andrewrichardr/WFR2020/ESF/Figs/lvconductor.jpg

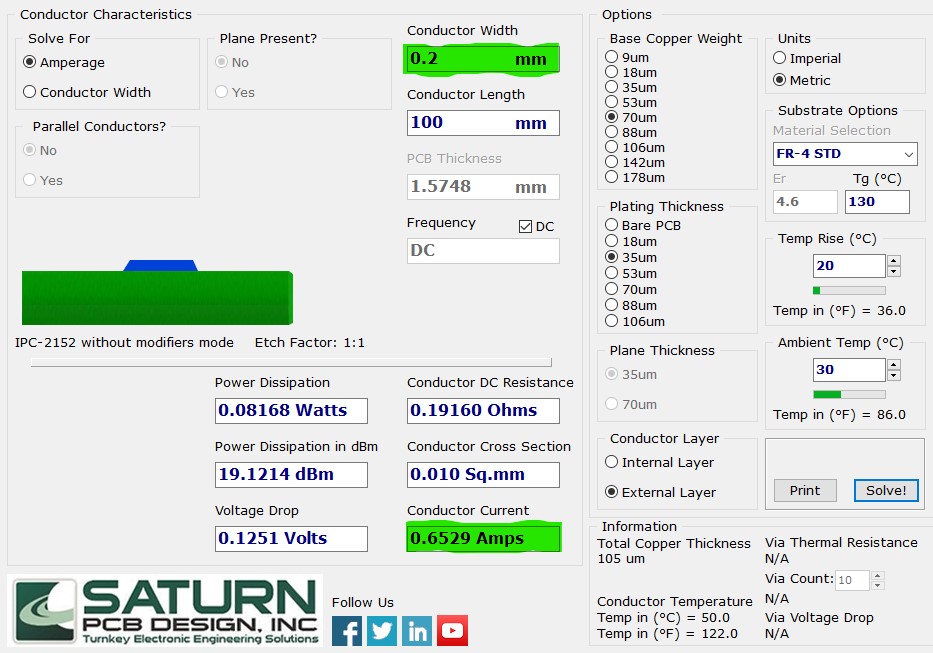
ESF/Figs/lvconductor.jpg
