andrewrichardr/WFR2020/ESF/Figs/spacingreqs.jpg

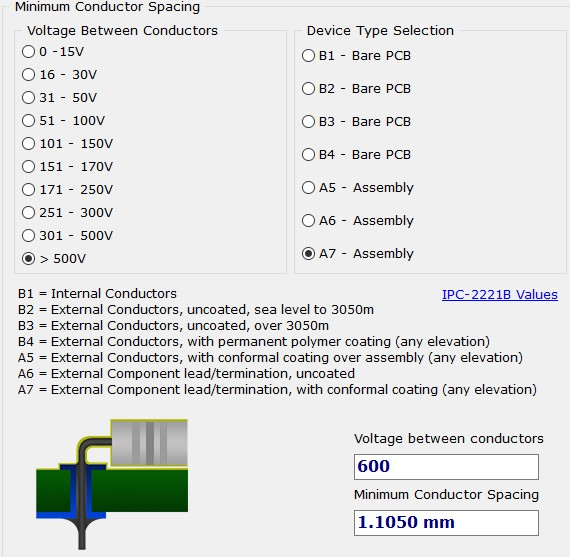
ESF/Figs/spacingreqs.jpg
