andrewrichardr/WFR2020/2019/ESF_Comments.docx

ESF Comments

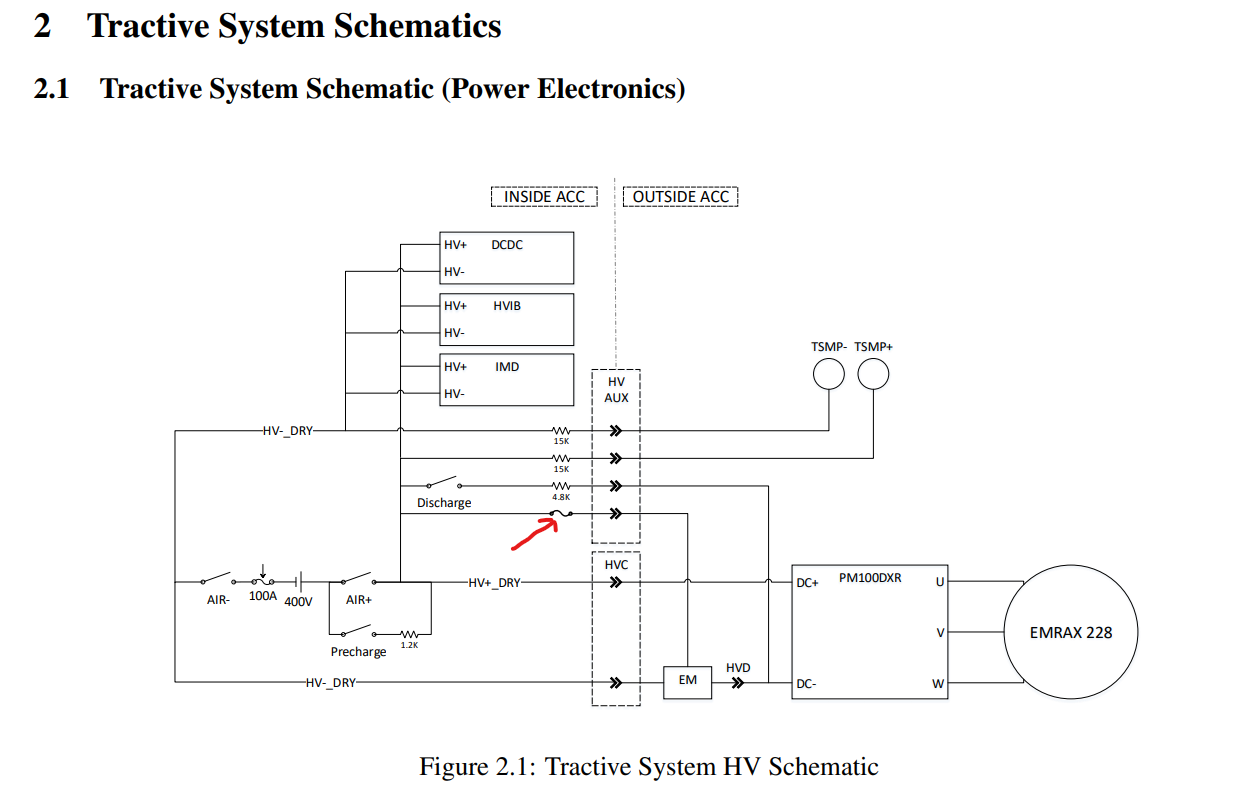
[picture p3: figure]

No rating on this fuse

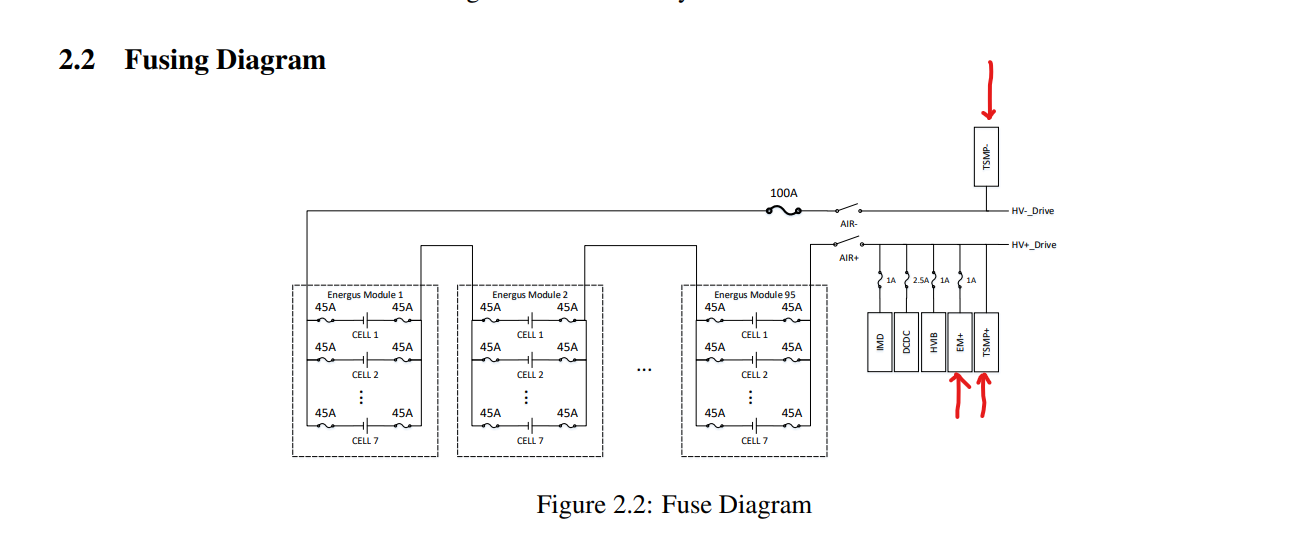
[picture p4: figure]

These are outside of the accumulator, not inside. Would be good to distinguish.

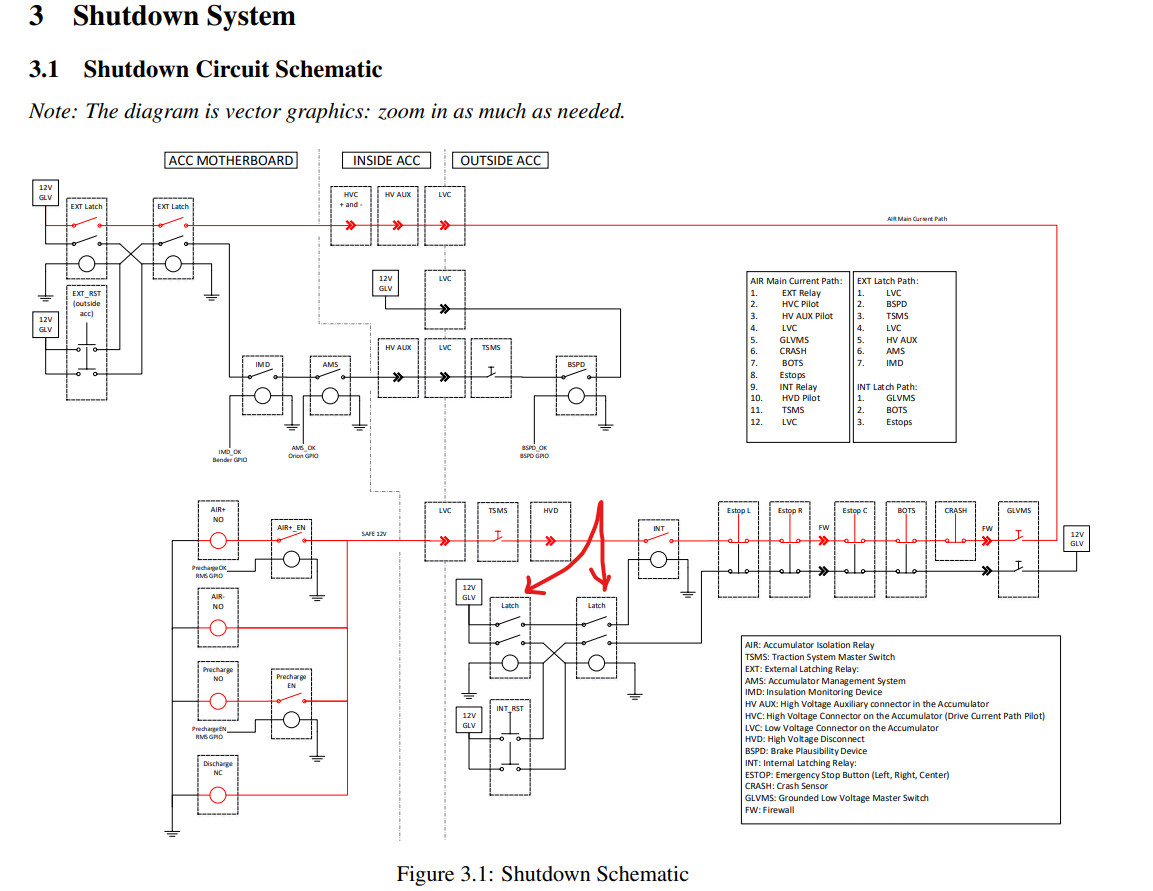
[picture p5: figure]

Maybe call this INT latch instead of just latch

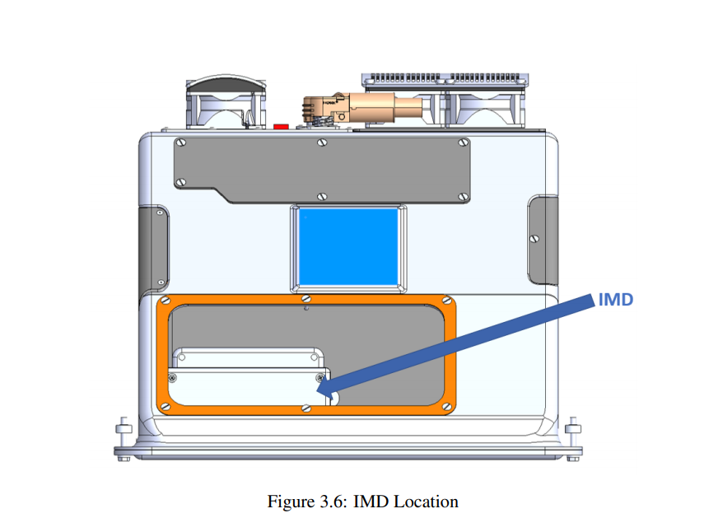
[picture p6: figure]

I thought the IMD was on the motherboard now?
