andrewrichardr/WFR2020/ACC-MB/APPS.pdf

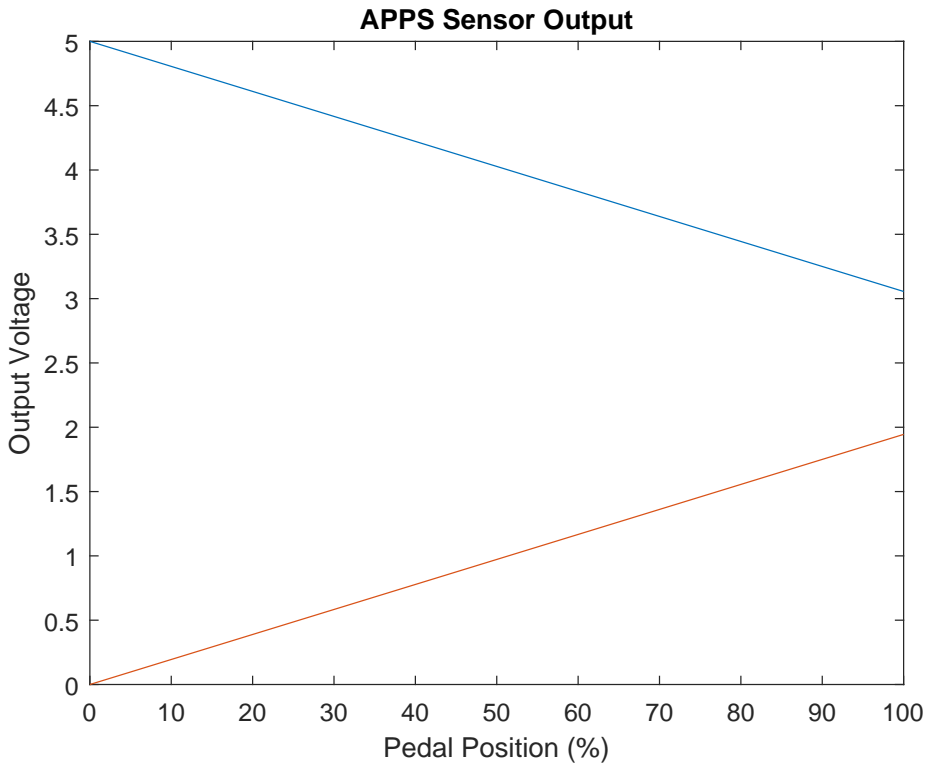
[picture p7: figure]
Pedal Position (%); Output Voltage; APPS Sensor Output
