andrewrichardr/WFR2020/ACC-MB/SystemBlockDiagram.pdf

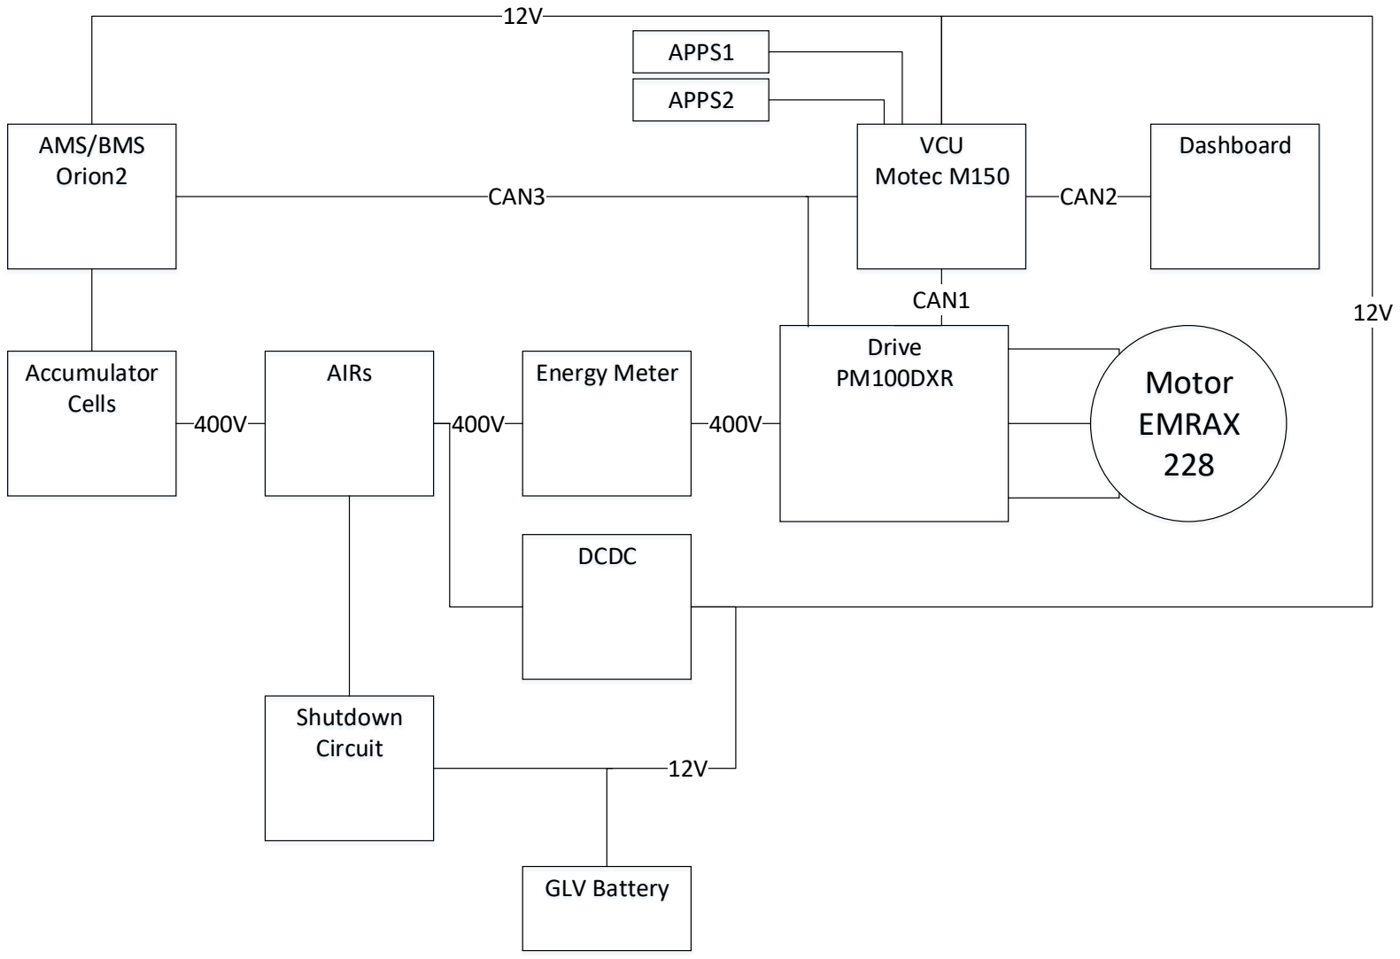
[picture p8: page 1]

Drive
PM100DXR | Motor

## EMRAX

228

Energy Meter

400V

AIRs

400V

Accumulator
Cells
400V

DCDC

Shutdown
Circuit

GLV Battery

12V

AMS/BMS
Orion2

VCU
Motec M150

CAN1

CAN3

12V

12V

Dashboard

CAN2

APPS1

APPS2
