andrewrichardr/WFR2020/ACC-MB/TorqueSecurity.pdf

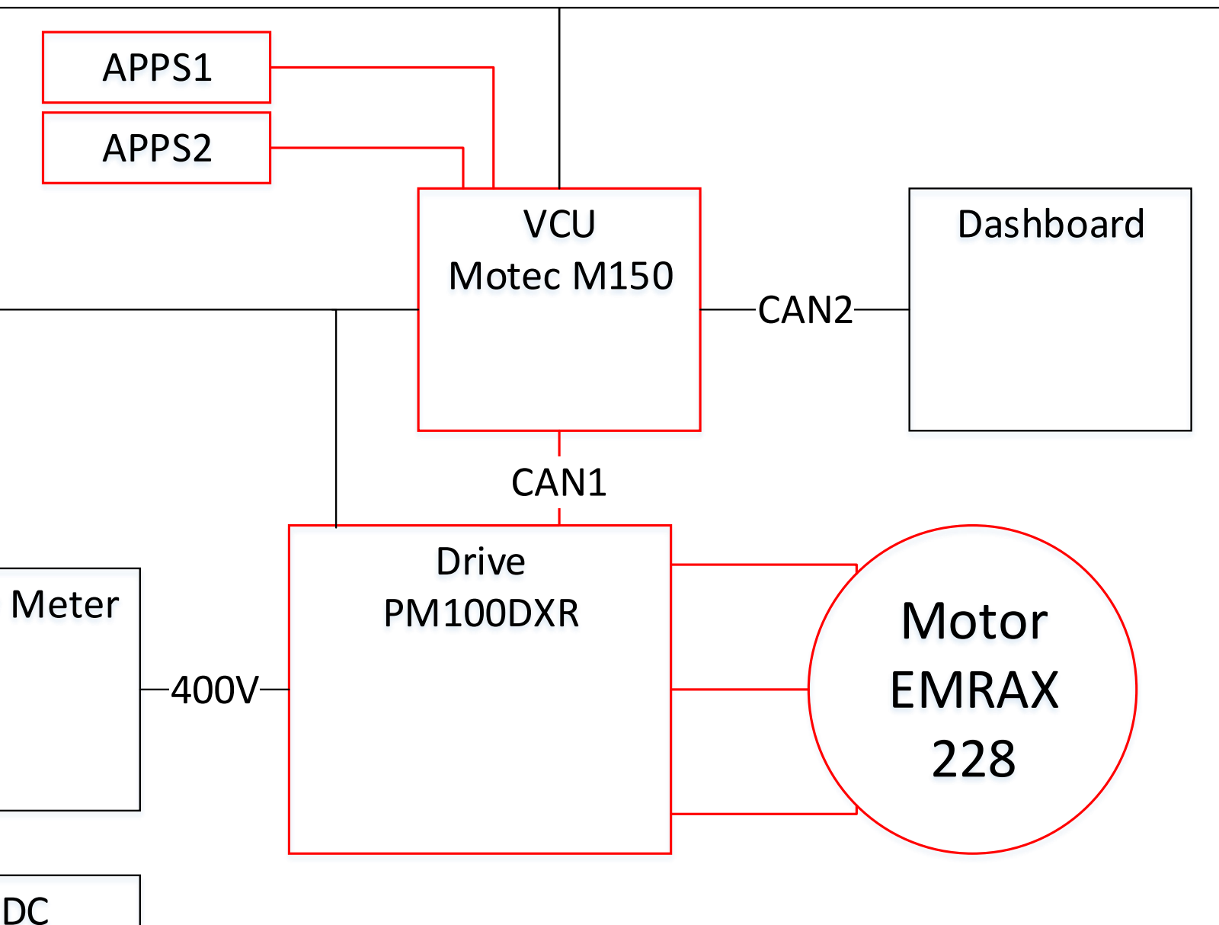
[picture p9: page 1]

Drive
PM100DXR | Motor

## EMRAX

228

Energy Meter

400V

DCDC

VCU
Motec M150

CAN1

Dashboard

CAN2

APPS1

APPS2
