andrewrichardr/WFR2020/ACC-MB/hvconductor.pdf

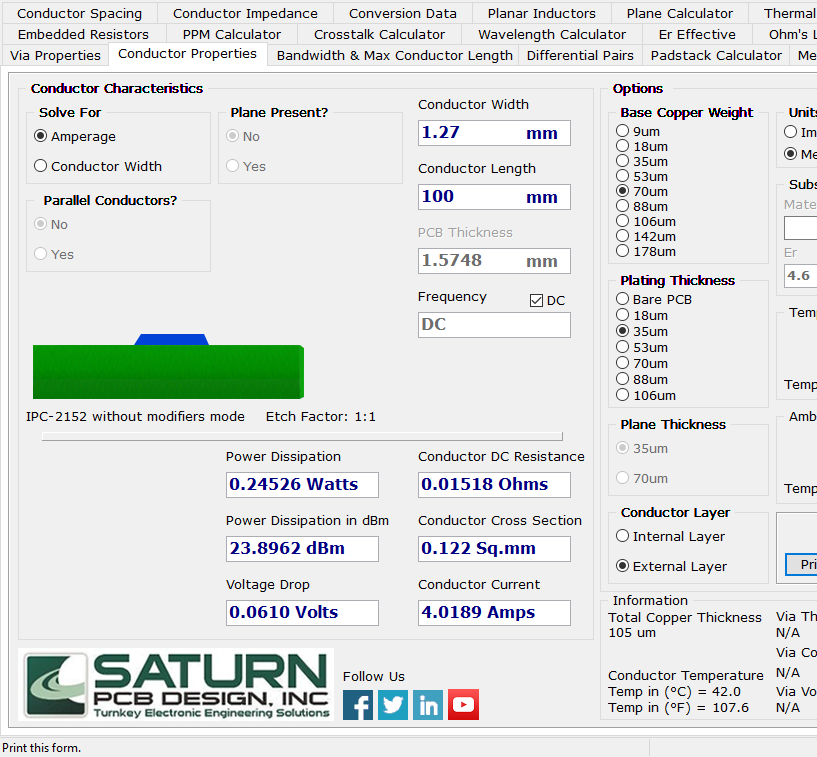
[picture p10: page 1]
