andrewrichardr/WFR2020/ACC-MB/APPS.png

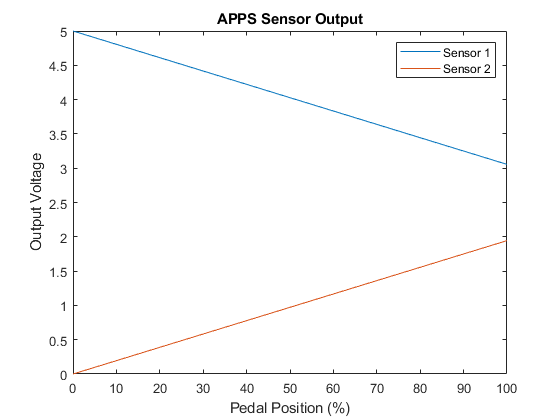
ACC-MB/APPS.png
