andrewrichardr/WFR2020/ACC-MB/Rev4/MainBoard/Main_2019-12-13_Combined_Bottom.png

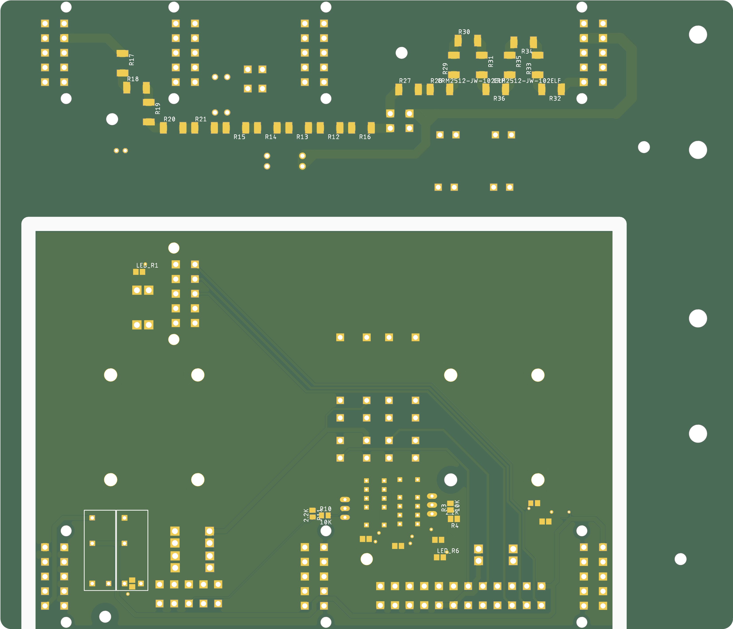
ACC-MB/Rev4/MainBoard/Main_2019-12-13_Combined_Bottom.png
