andrewrichardr/WFR2020/allPCBsettings.jpg

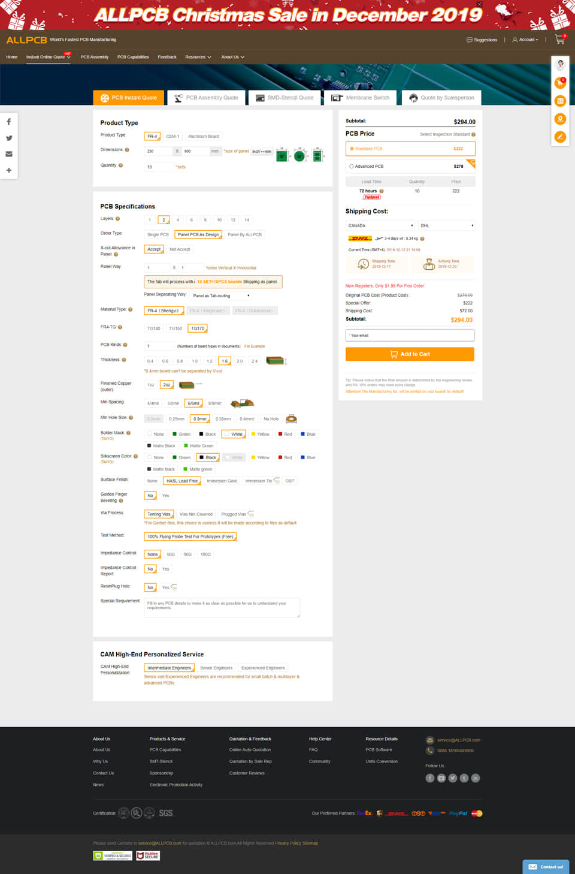
allPCBsettings.jpg
