andrewrichardr/WFR2020/ESF/Figs/accumcad.jpg

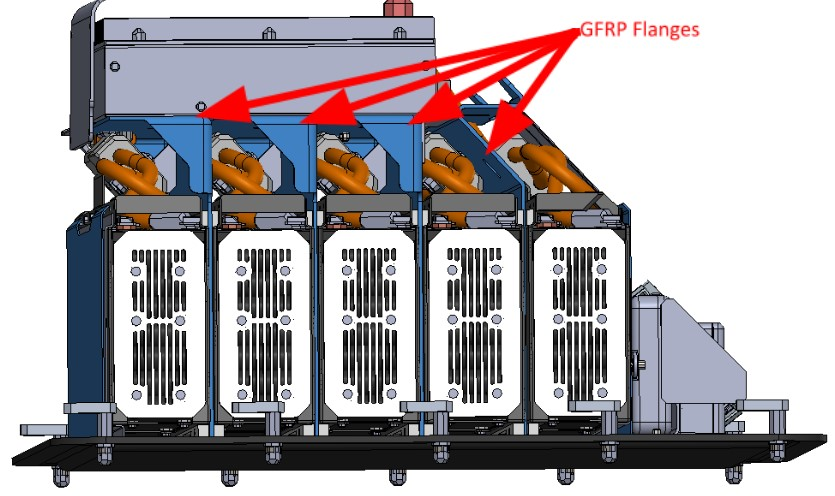
ESF/Figs/accumcad.jpg
