andrewrichardr/WFR2020/ESF/Figs/Annotation 2019-12-02 203314.jpg

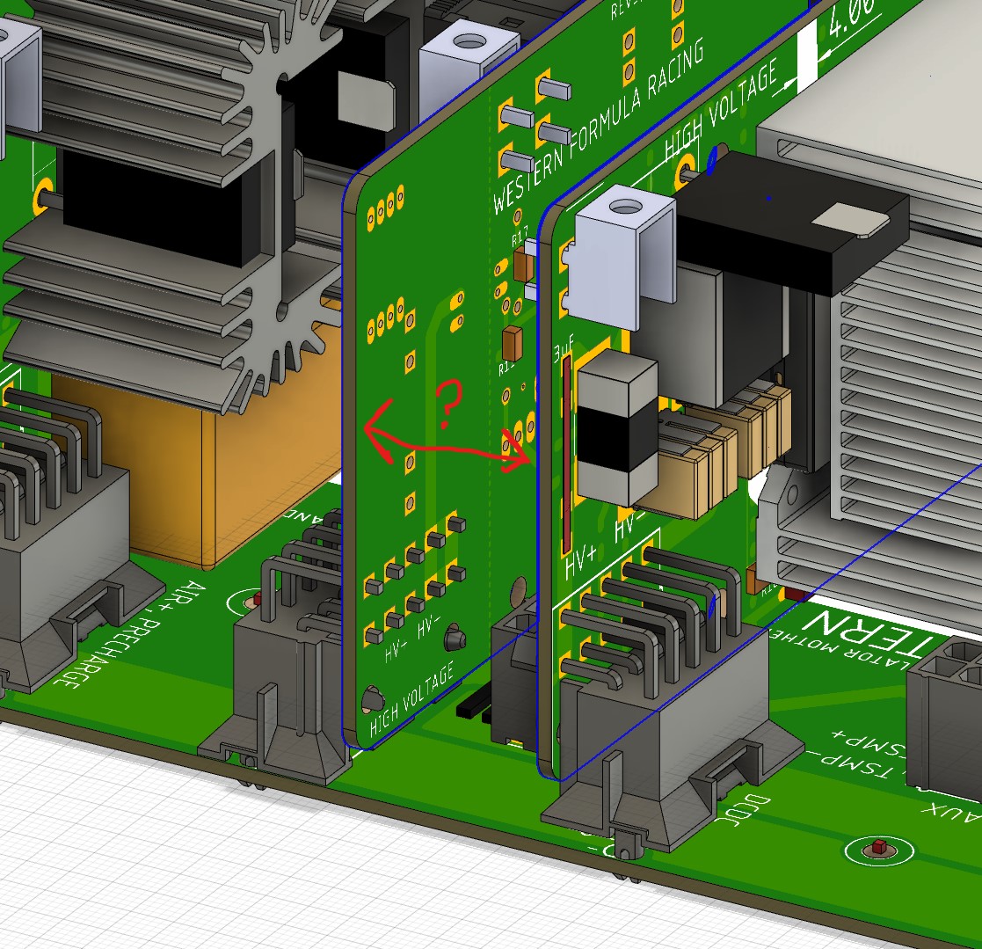
ESF/Figs/Annotation 2019-12-02 203314.jpg
