andrewrichardr/WFR2020/ESF/Figs/appsoutput.jpg

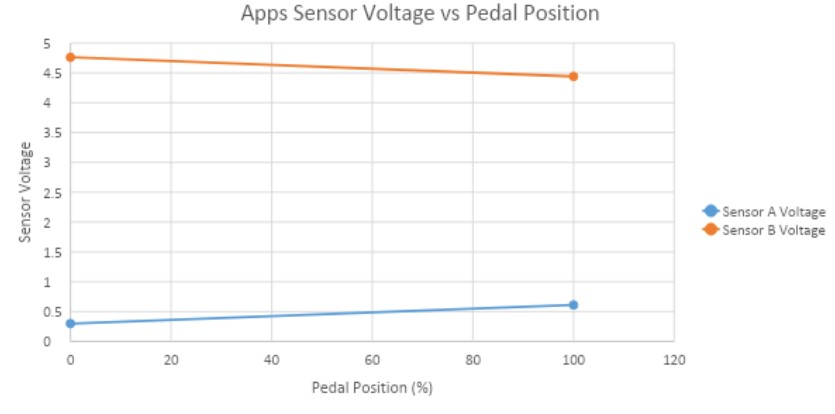
ESF/Figs/appsoutput.jpg
