andrewrichardr/WFR2020/ESF/Figs/blowtimevscurrent.jpg

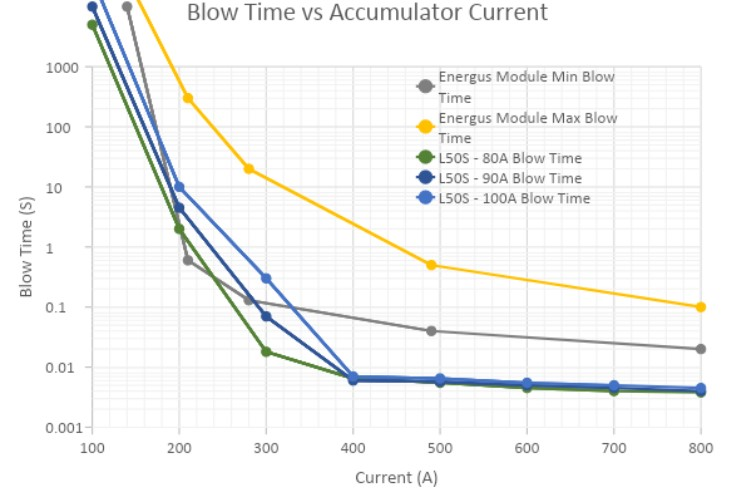
ESF/Figs/blowtimevscurrent.jpg
