andrewrichardr/WFR2020/ESF/Figs/cellconnections.jpg

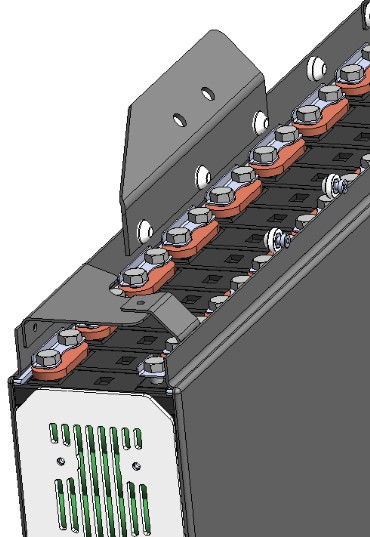
ESF/Figs/cellconnections.jpg
