andrewrichardr/WFR2020/ESF/Figs/cellmounting.jpg

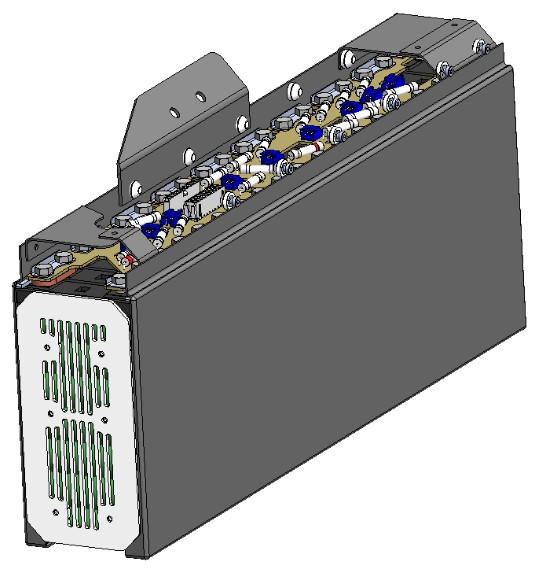
ESF/Figs/cellmounting.jpg
