andrewrichardr/WFR2020/ESF/Figs/dischargecap.jpg

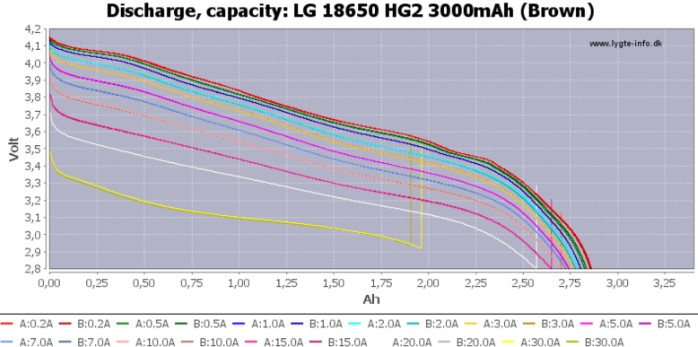
ESF/Figs/dischargecap.jpg
