andrewrichardr/WFR2020/ESF/Figs/DischargeI.jpg

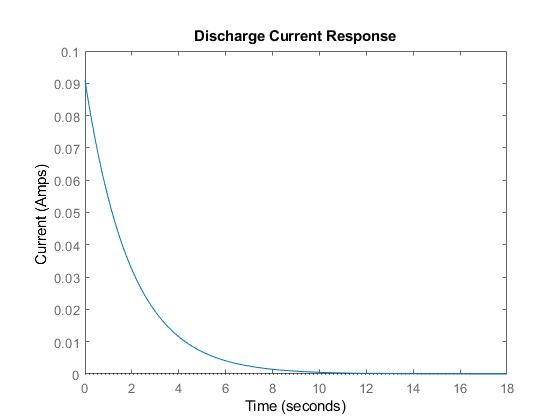
ESF/Figs/DischargeI.jpg
