andrewrichardr/WFR2020/ESF/Figs/EnergusFuse.jpg

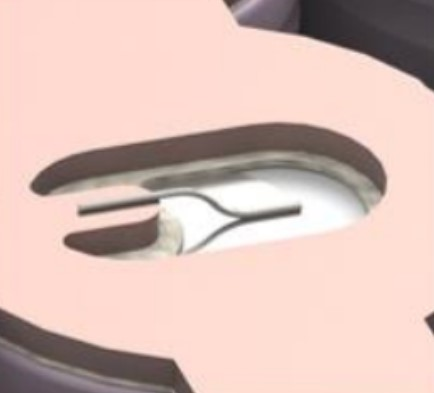
ESF/Figs/EnergusFuse.jpg
