andrewrichardr/WFR2020/ESF/Figs/firewall.jpg

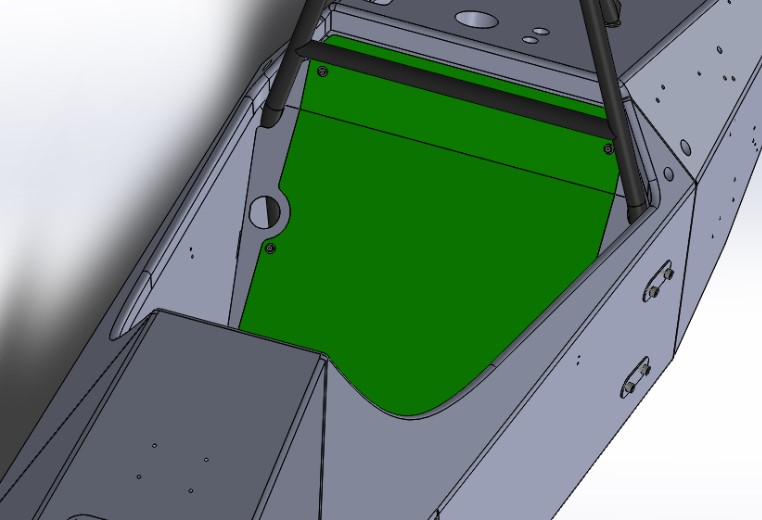
ESF/Figs/firewall.jpg
