andrewrichardr/WFR2020/ESF/Figs/fuseblowtime.jpg

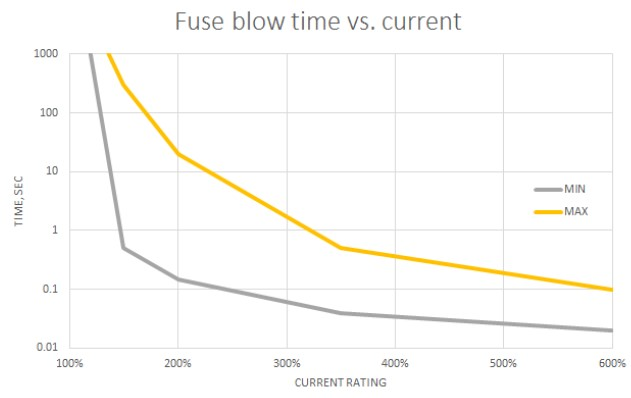
ESF/Figs/fuseblowtime.jpg
