andrewrichardr/WFR2020/ESF/Figs/FuseTreeDaigram.png

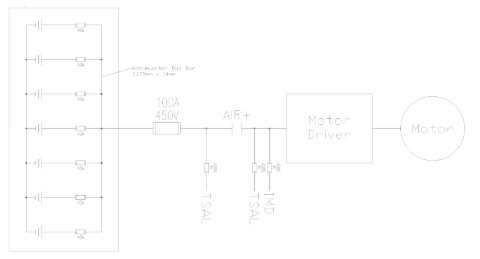
ESF/Figs/FuseTreeDaigram.png
