andrewrichardr/WFR2020/ESF/Figs/HVSystemSchematic.png

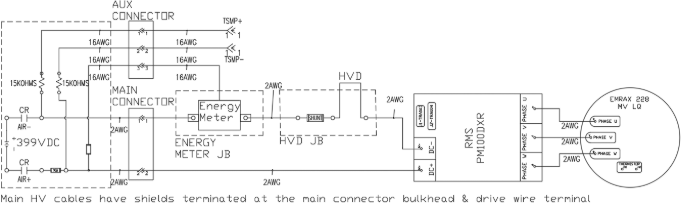
ESF/Figs/HVSystemSchematic.png
