andrewrichardr/WFR2020/ESF/Figs/imdlocation.jpg

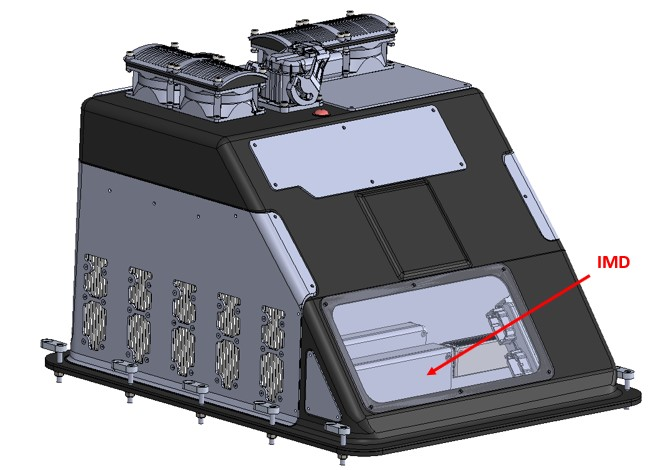
ESF/Figs/imdlocation.jpg
