andrewrichardr/WFR2020/ESF/Figs/LatchSchematic.png

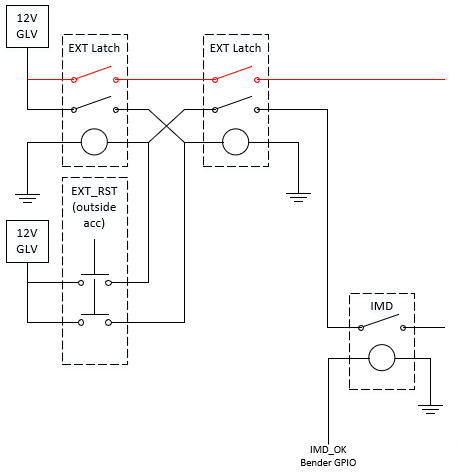
ESF/Figs/LatchSchematic.png
