andrewrichardr/WFR2020/ESF/Figs/mobo.PNG

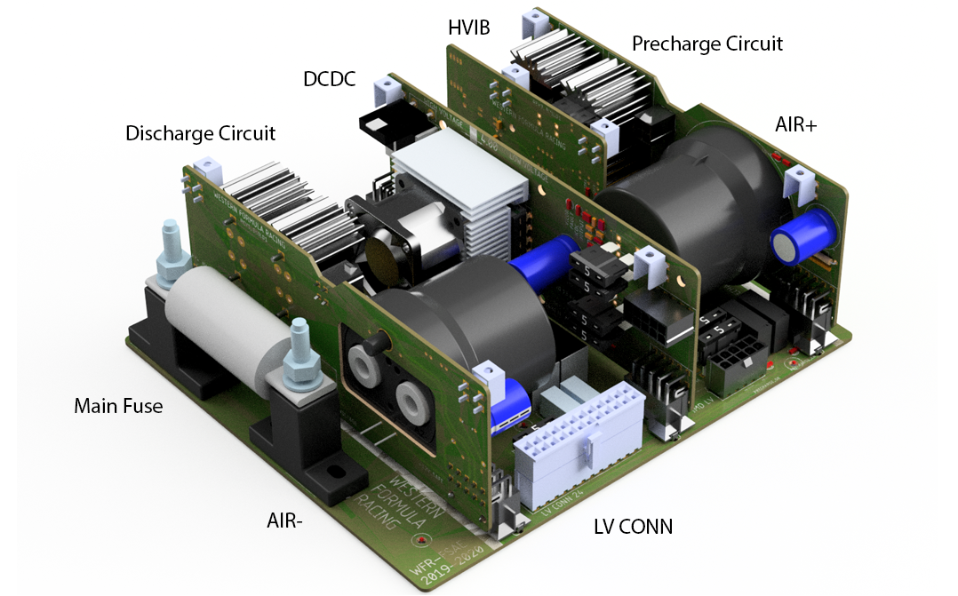
ESF/Figs/mobo.PNG
