andrewrichardr/WFR2020/ESF/Figs/mp.jpg

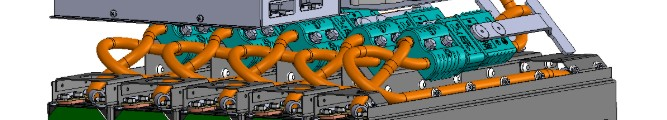
ESF/Figs/mp.jpg
