andrewrichardr/WFR2020/ESF/Figs/mpcad.jpg

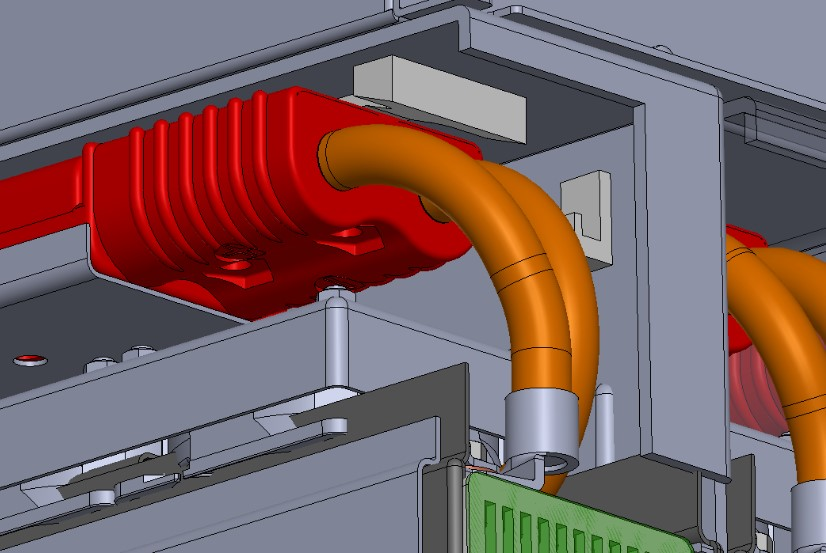
ESF/Figs/mpcad.jpg
