andrewrichardr/WFR2020/ESF/Figs/PrechargeV.jpg

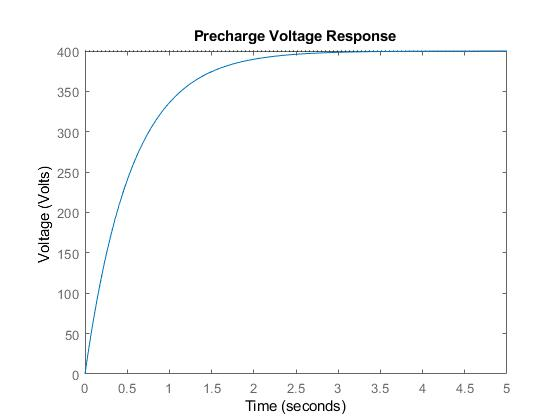
ESF/Figs/PrechargeV.jpg
