andrewrichardr/WFR2020/ESF/Figs/SAE.jpg

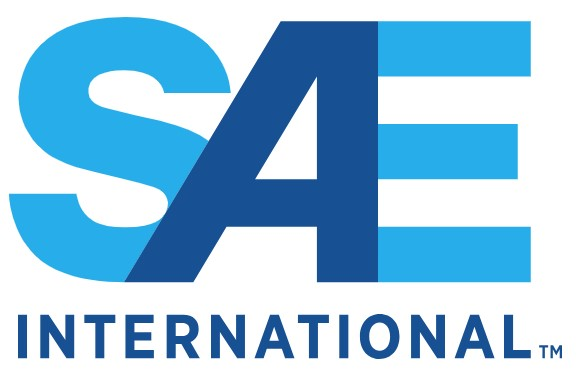
ESF/Figs/SAE.jpg
