andrewrichardr/WFR2020/ESF/Figs/senseleads.jpg

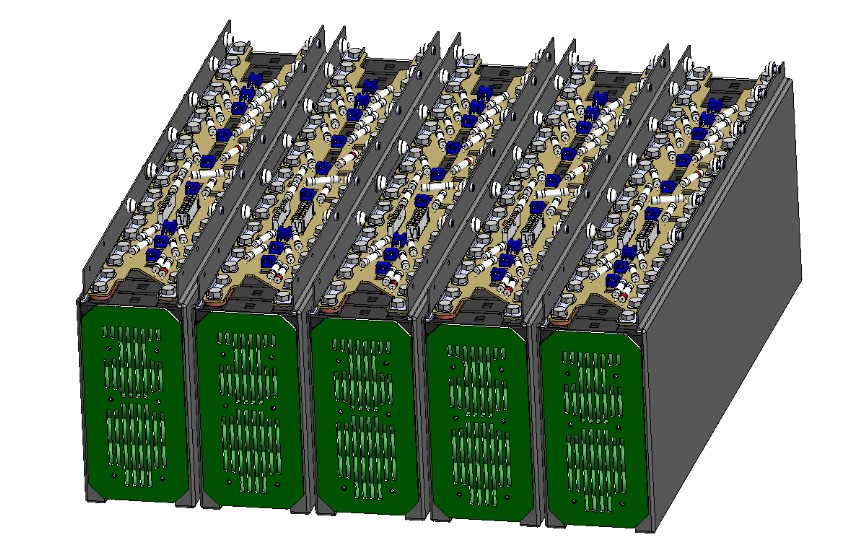
ESF/Figs/senseleads.jpg
