andrewrichardr/WFR2020/ESF/Figs/SwitchLocations.png

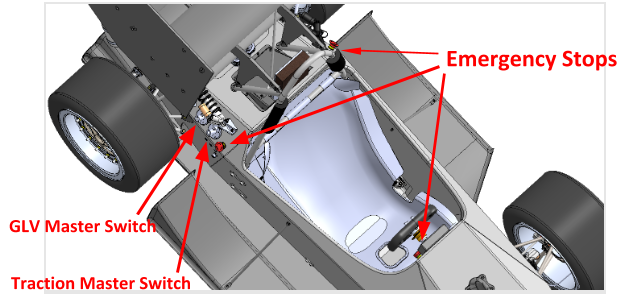
ESF/Figs/SwitchLocations.png
