andrewrichardr/WFR2020/ESF/Figs/SystemBlockDiagram.png

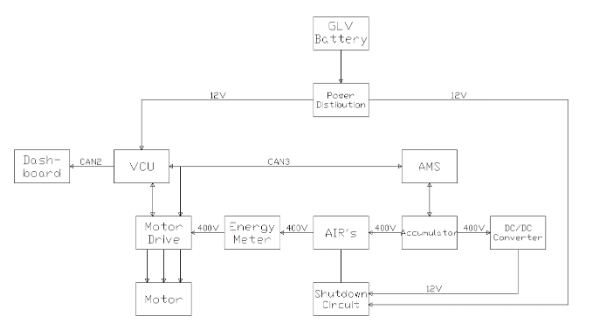
ESF/Figs/SystemBlockDiagram.png
