andrewrichardr/WFR2020/ESF/Figs/tempsensoroutput.jpg

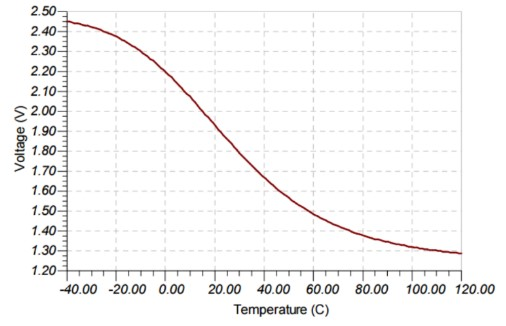
ESF/Figs/tempsensoroutput.jpg
