andrewrichardr/WFR2020/ESF/Figs/tempsensors.jpg

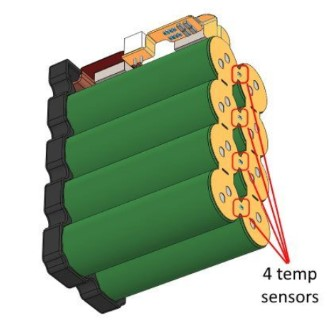
ESF/Figs/tempsensors.jpg
