andrewrichardr/WFR2020/ESF/Figs/tempsensorsch.jpg

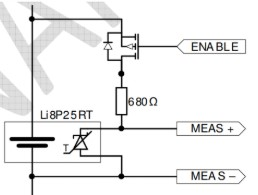
ESF/Figs/tempsensorsch.jpg
