andrewrichardr/WFR2020/ESF/Figs/TSMP.jpg

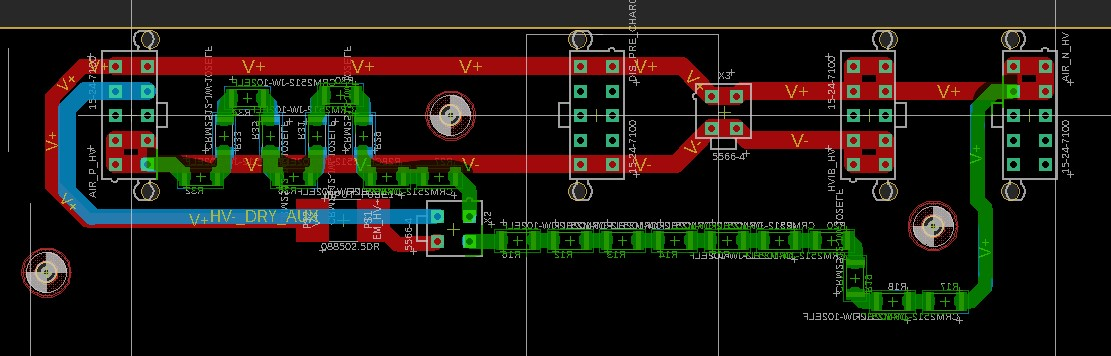
ESF/Figs/TSMP.jpg
