andrewrichardr/WFR2020/ESF/Figs/tsmploc.jpg

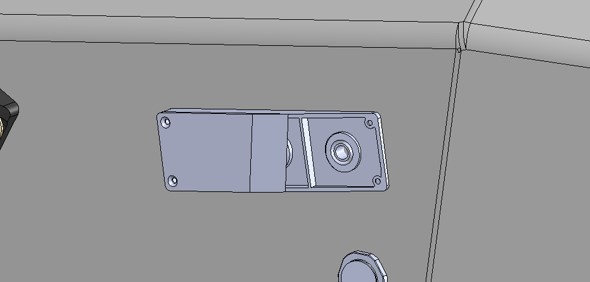
ESF/Figs/tsmploc.jpg
