andrewrichardr/WFR2020/ESF/Figs/untitled.147.png

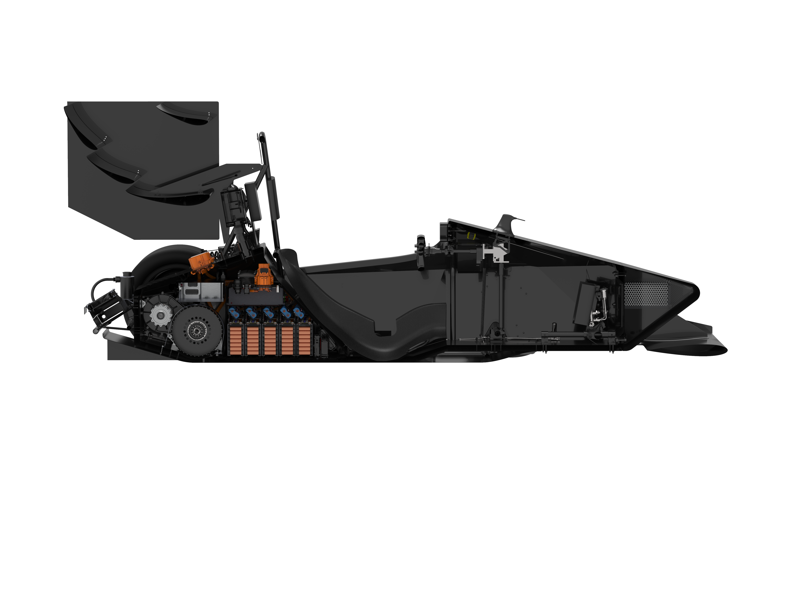
ESF/Figs/untitled.147.png
