andrewrichardr/WFR2020/ESF/Figs/voltagetaps.jpg

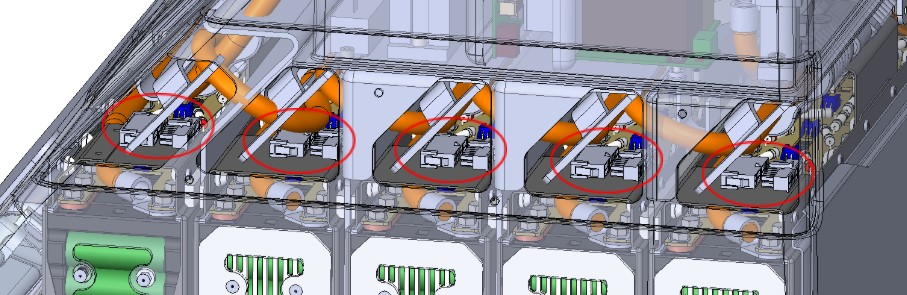
ESF/Figs/voltagetaps.jpg
