andrewrichardr/WFR2020/ESF/Figs/wideFOVfront2.jpg

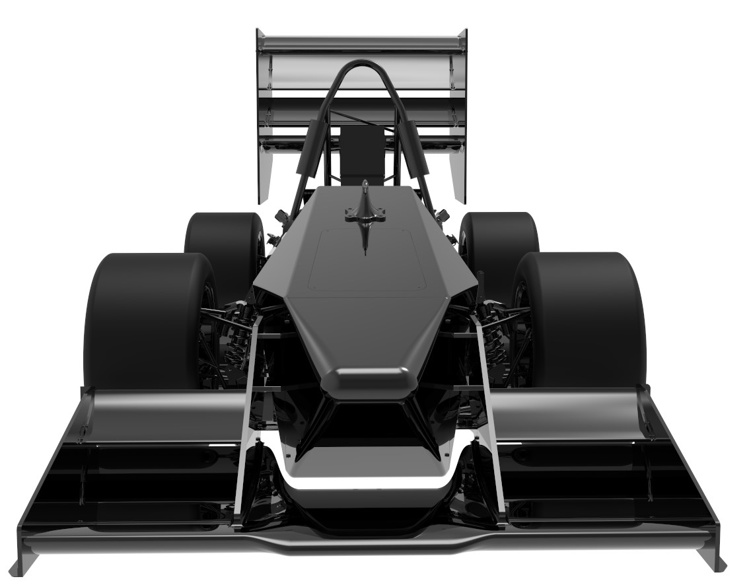
ESF/Figs/wideFOVfront2.jpg
