andrewrichardr/WFR2020/GerberTools_2019_9_20/QuickRender/00 Outlines before carve.png

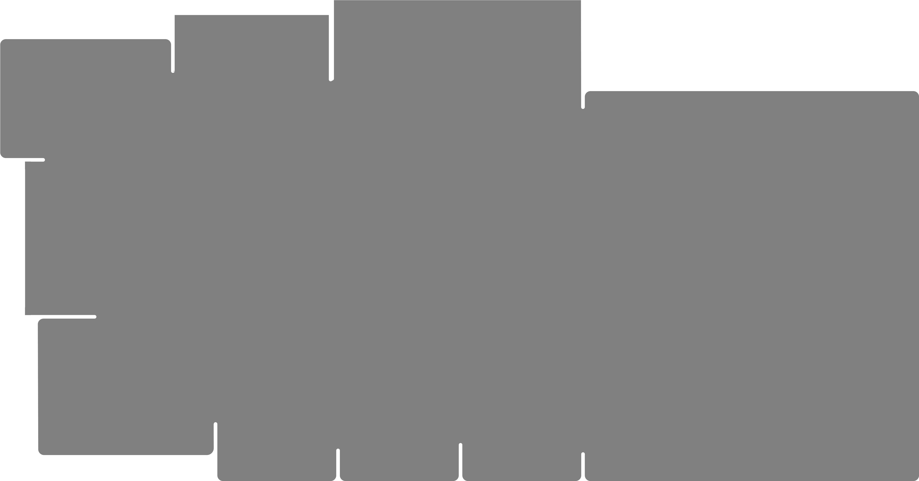
GerberTools_2019_9_20/QuickRender/00 Outlines before carve.png
