andrewrichardr/WFR2020/GerberTools_2019_9_20/QuickRender/11 outlines_redimages.png

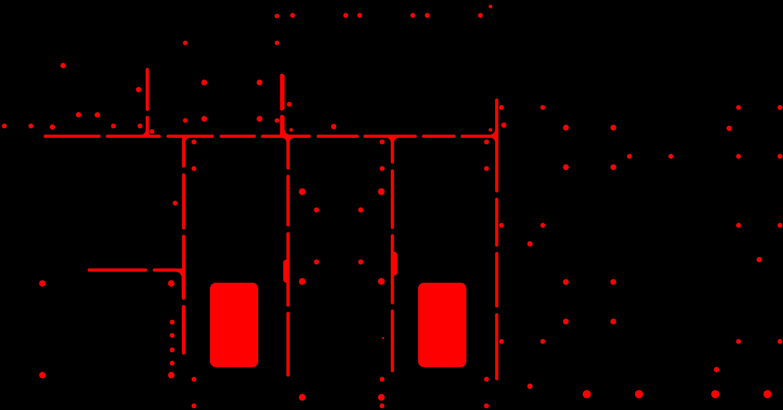
GerberTools_2019_9_20/QuickRender/11 outlines_redimages.png
