andrewrichardr/WFR2020/GerberTools_2019_9_20/QuickRender/22 outlines_carved.png

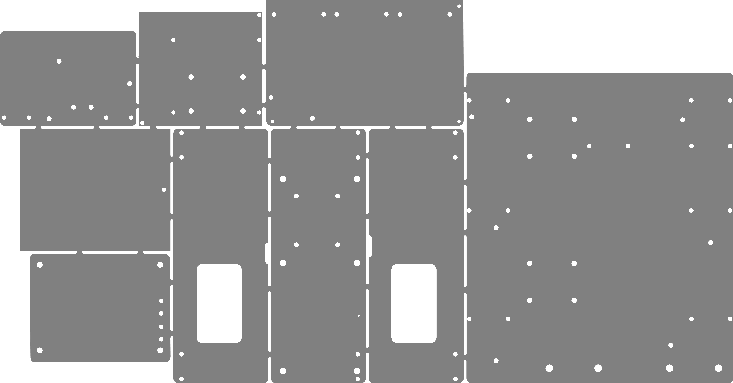
GerberTools_2019_9_20/QuickRender/22 outlines_carved.png
