andrewrichardr/WFR2020/GerberTools_2019_9_20/QuickRender/44 outlines_4afterinside.png

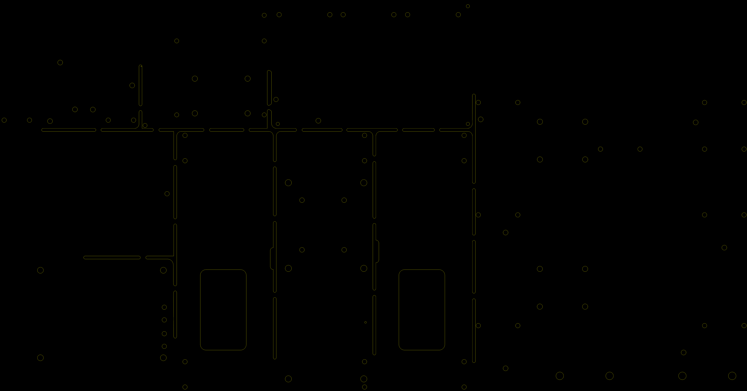
GerberTools_2019_9_20/QuickRender/44 outlines_4afterinside.png
