andrewrichardr/WFR2020/GerberTools_2019_9_20/QuickRender/Bottom_drill.png

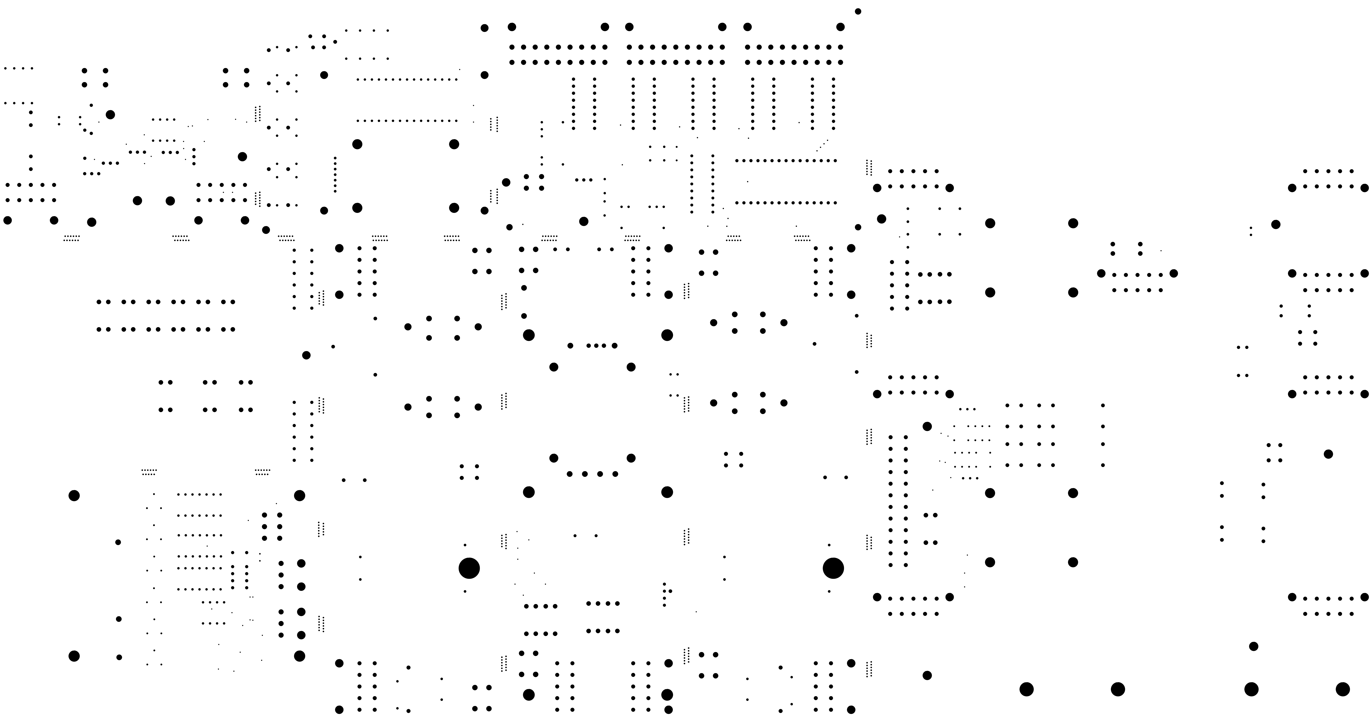
GerberTools_2019_9_20/QuickRender/Bottom_drill.png
