andrewrichardr/WFR2020/GerberTools_2019_9_20/QuickRender/FinalAfterCopper.png

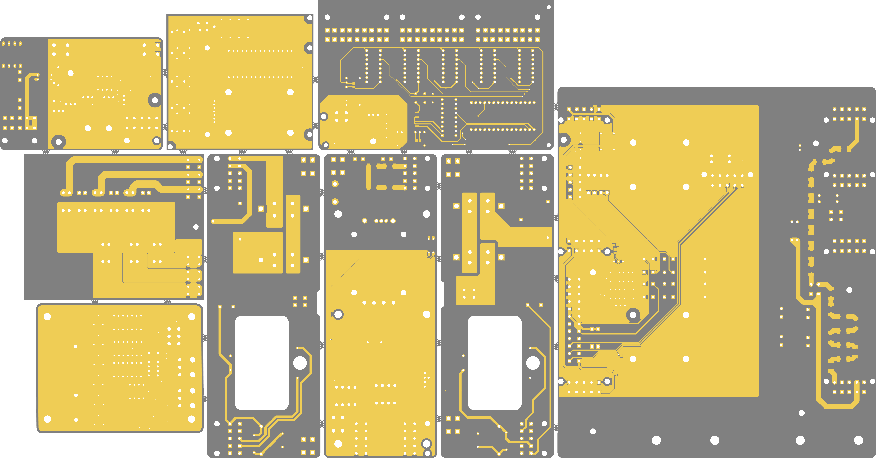
GerberTools_2019_9_20/QuickRender/FinalAfterCopper.png
