andrewrichardr/WFR2020/GerberTools_2019_9_20/QuickRender/Top_base.png

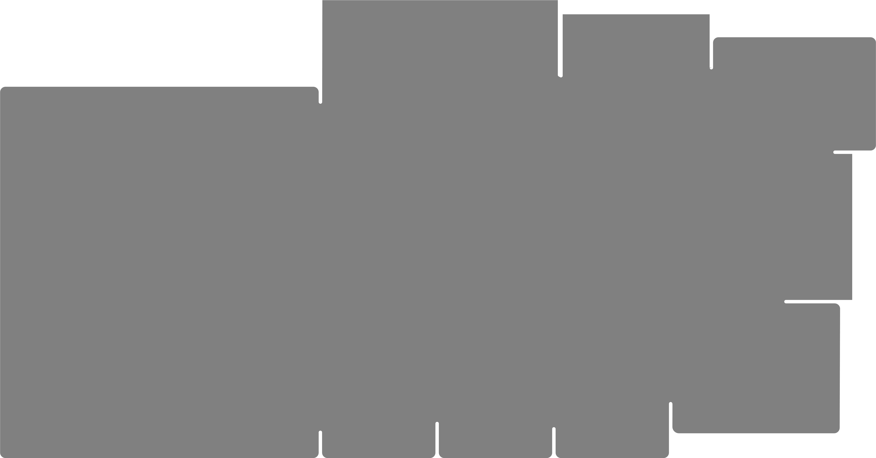
GerberTools_2019_9_20/QuickRender/Top_base.png
