andrewrichardr/WFR2020/PanelA/Panel1_Combined_Bottom.png

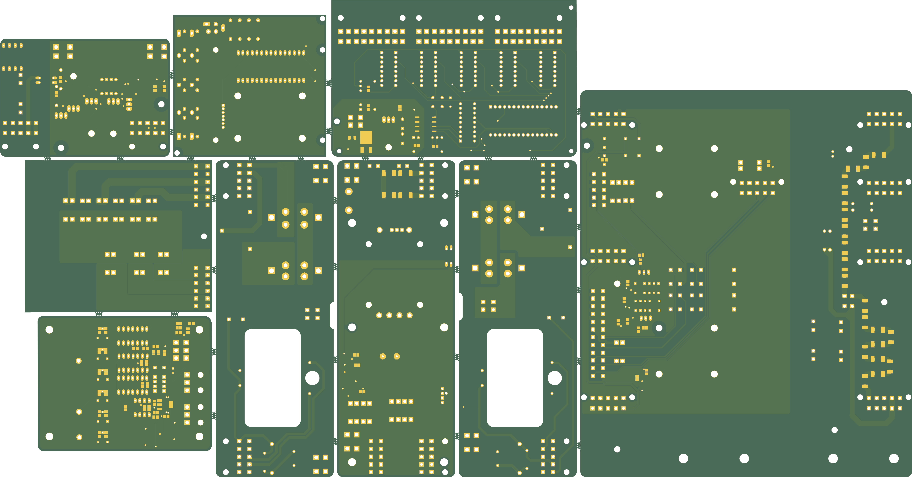
PanelA/Panel1_Combined_Bottom.png
