andrewrichardr/WFR2020/PanelA/Panel1_Combined_Top.png

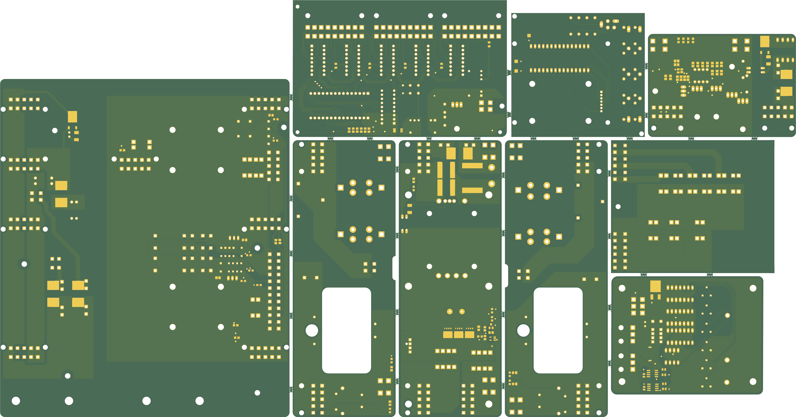
PanelA/Panel1_Combined_Top.png
