andrewrichardr/WFR2020/PanelB/Untitled_Combined_Bottom.png

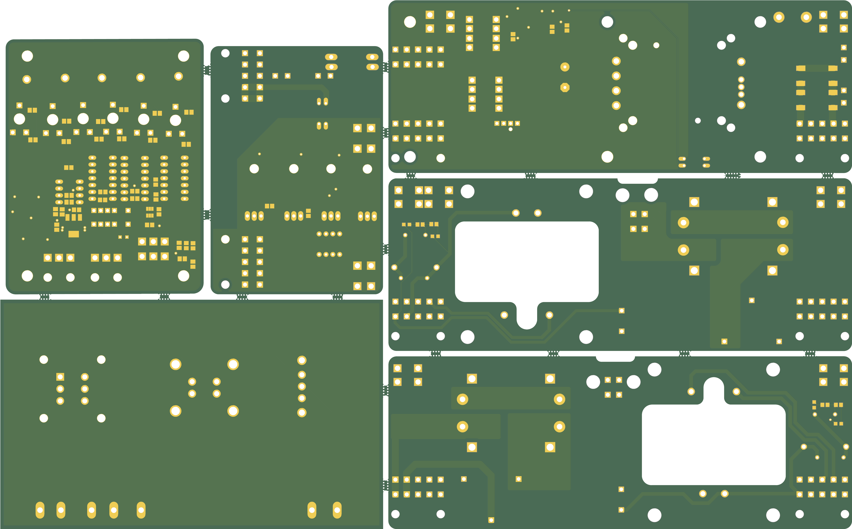
PanelB/Untitled_Combined_Bottom.png
