andrewrichardr/WFR2020/PanelB/Untitled_Combined_Top.png

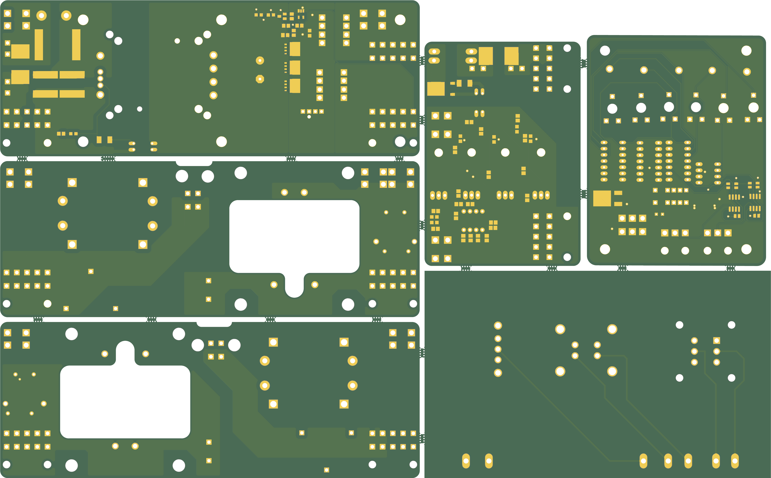
PanelB/Untitled_Combined_Top.png
