andrewrichardr/WFR2020/WFR2020-Panel1/PanelA.png_Combined_Top.png

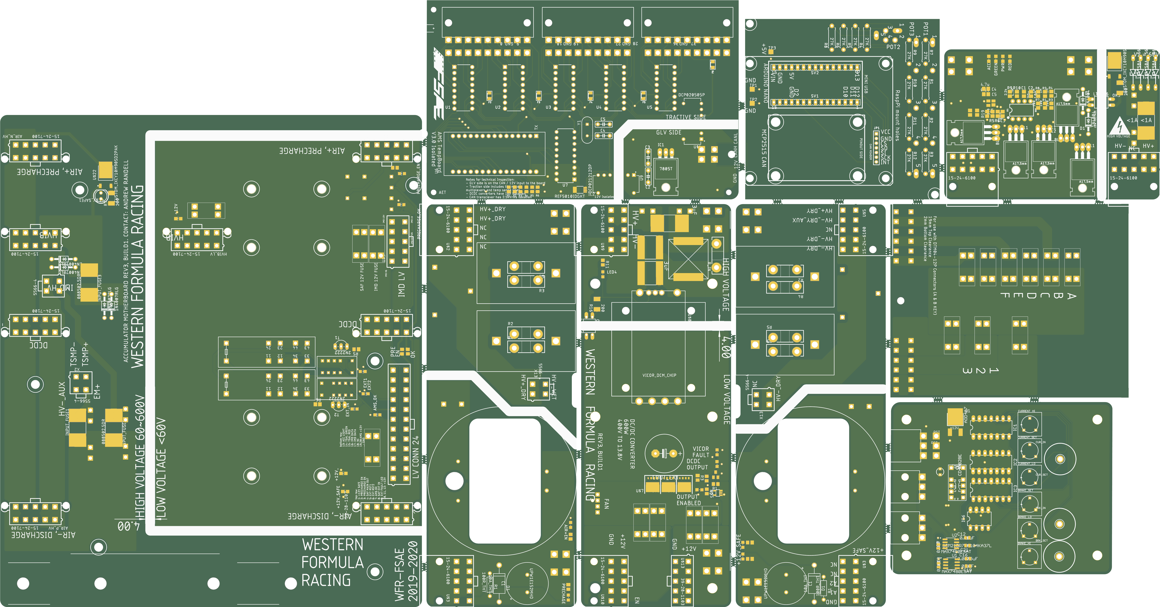
WFR2020-Panel1/PanelA.png_Combined_Top.png
