andrewrichardr/WFR2020/ACC-MB/Rev4/BOM.xlsx

DCDCDC
 | MPN | Manufacturer | Part | Value | Device | Package | Description | MF | MPN | OC_FARNELL | OC_NEWARK | POPULARITY | SPICEPREFIX
 | B58035U5305M062 | EPCOS | CFILTER_1 | 3uF | B58035U5305M062 | CERALINK_FA3
 | B58035U5305M062 | EPCOS | CFILTER_2 | 3uF | B58035U5305M062 | CERALINK_FA3
 | EGPD250ELL472ML25H | United Chemi-con | COUT_EXT | EGPD250ELL472ML25H | CPOL-USE7.5-16 | E7,5-16 | POLARIZED CAPACITOR, American symbol
 | 088502.5DR | Littlefuse | INPUT_FUSE | 2.5A | _CUSTOM_PARTS_LF_885 | _CUSTOM_PARTS_LF_885
 | 088502.5DR | Littlefuse | INPUT_FUSE1 | 2.5A | _CUSTOM_PARTS_LF_885 | _CUSTOM_PARTS_LF_885
 |  |  | LED1 |  | LED3MM | LED3MM | LED
 |  |  | LED2 |  | LED3MM | LED3MM | LED
 |  |  | LED3 |  | LED3MM | LED3MM | LED
 | LTV816 | Lite-On Inc. | OK3 | LTV816 | LTV816 | DIL04 | OPTO COUPLER |  |  | unknown | unknown | 3
 | SRP1770TA-390M | Bourns | P1330-102H | 39uH | SRP1770TA-390M | L_1510_NONSTANDARD
 |  |  | R1 |  | R-EU_R0805 | R0805 | RESISTOR, European symbol |  |  |  |  |  | R
 |  |  | R2 |  | R-US_R0805 | R0805 | RESISTOR, American symbol |  |  |  |  |  | R
 |  |  | R3 |  | R-US_R0805 | R0805 | RESISTOR, American symbol |  |  |  |  |  | R
 |  |  | R4 |  | R-US_R0805 | R0805 | RESISTOR, American symbol |  |  |  |  |  | R
 |  |  | R5 |  | R-US_R0805 | R0805 | RESISTOR, American symbol |  |  |  |  |  | R
 |  |  | R6 |  | R-US_R0805 | R0805 | RESISTOR, American symbol |  |  |  |  |  | R
 |  |  | R8 |  | R-US_R0805 | R0805 | RESISTOR, American symbol |  |  |  |  |  | R
 |  |  | R16 | 200 | R-US_R2010 | R2010 | RESISTOR, American symbol |  |  |  |  |  | R
 | PF2472-1RF1 | Riedon | R_IN | PF2472-1RF1 | RMG100-V | TO-247-2V | TO-247 Power Resistor - RMG 100 Series |  |  | unknown | unknown
 | 3568 | Keystone Electronics | U$1 | 3568FUSEHOLDER | 3568FUSEHOLDER | 3568 | 3568 20AMP 500VAC
 | 3568 | Keystone Electronics | U$2 | 3568FUSEHOLDER | 3568FUSEHOLDER | 3568 | 3568 20AMP 500VAC
 | SQJ407EP-T1_GE3 | Vishay | U$3 | _CUSTOM_111_CUSTOM_SQJ407EP-T1_GE3 | _CUSTOM_111_CUSTOM_SQJ407EP-T1_GE3 | _CUSTOM_111_CUSTOM_TRANS_SIRA90DP-T1-GE3
 | RK7002BMT116 | RHOM | U$4 | RK7002BMT116 | RK7002BMT116 | SOT23
 | UCC27511AQDBVRQ1 | Texas Instruments | U$5 | UCC27511AQDBVRQ1 | UCC27511AQDBVRQ1 | SOT23-5L
 | SQJ407EP-T1_GE3 | Vishay | U$6 | _CUSTOM_111_CUSTOM_SQJ407EP-T1_GE3 | _CUSTOM_111_CUSTOM_SQJ407EP-T1_GE3 | _CUSTOM_111_CUSTOM_TRANS_SIRA90DP-T1-GE3
 | SQJ407EP-T1_GE3 | Vishay | U$7 | _CUSTOM_111_CUSTOM_SQJ407EP-T1_GE3 | _CUSTOM_111_CUSTOM_SQJ407EP-T1_GE3 | _CUSTOM_111_CUSTOM_TRANS_SIRA90DP-T1-GE3
 | DCM290P138T600A40 | Vicor | U$8 | VICOR_DCM_CHIP | VICOR_DCM_CHIP | VICOR_CHIP_HEATSINK
 | 15-24-6100 | Molex | U$9 | 15-24-6100 | 15-24-6100 | 15-24-6100
 | 15-24-6100 | Molex | U$10 | 15-24-6100 | 15-24-6100 | 15-24-6100
 | BENDER_IRR155 | Bender | U$11 | BENDER_IRR155 | BENDER_IRR155 | BENDER_IRR155
 | FVTS10R1E15K00JE | Vishay Huntington | U$12 | FVTS10 | FVTS10 | FVTS10
 | 39-28-1103 | Molex | U$13 | 39-28-1103 | 39-28-1103 | 39-28-1103
 | FVTS10R1E15K00JE | Vishay Huntington | U$14 | FVTS10 | FVTS10 | FVTS10
 | 3568 | Keystone Electronics | U$15 | 3568FUSEHOLDER | 3568FUSEHOLDER | 3568 | 3568 20AMP 500VAC
 | 3568 | Keystone Electronics | U$16 | 3568FUSEHOLDER | 3568FUSEHOLDER | 3568 | 3568 20AMP 500VAC
 | 40531 | Vicor | U$17 | VICOR_HEATSINK_19MM_TRANSVERSE | VICOR_HEATSINK_19MM_TRANSVERSE | VICOR_HEATSINK_19MM_TRANSVERSE
Accumulator Connectors
HV- Plug | SLPPB50BSO1 | 90 deg
HV+ Plug | SLPPB50BSO0 | 180 deg
HV- receptical | SLPIRBBPSO0 | 90 deg
HV+ receptial | SLPIRBBPSO1 | 180 deg
