andrewrichardr/WFR2020/ACC-MB/Tables.xlsx

 |  |  |  |  |  |  |  | Conductor | Size | Voltage | Ampacity | Fuse | Temperature | Datasheet | Connector | Ampacity | V Rating | HVIL | Wire Gauge | Datasheet
Maximum Tractive System Voltage: | 399VDC |  |  |  |  |  |  | Location |  | Rating |  | Rating | Rating |  | Accumulator Main Receptacle | 250A | 1000V | Yes | 2 AWG | Link | Total Number of AIR’s: | 2 | Make / Model | Bender IR155-3203 | Make / Model: | LEM / DHAB S/124 | Trip Current | 12.5A | Make/Model: | Adafruit / 3860 | Make / Model: | Bourns / CRM2512-JW-152ELF |  |  | Make / Model: | TE AMP+ Manual Service Disconnect | Make / Model: | Mallory Sonalert Products / ZA016LDFP1 | Make / Model: | Rideon / PF2473 | Make / Model: | Gigavac PNC113BDA
Nominal Tractive System Voltage: | 342VDC |  | Fuse Location | Current Rating | Voltage Rating | Interrupt Rating | Datasheet | Cell Busbars | 44.45mm2 | NA | 205A | 20A | NA | Team | Accumulator Main Plug | 150A | 1000V | Yes | 35mm^2 | Link | Current per AIR: | 0.23A (holding), 3.9A (inrush) | Supply voltage | 12VDC | Current input range: | +/- 75A Ch1, +/- 500A Ch2 | Current sensor output @Trip Current | 2.83V | Color: | Red | Resistance | 1.5K |  |  | Ampacity: | 630A | Control Voltage: | 12V | Resistance: | 2.2 kOhm | Contact Current Rating: | 30A
Grounded Low Voltage System Voltage: | 5VDC, 12VDC |  | Main Path Fuse inside AIR + Container L50S100 | 100A | 450 V | 20KA | Link |  |  |  |  |  |  | Manufactured | High Voltage Disconnect | 200A | 1500V | Yes | 35mm^2 | Link | Additional parts consumption within the shutdown circuit: | 0.17A (Discharge relay holding current) | Environmental temperature range: | -40..+105°C | Output range: | 0.25-4.75V | Delay time | 4.05ms | Flash Rate: | 4Hz | Quantity | 10 |  |  | Voltage rating: | 450V | SPL at 2m: | 85 dBA | Voltage: | 700V | Contact Voltage Rating: | 1500V
Number of Accumulator Containers: | 1 |  | Charger output | 30A | 500V | 30kA@500VAC, 20kA@500VDC | Link | Tractive System | 35mm2 | 1000V | 158A | 100A | -45°C to 150°C | Datasheet | Accumulator Aux Receptacle | 13A | 600V | Yes | 18 AWG | Link | Total current: | 0.63A | Self-test interval: | Every 5 minutes | Datasheet: | Datasheet |  |  | Powered By: | GLV | Power Dissipation / Power Rating | 1.067W / 2W |  |  | Datasheet: | Datasheet | Datasheet: | Datasheet | Power: | 140W | Datasheet: | Datasheet
Total Accumulator Capacity: | 7.182kWhr |  | Cell Fuses – Within Energus Modules | 45A | N/A | N/A | See Figure 6-3 | DC and Phase Wire |  |  |  |  |  |  | Accumulator Aux Plug | 13A | 600V | Yes | 18 AWG | Link |  |  | High voltage range: | DC 0..1000V |  |  |  |  | Controlled By: | TS | Configuration / Total Resistance | Series / 15K |  |  |  |  |  |  | Power @15sec: | 0W
Motor Type: | Synchronous Permanent Magnet, Axial Flux |  | TSAL Sense Line HVIB | 1A | 500 V | 100A | Link | Accumulator Wire | 35mm2 | 600V | 158A | 100A | -70C to 150C | Datasheet |  |  |  |  |  |  |  |  | Set response value: | 200kΩ (500Ω/Volt) |  |  |  |  | TS Turn On Voltage: | 10V | Maximum Overload Voltage | 600V |  |  |  |  |  |  | Datasheet | Datasheet
Number of Motors: | 1 |  | TSAL Sense Line HVIB | 1A | 500 V | 100A | Link | TSMP / HV Sense Wire | 16AWG | 600V | 13A | No fuse on TSMP | -68C to 150C | Datasheet |  |  |  |  |  |  |  |  | Max. operation current: | 150mA |  |  |  |  | TS Turn Off Voltage: | 10V | Datasheet | Datasheet | Make / Model: | Tenma 76-1658
Maximum Combined Motor Power: | 100kW |  | IMD Sense Line HVIB | 1A | 500 V | 100A | Link |  |  |  |  |  |  |  |  |  |  |  |  |  |  |  | Approximate time to shut down at 50% of the response value: | 40s |  |  |  |  |  |  |  |  | Voltage Rating: | 600V |  |  |  |  | Make / Model: | Ohmite / RA-T2X-25E
 |  |  |  |  |  |  |  |  |  |  |  |  |  |  |  |  |  |  |  |  |  |  | Datasheet | Datasheet |  |  |  |  |  |  |  |  | Datasheet: | Datasheet |  |  |  |  | Thermal Resistance Free Air | 4.8 degC/W
 |  |  |  |  |  |  |  |  |  |  |  |  |  |  |  |  |  |  |  |  |  |  |  |  |  |  |  |  |  |  |  |  |  |  |  |  |  |  | Thermal Resistance @ 200 LFM | 1.5 degC/W
 |  |  |  |  |  |  |  |  |  |  |  |  |  |  |  |  |  |  |  |  |  |  |  |  |  |  |  |  |  |  |  |  |  |  |  |  |  |  | Datasheet | Datasheet
PCB Material | FR4
PCB Coating | MG Chemical 4223-312G
Copper Weight | 2 oz
HV Trace Spacing | 1.5mm minimum
HV Trace Width | 1.27mm minimum
HV Trace Ampacity | 4.02A minimum
DMZ Spacing | 4mm minimum
LV Trace Spacing | 0.2mm minimum
LV Trace Width | 0.2mm minimum
LV Trace Ampacity | 0.65A minimum
Main board - Daughter board connector | Molex 15-24-7100 (Main board side)
 | Molex 15-24-6100 (Daughter board side)
Main board - Cable connector | Molex 5566-4 (HV)
 | Molex 5566-10, 5566-24 (LV)
Term | Expanded Term | Explanation
AIR | Accumulator Isolation Relay
AMS | Accumulator Monitoring System
BMS | Battery Monitoring System
BOTS | Brake Over Travel Switch
BSPD | Brake System Plausability Device
DMZ | Demilitarized Zone | Spacing between HV and LV on Printed Circuit Boards
GLV, LV | Grounded Low Voltage
GLVMP | Grounded Low Voltage Measurement Point
HV | High Voltage
IMD | Insulation Monitoring Device
TS | Tractive System
TSAL | Tractive System Active Light
TSMP | Tractive System Measurement Point
HVIB | High Voltage Interlock Board
MP | Maintenance Plug
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
