andrewrichardr/WFR2020/ACC-MB/BOM_WFR.xlsx

Part # | Manufacturer | Quantity
GV245BPB | Gigavac | 2
G81C235 | Gigavac | 2
V23079B1203B301 | TE | 2
SR4M4012 | TE | 2
G5NB-1A-E | Omron | 2
39281243 | Molex | 1
39012240 | Molex | 1
39000038 | Molex | 100
15247100 | Molex | 10
15246100 | Molex | 10
3568 | Keystone Electronics | 10
39288040 | Molex | 4
39012040 | Molex | 4
KIT-RMCF0805JT-12 | Stackpole | 1
KIT-RMCF0805JT-13 | Stackpole | 1
40408 | Vicor | 2
9GAX0412P3S0031 | Sanyo Denki | 2
DCM290P138T600A40 | Vicor | 2
B58035U5305M062 | EPCOS | 4
EGPD250ELL472ML25H | United Chemi-con | 2
088502.5DR | Littlefuse | 20
LTV816 | Lite-On Inc. | 4
SRP1770TA-390M | Bourns | 2
3568 | Keystone Electronics | 15
SQJ407EP-T1_GE3 | Vishay | 6
RK7002BMT116 | RHOM | 2
UCC27511AQDBVRQ1 | Texas Instruments
IR155 | Bender | 1
CRM2512-JW-102ELF | Bourns | 30
LSCR001 | Littlefuse | 2
39281103 | Molex | 2
2N2222A PBFREE | Central Semiconductor Corp | 1
RC0805FR-0710KL | Yageo | 10
RC0805FR-072K2L | Yageo | 2
RC0805FR-0710KL | Yageo | 25
RMCF2010JT200R | Stackpole | 6
PF2472-1RF1 | Rideon | 2
7792 | Keystone Electronics | 10
C0805C393K5RACTU | Kemet | 4
C0805C103K1RAC7210 | Kemet | 4
C0805C104Z5VACTU | Kemet | 4
CC0805ZRY5V6BB475 | Yageo | 4
C0805C104Z5VACTU | Kemet | 4
1N4004 | Onsemi | 8
1N5371BRLG | Onsemi | 4
NE555P | TI | 4
RC0805FR-07100RL | Yageo | 16
RC0805FR-071ML | Yageo | 20
RC0805FR-072K2L | Yageo | 16
RC0805JR-074M7L | Yageo | 4
BUZ11-NR4941 | Onsemi | 20
MIC4417YM4-TR | Microchip | 4
IXCY10M90S | IXYS | 4
UPW1E152MHD | Nichicon | 2
UVR1V222MHD | Nichicon | 2
UPW1J391MHD6 | Nichicon | 2
SBR1045SD1-T | Diodes Inc | 2
FMP100JR-52-100R | Yageo | 2
AP1012K2J | Ohmite | 2
AP101 620R J | Ohmite | 2
SLPPB35BSO0EH | Amphenol | 1
SLPPB35BSO1EH | Amphenol | 1
SLPIRBBPSB0EH | Amphenol | 1
SLPIRBBPSB1EH | Amphenol | 1
