andrewrichardr/WFR2020/ACC-MB/Rev4/MainBoard/Main.dxf

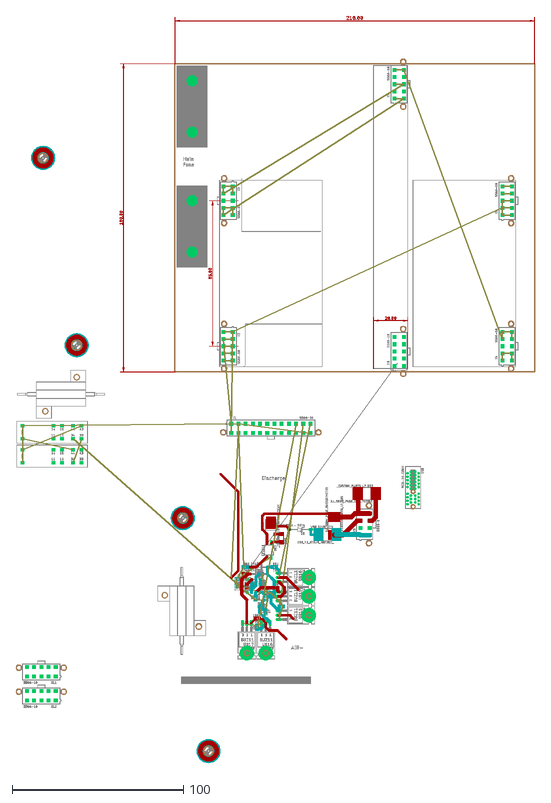
[picture p64: CAD file, 2019-10-11]
ACC-MB/Rev4/MainBoard/Main.dxf
302.7 x 436.2
