andrewrichardr/WFR2020/mainfuseassy.STEP

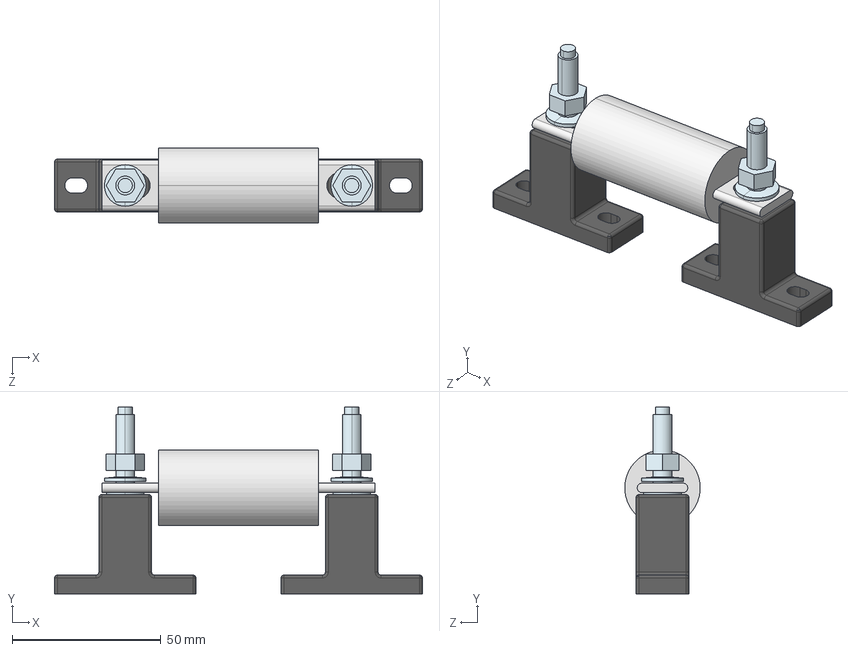
[picture p65: CAD file, 2019-10-13]
mainfuseassy.STEP
123.9 x 62.9 x 25.4 mm
mainfuseholder x 2
100Afuse
