andrewrichardr/WFR2020/ACC-MB/mainfuseholder.SLDPRT

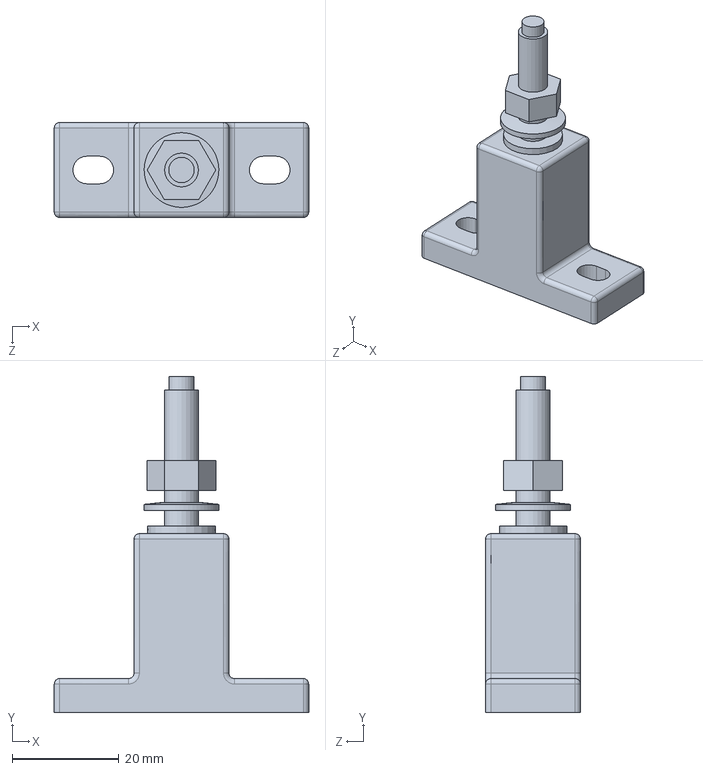
[picture p66: CAD file, 2019-10-13]
ACC-MB/mainfuseholder.SLDPRT
47.6 x 62.9 x 17.8 mm
