andrewrichardr/WFR2020/ACC-MB/5566-24mated.STEP

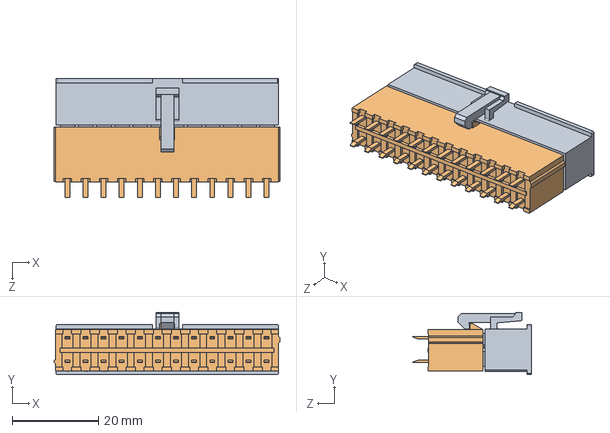
[picture p67: CAD file, 2019-11-23]
ACC-MB/5566-24mated.STEP
52.4 x 14.4 x 27.5 mm
5566socket
5566pcb
