andrewrichardr/WFR2020/ACC-MB/Rev4/ATS-CPX-114-CX-R0_FUSED.STEP

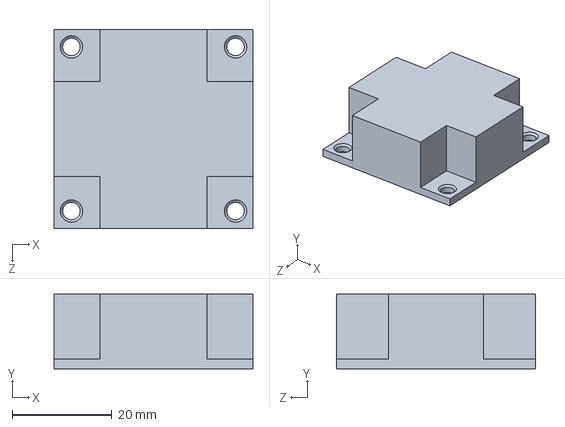
[picture p68: CAD file, 2019-10-13]
ACC-MB/Rev4/ATS-CPX-114-CX-R0_FUSED.STEP
40.0 x 15.0 x 40.0 mm
