andrewrichardr/WFR2020/ACC-MB/Rev4/CRDC/CRDC.dxf

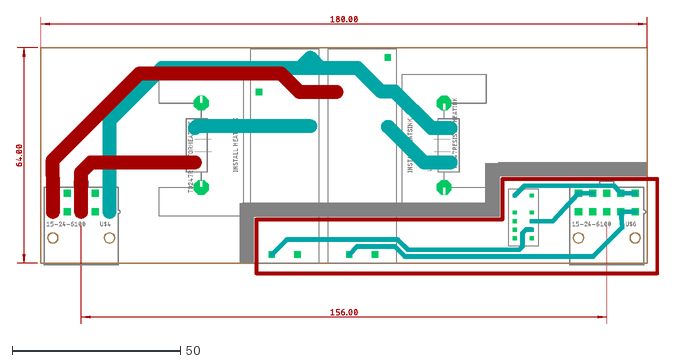
[picture p69: CAD file, 2019-10-11]
ACC-MB/Rev4/CRDC/CRDC.dxf
190.9 x 91.4
