andrewrichardr/WFR2020/VicorDCM.STEP

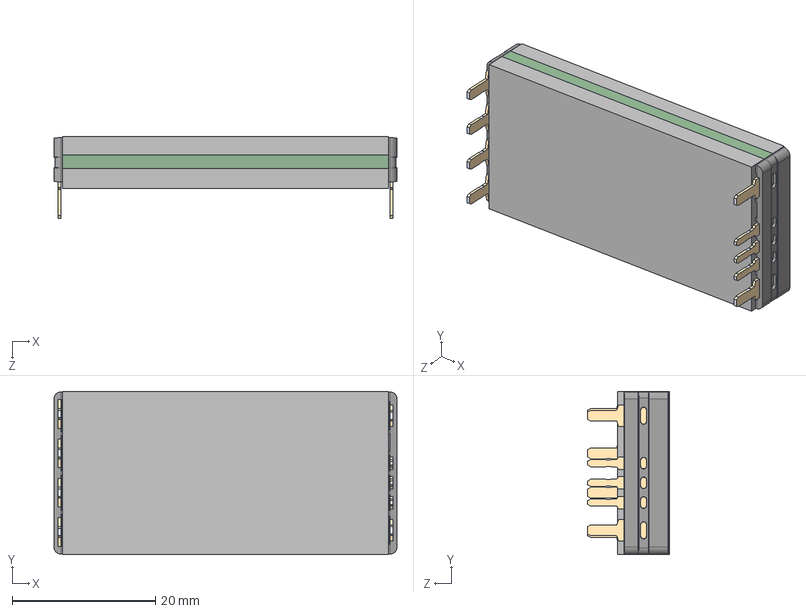
[picture p70: CAD file, 2019-11-23]
VicorDCM.STEP
47.9 x 22.8 x 11.4 mm
Copy of MOLDBODY2_VENTED_TERMINAL_BLOCK_OUTPUT_23FAMILY_SMD.1^40324
Copy of MOLDBODY2_VENTED_TERMINAL_BLOCK_INPUT_23FAMILY_SMD.1^40324-1
Copy of MOLDBODY_UPPER^4623 MOLD BODY
Copy of MOLDBODY_LOWER^4623 MOLD BODY
Copy of Copy of LAMINATE_CAVITY^Copy of legacy stackup_4623 MOLD BODY
Copy of Copy of LAYER_04^Copy of legacy stackup_4623 MOLD BODY
Copy of Copy of LAYER_05^Copy of legacy stackup_4623 MOLD BODY
Copy of Copy of LAYER_06^Copy of legacy stackup_4623 MOLD BODY
Copy of Copy of LAYER_07^Copy of legacy stackup_4623 MOLD BODY
Copy of Copy of LAYER_08^Copy of legacy stackup_4623 MOLD BODY
Copy of Copy of LAYER_09^Copy of legacy stackup_4623 MOLD BODY
Copy of Copy of LAYER_10^Copy of legacy stackup_4623 MOLD BODY
Copy of Copy of LAYER_11^Copy of legacy stackup_4623 MOLD BODY
Copy of Copy of LAYER_02^Copy of legacy stackup_4623 MOLD BODY
Copy of Copy of LAYER_01^Copy of legacy stackup_4623 MOLD BODY
Copy of Copy of LAYER_12^Copy of legacy stackup_4623 MOLD BODY
Copy of Copy of LAYER_13^Copy of legacy stackup_4623 MOLD BODY
Copy of Copy of LAYER_03^Copy of legacy stackup_4623 MOLD BODY
Copy of Copy of LAYER_14^Copy of legacy stackup_4623 MOLD BODY
