andrewrichardr/WFR2020/ACC-MB/5566pcb.SLDPRT

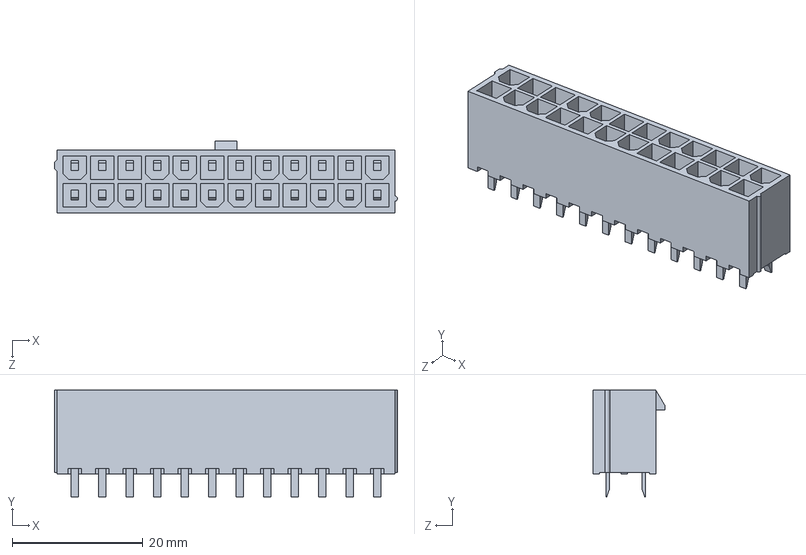
[picture p71: CAD file, 2019-11-23]
ACC-MB/5566pcb.SLDPRT
52.4 x 16.3 x 11.0 mm
