andrewrichardr/WFR2020/ACC-MB/5566socket.SLDPRT

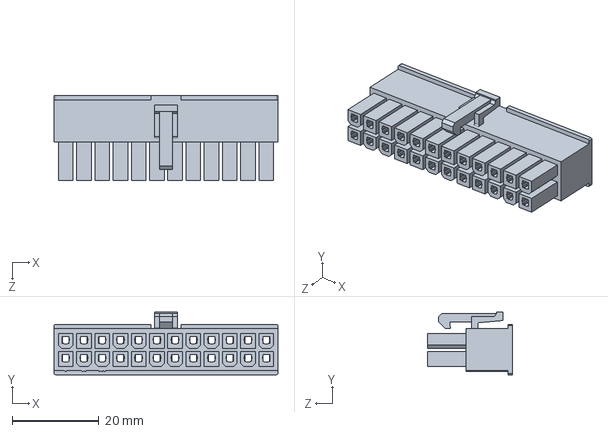
[picture p72: CAD file, 2019-11-23]
ACC-MB/5566socket.SLDPRT
51.6 x 14.4 x 19.6 mm
