andrewrichardr/WFR2020/ACC-MB/100Afuse.SLDPRT

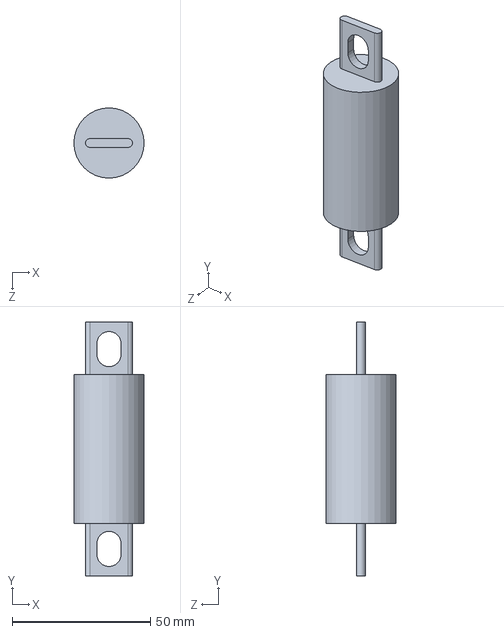
[picture p73: CAD file, 2019-10-13]
ACC-MB/100Afuse.SLDPRT
25.4 x 91.8 x 25.4 mm
