andrewrichardr/WFR2020/ACC-MB/IR155.STEP

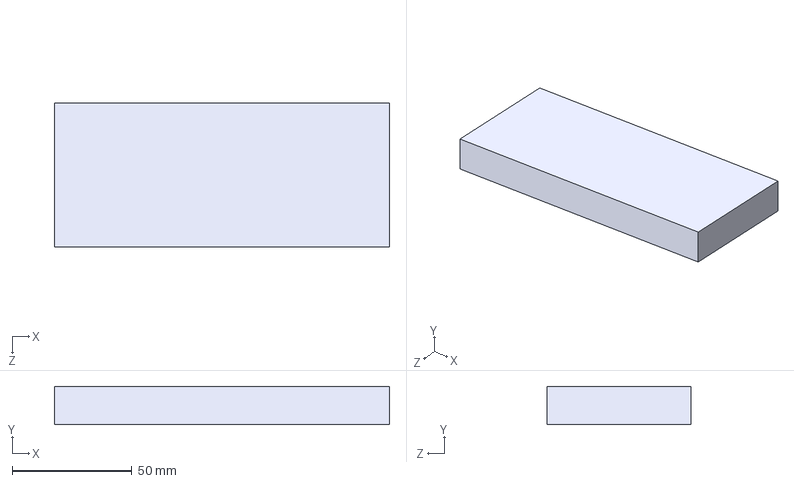
[picture p74: CAD file, 2019-10-13]
ACC-MB/IR155.STEP
140.0 x 16.0 x 60.0 mm
