andrewrichardr/WFR2020/ACC-MB/Rev0/AIR.SLDPRT

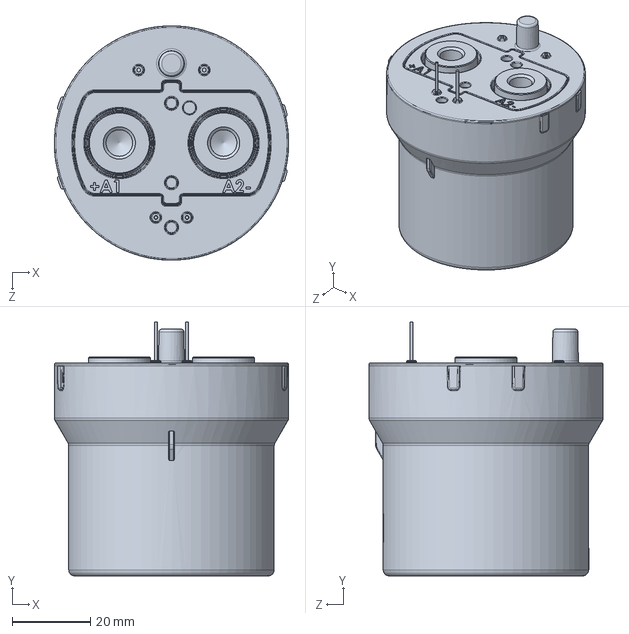
[picture p75: CAD file, 2019-09-20, an earlier design]
ACC-MB/Rev0/AIR.SLDPRT
59.9 x 65.0 x 59.9 mm
