andrewrichardr/WFR2020/ACC-MB/Rev0/MECH/CRDC.SLDPRT

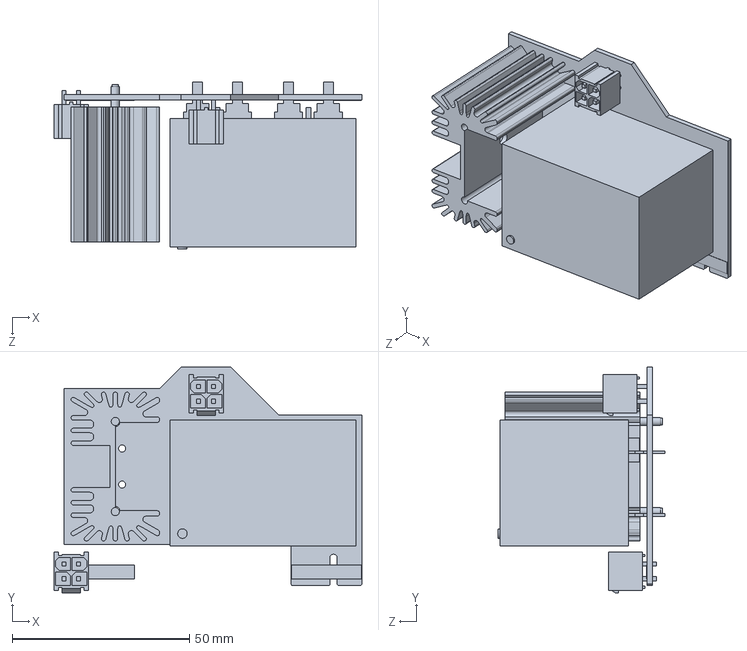
[picture p76: CAD file, 2019-10-01, an earlier design]
ACC-MB/Rev0/MECH/CRDC.SLDPRT
86.8 x 63.6 x 47.0 mm
