andrewrichardr/WFR2020/ACC-MB/Rev1/AIRDCL/AIRDC.dxf

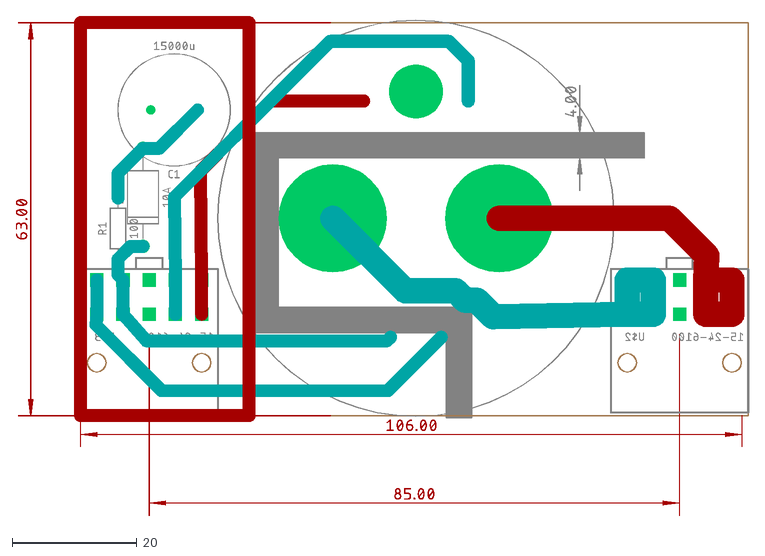
[picture p77: CAD file, 2019-10-11, an earlier design]
ACC-MB/Rev1/AIRDCL/AIRDC.dxf
117.5 x 80.0
