andrewrichardr/WFR2020/ACC-MB/Rev0/RA-T2X-38E.SLDPRT

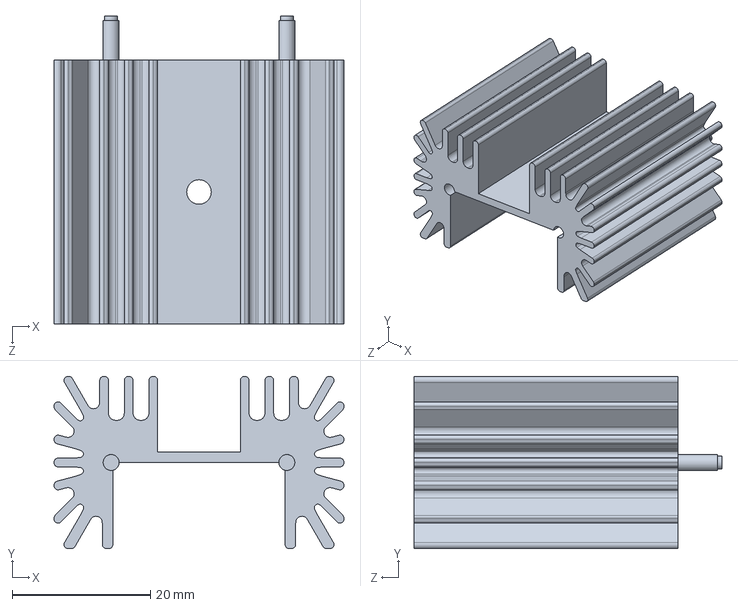
[picture p78: CAD file, 2019-09-20, an earlier design]
ACC-MB/Rev0/RA-T2X-38E.SLDPRT
41.9 x 24.9 x 44.5 mm
