andrewrichardr/WFR2020/(list of files, cad)

Other CAD files:
ACC-MB/mainfuseassy.STEP
ACC-MB/Rev0/LSCR001.SLDASM
ACC-MB/Rev0/Littelfuse_lscr001_3D_Model igs2.sldprt
ACC-MB/Rev0/AIRPCB.SLDPRT
ACC-MB/Rev0/G7L_2A_X.SLDPRT
ACC-MB/Rev0/L50S 70-100A.SLDPRT
ACC-MB/Rev0/Littelfuse_lscr001_3D_Model igs1.sldprt
ACC-MB/Rev0/PCB.SLDPRT
ACC-MB/mainfuseassy.SLDPRT
