andrewrichardr/WFR2020/GerberTools_2019_9_20/QuickRender/FinalAfterSoldermask.png

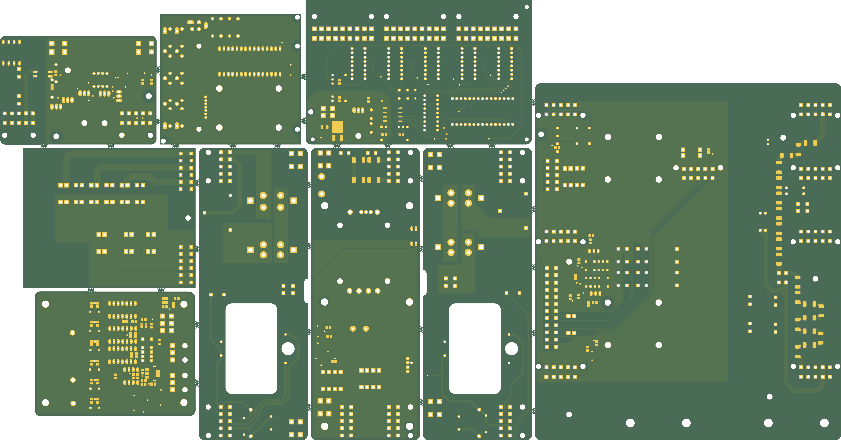
GerberTools_2019_9_20/QuickRender/FinalAfterSoldermask.png
