andrewrichardr/WFR2020/GerberTools_2019_9_20/QuickRender/Top_soldermaskholes.png

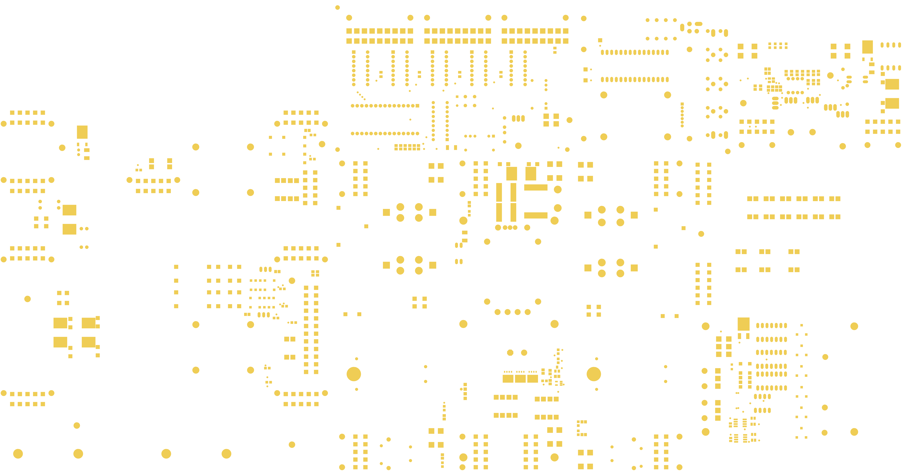
GerberTools_2019_9_20/QuickRender/Top_soldermaskholes.png
