andrewrichardr/WFR2020/ACC-MB/dashboard-schematic.pdf

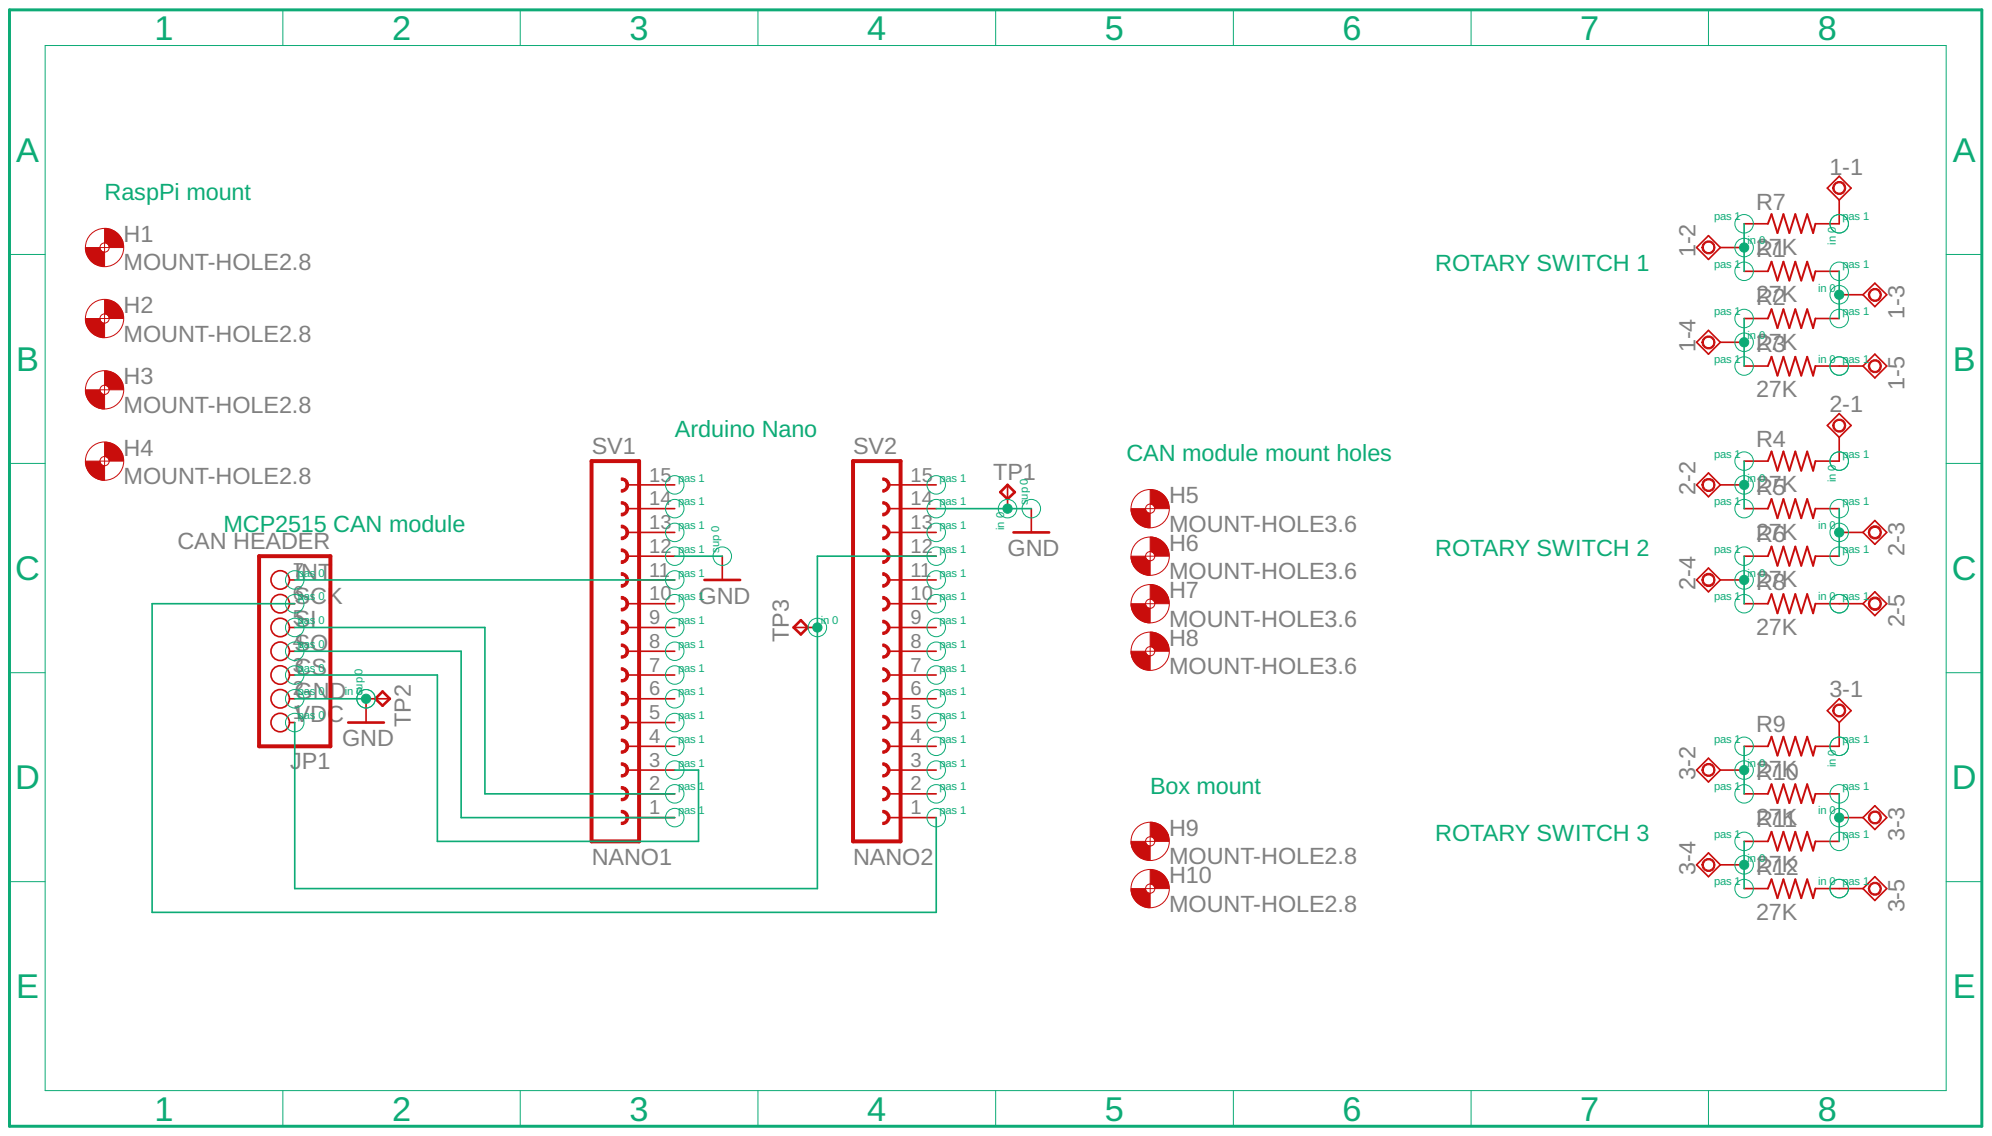
[picture p82: page 1]

in 0 CAN module mount holes
