andrewrichardr/WFR2020/ACC-MB/Rev4/ShutdownArchitecture.pdf

## INSIDE ACC OUTSIDE ACC

## ACC MOTHERBOARD

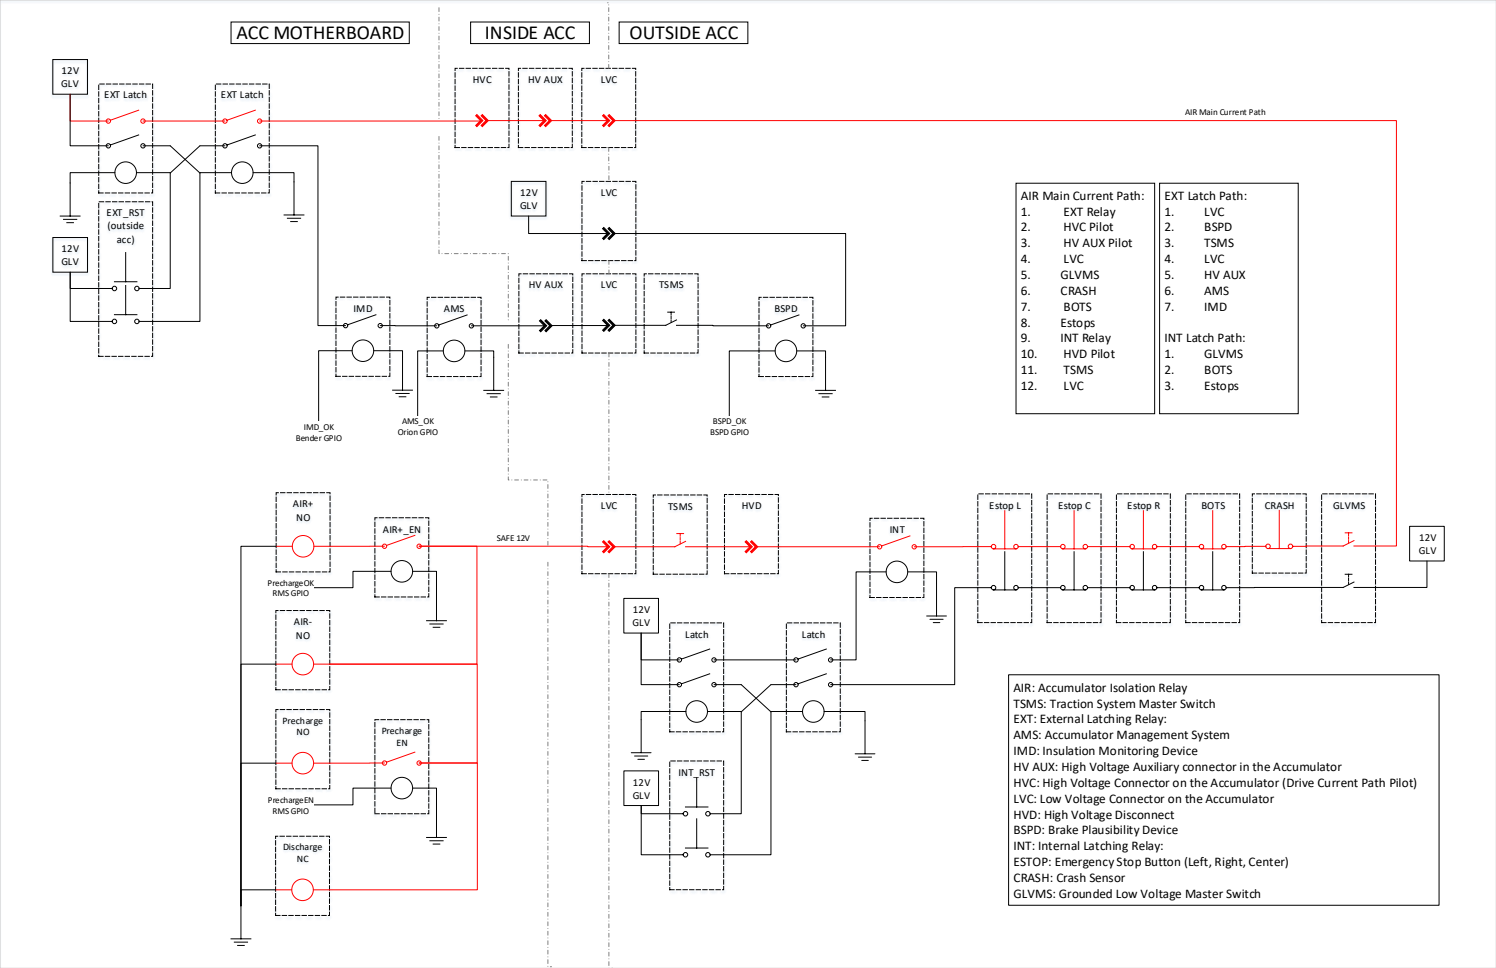
[picture p83: page 1]
HV AUX; LVC; 12V GLV; PrechargeOK RMS GPIO; Estop L; Estop C; Estop R; BOTS; CRASH; GLVMS; AIR+_EN; INT; AIR+ NO; AIR- NO; HVD; HVC; TSMS; Latch; INT_RST; EXT Latch; EXT_RST (outside acc); IMD; AMS; BSPD; IMD_OK Bender GPIO; AMS_OK Orion GPIO; BSPD_OK BSPD GPIO; Precharge EN; PrechargeEN RMS GPIO; Precharge NO; SAFE 12V; EXT Latch Path: 1. LVC 2. BSPD 3. TSMS 4. LVC 5. HV AUX 6. AMS 7. IMD; Discharge NC

AIR Main Current Path

AIR Main Current Path:
1. EXT Relay
2. HVC Pilot
3. HV AUX Pilot
4. LVC
5. GLVMS
6. CRASH
7. BOTS
8. Estops
9. INT Relay
10. HVD Pilot
11. TSMS
12. LVC

INT Latch Path:
1. GLVMS
2. BOTS
3. Estops

AIR: Accumulator Isolation Relay
TSMS: Traction System Master Switch
EXT: External Latching Relay:
AMS: Accumulator Management System
IMD: Insulation Monitoring Device
HV AUX: High Voltage Auxiliary connector in the Accumulator
HVC: High Voltage Connector on the Accumulator (Drive Current Path Pilot)
LVC: Low Voltage Connector on the Accumulator
HVD: High Voltage Disconnect
BSPD: Brake Plausibility Device
INT: Internal Latching Relay:
ESTOP: Emergency Stop Button (Left, Right, Center)
CRASH: Crash Sensor
GLVMS: Grounded Low Voltage Master Switch
