andrewrichardr/WFR2020/ACC-MB/BSPDhl.pdf

## Current Sensor

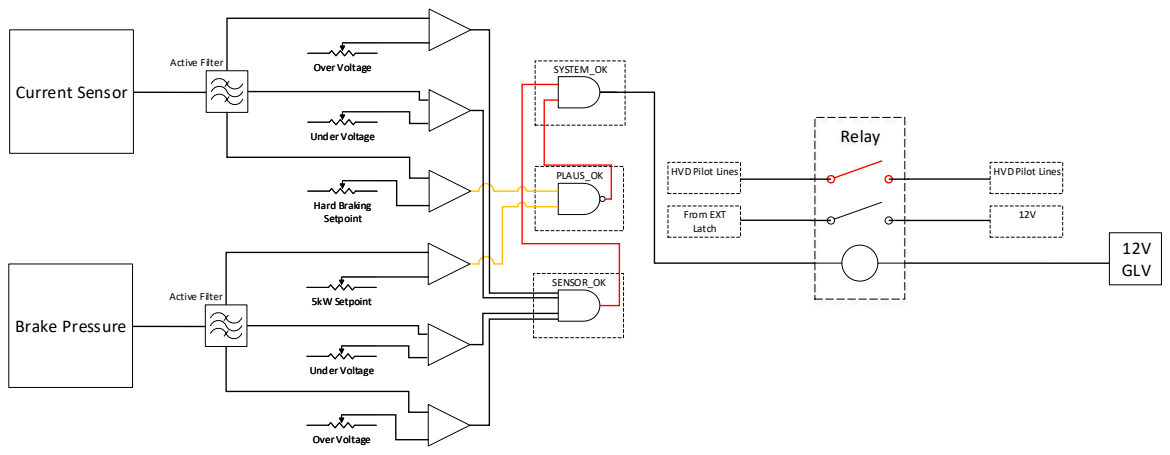
[picture p84: page 1]
PLAUS_OK; From EXT Latch; SENSOR_OK; SYSTEM_OK; Active Filter; Over Voltage; Under Voltage; Hard Braking Setpoint; Brake Pressure; 5kW Setpoint; Relay; HVD Pilot Lines; 12V GLV
