andrewrichardr/WFR2020/ACC-MB/ChargeCart.pdf

## AIR

## 240 VAC

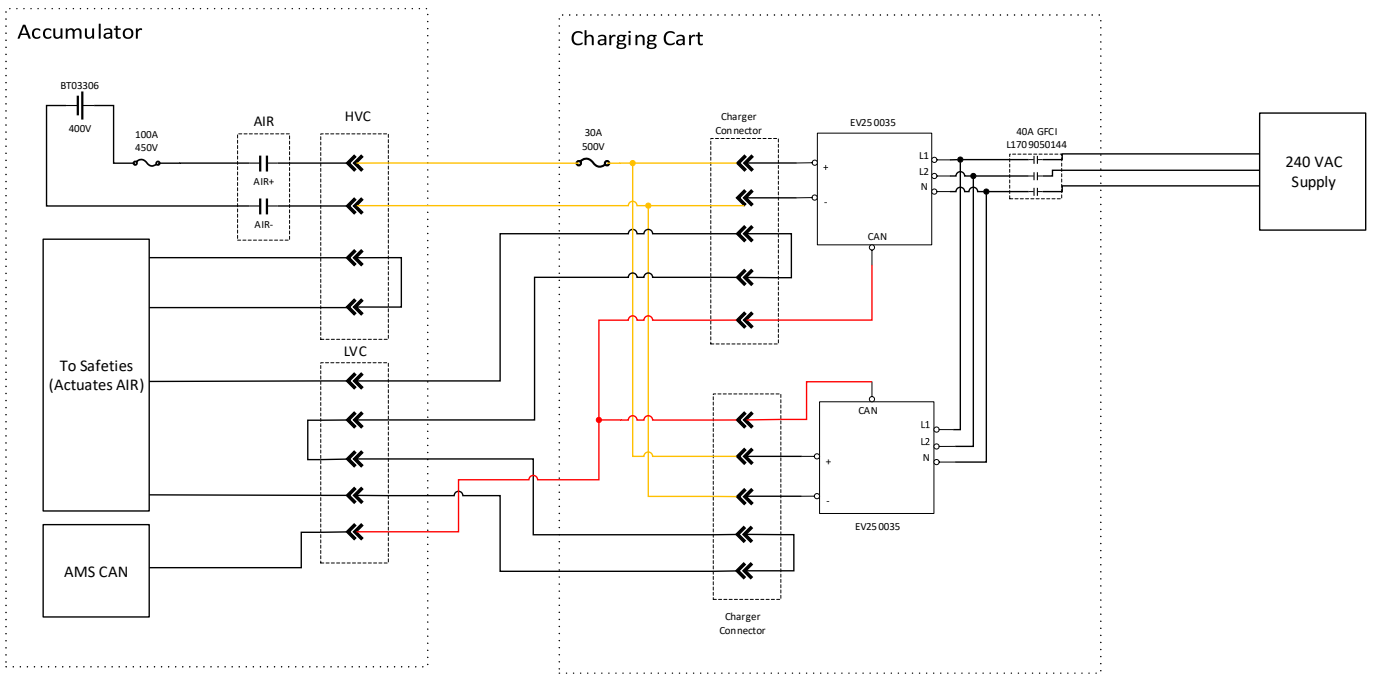
[picture p85: page 1]
AIR+; AIR; HVC; Charger; Connector; To Safeties (Actuates AIR); AMS CAN; Supply; CAN; Charger Connector; 40A GFCI L170 9050144; LVC
