andrewrichardr/WFR2020/ACC-MB/ACCDiagramGLV.pdf

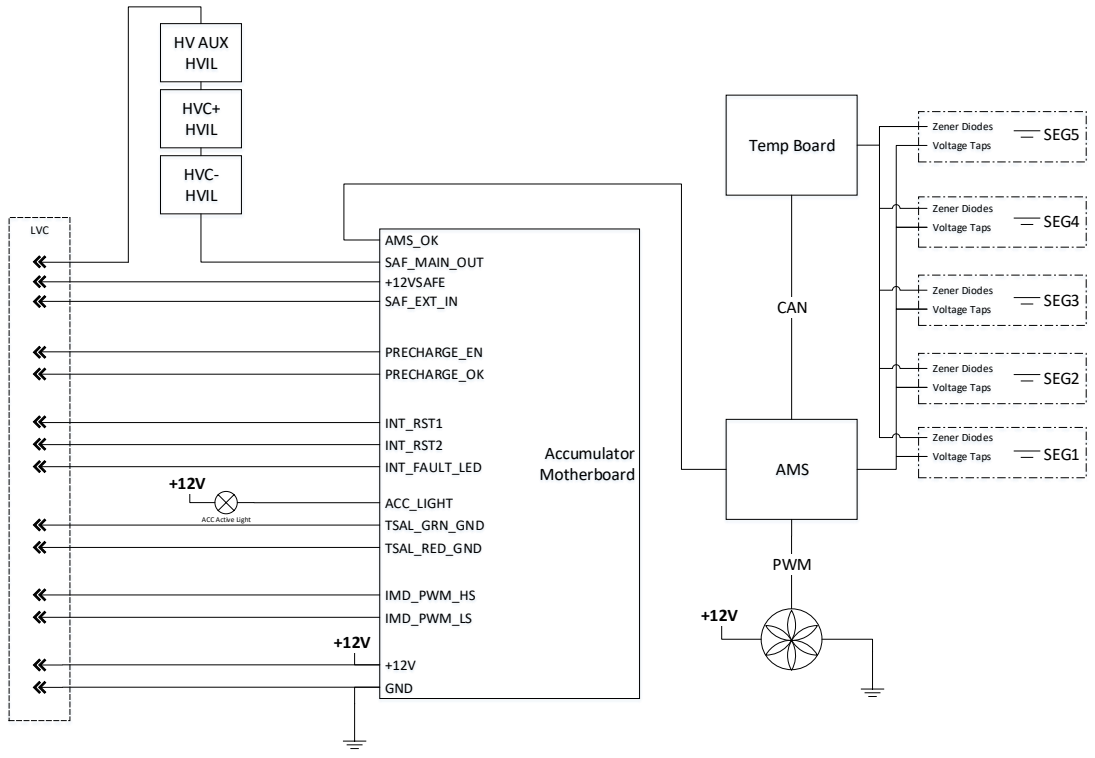
[picture p86: page 1]
SEG1; SEG2; SEG3; SEG4; SEG5; AMS; Temp Board; CAN; Voltage Taps; Zener Diodes; Accumulator Motherboard; +12VSAFE; PRECHARGE_EN; PRECHARGE_OK; SAF_MAIN_OUT; INT_RST1 INT_RST2; AMS_OK; SAF_EXT_IN; INT_FAULT_LED; ACC_LIGHT; TSAL_GRN_GND TSAL_RED_GND; IMD_PWM_HS IMD_PWM_LS; GND; HVC- HVIL; HVC+ HVIL; HV AUX HVIL; LVC; PWM

ACC Active Light
