andrewrichardr/WFR2020/ACC-MB/ChargeCartShutdown.pdf

INSIDE ACC | CHARGE CART

## ACC MOTHERBOARD

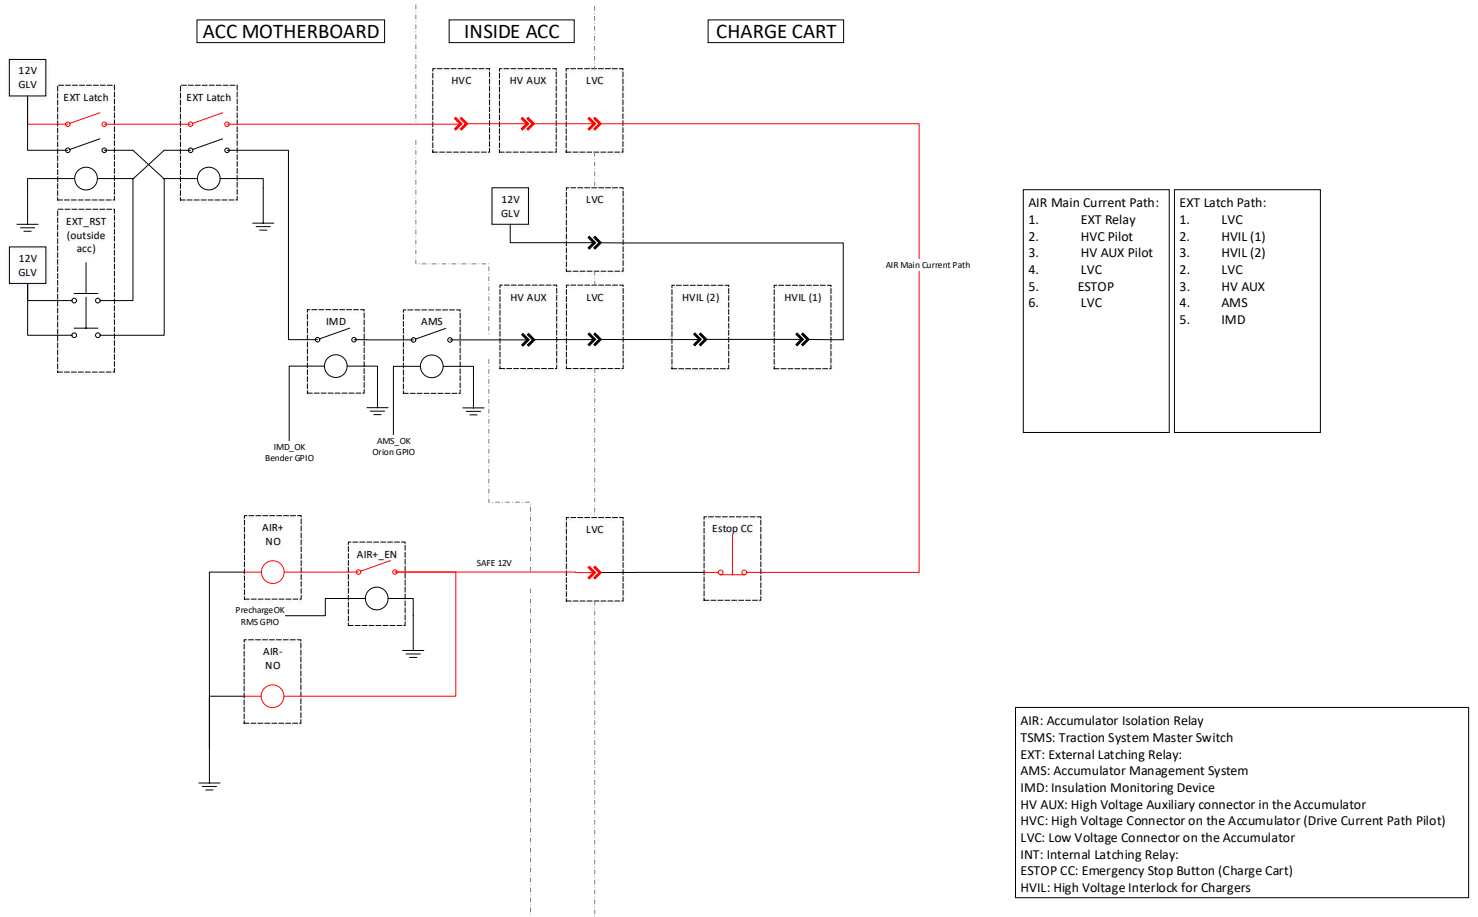
[picture p87: page 1]
HV AUX; LVC; PrechargeOK RMS GPIO; AIR+_EN; AIR+ NO; AIR- NO; HVC; 12V GLV; EXT Latch; EXT_RST (outside acc); IMD; AMS; IMD_OK Bender GPIO; AMS_OK Orion GPIO; SAFE 12V; EXT Latch Path: 1. LVC 2. HVIL (1) 3. HVIL (2) 2. LVC 3. HV AUX 4. AMS 5. IMD; Estop CC; HVIL (2); HVIL (1)

AIR Main Current Path:
1. EXT Relay
2. HVC Pilot
3. HV AUX Pilot
4. LVC
5. ESTOP
6. LVC

AIR Main Current Path

AIR: Accumulator Isolation Relay
TSMS: Traction System Master Switch
EXT: External Latching Relay:
AMS: Accumulator Management System
IMD: Insulation Monitoring Device
HV AUX: High Voltage Auxiliary connector in the Accumulator
HVC: High Voltage Connector on the Accumulator (Drive Current Path Pilot)
LVC: Low Voltage Connector on the Accumulator
INT: Internal Latching Relay:
ESTOP CC: Emergency Stop Button (Charge Cart)
HVIL: High Voltage Interlock for Chargers
