andrewrichardr/WFR2020/ACC-MB/MotherboardDiagramRev2.pdf

AIR- / Discharge Card | AIR+ / Precharge Card

# WFR2020 Accumulator HV Motherboard, Connectivity Diagram, 11/23/2019, Andrew Randell

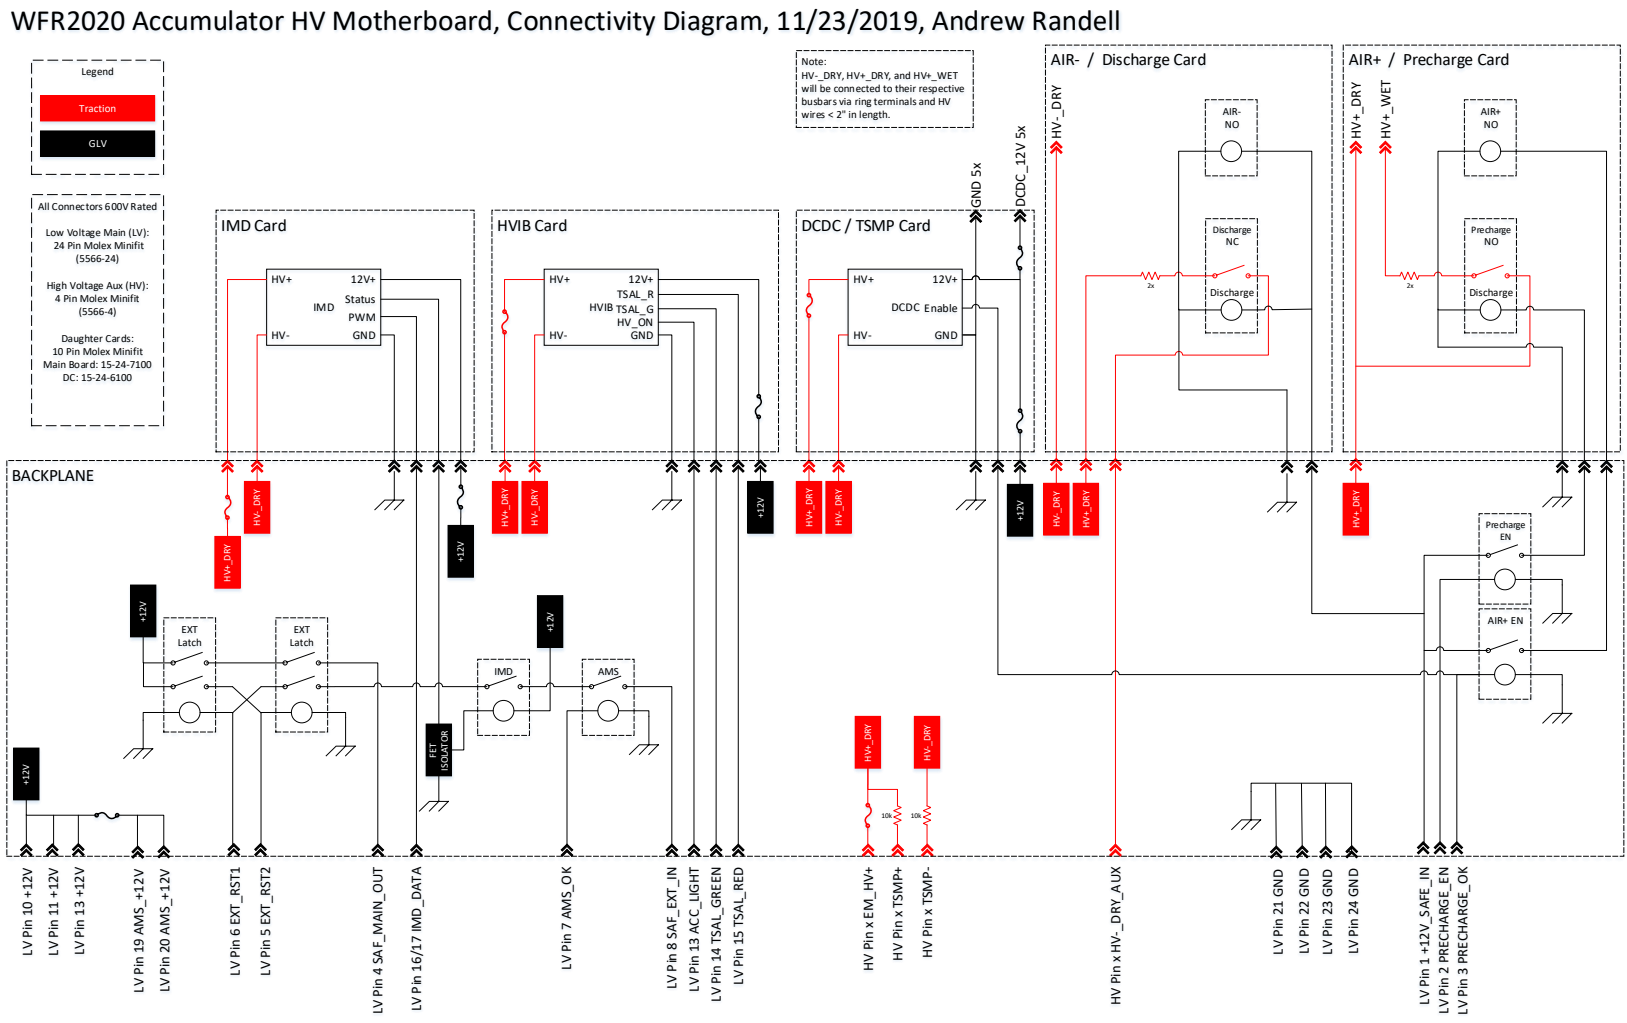
[picture p88: page 1]
AIR- NO; Discharge NC; Discharge; HV-_DRY; AIR+ NO; Precharge NO; HV+_DRY; HV+_WET; DCDC; GND; Enable; IMD; Status PWM; HVIB; TSAL_R; TSAL_G; AIR+ EN; Precharge EN; EXT Latch; AMS; FET; ISOLATOR; BACKPLANE; IMD Card; HVIB Card; DCDC / TSMP Card LV Pin 6 EXT_RST1; LV Pin 5 EXT_RST2; LV Pin 4 SAF_MAIN_OUT; LV Pin 16/17 IMD_DATA; LV Pin 7 AMS_OK; LV Pin 8 SAF_EXT_IN LV Pin 13 ACC_LIGHT LV Pin 14 TSAL_GREEN LV Pin 15 TSAL_RED; HV Pin x EM_HV⁺; HV Pin x TSMP+; HV Pin x TSMP⁻; HV Pin x HV⁻_DRY_AUX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

Note:
HV-_DRY, HV+_DRY, and HV+_WET
will be connected to their respective
busbars via ring terminals and HV
wires < 2" in length.

All Connectors 600V Rated

Low Voltage Main (LV):
24 Pin Molex Minifit

High Voltage Aux (HV):
4 Pin Molex Minifit

Daughter Cards:
10 Pin Molex Minifit
Main Board: 15-24-7100

LV Pin 21 GND

LV Pin 22 GND

LV Pin 23 GND

LV Pin 24 GND
