andrewrichardr/WFR2020/ACC-MB/ACCDiagram.pdf

MP

## SEG5

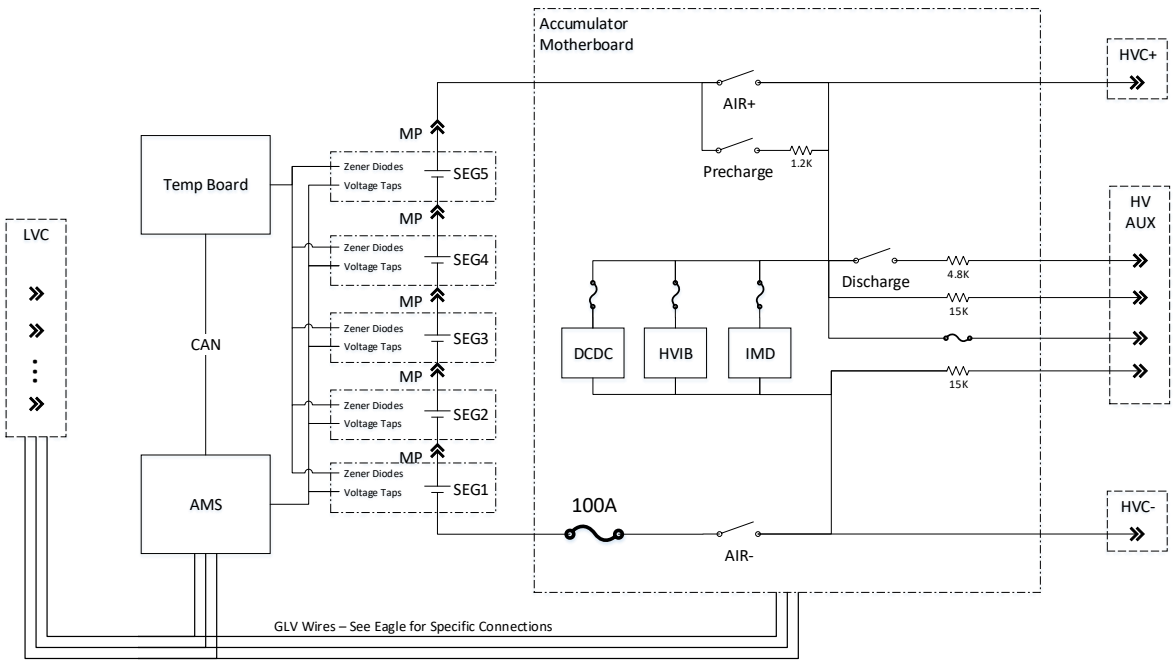
[picture p89: page 1]
SEG1; SEG2; SEG3; SEG4; HVC+; HV AUX; AIR+; AIR-; HVC-; Precharge 1.2K; Discharge; DCDC; HVIB; IMD; Accumulator Motherboard; AMS; Temp Board; CAN; Voltage Taps; Zener Diodes; LVC...

GLV Wires – See Eagle for Specific Connections
