andrewrichardr/WFR2020/2019/SAF016.pdf

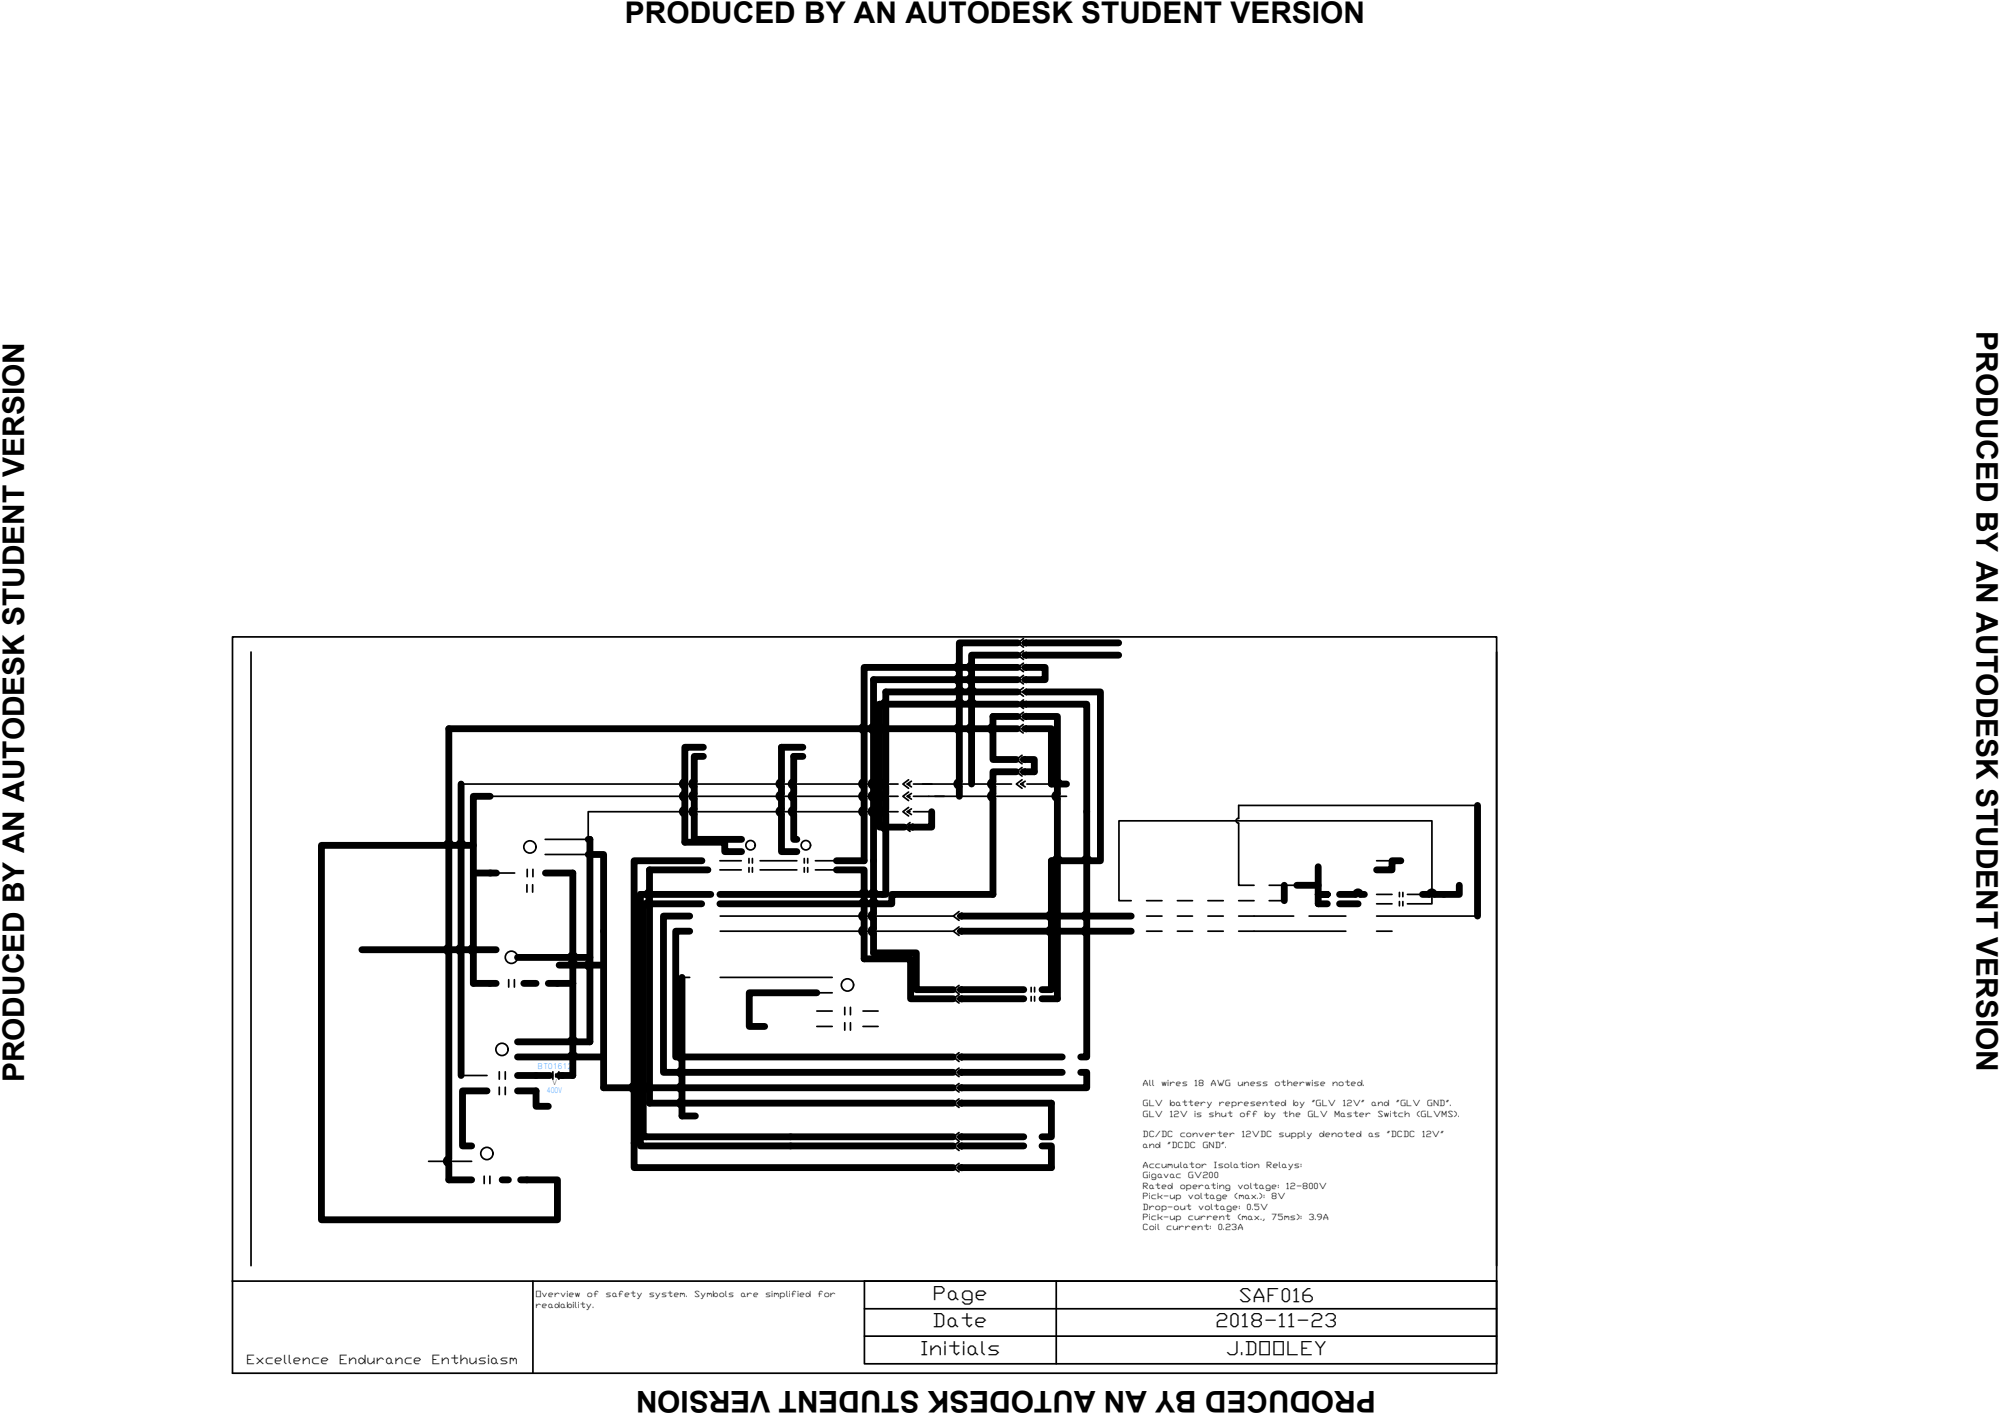
[picture p90: page 1]
readability. Excellence Endurance Enthusiasm; Page; SAF016 Date; 2018-11-23 Initials; J.DOOLEY All wires 18 AWG uness otherwise noted. GLV battery represented by "GLV 12V" and "GLV GND". GLV 12V is shut off by the GLV Master Switch (GLVMS). DC/DC converter 12VDC supply denoted as "DCDC 12V" and "DCDC GND". Accumulator Isolation Relays: Gigavac GV200 Rated operating voltage: 12-800V Pick-up voltage (max.): 8V Drop-out voltage: 0.5V Pick-up current (max., 75ms): 3.9A Coil current: 0.23A 400V

PRODUCED BY AN AUTODESK STUDENT VERSION

Overview of safety system. Symbols are simplified for
