andrewrichardr/WFR2020/2019/Shutdown2019.pdf

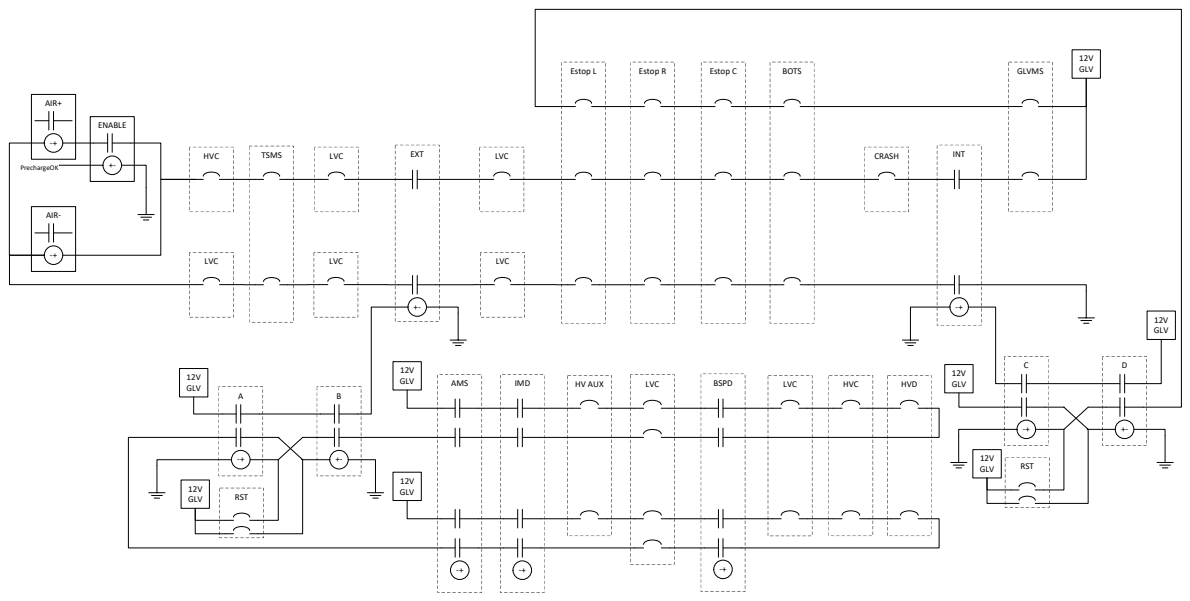
[picture p91: page 1]
HV AUX; LVC; EXT; INT; Estop L; Estop R; Estop C; BOTS; TSMS; AIR+; -+ AIR-; HVC; CRASH; GLVMS; 12V GLV; -+ AMS; IMD; +- 12V GLV; RST; BSPD; HVD; ENABLE; PrechargeOK; +- RST
