andrewrichardr/WFR2020/2019/Shutdown2020.pdf

## -+ AIR-

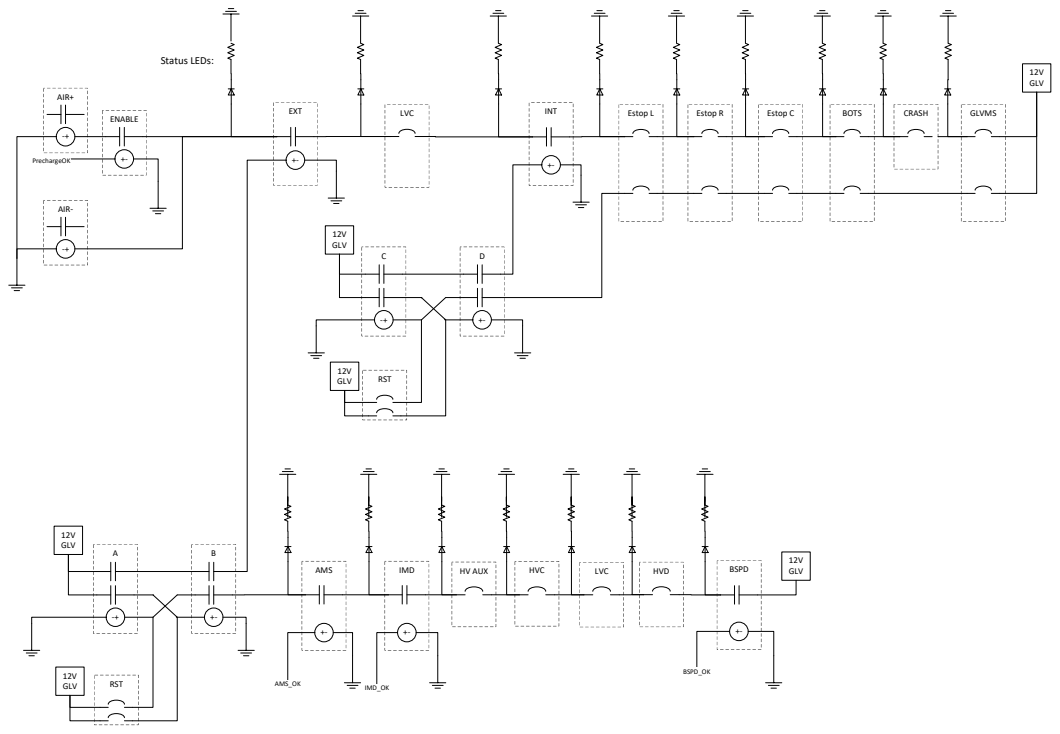
[picture p92: page 1]
HV AUX; EXT; INT; Estop L; Estop R; Estop C; BOTS; AIR+; CRASH; GLVMS; 12V GLV; AMS; IMD; LVC; +- 12V GLV; RST; HVC; BSPD; ENABLE; PrechargeOK; +- RST; HVD; +- BSPD_OK; IMD_OK AMS_OK; Status LEDs:
