andrewrichardr/WFR2020/2019/Shutdown2020A.pdf

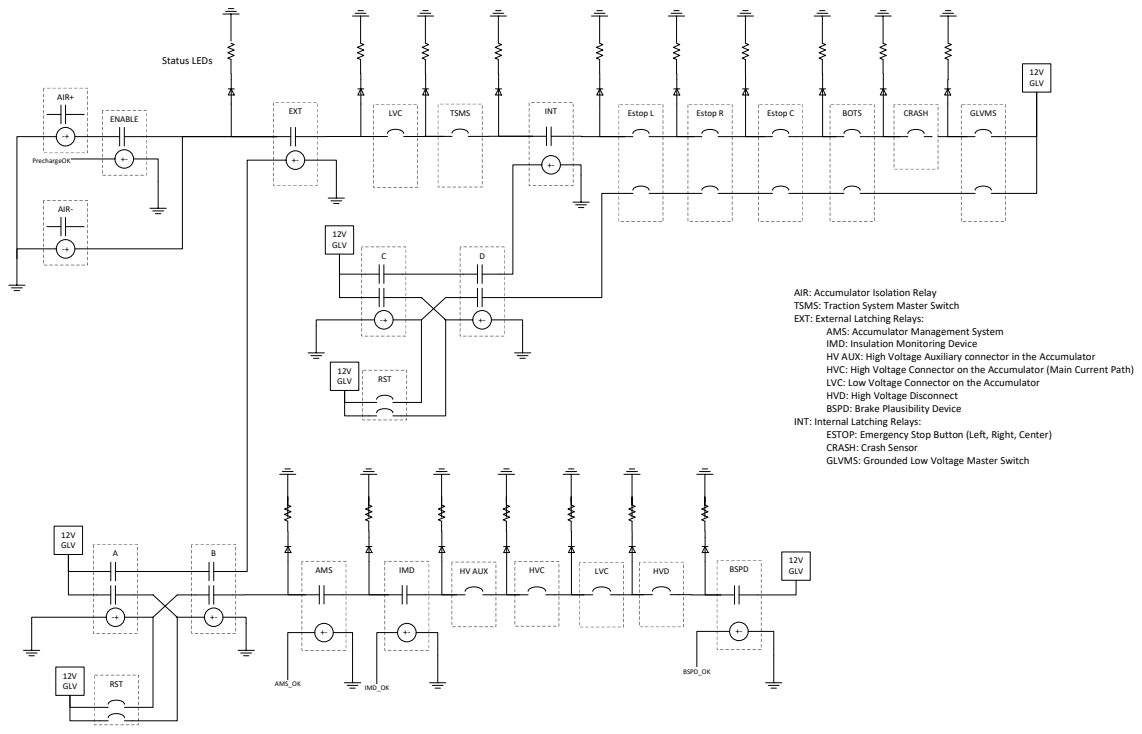
[picture p93: page 1]
HV AUX; EXT; INT; Estop L; Estop R; Estop C; BOTS; AIR+; -+ AIR-; CRASH; GLVMS; 12V GLV; AMS; IMD; LVC; +- 12V GLV; RST; HVC; BSPD; ENABLE; PrechargeOK; +- RST; HVD; +- BSPD_OK; IMD_OK AMS_OK; Status LEDs; TSMS

AIR: Accumulator Isolation Relay
TSMS: Traction System Master Switch
EXT: External Latching Relays:
AMS: Accumulator Management System
IMD: Insulation Monitoring Device
HV AUX: High Voltage Auxiliary connector in the Accumulator
HVC: High Voltage Connector on the Accumulator (Main Current Path)
LVC: Low Voltage Connector on the Accumulator
HVD: High Voltage Disconnect
BSPD: Brake Plausibility Device
INT: Internal Latching Relays:
ESTOP: Emergency Stop Button (Left, Right, Center)
CRASH: Crash Sensor
GLVMS: Grounded Low Voltage Master Switch
