andrewrichardr/WFR2020/2019/ACC 2019 05 15.pdf

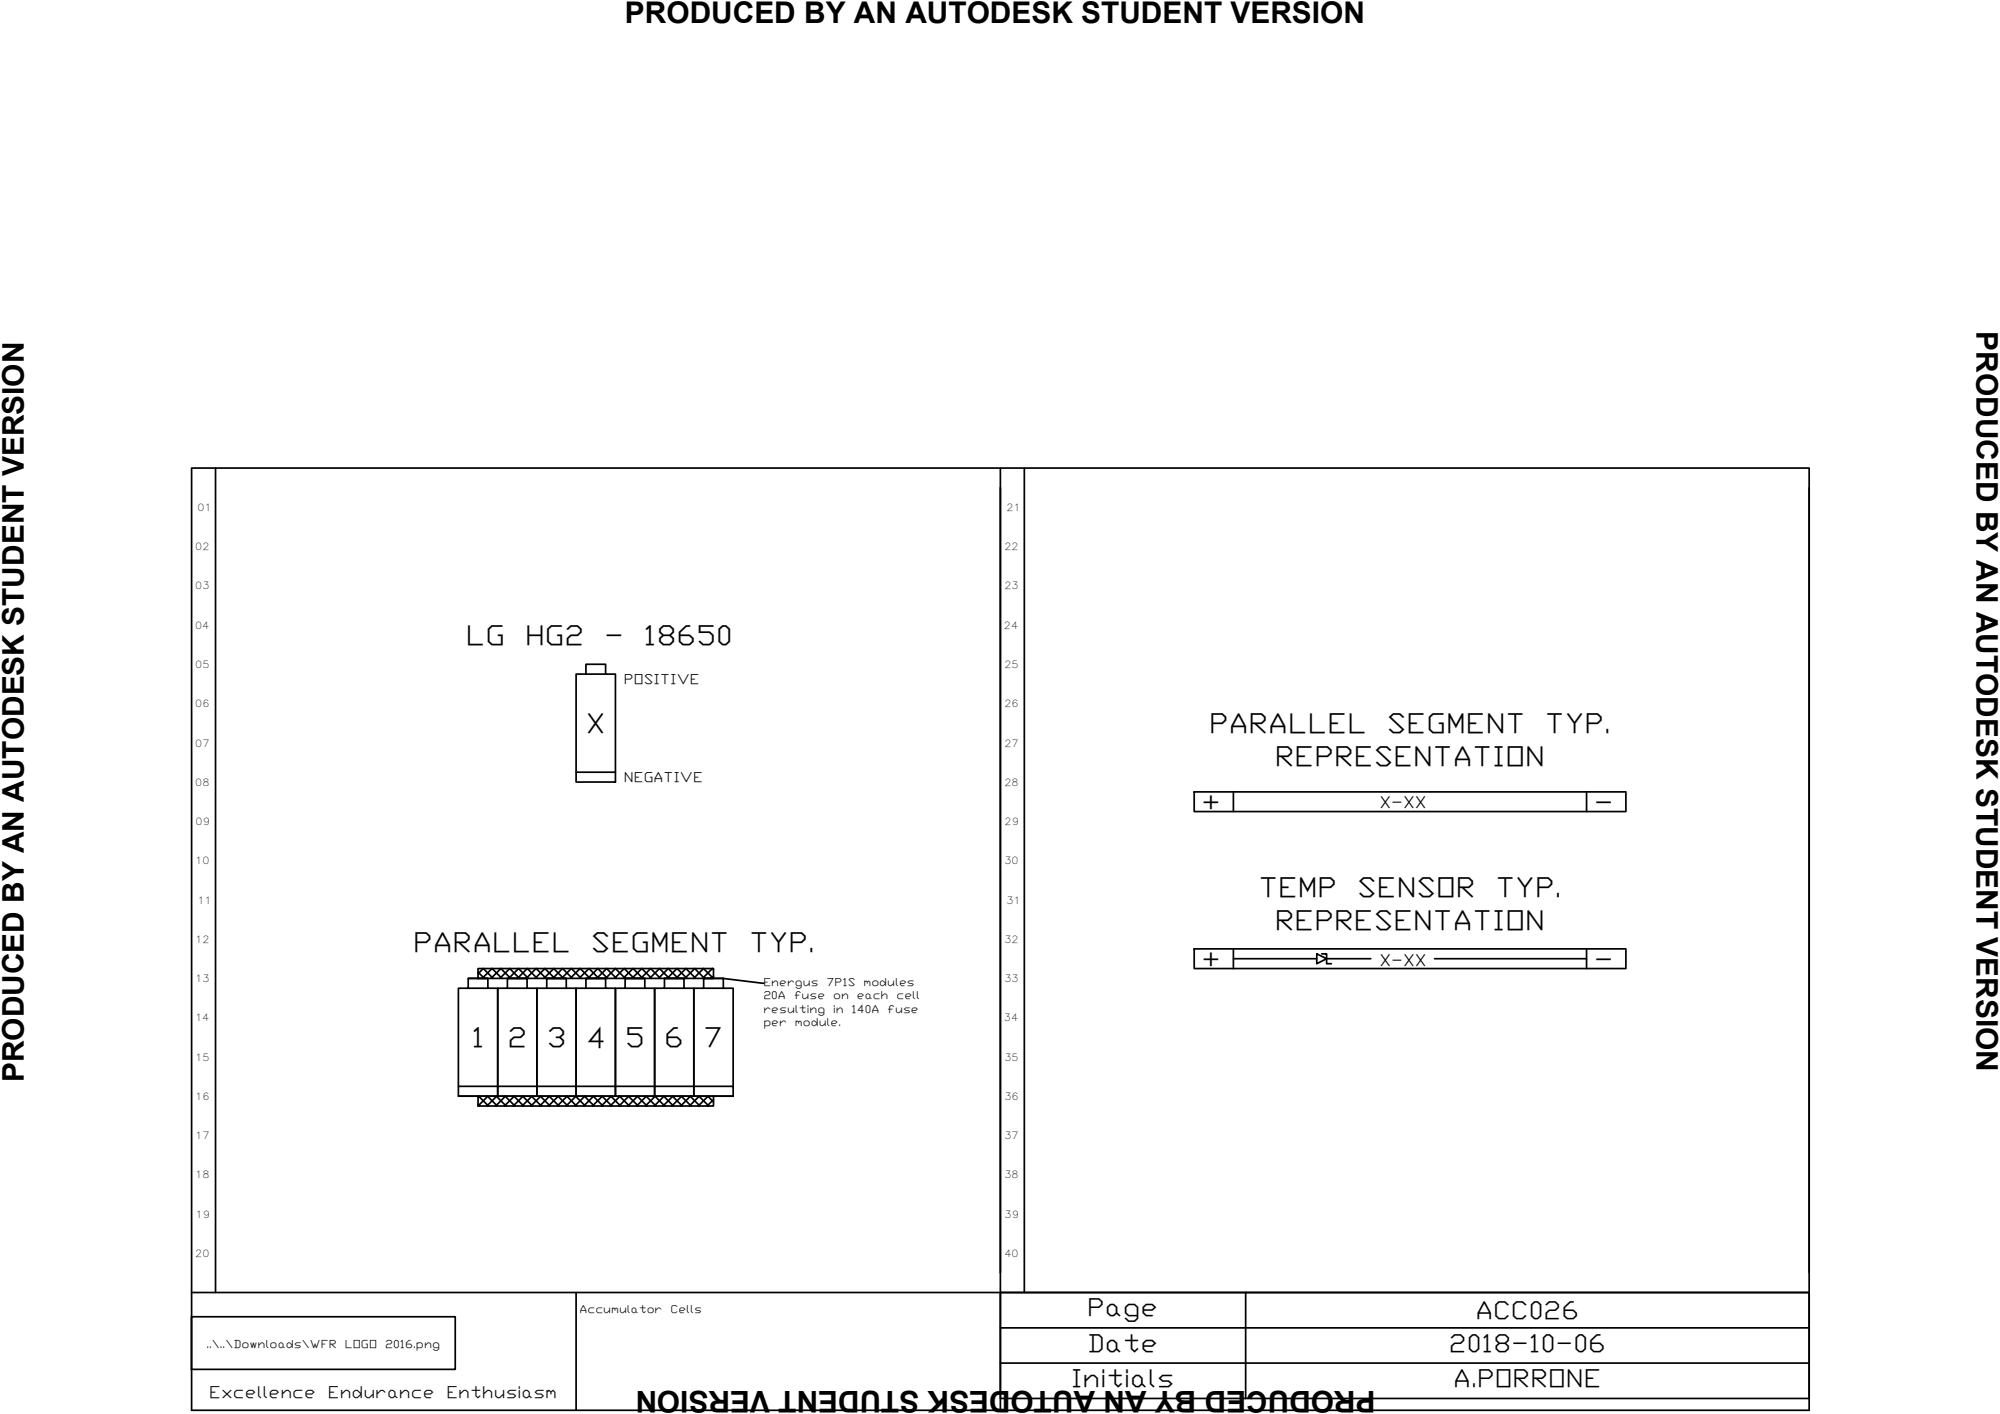
[picture p94: page 1]
Accumulator Cells Excellence Endurance Enthusiasm ..\..\Downloads\WFR LOGO 2016.png; Page; ACC026 Date; 2018-10-06 Initials; A.PORRONE 01 02030405060708091011 121314151617181920; 21 22232425262728293031 323334353637383940 POSITIVE NEGATIVE LG HG2 - 18650 PARALLEL SEGMENT TYP.; PARALLEL SEGMENT TYP. REPRESENTATION +; - TEMP SENSOR TYP. REPRESENTATION X 1; Energus 7P1S modules 20A fuse on each cell resulting in 140A fuse per module.

PRODUCED BY AN AUTODESK STUDENT VERSION

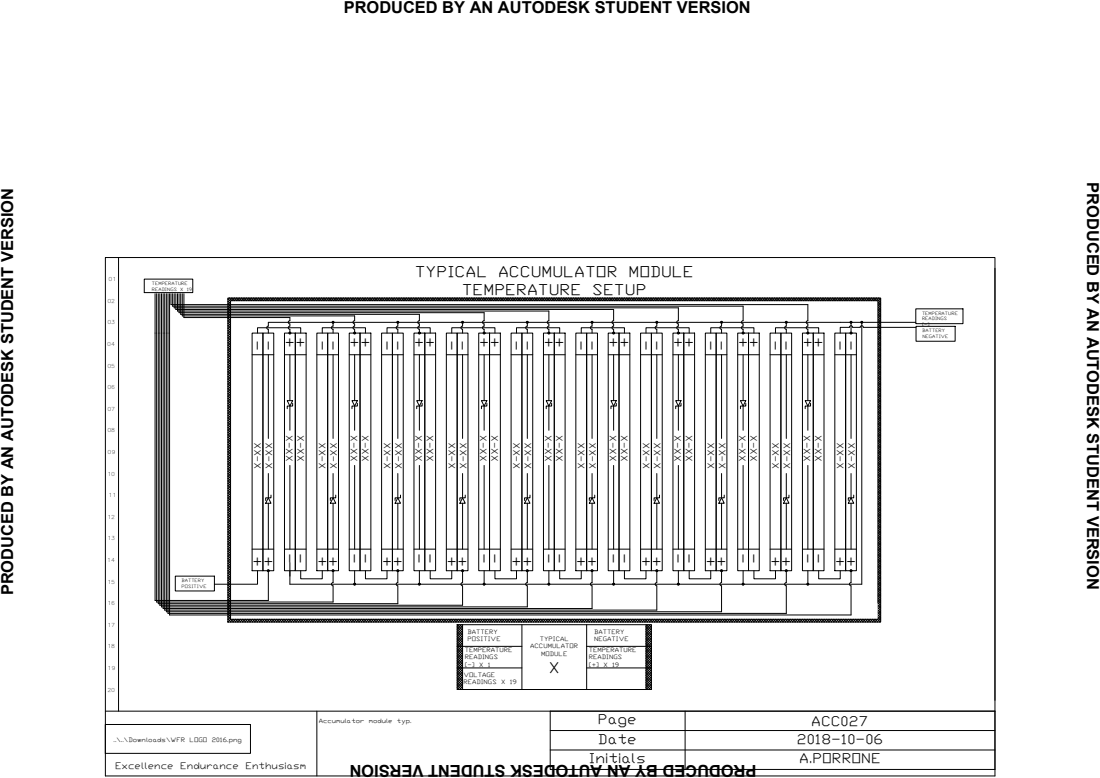
[picture p95: page 2]
Accumulator module typ. Excellence Endurance Enthusiasm ..\..\Downloads\WFR LOGO 2016.png; Page; ACC027 Date; 2018-10-06 Initials; A.PORRONE 01 02030405060708091011 121314151617181920; TYPICAL ACCUMULATOR MODULE TEMPERATURE SETUP TYPICAL ACCUMULATOR MODULE X BATTERY POSITIVE; BATTERY NEGATIVE

PRODUCED BY AN AUTODESK STUDENT VERSION

X-XX + - + - X-XX TEMPERATURE READINGS X 19 TEMPERATURE READINGS [+] X 19 BATTERY POSITIVE TEMPERATURE READINGS [-] X 1 BATTERY NEGATIVE TEMPERATURE READINGS [-] VOLTAGE READINGS X 19

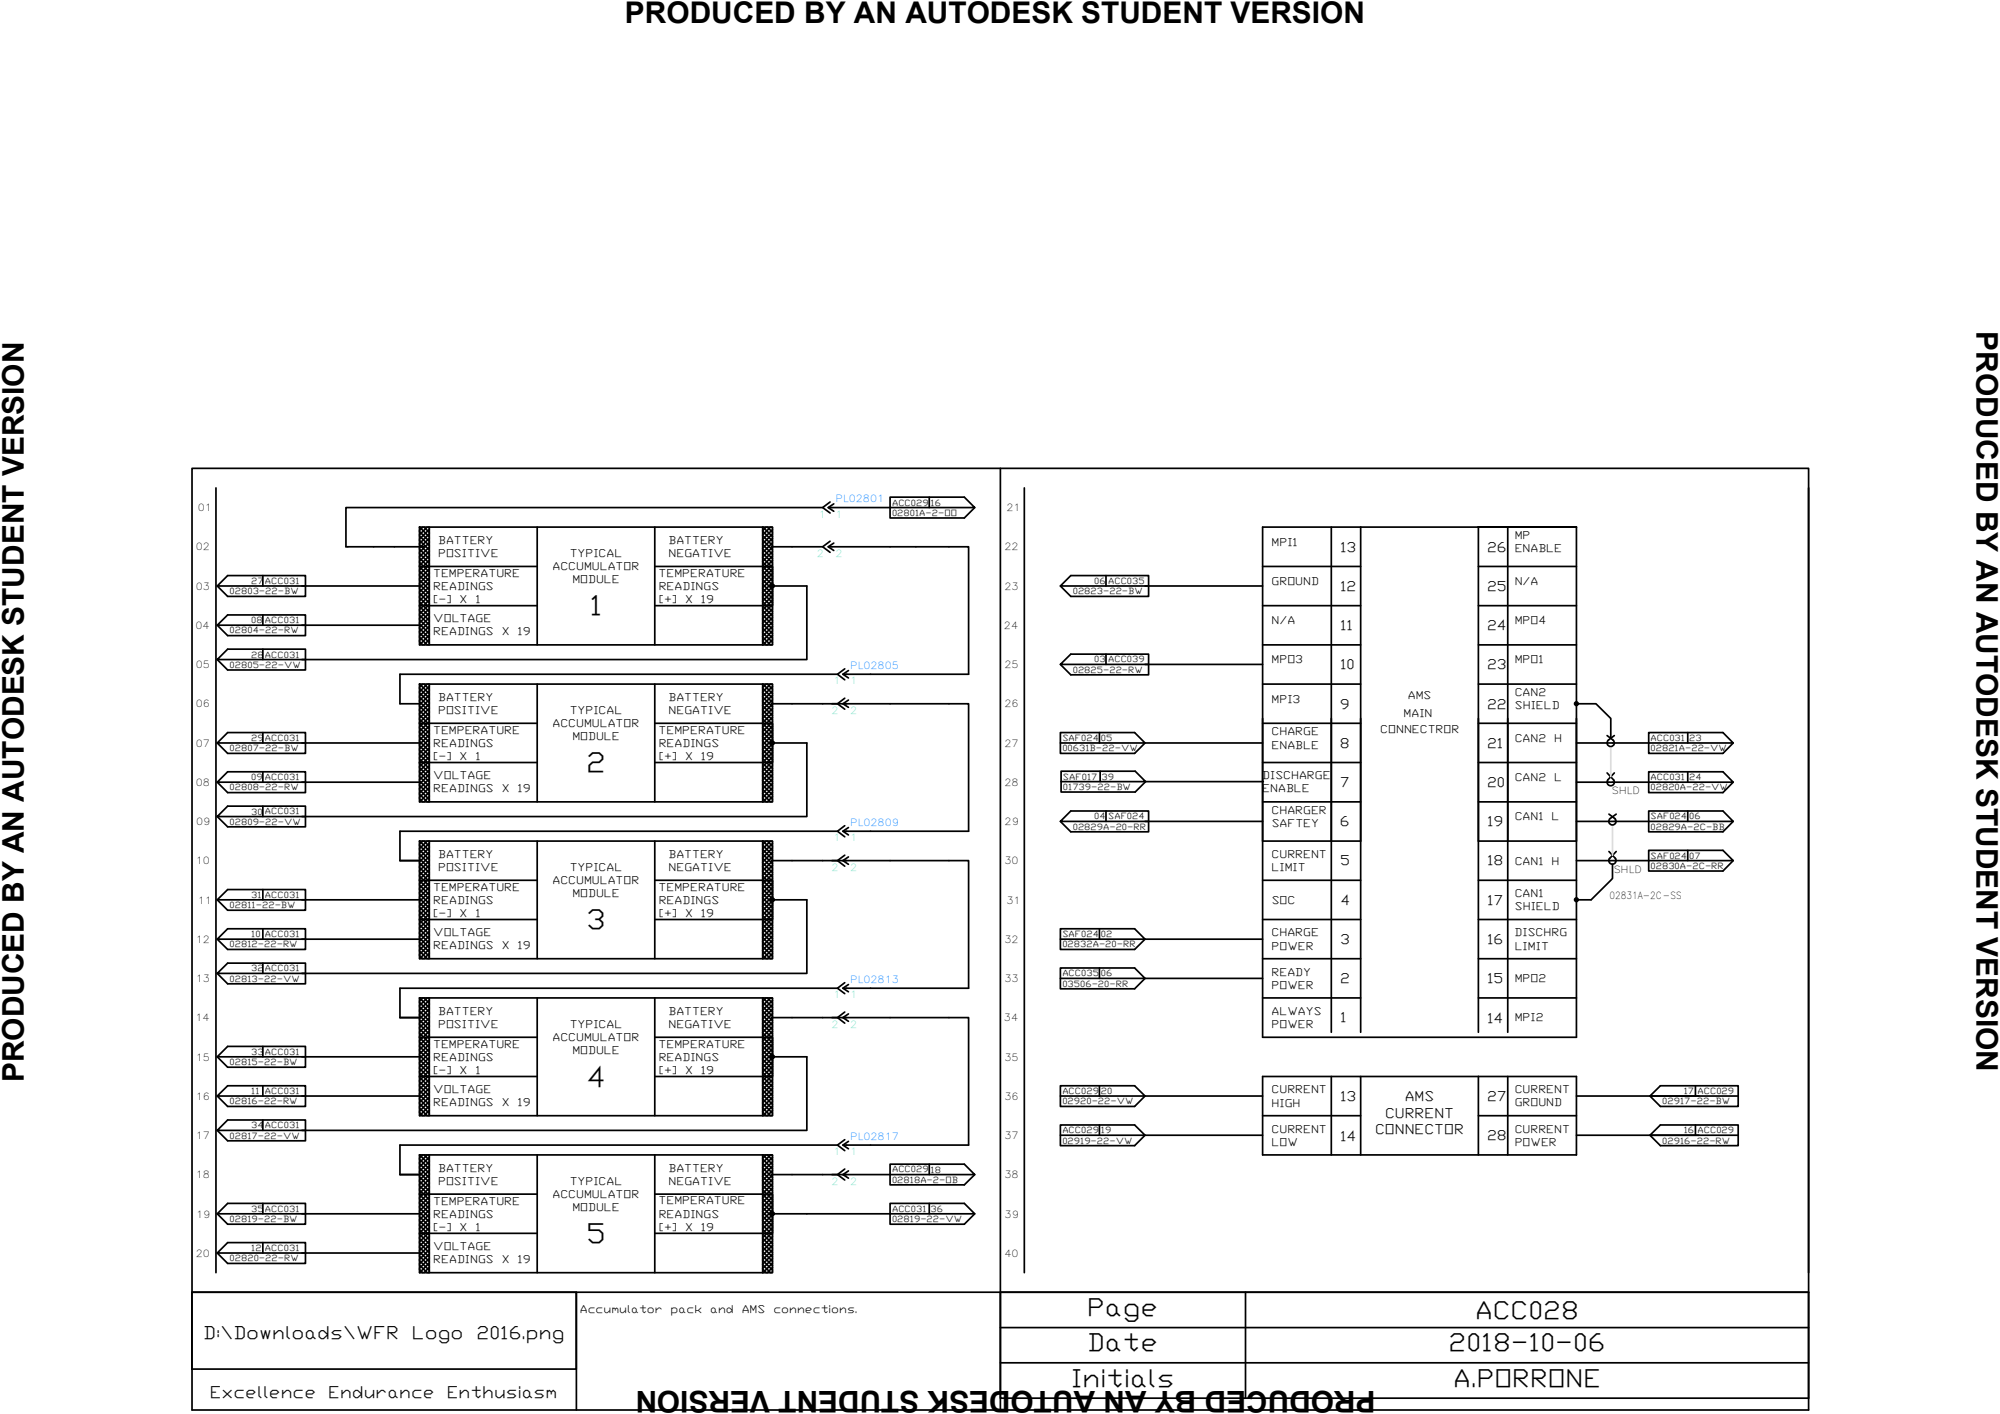
[picture p96: page 3]
Accumulator pack and AMS connections. Excellence Endurance Enthusiasm D:\Downloads\WFR Logo 2016.png; Page; ACC028 Date; 2018-10-06 Initials; A.PORRONE 01 02030405060708091011 121314151617181920; 19 27 ACC031 02803-22-BW; ACC029 02801A-2-OO 16 PL02805 1 1 PL02801 1 1 TYPICAL; 2 2 ACCUMULATOR MODULE 1 BATTERY POSITIVE; BATTERY NEGATIVE TEMPERATURE READINGS [+] X 19 TEMPERATURE READINGS [-] X 1 VOLTAGE READINGS X 19 08 ACC031 02804-22-RW 28 ACC031 02805-22-VW 29 ACC031 02807-22-BW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

PRODUCED BY AN AUTODESK STUDENT VERSION

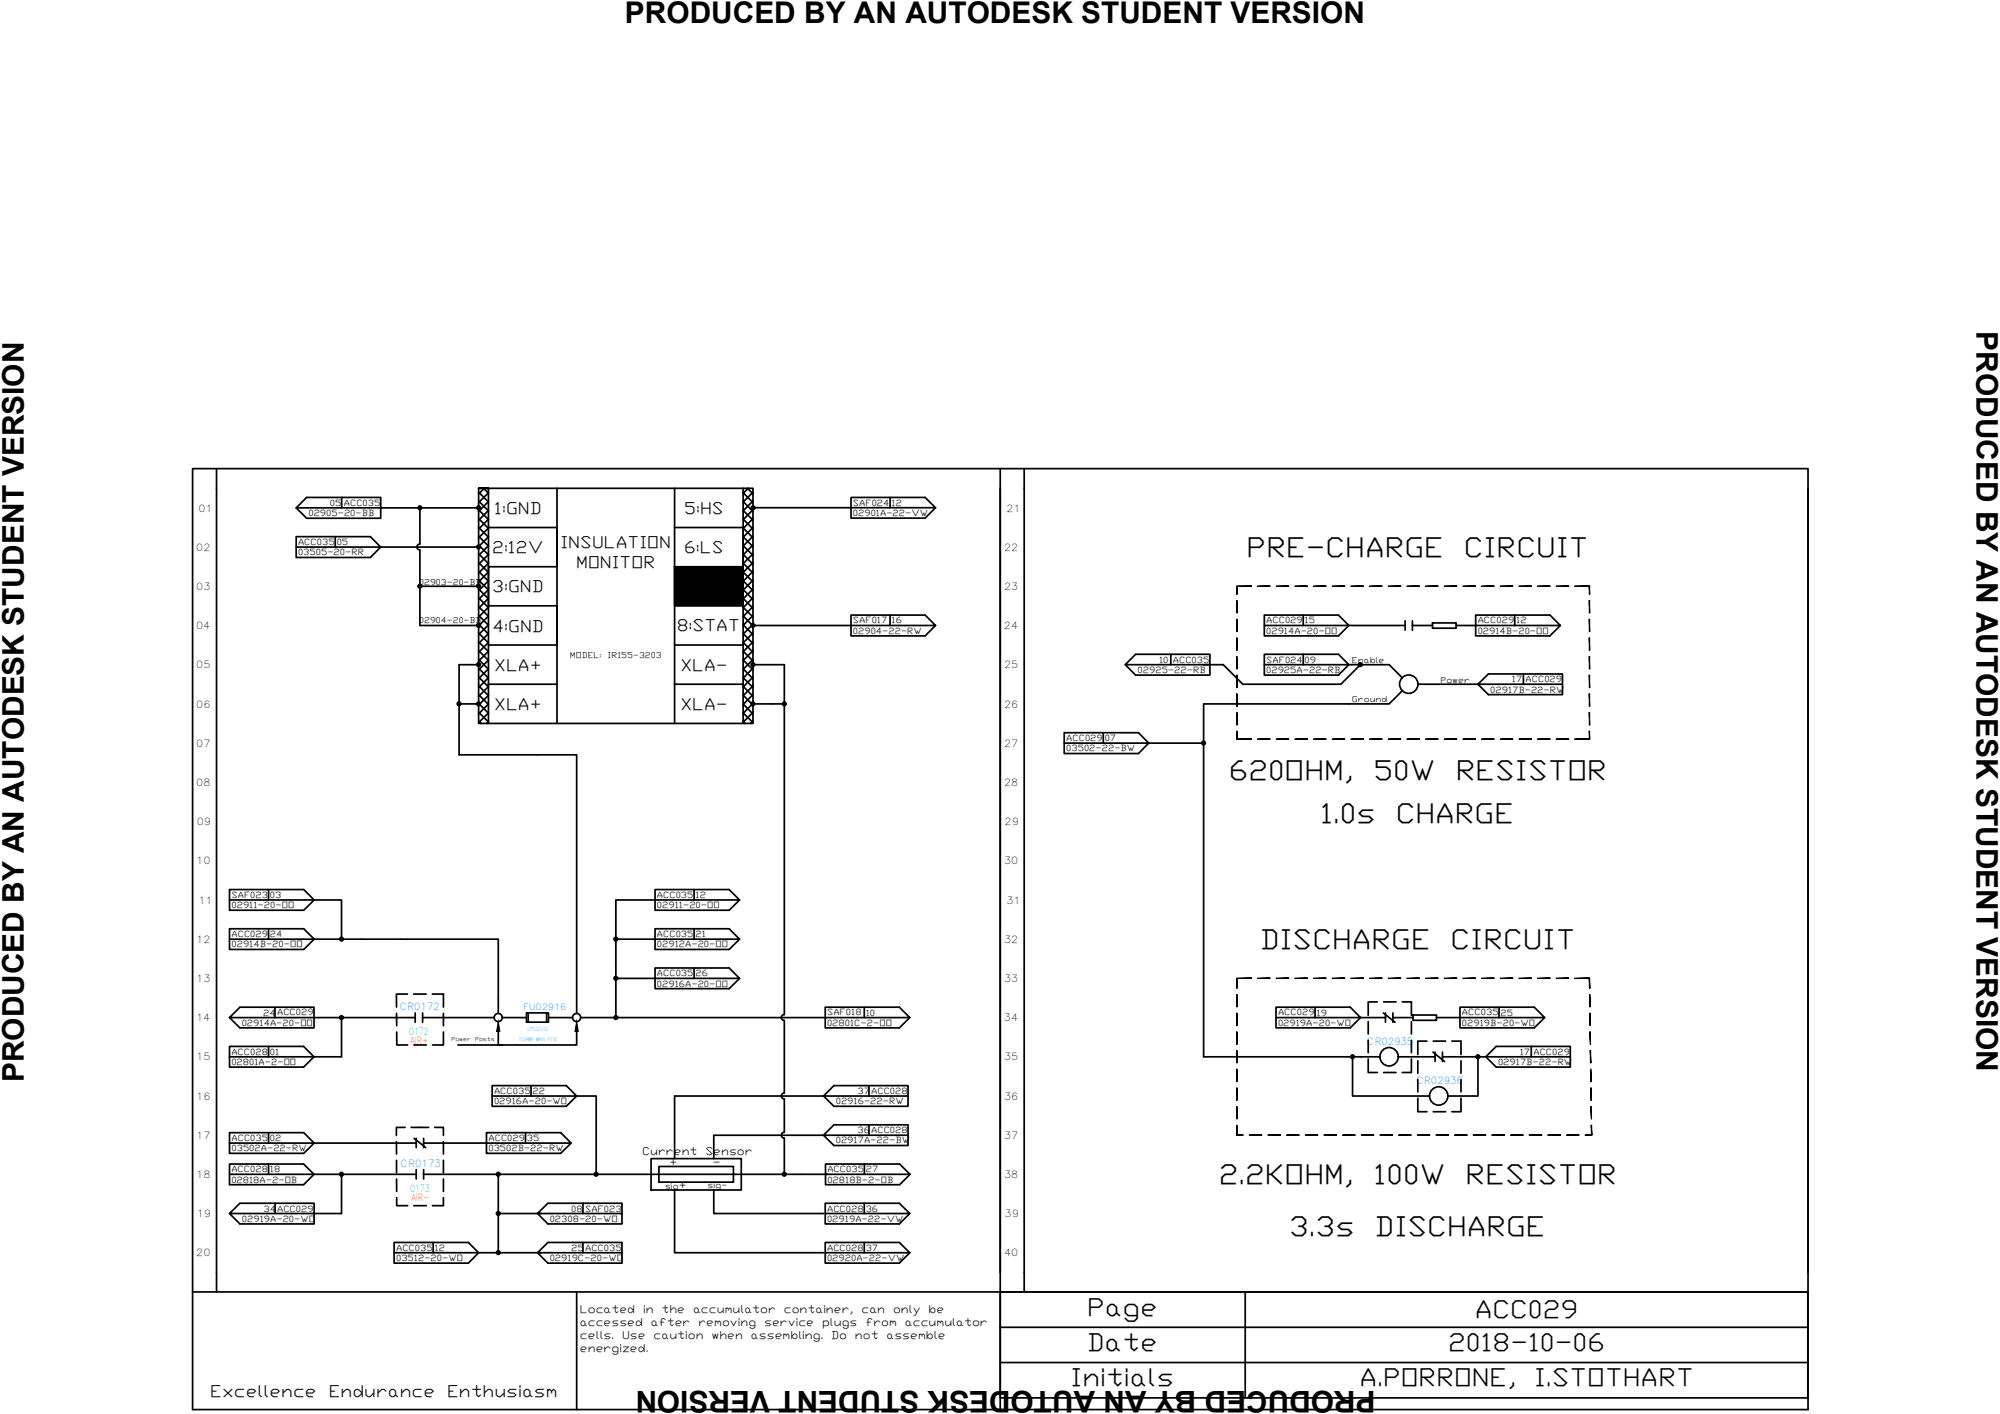
[picture p97: page 4]
Located in the accumulator container, can only be accessed after removing service plugs from accumulator cells. Use caution when assembling. Do not assemble energized. Excellence Endurance Enthusiasm; Page; ACC029 Date; 2018-10-06 Initials; A.PORRONE, I.STOTHART 01 02030405060708091011 121314151617181920; 21 22232425262728293031 323334353637383940 MODEL: IR155-3203 1:GND; 6:LS 3:GND 4:GND; 8:STAT XLA+; INSULATION MONITOR XLA+; XLA- XLA-; SAF017 02904-22-RW 16 SAF024 02901A-22-VW 12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

PRODUCED BY AN AUTODESK STUDENT VERSION

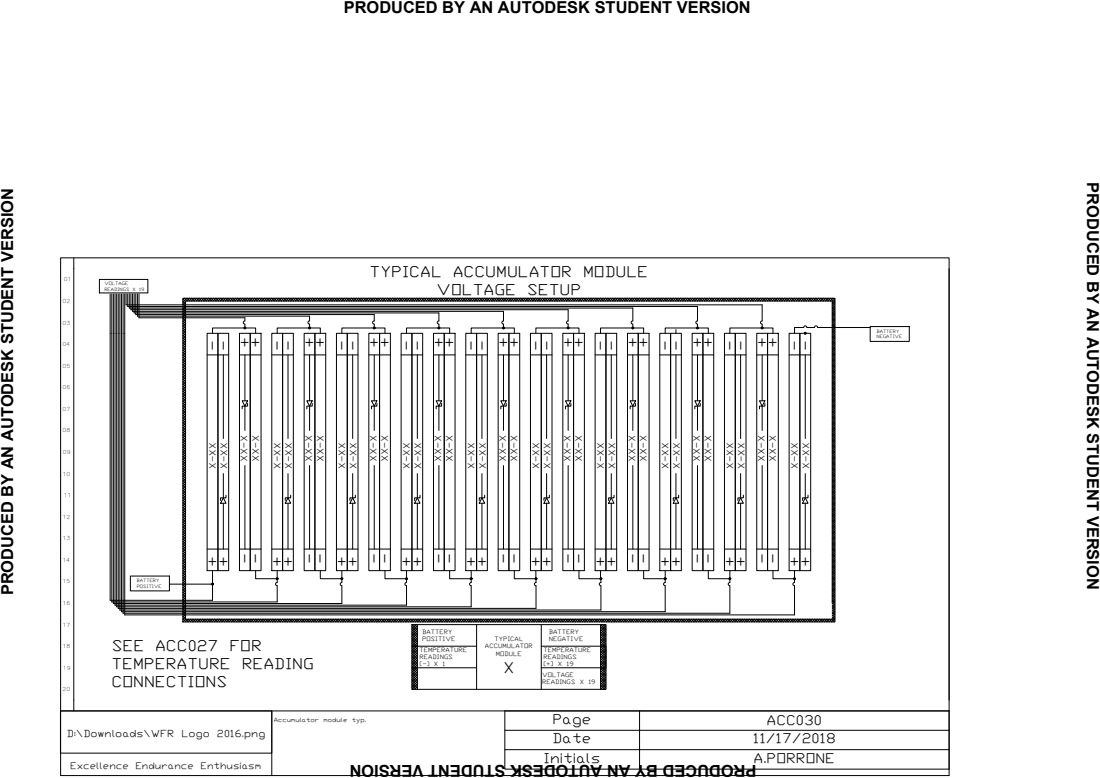
[picture p98: page 5]
Accumulator module typ. Excellence Endurance Enthusiasm D:\Downloads\WFR Logo 2016.png; Page; ACC030 Date; 11/17/2018 Initials; A.PORRONE 01 02030405060708091011 121314151617181920; TYPICAL ACCUMULATOR MODULE VOLTAGE SETUP TYPICAL ACCUMULATOR MODULE X BATTERY POSITIVE; BATTERY NEGATIVE

PRODUCED BY AN AUTODESK STUDENT VERSION

X-XX + - + - X-XX VOLTAGE READINGS X 19 TEMPERATURE READINGS [+] X 19 BATTERY POSITIVE TEMPERATURE READINGS [-] X 1 VOLTAGE READINGS X 19 BATTERY NEGATIVE SEE ACC027 FOR TEMPERATURE READING CONNECTIONS

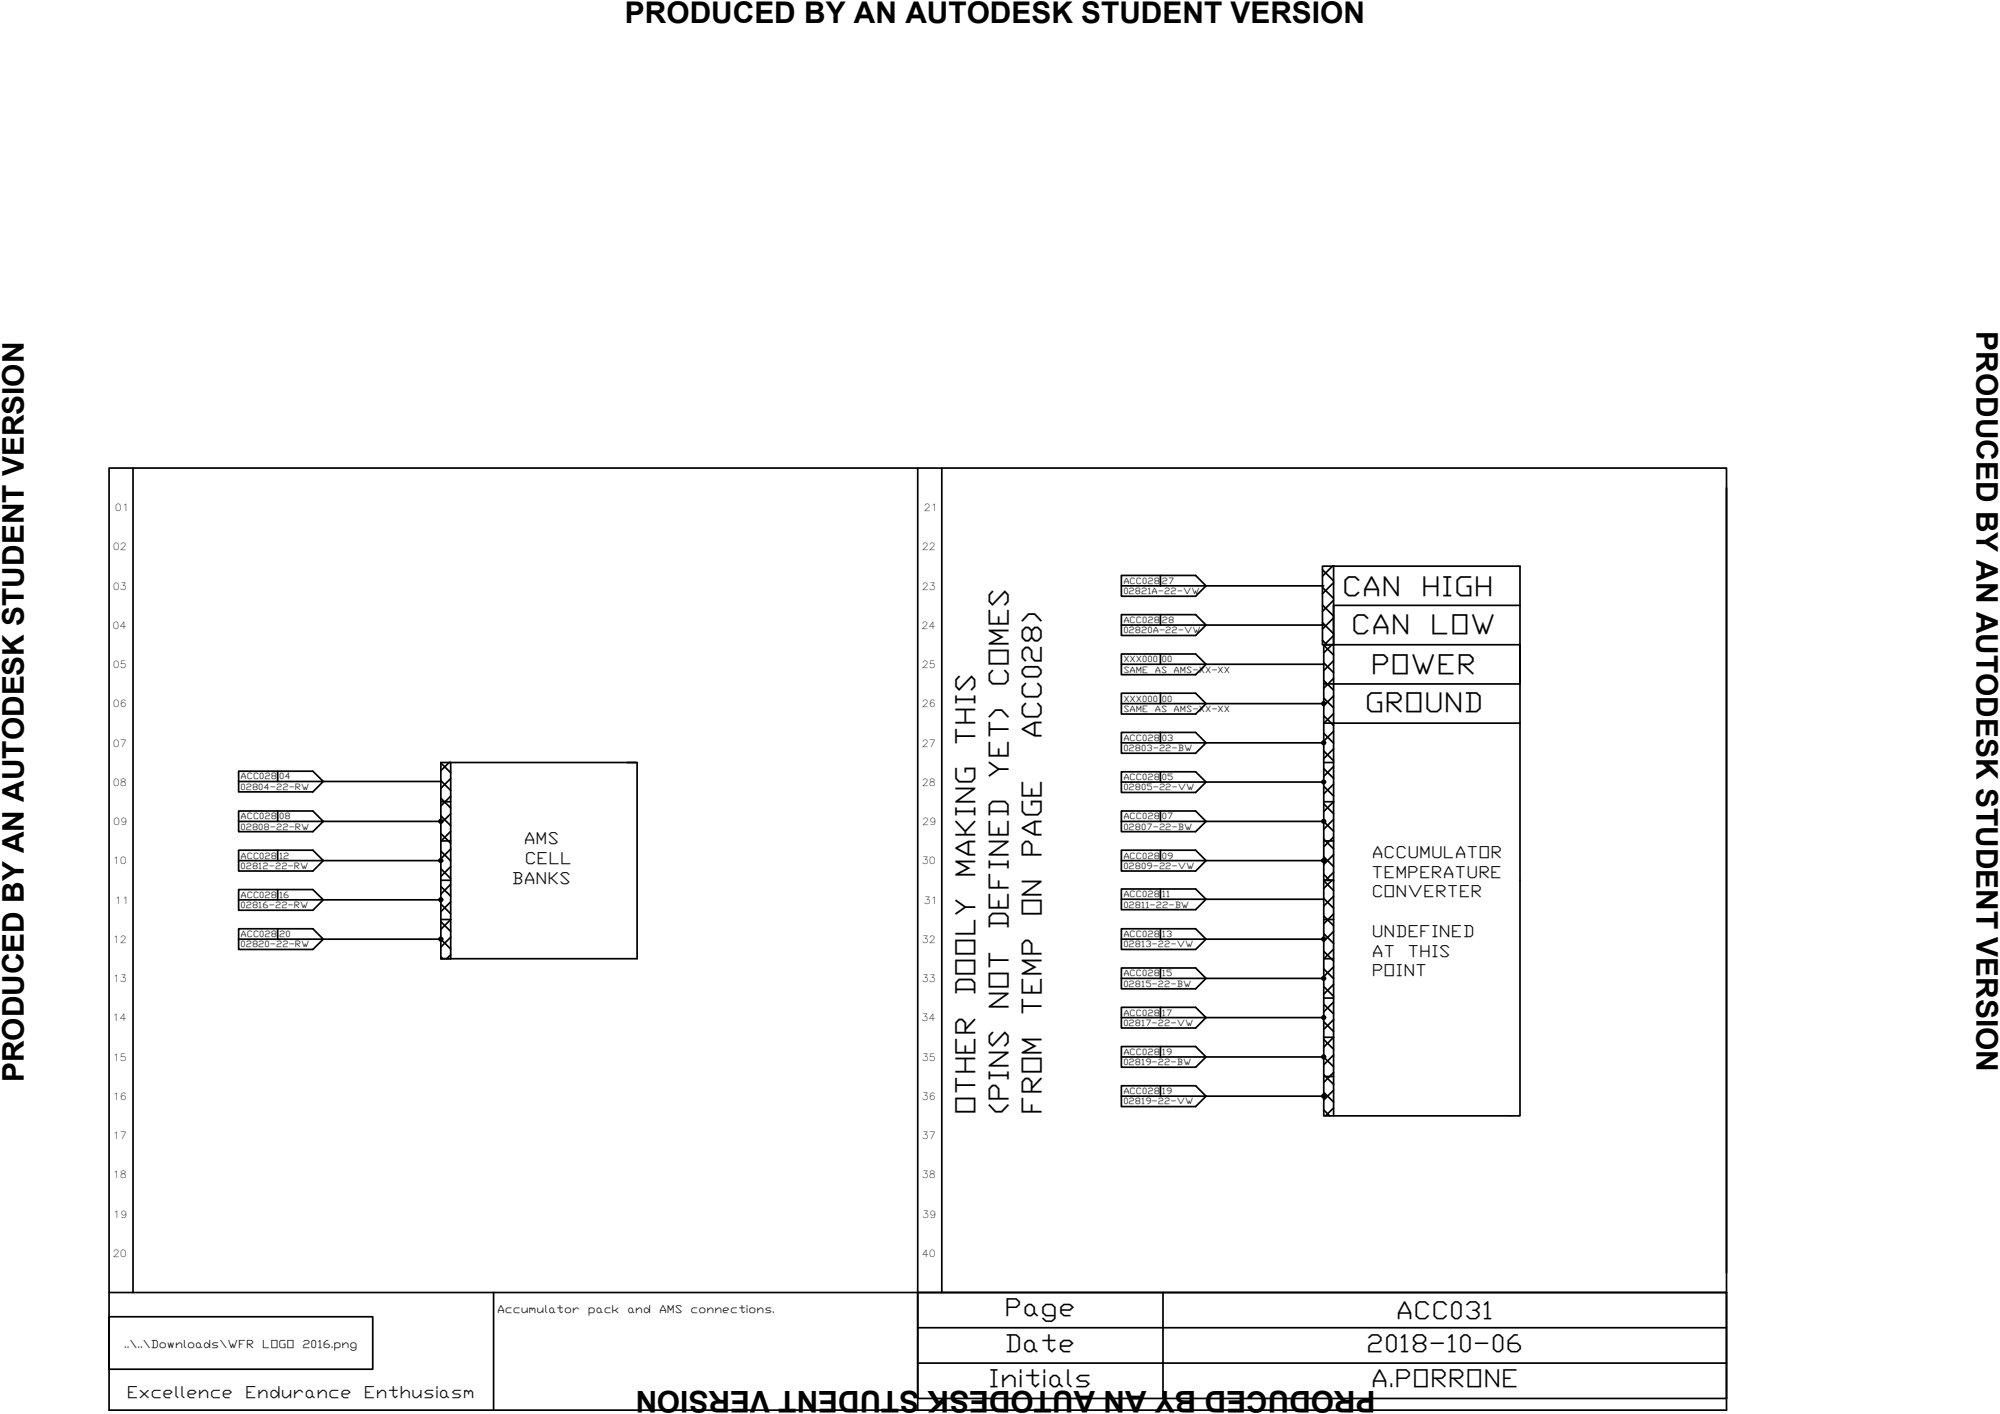
[picture p99: page 6]
Accumulator pack and AMS connections. Excellence Endurance Enthusiasm ..\..\Downloads\WFR LOGO 2016.png; Page; ACC031 Date; 2018-10-06 Initials; A.PORRONE 01 02030405060708091011 121314151617181920; 21 22232425262728293031 323334353637383940 ACC028 02804-22-RW 04; AMS CELL BANKS ACC028 02808-22-RW 08; XXX000 SAME AS AMS-XX-XX 00 ACC028 02803-22-BW 03 ACC028 02805-22-VW 05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

PRODUCED BY AN AUTODESK STUDENT VERSION

FROM TEMP ON PAGE ACC028) ACC028 02807-22-BW 07 ACC028 02809-22-VW 09 ACC028 02811-22-BW 11 ACC028 02813-22-VW 13 ACC028 02815-22-BW 15 ACC028 02817-22-VW 17 ACC028 02819-22-BW 19 ACC028 02819-22-VW 19 PRODUCED BY AN AUTODESK STUDENT VERSION PRODUCED BY AN AUTODESK STUDENT VERSION

(PINS NOT DEFINED YET) COMES

OTHER DOOLY MAKING THIS

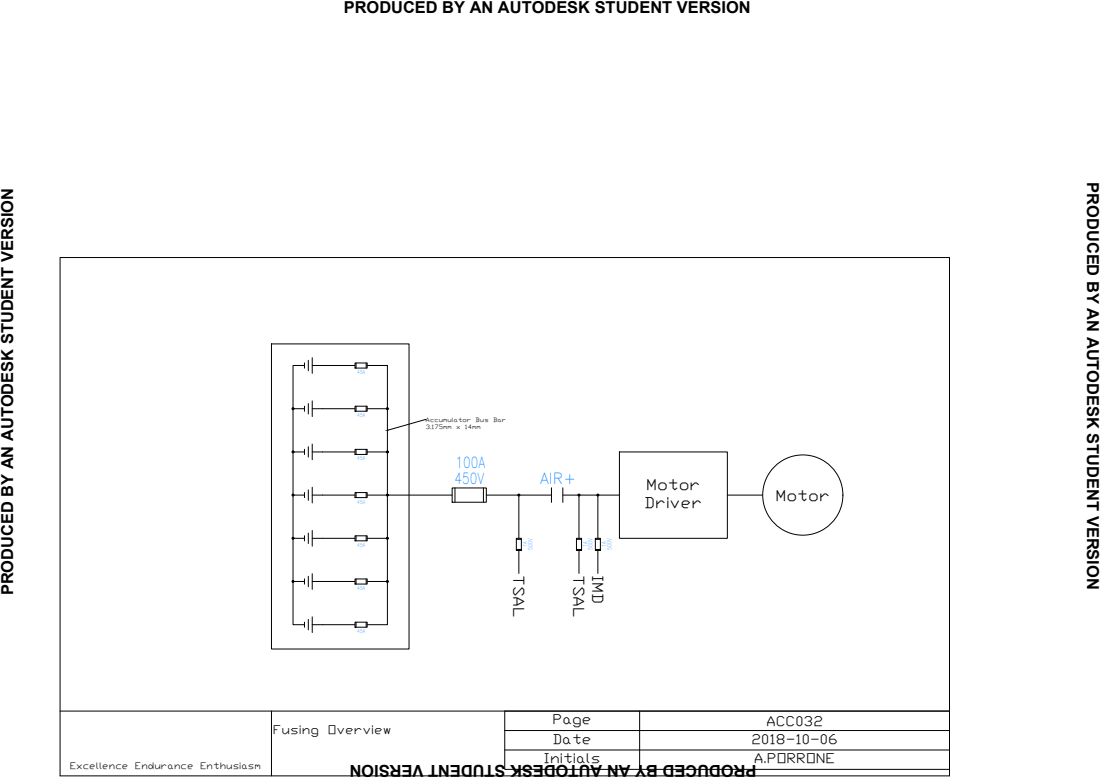
[picture p100: page 7]
Fusing Overview Excellence Endurance Enthusiasm; Page; ACC032 Date; 2018-10-06 Initials; A.PORRONE 45A 45A 45A 45A 45A 45A 45A; AIR+; Motor Driver; Motor Accumulator Bus Bar 3.175mm x 14mm; 1A 500V TSAL; IMD 1A 500V TSAL

PRODUCED BY AN AUTODESK STUDENT VERSION

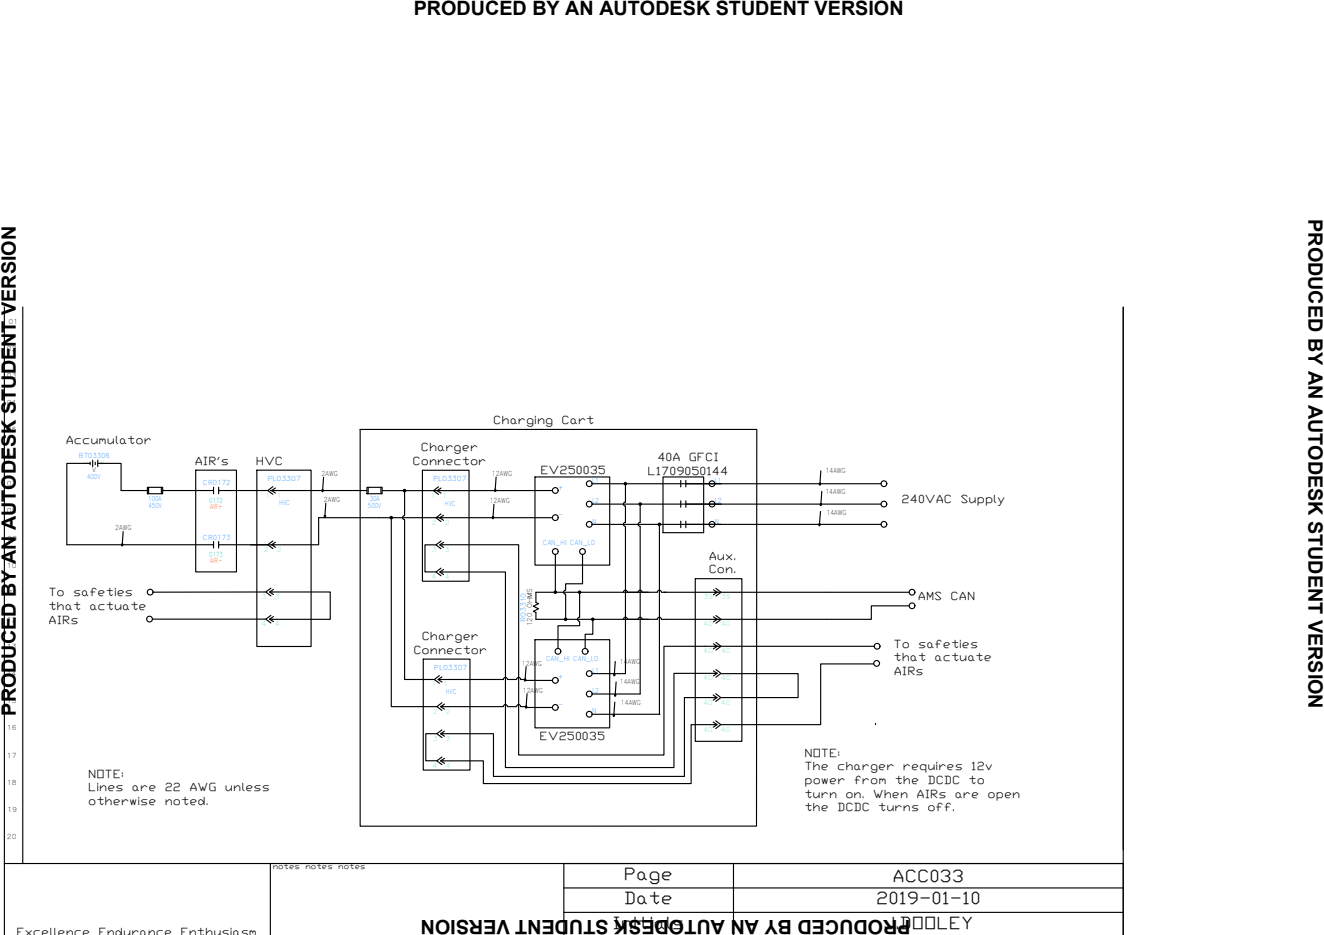
[picture p101: page 8]
notes notes notes Excellence Endurance Enthusiasm; Page; ACC033 Date; 2019-01-10 Initials; J.DOOLEY 01 02030405060708091011 121314151617181920; 0172 AIR+ CR0172 0173 AIR- CR0173; HVC PL03307 1 1 2 2; L1L2N Charging Cart; L1L2N AIR's; HVC Accumulator; CAN_HI CAN_LO; AMS CAN 100A 450V; 2AWG 2AWG; 240VAC Supply EV250035 +-; L1L2N CAN_HI CAN_LO

PRODUCED BY AN AUTODESK STUDENT VERSION

120 OHMS R03310 EV250035 40A GFCI L1709050144 4 4 To safeties 3 3 that actuate AIRs 30A 500V HVC PL03307 1 1 2 2 Charger Connector 4 4 3 3 40 40 40 40 Aux. Con. To safeties that actuate AIRs NOTE: The charger requires 12v power from the DCDC to turn on. When AIRs are open the DCDC turns off. 14AWG 14AWG 14AWG HVC PL03307 1 1 2 2 Charger Connector 4 4 3 3 40 40 40 40 12AWG 12AWG 12AWG 12AWG 2AWG 14AWG 14AWG 14AWG NOTE: Lines are 22 AWG unless otherwise noted.

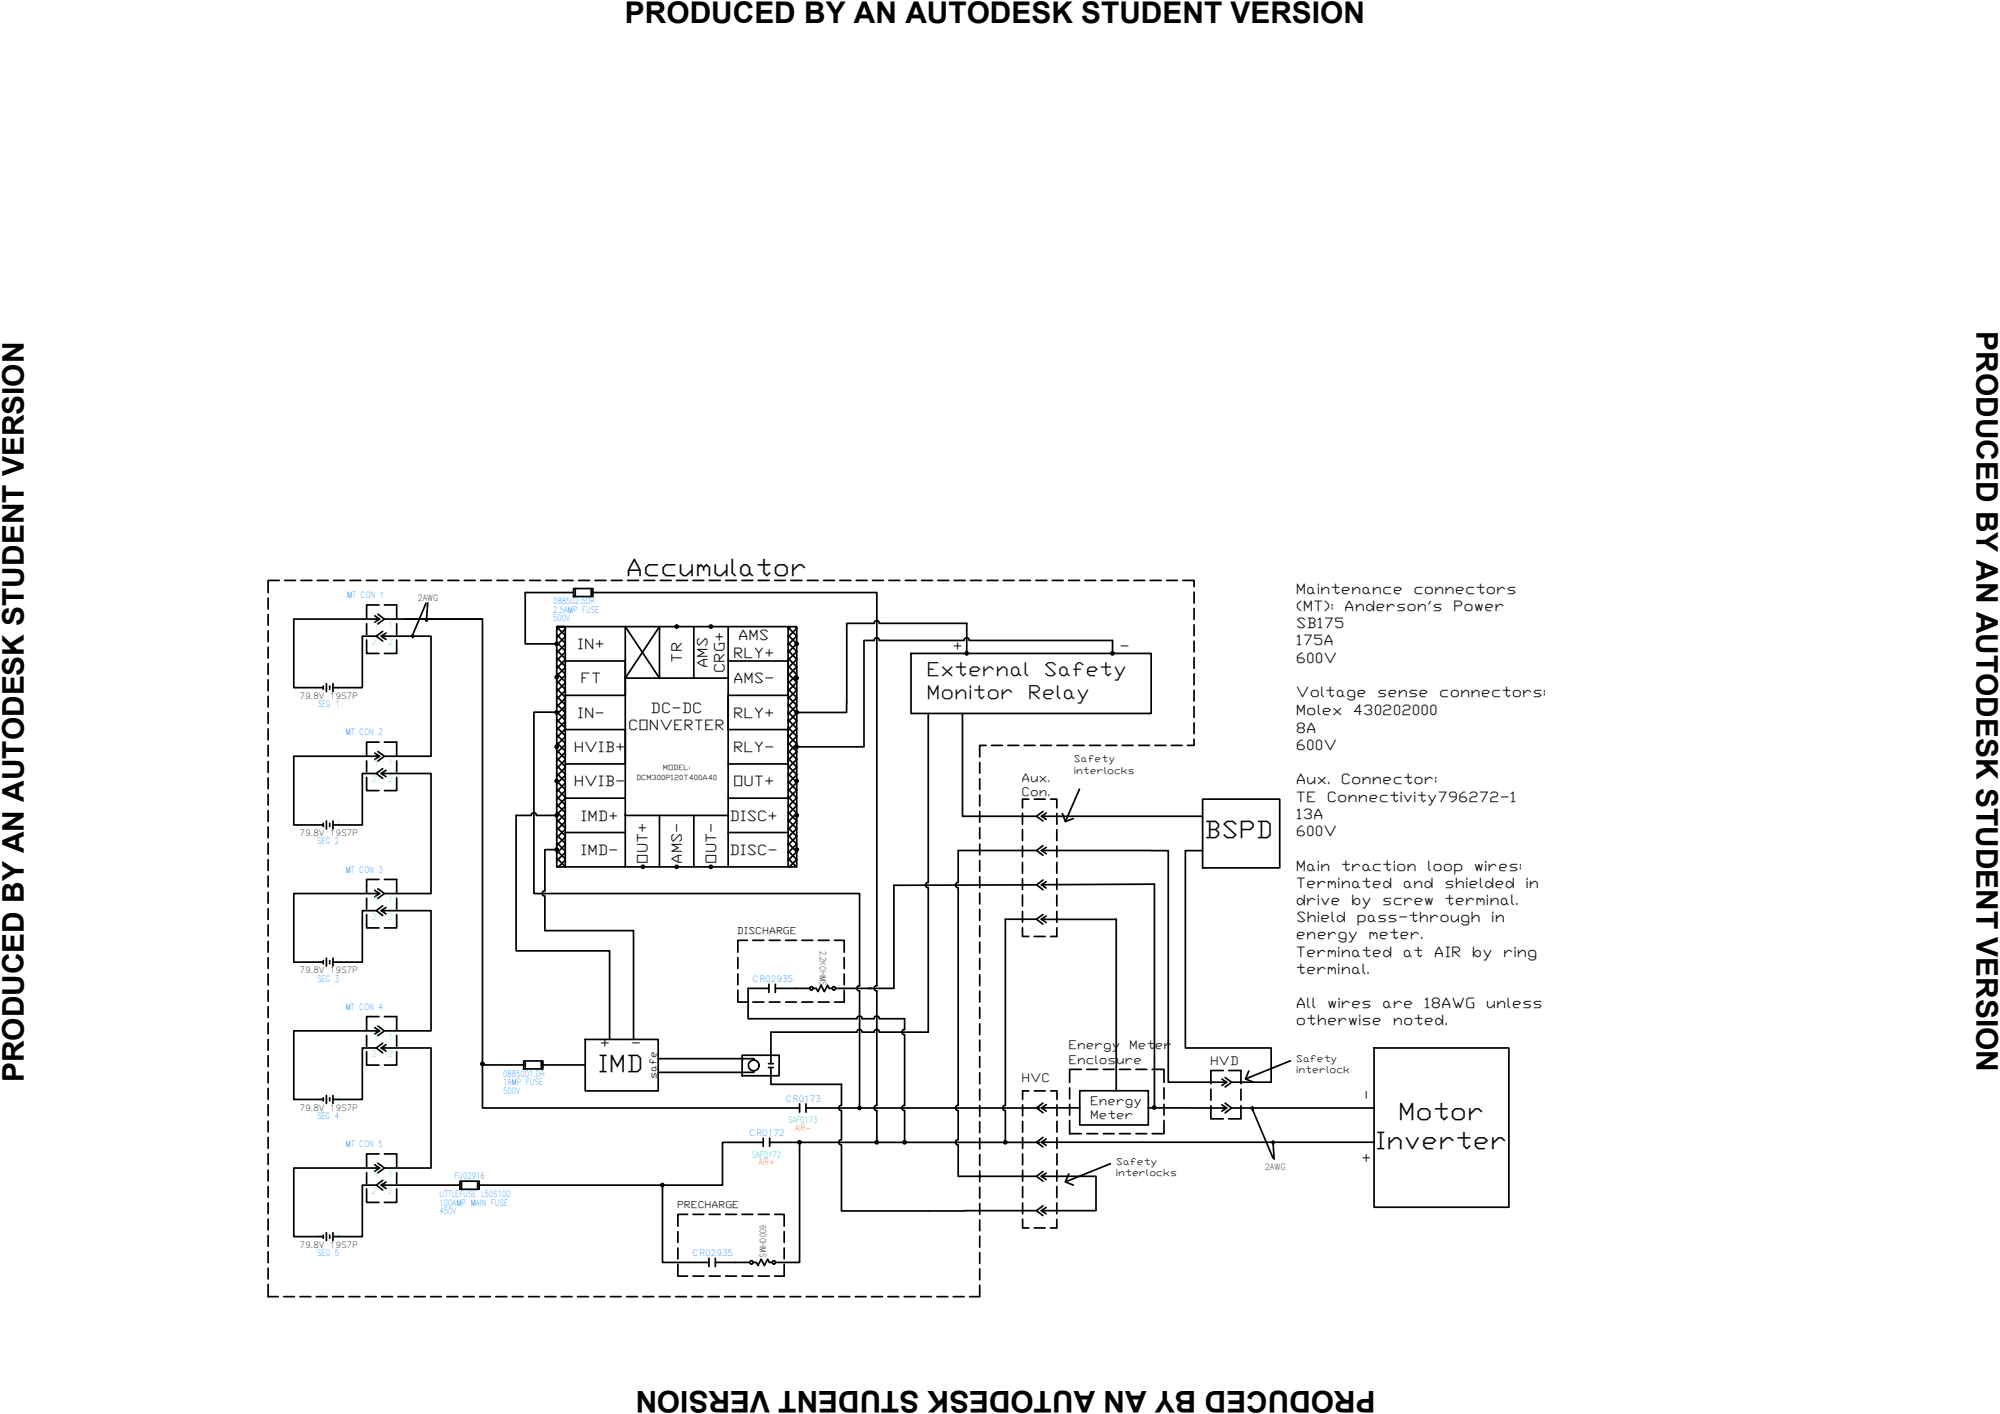
[picture p102: page 9]
SEG 1 79.8V 19S7P -; + SEG 2 79.8V 19S7P -; + SEG 3 79.8V 19S7P -; + SEG 4 79.8V 19S7P -; + SEG 5 79.8V 19S7P -; + MT CON 1 1; 2 MT CON 2 1; 2 MT CON 3 1; 2 MT CON 4 1; 2 MT CON 5 1 1 2; LITTLEFUSE L50S100 100AMP MAIN FUSE 450VFU02916; SAF0173 AIR- CR0173 SAF0172 AIR+ CR0172; Energy Meter HVC Aux. Con. IMD

PRODUCED BY AN AUTODESK STUDENT VERSION

safe Accumulator + - 0885001.DR 1AMP FUSE 500V 088502.5DR 2.5AMP FUSE 500V Energy Meter Enclosure + -

600OHMS PRECHARGE Maintenance connectors (MT): Anderson's Power SB175 175A 600V Voltage sense connectors: Molex 430202000 8A600V Aux. Connector: TE Connectivity796272-1 13A 600V Main traction loop wires: Terminated and shielded in drive by screw terminal. Shield pass-through in energy meter. Terminated at AIR by ring terminal. All wires are 18AWG unless otherwise noted. 2AWG 2AWG Motor Inverter BSPD External Safety Monitor Relay MODEL: DCM300P120T400A40 IN+ AMS RLY+ AMS- IMD+ FT

OUT- DISC- HVIB+ HVIB- OUT+ DISC+ IMD- RLY+ RLY- + -

OUT+ IN- DC-DC CONVERTER

2.2KOHMS DISCHARGE Safety interlocks Safety interlocks Safety interlock HVD CR02935

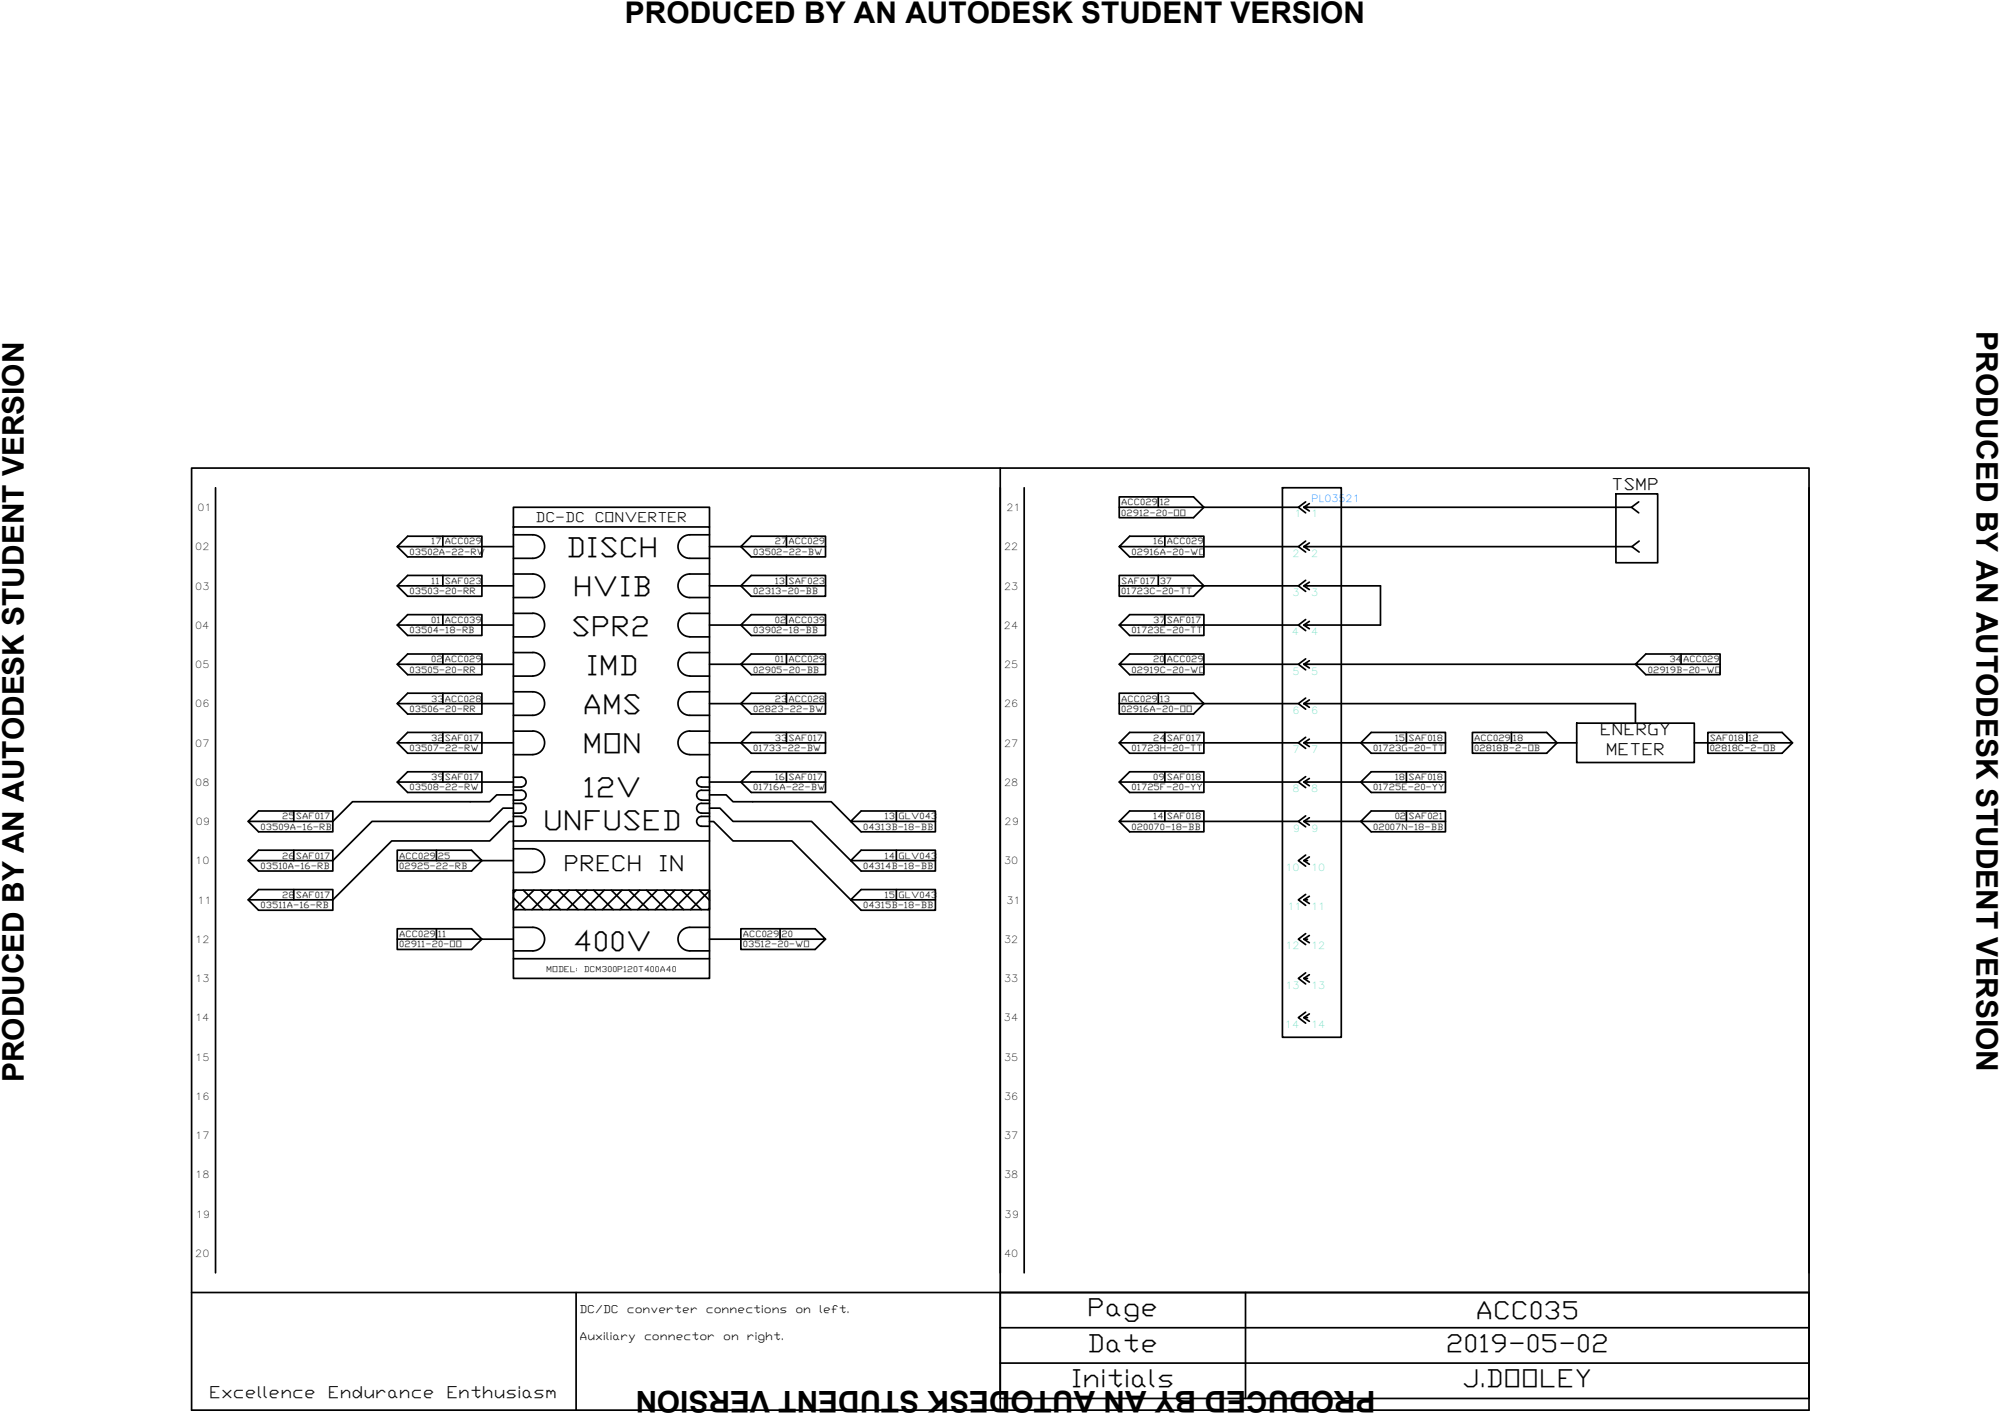
[picture p103: page 10]
Excellence Endurance Enthusiasm; Page; ACC035 Date; 2019-05-02 Initials; J.DOOLEY 01; MODEL: DCM300P120T400A40 DC-DC CONVERTER DISCH HVIB SPR2 IMD AMS MON 400V 12V UNFUSED PRECH IN; 23ACC028 02823-22-BW 16; SAF017 01716A-22-BW 11; SAF023 03503-20-RR 02 ACC029 03505-20-RR 33ACC028 03506-20-RR; ACC029 02905-20-BB ACC029 02925-22-RB 25 ACC029 02911-20-OO 11; ACC029 03512-20-WO 20; 14 DC/DC converter connections on left. Auxiliary connector on right.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

PRODUCED BY AN AUTODESK STUDENT VERSION

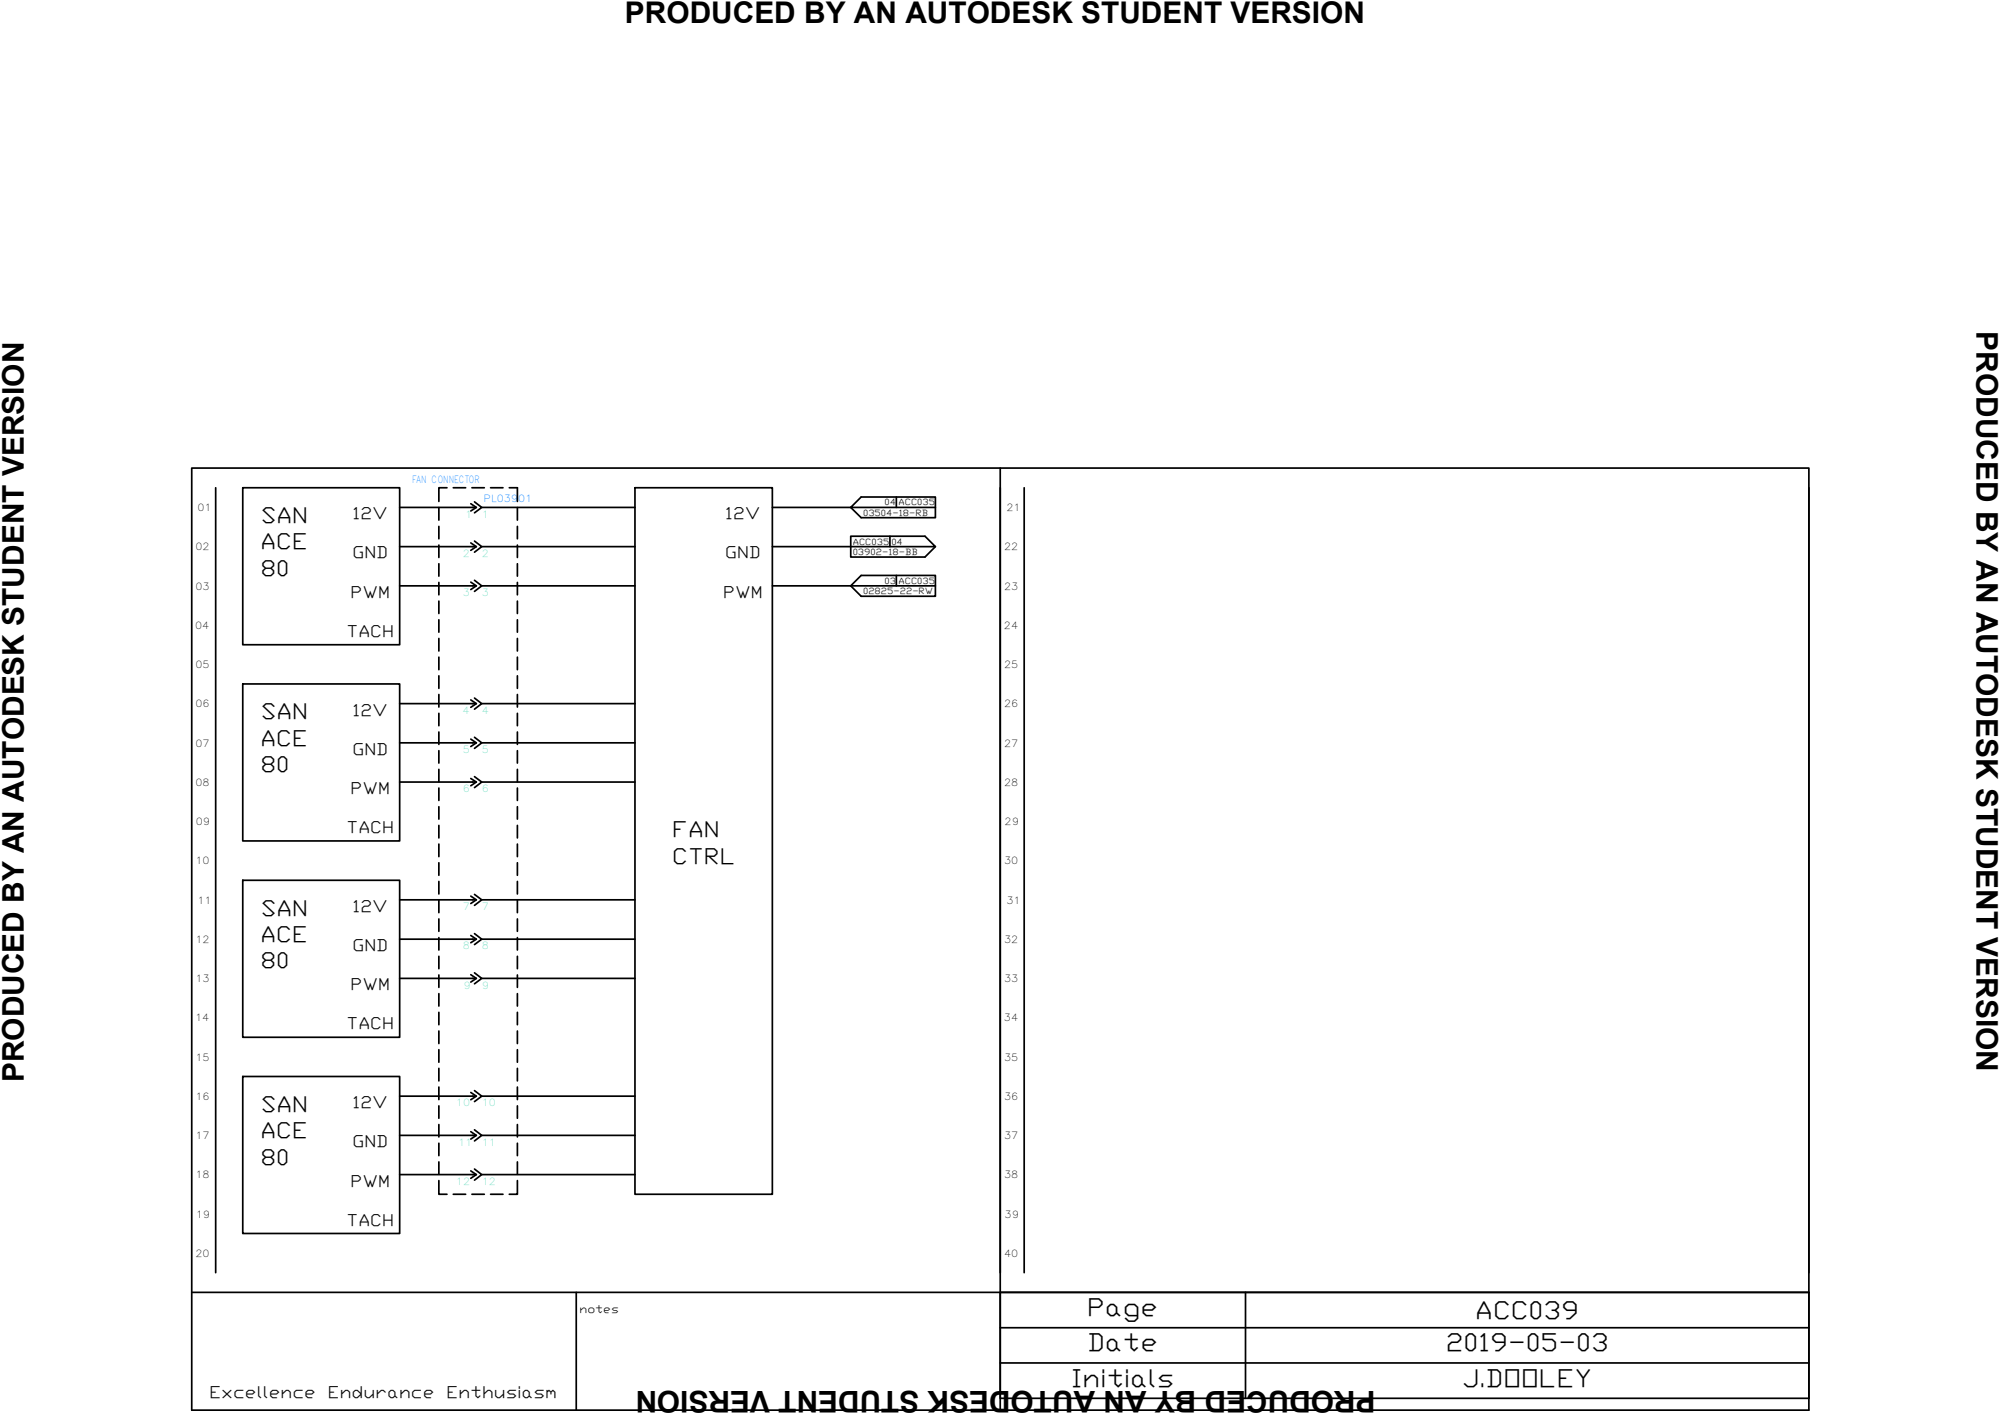
[picture p104: page 11]
notes Excellence Endurance Enthusiasm; Page; ACC039 Date; 2019-05-03 Initials; J.DOOLEY 01; 12V GND PWM TACH SAN ACE 80; FAN CTRL12V GND PWM FAN CONNECTOR PL03901 1 1 2 2 3 3 4; 03 ACC035 02825-22-RW 04 ACC035 03504-18-RB ACC035 03902-18-BB 04

PRODUCED BY AN AUTODESK STUDENT VERSION
