andrewrichardr/WFR2020/2019/HV 2019.pdf

Accumulator Cells Excellence Endurance Enthusiasm ..\..\Downloads\WFR LOGO 2016.png; Page; ACC026 Date; 2018-10-06 Initials; A.PORRONE 01 02030405060708091011 121314151617181920; 21 22232425262728293031 323334353637383940 POSITIVE NEGATIVE LG HG2 - 18650 PARALLEL SEGMENT TYP.; PARALLEL SEGMENT TYP. REPRESENTATION +; - TEMP SENSOR TYP. REPRESENTATION X 1; Energus 7P1S modules 20A fuse on each cell resulting in 140A fuse per module.

PRODUCED BY AN AUTODESK STUDENT VERSION

Accumulator module typ. Excellence Endurance Enthusiasm ..\..\Downloads\WFR LOGO 2016.png; Page; ACC027 Date; 2018-10-06 Initials; A.PORRONE 01 02030405060708091011 121314151617181920; TYPICAL ACCUMULATOR MODULE TEMPERATURE SETUP TYPICAL ACCUMULATOR MODULE X BATTERY POSITIVE; BATTERY NEGATIVE

PRODUCED BY AN AUTODESK STUDENT VERSION

X-XX + - + - X-XX TEMPERATURE READINGS X 19 TEMPERATURE READINGS [+] X 19 BATTERY POSITIVE TEMPERATURE READINGS [-] X 1 BATTERY NEGATIVE TEMPERATURE READINGS [-] VOLTAGE READINGS X 19

Accumulator pack and AMS connections. Excellence Endurance Enthusiasm D:\Downloads\WFR Logo 2016.png; Page; ACC028 Date; 2018-10-06 Initials; A.PORRONE 01 02030405060708091011 121314151617181920; 19 27 ACC031 02803-22-BW; ACC029 02801A-2-OO 16 PL02805 1 1 PL02801 1 1 TYPICAL; 2 2 ACCUMULATOR MODULE 1 BATTERY POSITIVE; BATTERY NEGATIVE TEMPERATURE READINGS [+] X 19 TEMPERATURE READINGS [-] X 1 VOLTAGE READINGS X 19 08 ACC031 02804-22-RW 28 ACC031 02805-22-VW 29 ACC031 02807-22-BW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

PRODUCED BY AN AUTODESK STUDENT VERSION

Located in the accumulator container, can only be accessed after removing service plugs from accumulator cells. Use caution when assembling. Do not assemble energized. Excellence Endurance Enthusiasm; Page; ACC029 Date; 2018-10-06 Initials; A.PORRONE, I.STOTHART 01 02030405060708091011 121314151617181920; 21 22232425262728293031 323334353637383940 MODEL: IR155-3203 1:GND; 6:LS 3:GND 4:GND; 8:STAT XLA+; INSULATION MONITOR XLA+; XLA- XLA-; SAF017 02904-22-RW 16 SAF024 02901A-22-VW 12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

PRODUCED BY AN AUTODESK STUDENT VERSION

Accumulator module typ. Excellence Endurance Enthusiasm D:\Downloads\WFR Logo 2016.png; Page; ACC030 Date; 11/17/2018 Initials; A.PORRONE 01 02030405060708091011 121314151617181920; TYPICAL ACCUMULATOR MODULE VOLTAGE SETUP TYPICAL ACCUMULATOR MODULE X BATTERY POSITIVE; BATTERY NEGATIVE

PRODUCED BY AN AUTODESK STUDENT VERSION

X-XX + - + - X-XX VOLTAGE READINGS X 19 TEMPERATURE READINGS [+] X 19 BATTERY POSITIVE TEMPERATURE READINGS [-] X 1 VOLTAGE READINGS X 19 BATTERY NEGATIVE SEE ACC027 FOR TEMPERATURE READING CONNECTIONS

Accumulator pack and AMS connections. Excellence Endurance Enthusiasm ..\..\Downloads\WFR LOGO 2016.png; Page; ACC031 Date; 2018-10-06 Initials; A.PORRONE 01 02030405060708091011 121314151617181920; 21 22232425262728293031 323334353637383940 ACC028 02804-22-RW 04; AMS CELL BANKS ACC028 02808-22-RW 08; XXX000 SAME AS AMS-XX-XX 00 ACC028 02803-22-BW 03 ACC028 02805-22-VW 05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

PRODUCED BY AN AUTODESK STUDENT VERSION

FROM TEMP ON PAGE ACC028) ACC028 02807-22-BW 07 ACC028 02809-22-VW 09 ACC028 02811-22-BW 11 ACC028 02813-22-VW 13 ACC028 02815-22-BW 15 ACC028 02817-22-VW 17 ACC028 02819-22-BW 19 ACC028 02819-22-VW 19 PRODUCED BY AN AUTODESK STUDENT VERSION PRODUCED BY AN AUTODESK STUDENT VERSION

(PINS NOT DEFINED YET) COMES

OTHER DOOLY MAKING THIS

Fusing Overview Excellence Endurance Enthusiasm; Page; ACC032 Date; 2018-10-06 Initials; A.PORRONE 45A 45A 45A 45A 45A 45A 45A; AIR+; Motor Driver; Motor Accumulator Bus Bar 3.175mm x 14mm; 1A 500V TSAL; IMD 1A 500V TSAL

PRODUCED BY AN AUTODESK STUDENT VERSION

notes notes notes Excellence Endurance Enthusiasm; Page; ACC033 Date; 2019-01-10 Initials; J.DOOLEY 01 02030405060708091011 121314151617181920; 0172 AIR+ CR0172 0173 AIR- CR0173; HVC PL03307 1 1 2 2; L1L2N Charging Cart; L1L2N AIR's; HVC Accumulator; CAN_HI CAN_LO; AMS CAN 100A 450V; 2AWG 2AWG; 240VAC Supply EV250035 +-; L1L2N CAN_HI CAN_LO

PRODUCED BY AN AUTODESK STUDENT VERSION

120 OHMS R03310 EV250035 40A GFCI L1709050144 4 4 To safeties 3 3 that actuate AIRs 30A 500V HVC PL03307 1 1 2 2 Charger Connector 4 4 3 3 40 40 40 40 Aux. Con. To safeties that actuate AIRs NOTE: The charger requires 12v power from the DCDC to turn on. When AIRs are open the DCDC turns off. 14AWG 14AWG 14AWG HVC PL03307 1 1 2 2 Charger Connector 4 4 3 3 40 40 40 40 12AWG 12AWG 12AWG 12AWG 2AWG 14AWG 14AWG 14AWG NOTE: Lines are 22 AWG unless otherwise noted.

SEG 1 79.8V 19S7P -; + SEG 2 79.8V 19S7P -; + SEG 3 79.8V 19S7P -; + SEG 4 79.8V 19S7P -; + SEG 5 79.8V 19S7P -; + MT CON 1 1; 2 MT CON 2 1; 2 MT CON 3 1; 2 MT CON 4 1; 2 MT CON 5 1 1 2; LITTLEFUSE L50S100 100AMP MAIN FUSE 450VFU02916; SAF0173 AIR- CR0173 SAF0172 AIR+ CR0172; Energy Meter HVC Aux. Con. IMD

PRODUCED BY AN AUTODESK STUDENT VERSION

safe Accumulator + - 0885001.DR 1AMP FUSE 500V 088502.5DR 2.5AMP FUSE 500V Energy Meter Enclosure + -

600OHMS PRECHARGE Maintenance connectors (MT): Anderson's Power SB175 175A 600V Voltage sense connectors: Molex 430202000 8A600V Aux. Connector: TE Connectivity796272-1 13A 600V Main traction loop wires: Terminated and shielded in drive by screw terminal. Shield pass-through in energy meter. Terminated at AIR by ring terminal. All wires are 18AWG unless otherwise noted. 2AWG 2AWG Motor Inverter BSPD External Safety Monitor Relay MODEL: DCM300P120T400A40 IN+ AMS RLY+ AMS- IMD+ FT

OUT- DISC- HVIB+ HVIB- OUT+ DISC+ IMD- RLY+ RLY- + -

OUT+ IN- DC-DC CONVERTER

2.2KOHMS DISCHARGE Safety interlocks Safety interlocks Safety interlock HVD CR02935

Excellence Endurance Enthusiasm; Page; ACC035 Date; 2019-05-02 Initials; J.DOOLEY 01; MODEL: DCM300P120T400A40 DC-DC CONVERTER DISCH HVIB SPR2 IMD AMS MON 400V 12V UNFUSED PRECH IN; 23ACC028 02823-22-BW 16; SAF017 01716A-22-BW 11; SAF023 03503-20-RR 02 ACC029 03505-20-RR 33ACC028 03506-20-RR; ACC029 02905-20-BB ACC029 02925-22-RB 25 ACC029 02911-20-OO 11; ACC029 03512-20-WO 20; 14 DC/DC converter connections on left. Auxiliary connector on right.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

PRODUCED BY AN AUTODESK STUDENT VERSION

notes Excellence Endurance Enthusiasm; Page; ACC039 Date; 2019-05-03 Initials; J.DOOLEY 01; 12V GND PWM TACH SAN ACE 80; FAN CTRL12V GND PWM FAN CONNECTOR PL03901 1 1 2 2 3 3 4; 03 ACC035 02825-22-RW 04 ACC035 03504-18-RB ACC035 03902-18-BB 04

PRODUCED BY AN AUTODESK STUDENT VERSION

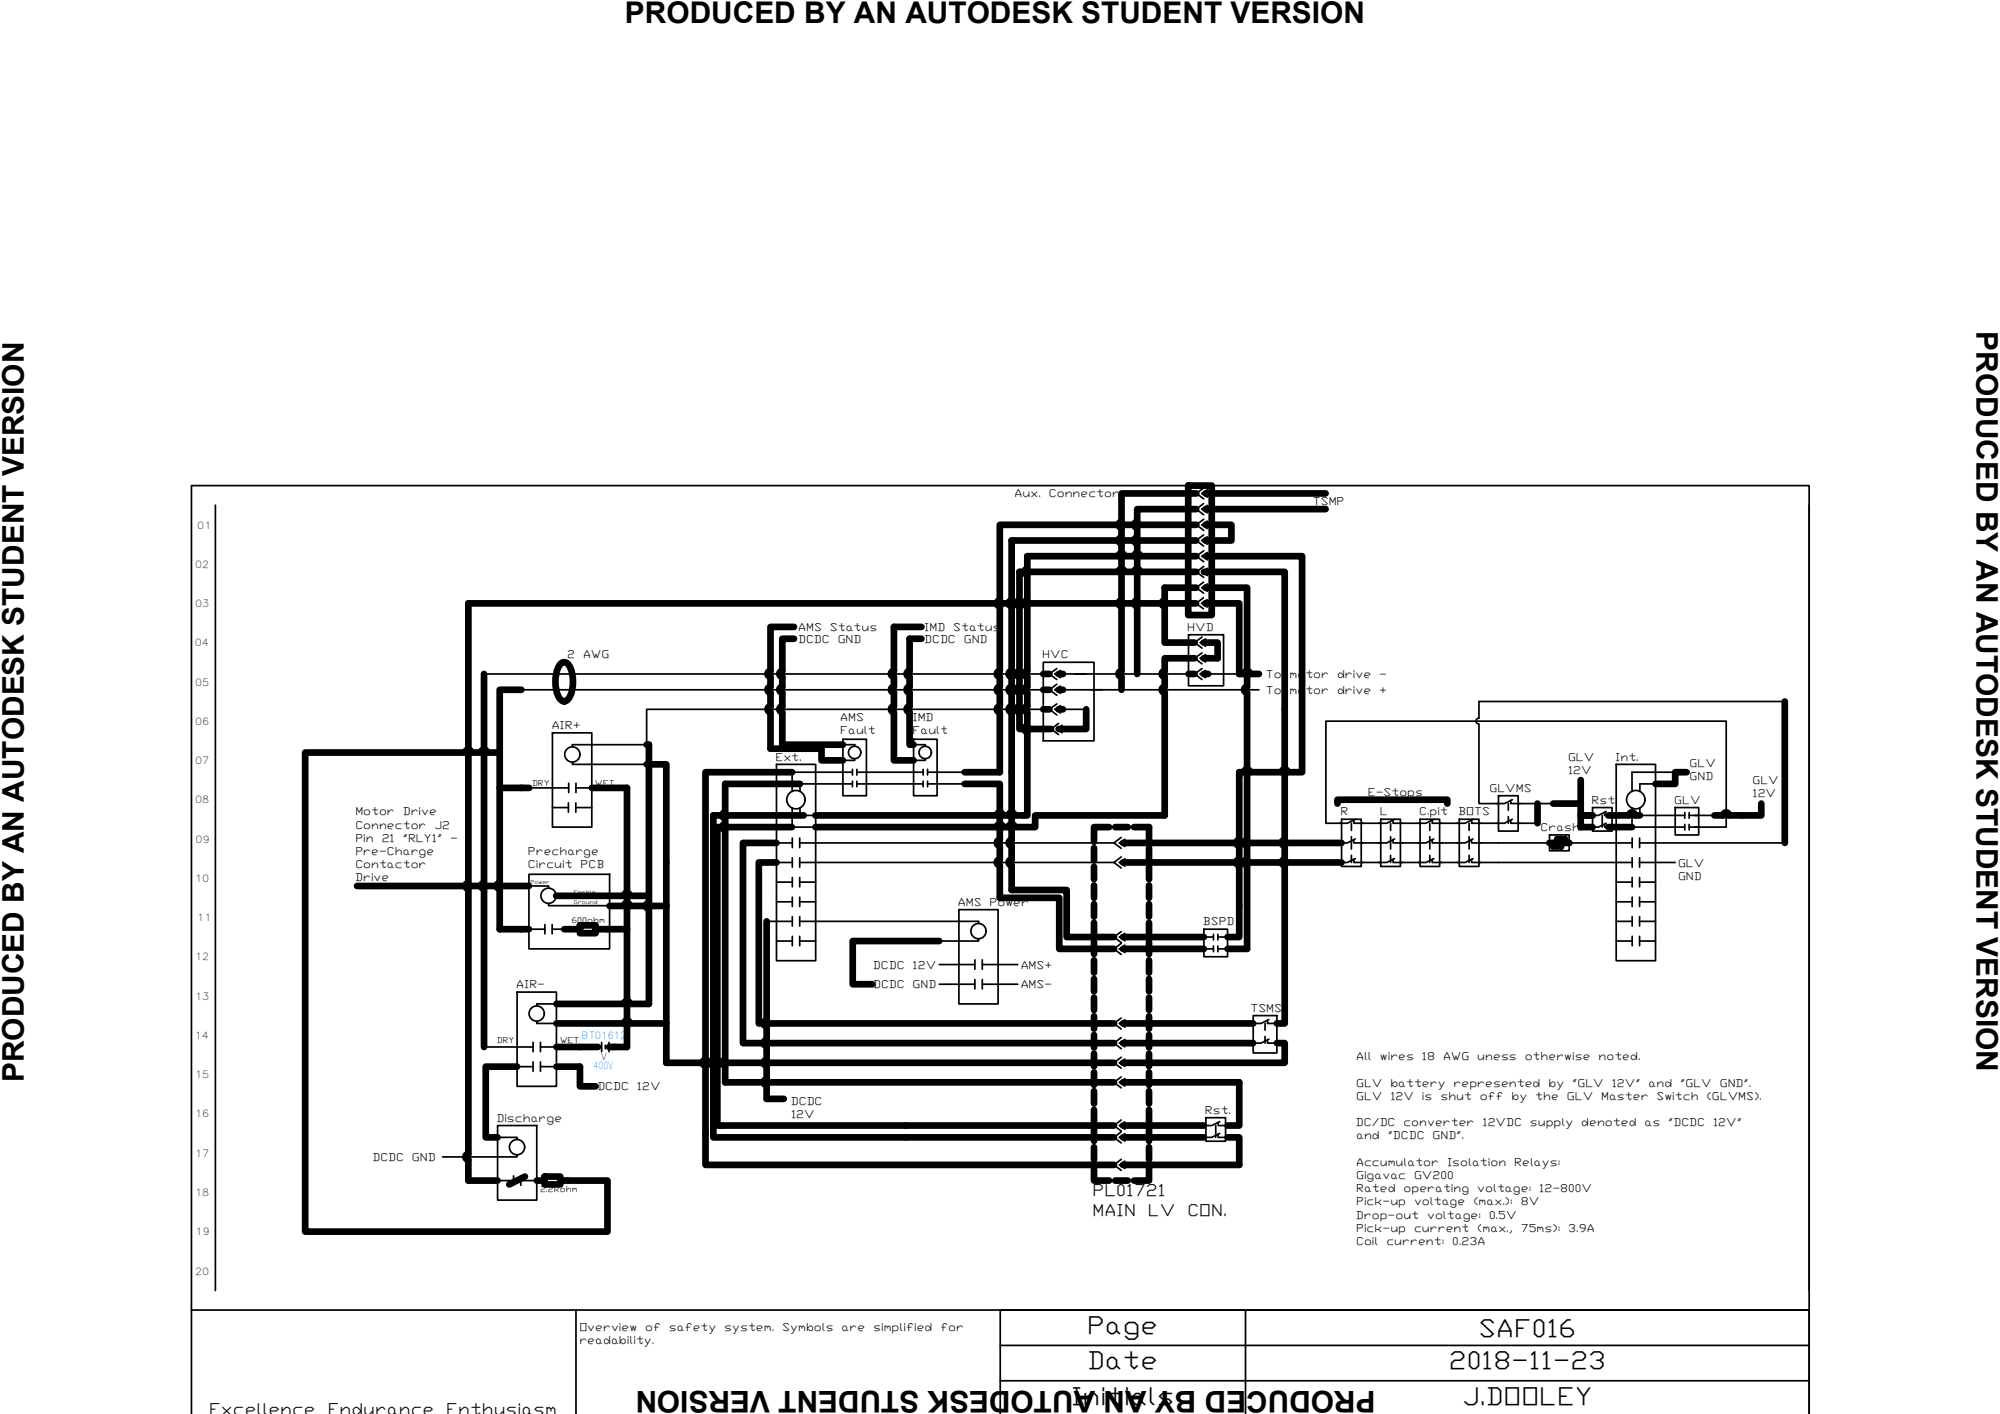
[picture p105: page 12]
Overview of safety system. Symbols are simplified for readability. Excellence Endurance Enthusiasm; Page; SAF016 Date; 2018-11-23 Initials; J.DOOLEY 01 02030405060708091011 121314151617181920; motor drive - AMS+ AMS- DCDC 12V DCDC GND; GLV 12V AIR+; Ext.; HVC; Int. AMS Power; C.pit BOTSGLVMS Crash; GLV HVD AIR-; AMS Fault; IMD Fault IMD Status DCDC GND; GLV GND E-Stops To; motor drive + 2 AWG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

PRODUCED BY AN AUTODESK STUDENT VERSION

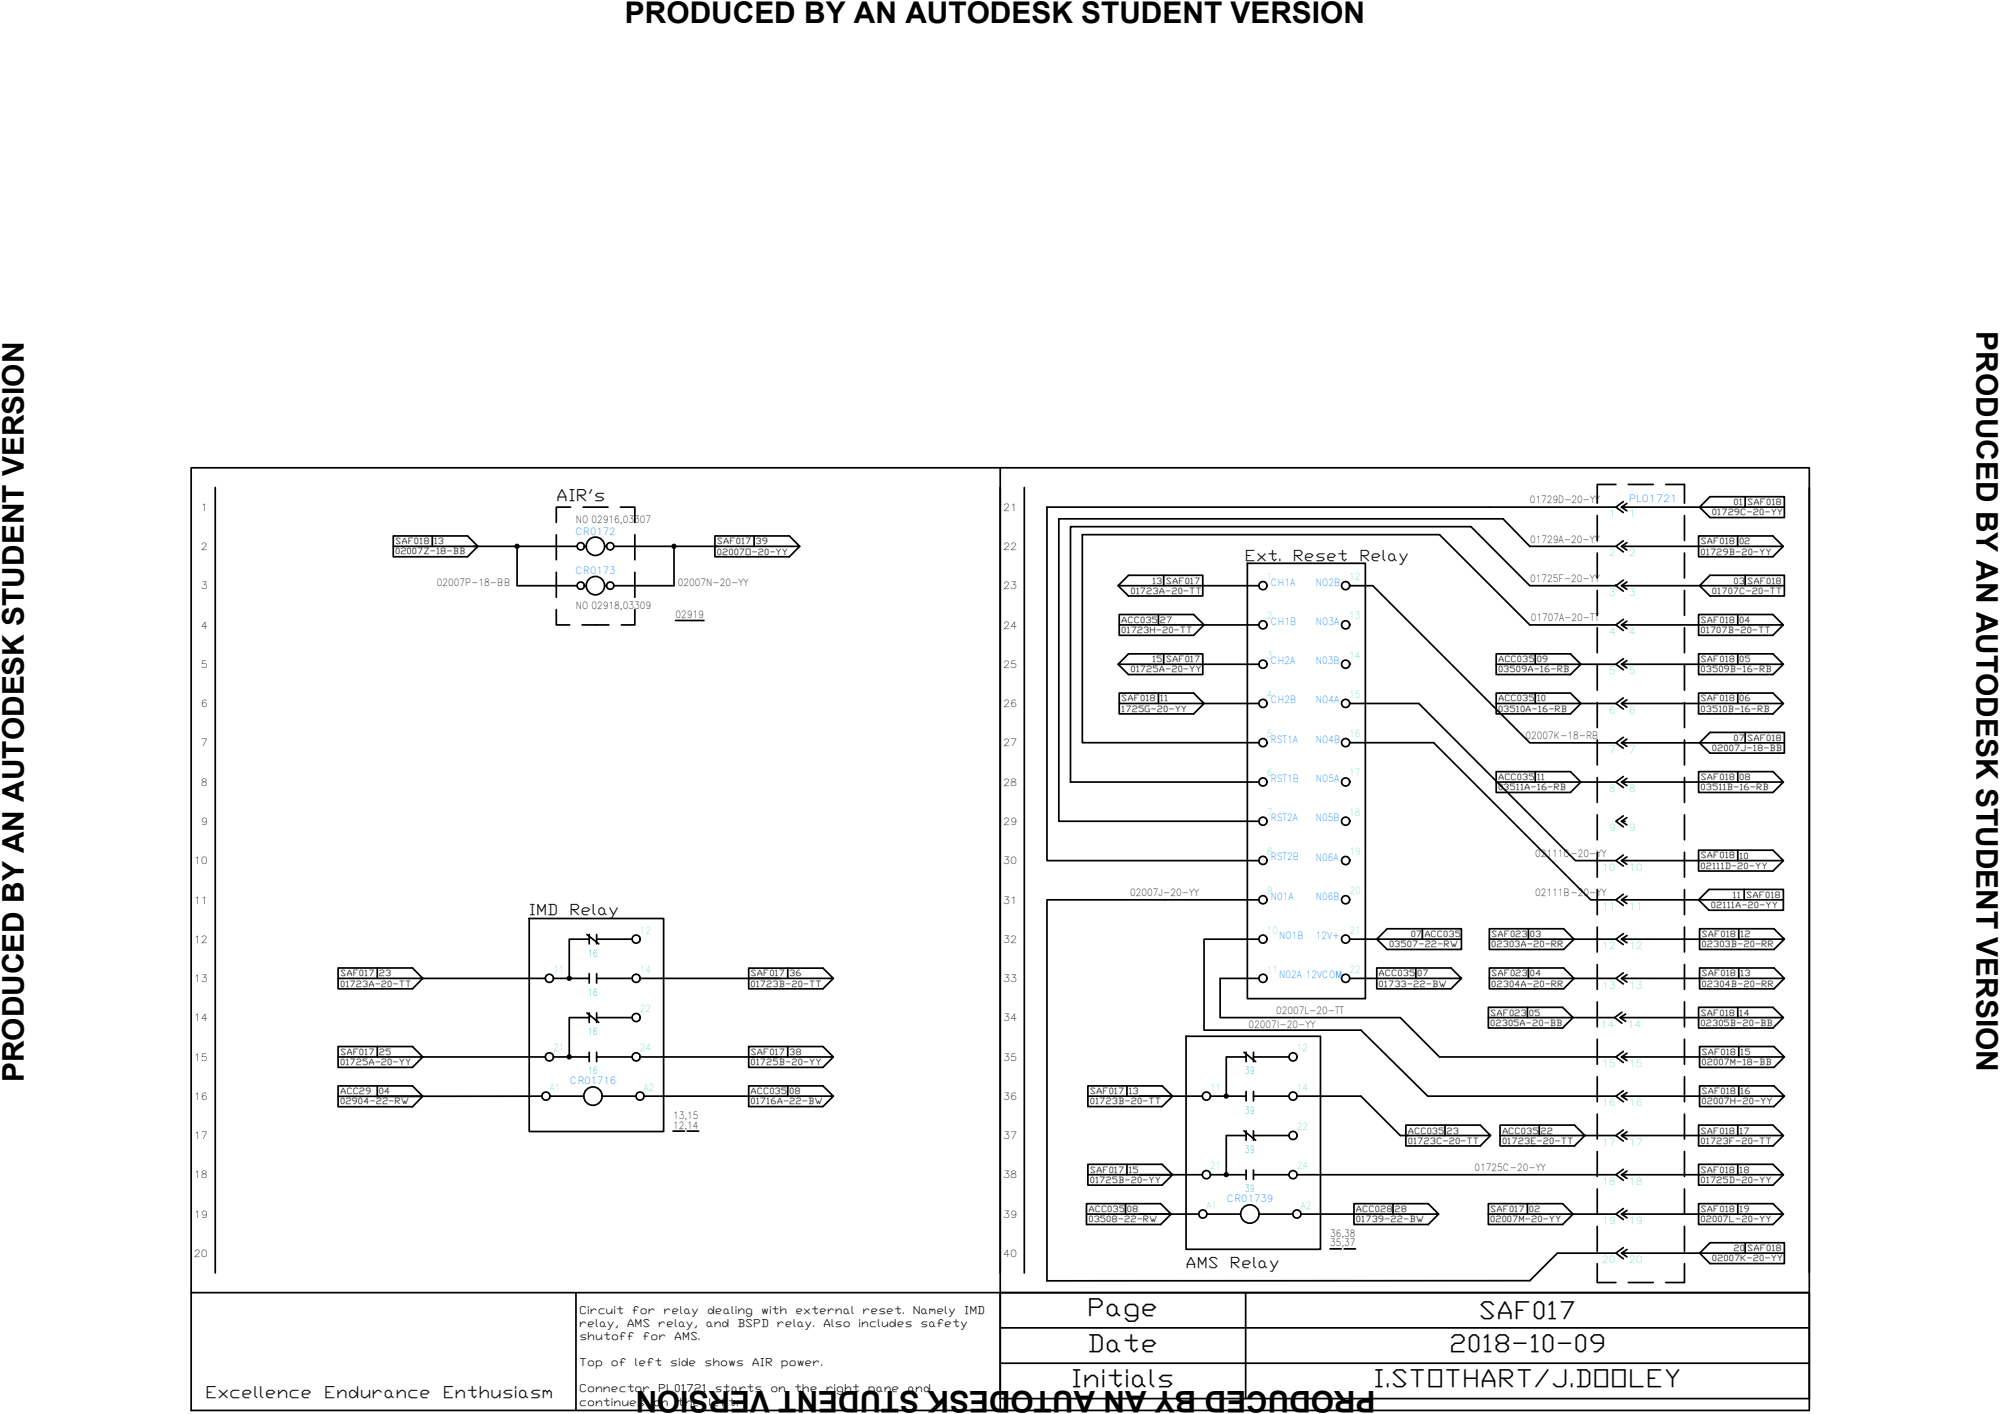
[picture p106: page 13]
Circuit for relay dealing with external reset. Namely IMD relay, AMS relay, and BSPD relay. Also includes safety shutoff for AMS. Top of left side shows AIR power. Connector PL01721 starts on the right pane and continues on the left. Excellence Endurance Enthusiasm; Page; SAF017 Date; 2018-10-09 Initials; I.STOTHART/J.DOOLEY 1; 1424 SAF017 01723A-20-TT 23 SAF017 01725A-20-YY 25; NO2B 12 CH1B 2CH2A 3CH2B 4RST1A 5RST1B 6RST2B 8N01A 9 NO1B 10RST2A 7 N02A 11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

PRODUCED BY AN AUTODESK STUDENT VERSION

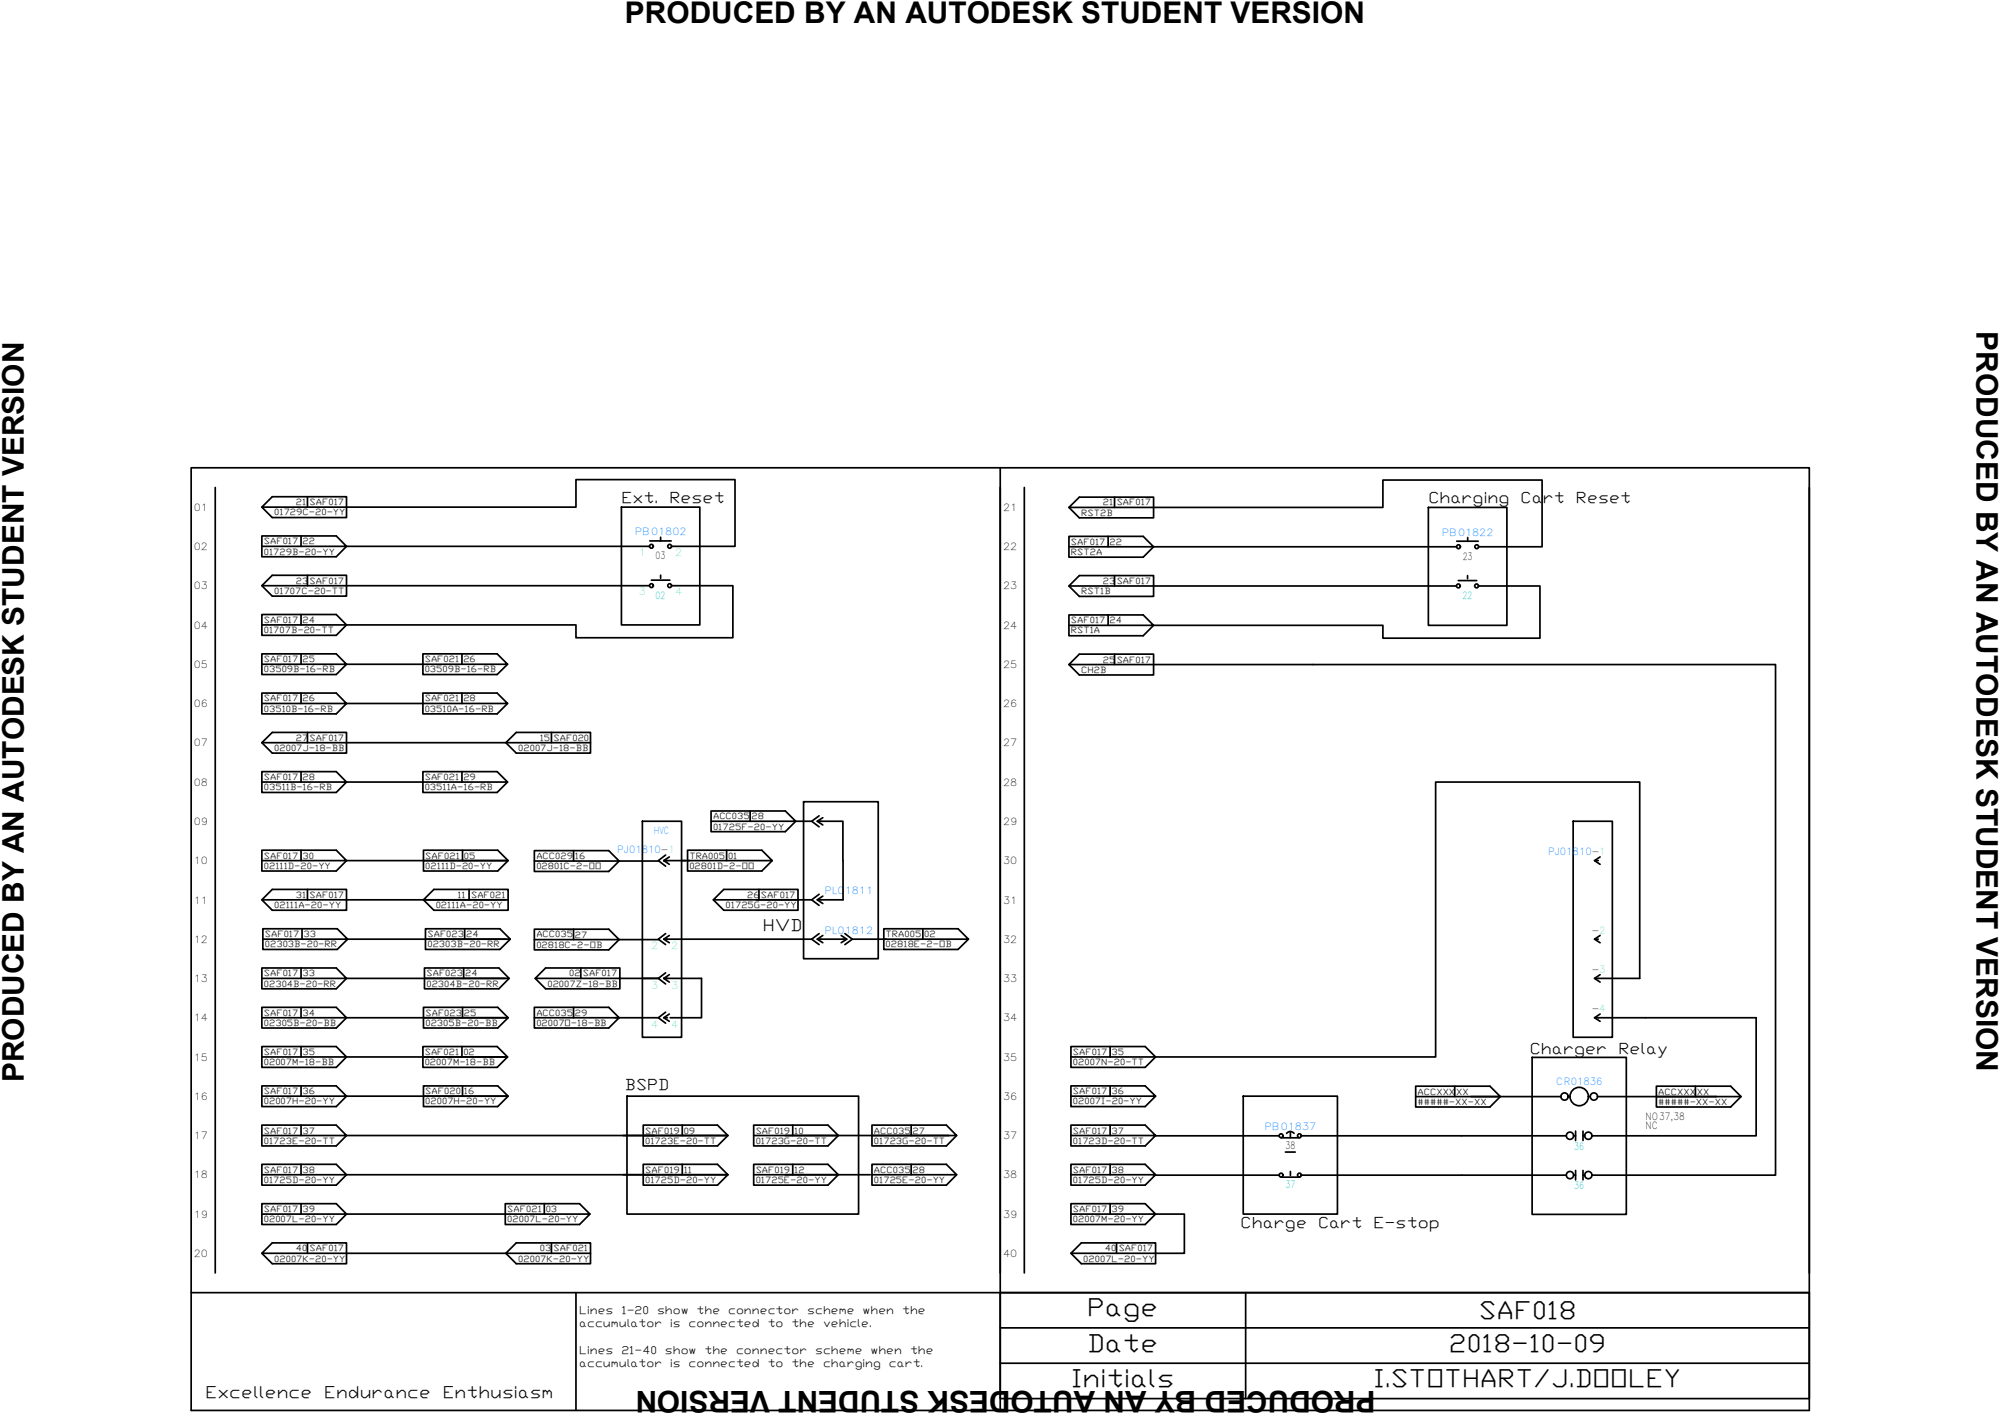
[picture p107: page 14]
Lines 1-20 show the connector scheme when the accumulator is connected to the vehicle. Lines 21-40 show the connector scheme when the accumulator is connected to the charging cart. Excellence Endurance Enthusiasm; Page; SAF018 Date; 2018-10-09 Initials; I.STOTHART/J.DOOLEY 01; SAF021 02111D-20-YY 05 21; SAF017 01729C-20-YY 23SAF017 01707C-20-TT 27SAF017 02007J-18-BB; 4 02 Ext. Reset BSPD; Charging Cart Reset 23 PB01822 22; Charger Relay ACCXXX #####-XX-XX XX; ACCXXX #####-XX-XX XX 3636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

PRODUCED BY AN AUTODESK STUDENT VERSION

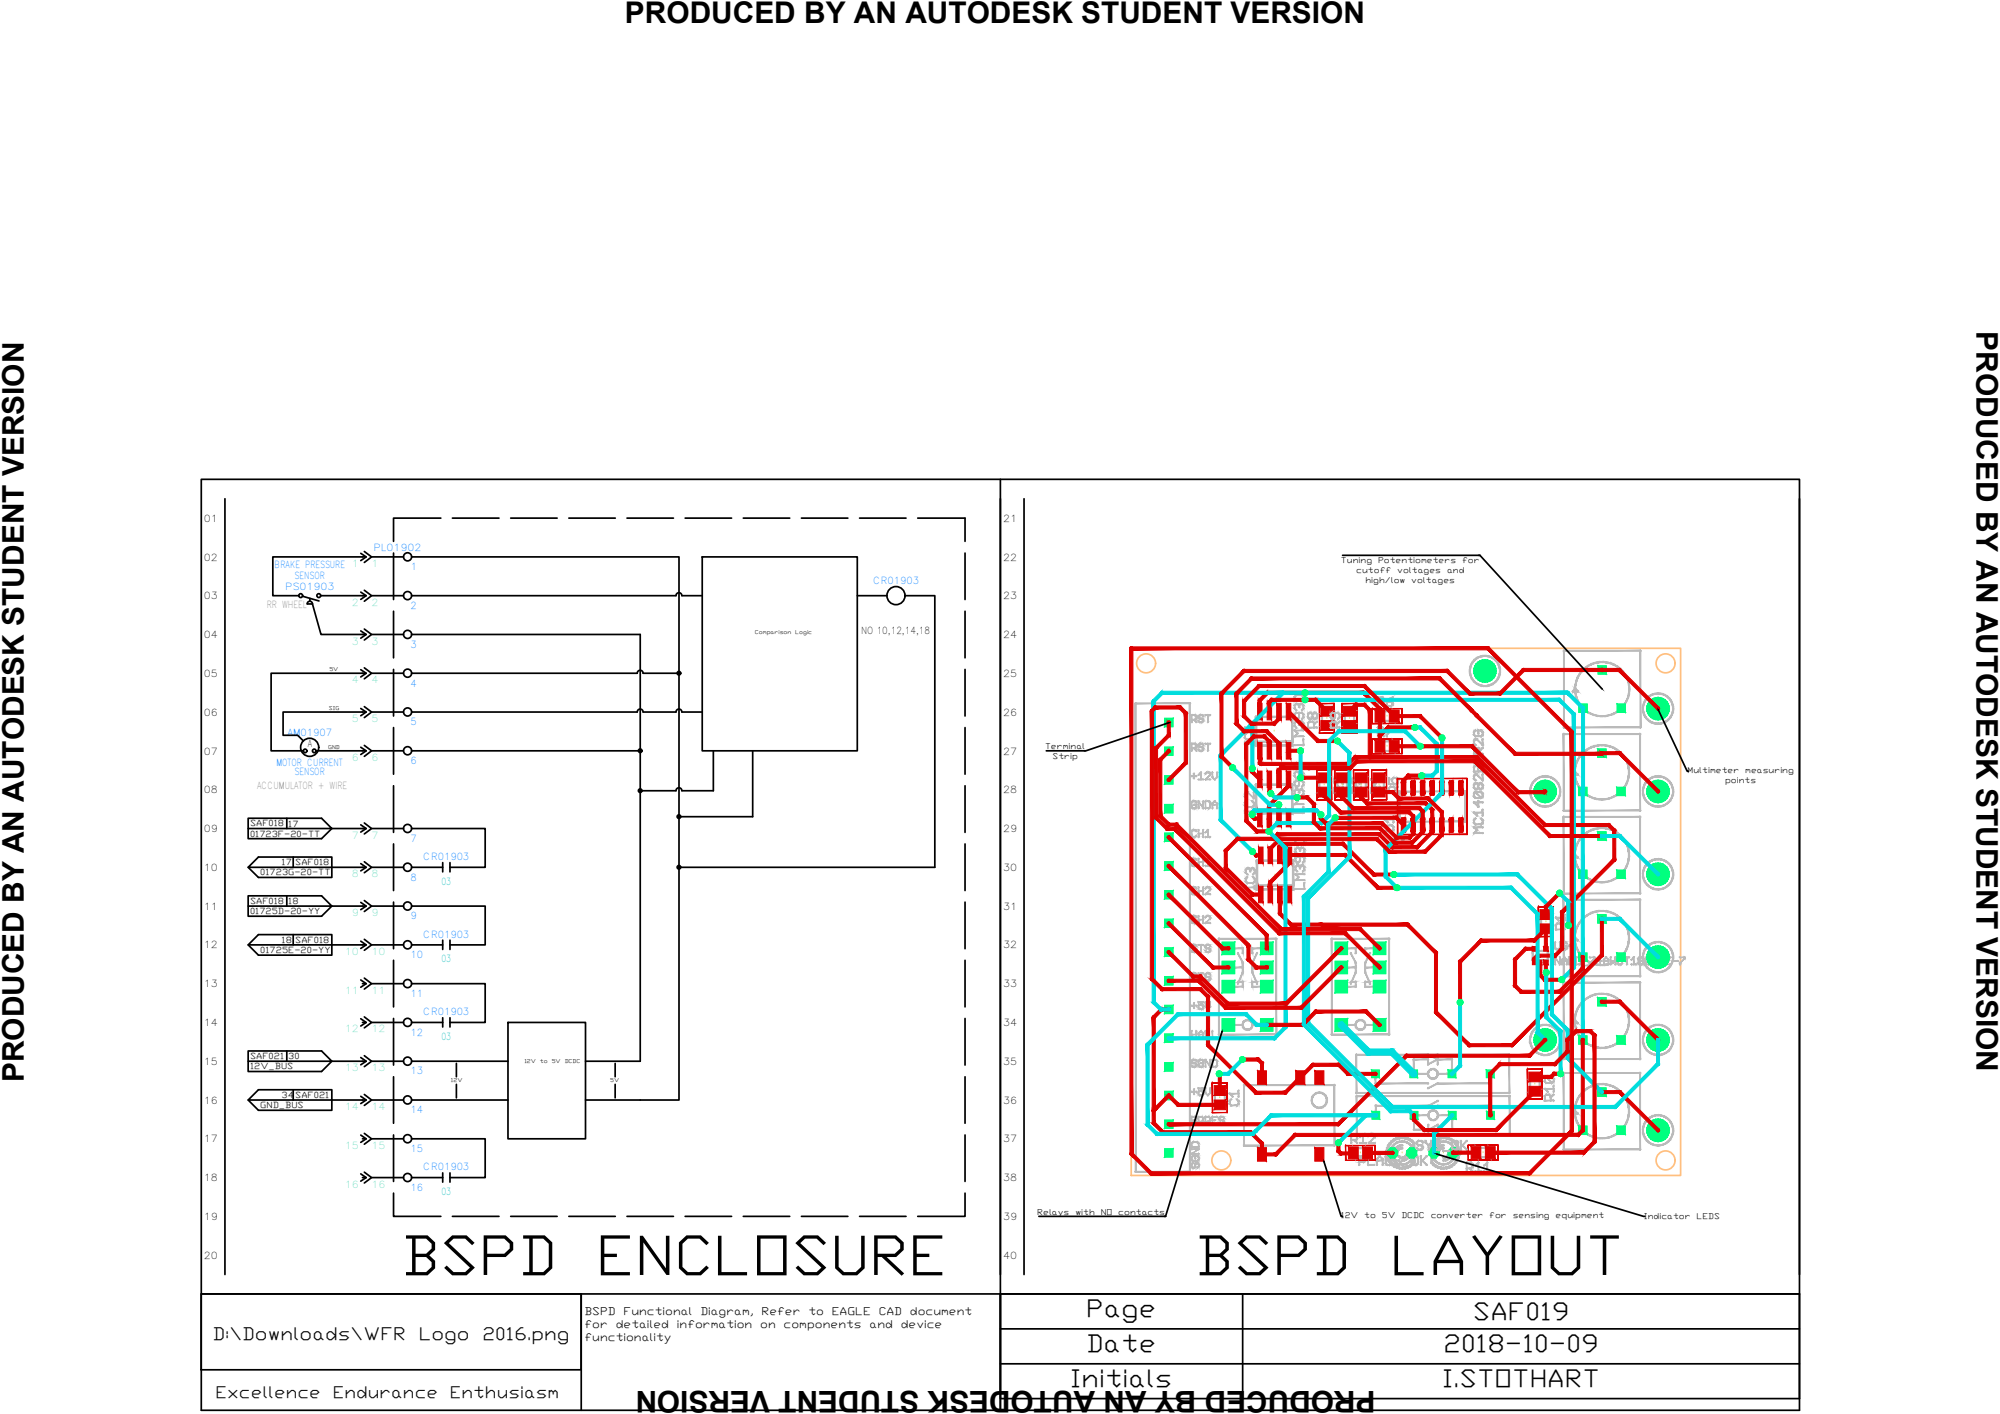
[picture p108: page 15]
BSPD Functional Diagram, Refer to EAGLE CAD document for detailed information on components and device functionality Excellence Endurance Enthusiasm D:\Downloads\WFR Logo 2016.png; Page; SAF019 Date; 2018-10-09 Initials; I.STOTHART 0102030405060708091011121314151617181920; 12V to 5V DCDC 12V; Comparison Logic; 21222324252627282930313233343536373839 BSPD ENCLOSURE; 40 SAF021 12V_BUS30SENSOR MOTOR CURRENT A ACCUMULATOR + WIRE AM019075VSIG GND RR WHEEL SENSOR BRAKE PRESSURE PS01903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

PRODUCED BY AN AUTODESK STUDENT VERSION

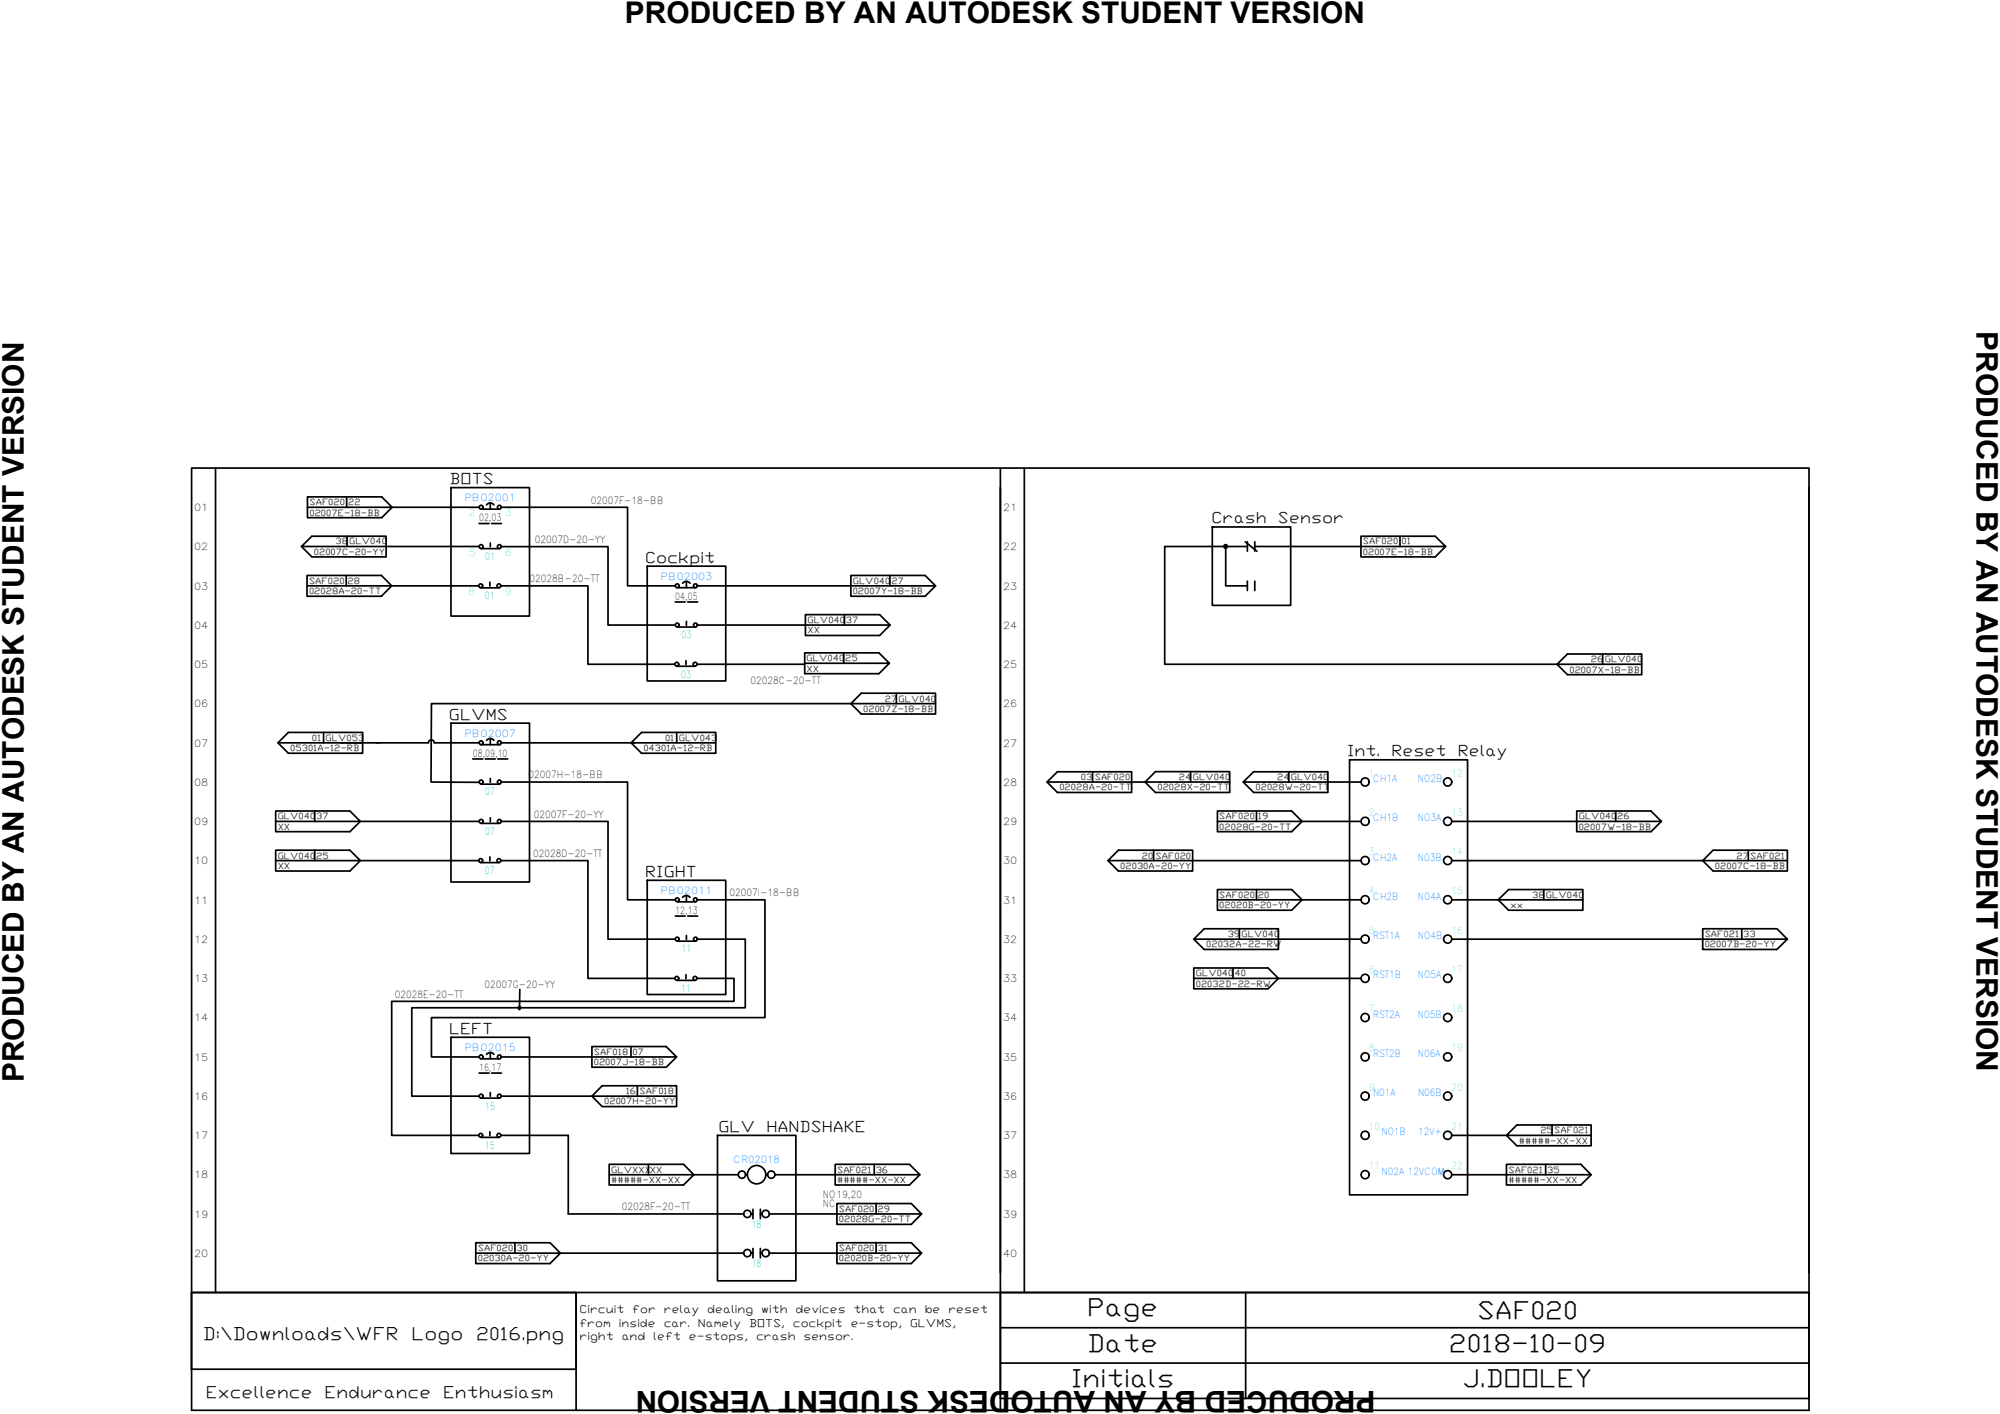
[picture p109: page 16]
Circuit for relay dealing with devices that can be reset from inside car. Namely BOTS, cockpit e-stop, GLVMS, right and left e-stops, crash sensor. Excellence Endurance Enthusiasm D:\Downloads\WFR Logo 2016.png; Page; SAF020 Date; 2018-10-09 Initials; J.DOOLEY 01; 6 01 BOTS; 04,05 PB02003 03 Cockpit 08,09,10 PB02007 07 GLVMS; 12,13 PB02011 11 RIGHT 07 LEFT16,17 PB02015 15; NO2B 12 CH1B 2CH2A 3CH2B 4RST1A 5RST1B 6RST2B 8N01A 9 NO1B 10RST2A 7 N02A 11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

PRODUCED BY AN AUTODESK STUDENT VERSION

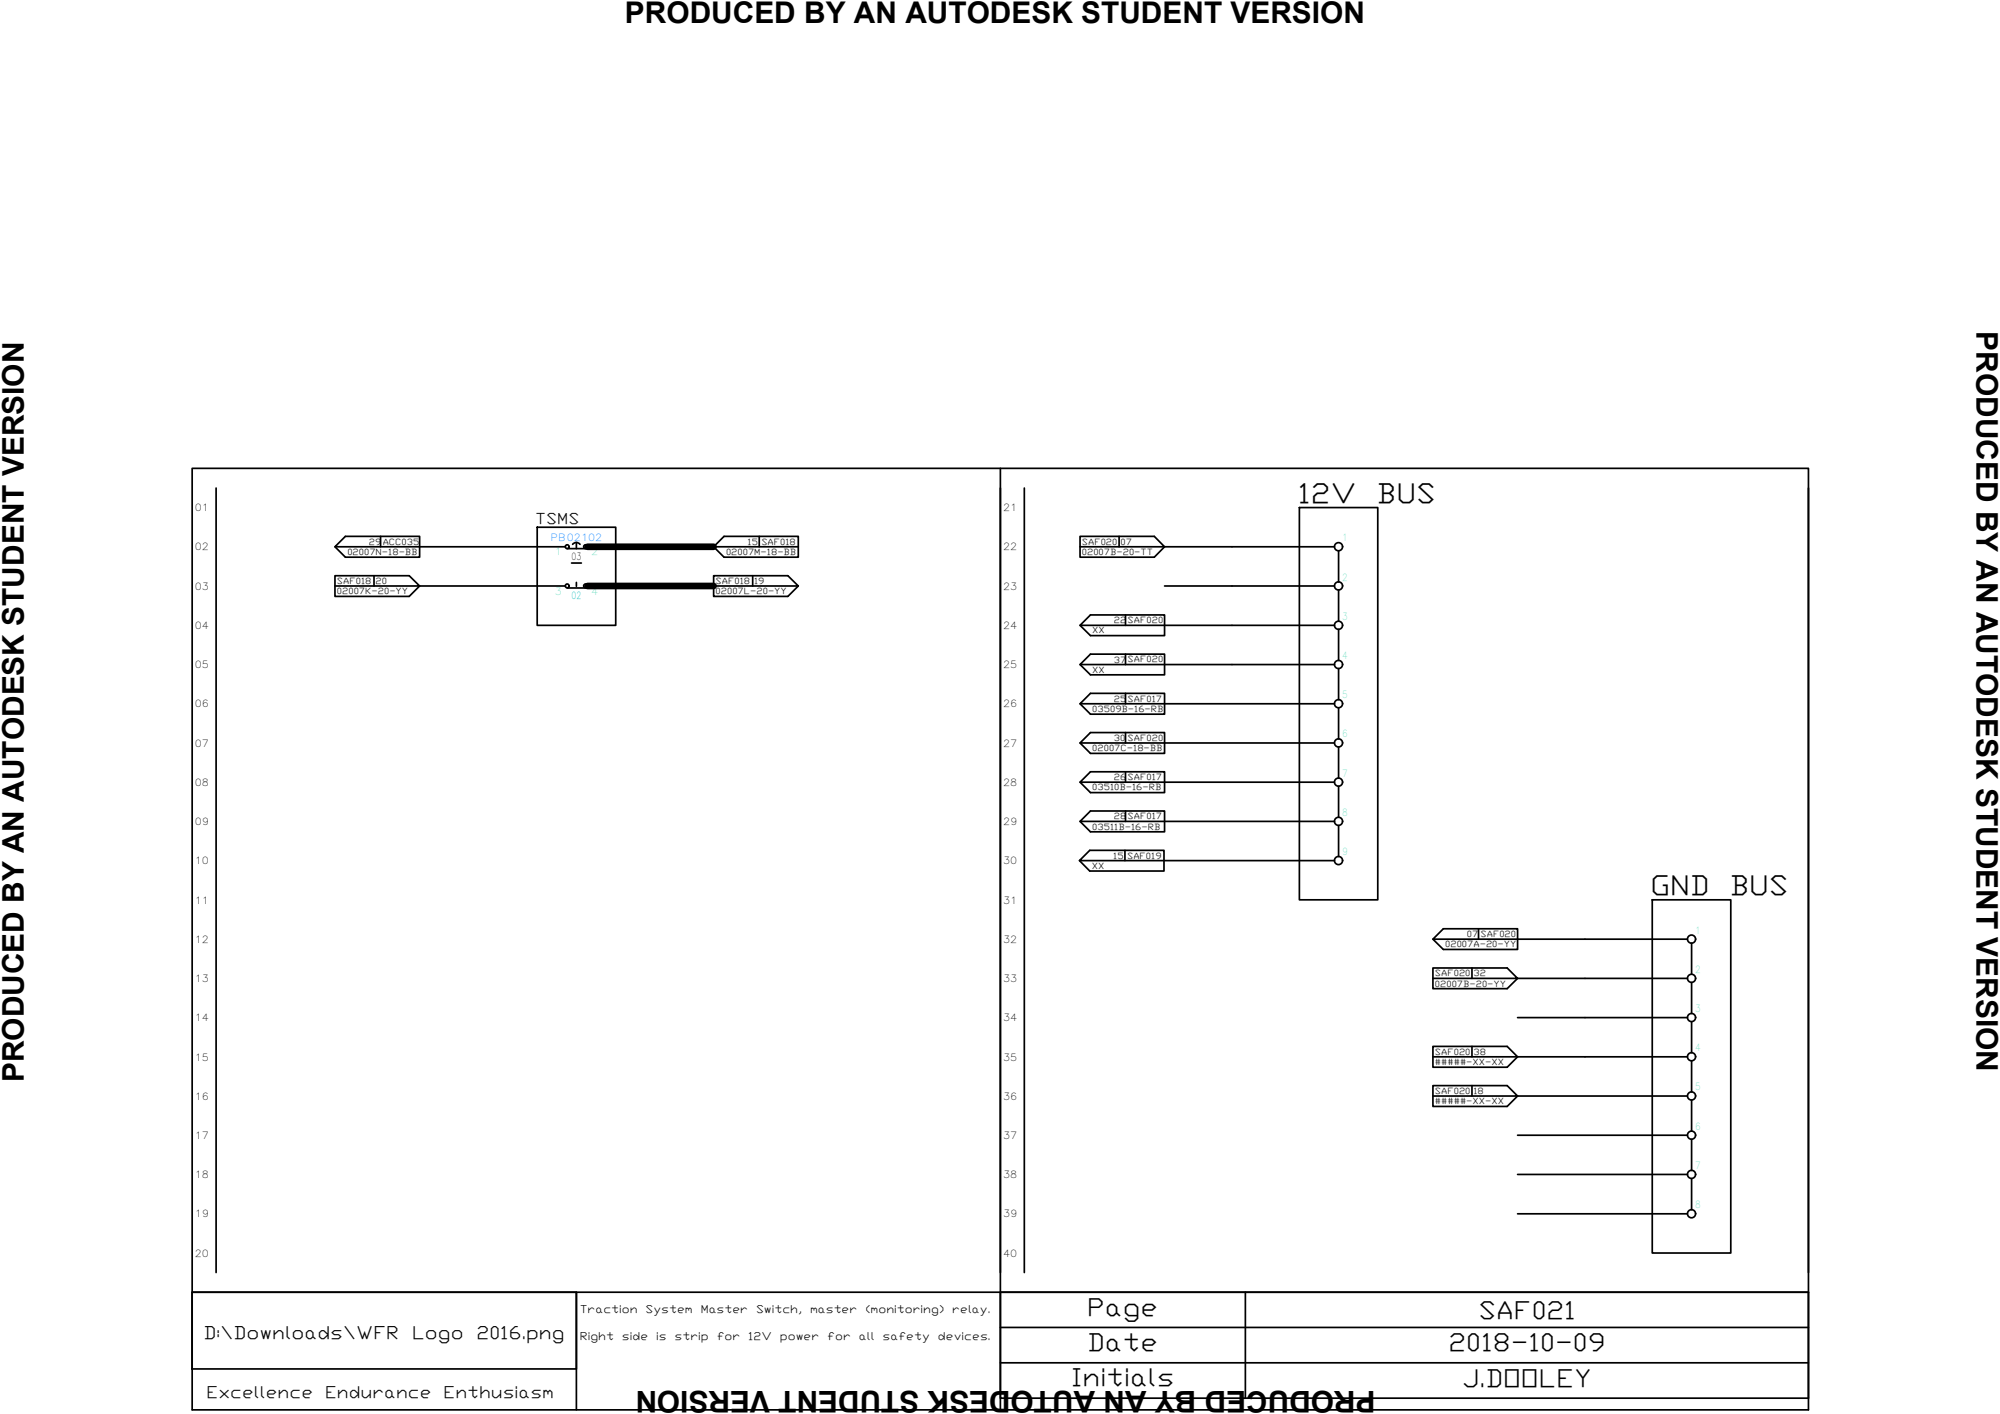
[picture p110: page 17]
Traction System Master Switch, master (monitoring) relay. Right side is strip for 12V power for all safety devices. Excellence Endurance Enthusiasm D:\Downloads\WFR Logo 2016.png; Page; SAF021 Date; 2018-10-09 Initials; J.DOOLEY 01; 4 02 TSMS 29 ACC035 02007N-18-BB; SAF018 02007M-18-BB; SAF020 02007B-20-TT 07; 123456 SAF018 02007L-20-YY SAF018; 22SAF020 XX 37SAF020 XX; 7 12V BUS 8; 123456 07 SAF020 02007A-20-YY; 7 GND BUS 8 15; SAF019 XX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

PRODUCED BY AN AUTODESK STUDENT VERSION

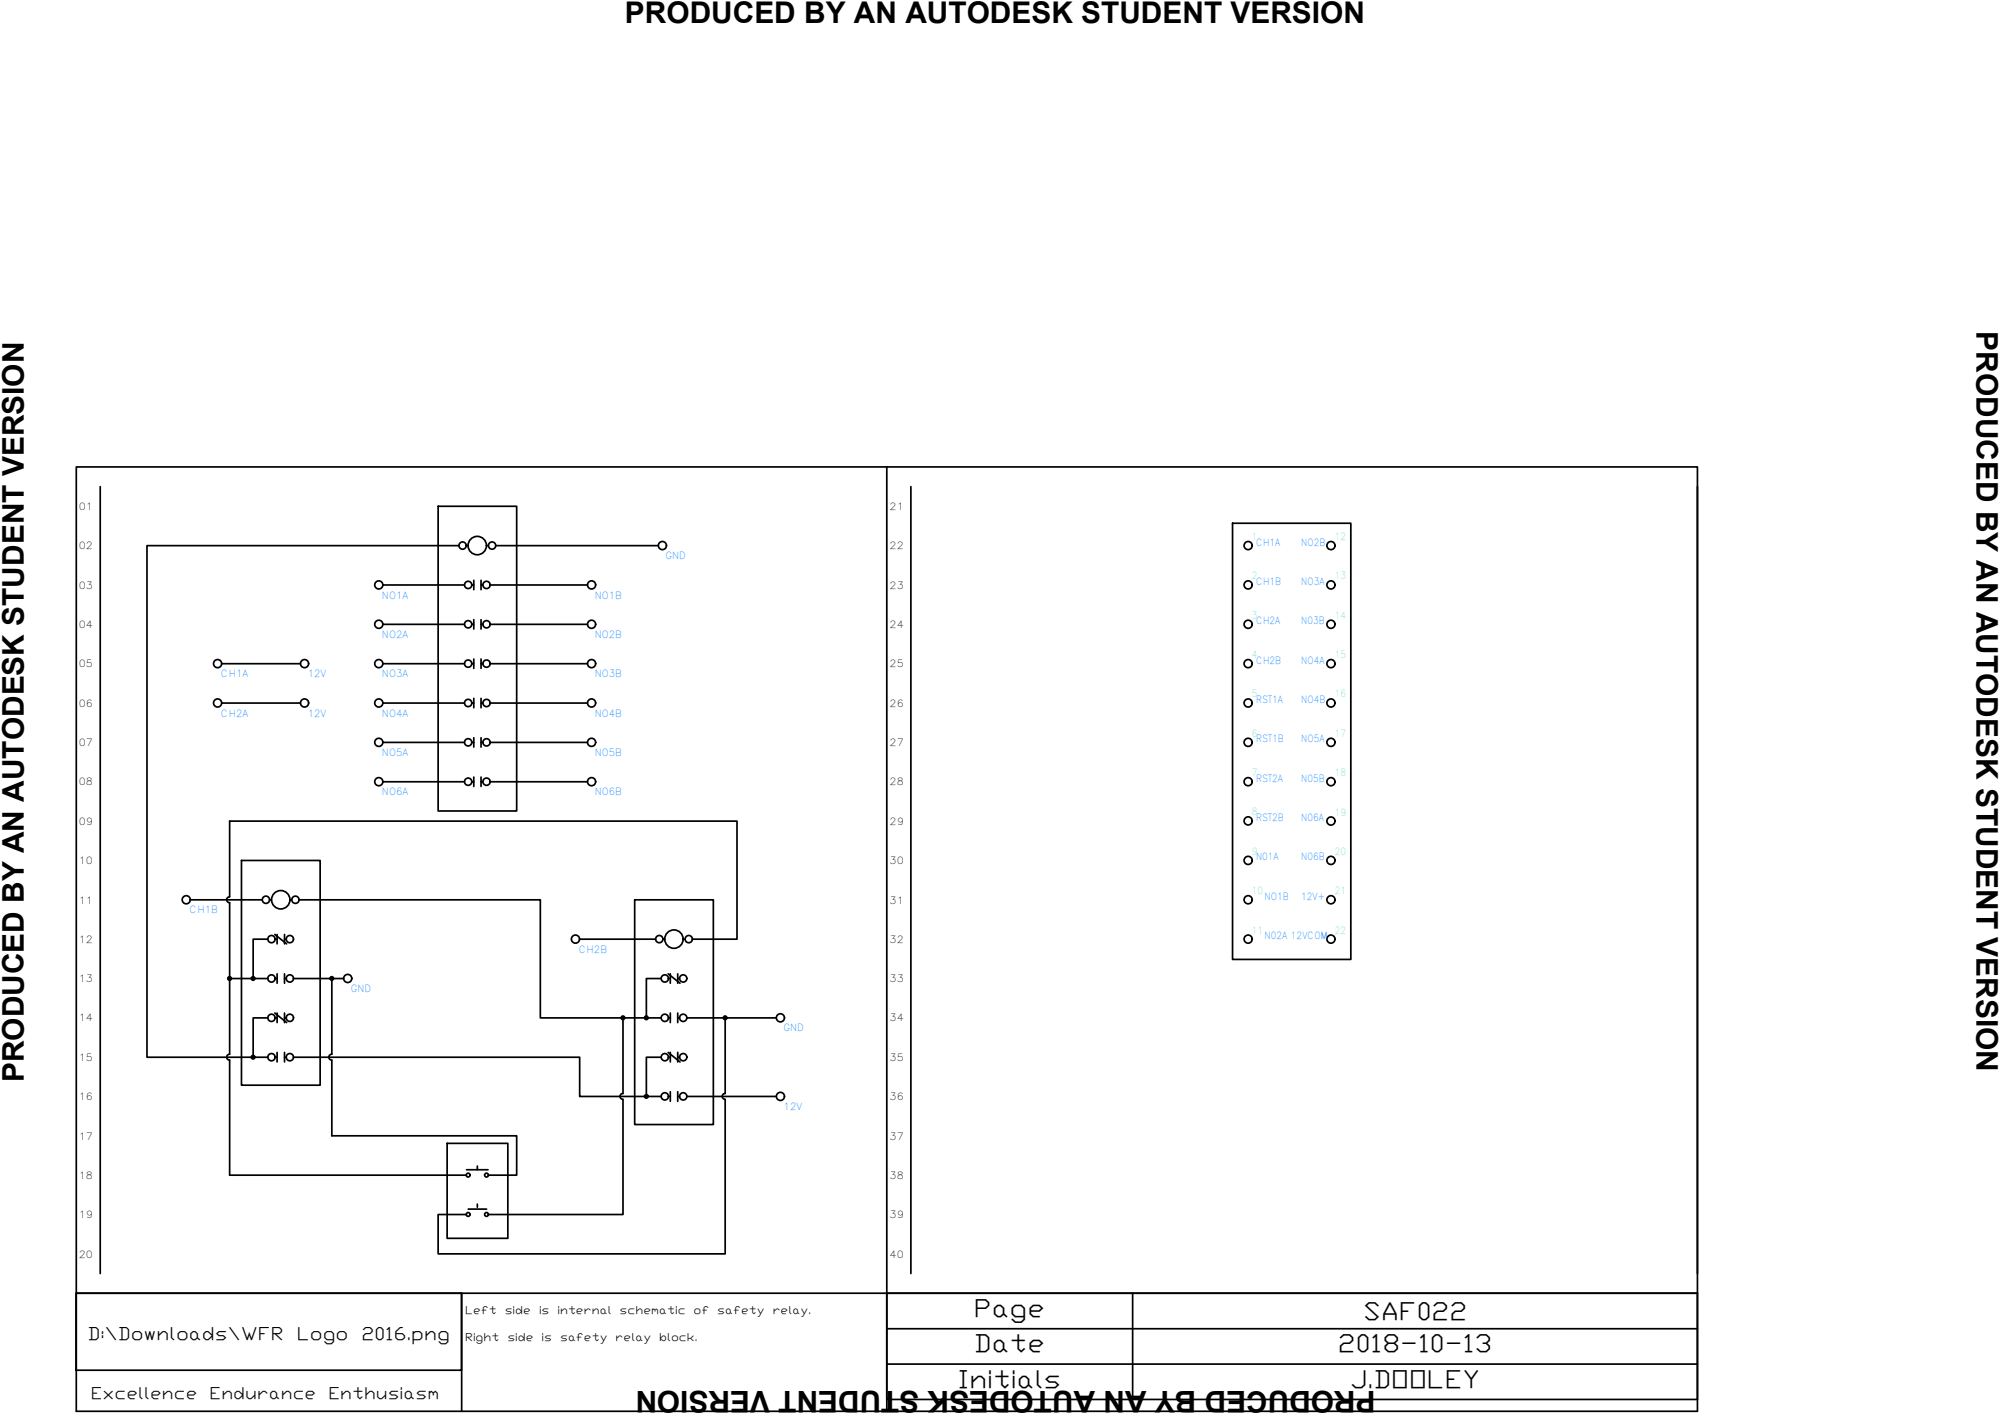
[picture p111: page 18]
Left side is internal schematic of safety relay. Right side is safety relay block. Excellence Endurance Enthusiasm D:\Downloads\WFR Logo 2016.png; Page; SAF022 Date; 2018-10-13 Initials; J.DOOLEY 0102030405060708091011121314151617181920; CH2B GND; GND 12V GND 12V 12V CH1A CH2A; NO2B 12 CH1B 2CH2A 3CH2B 4RST1A 5RST1B 6RST2B 8N01A 9 NO1B 10RST2A 7 N02A 11; NO3A 13 N03B 14 NO4A 15 NO4B 16 NO5A 17 N05B 18 N06A 19 N06B 20 12V+ 21 12VCOM 22 PRODUCED BY AN AUTODESK STUDENT VERSION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

PRODUCED BY AN AUTODESK STUDENT VERSION

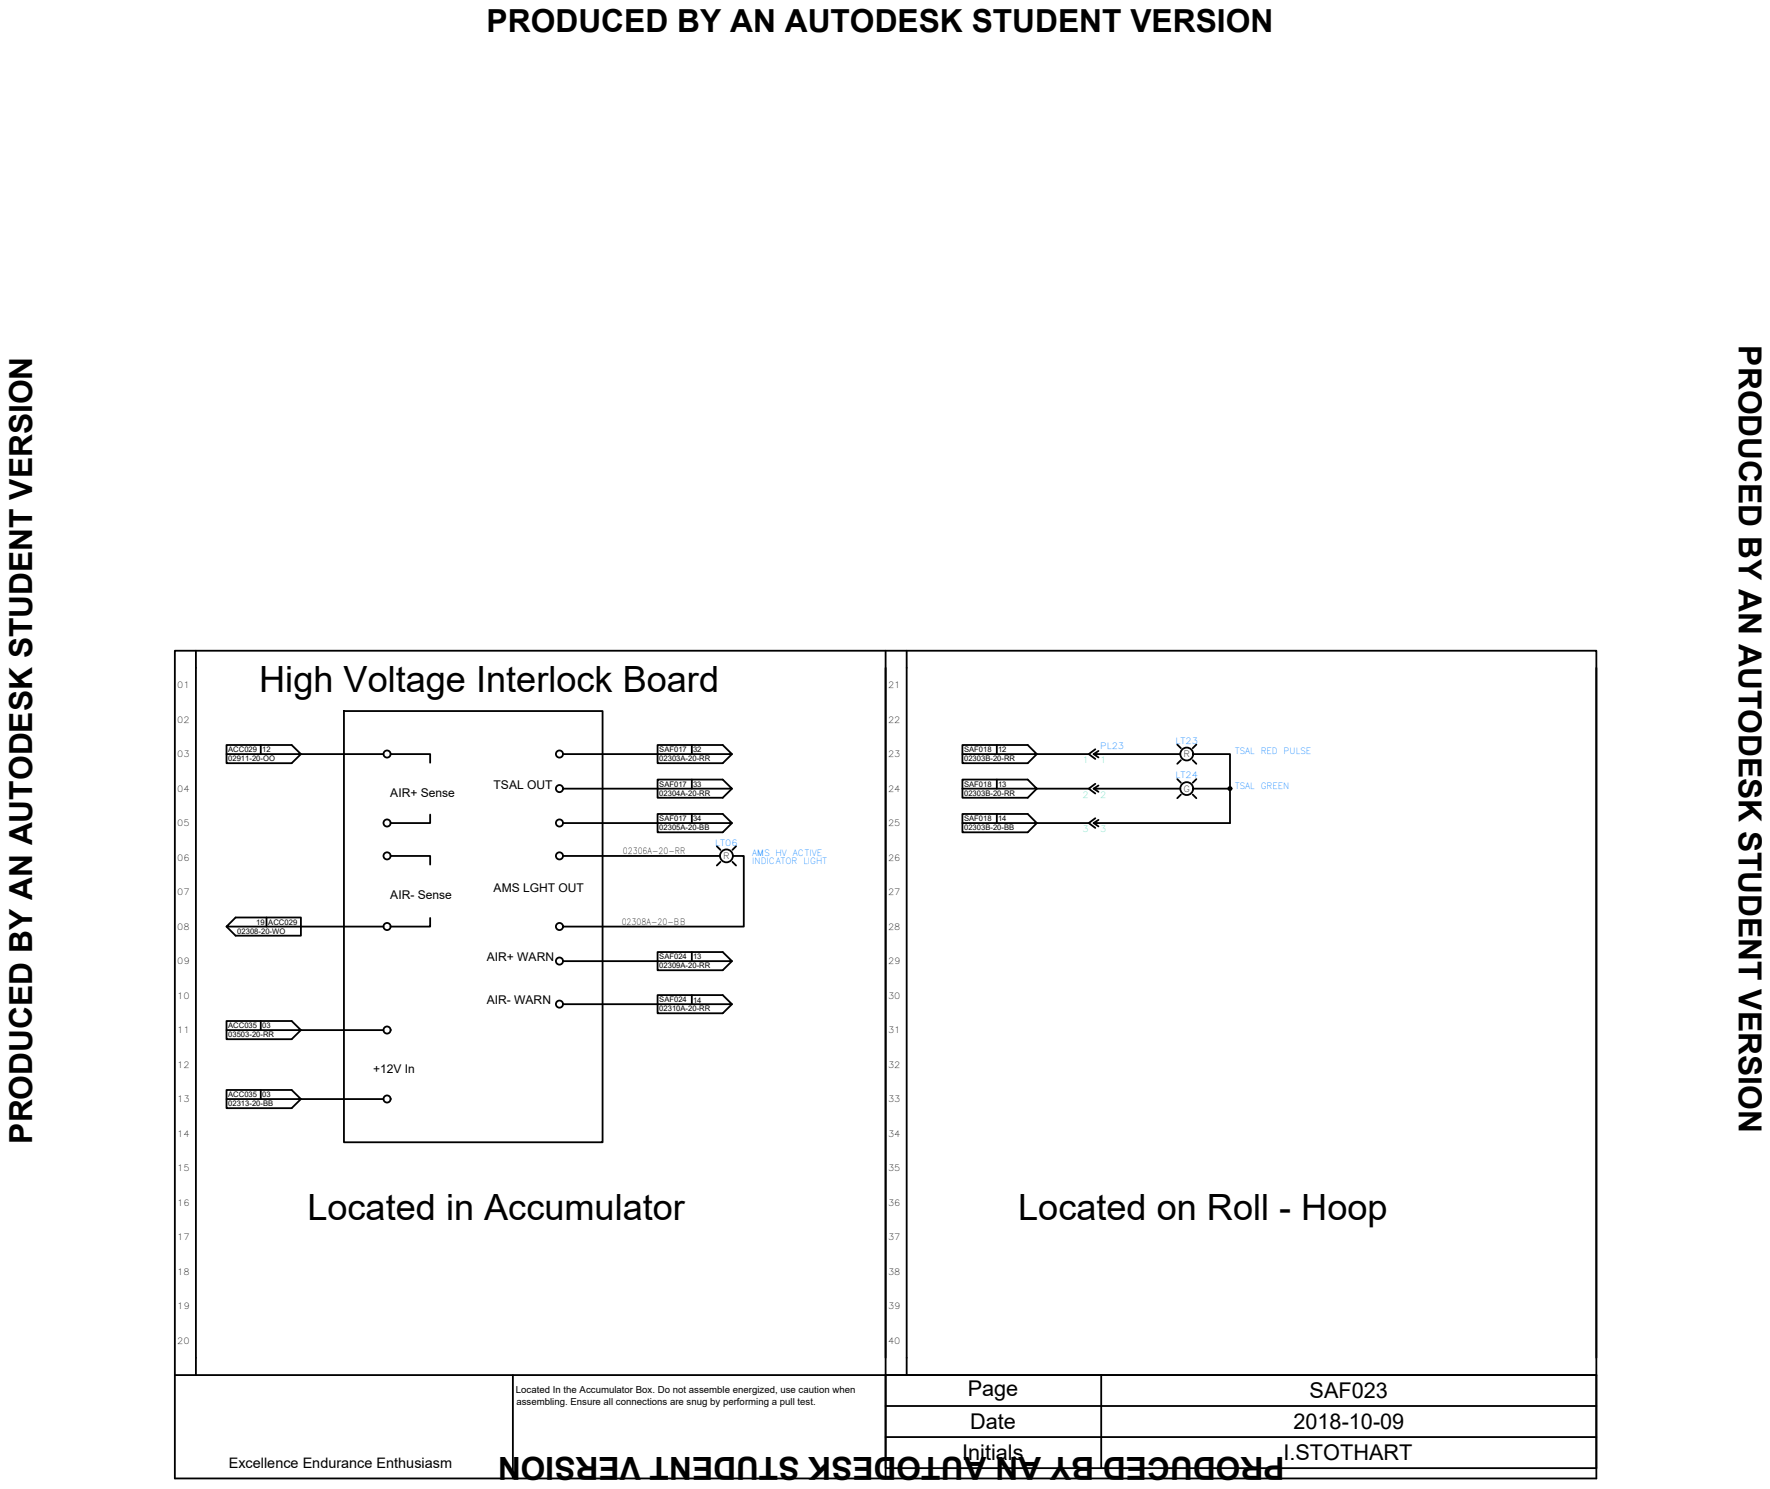
[picture p112: page 19]
Located In the Accumulator Box. Do not assemble energized, use caution when assembling. Ensure all connections are snug by performing a pull test. Excellence Endurance Enthusiasm; Page; SAF023 Date; 2018-10-09 Initials; I.STOTHART 01; ACC029 02911-20-OO12 ACC035 03503-20-RR03 ACC035 02313-20-BB03 19 ACC029 02308-20-WO; SAF017 02303A-20-RR 32 SAF017 02304A-20-RR 33 SAF017 02305A-20-BB 34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

PRODUCED BY AN AUTODESK STUDENT VERSION

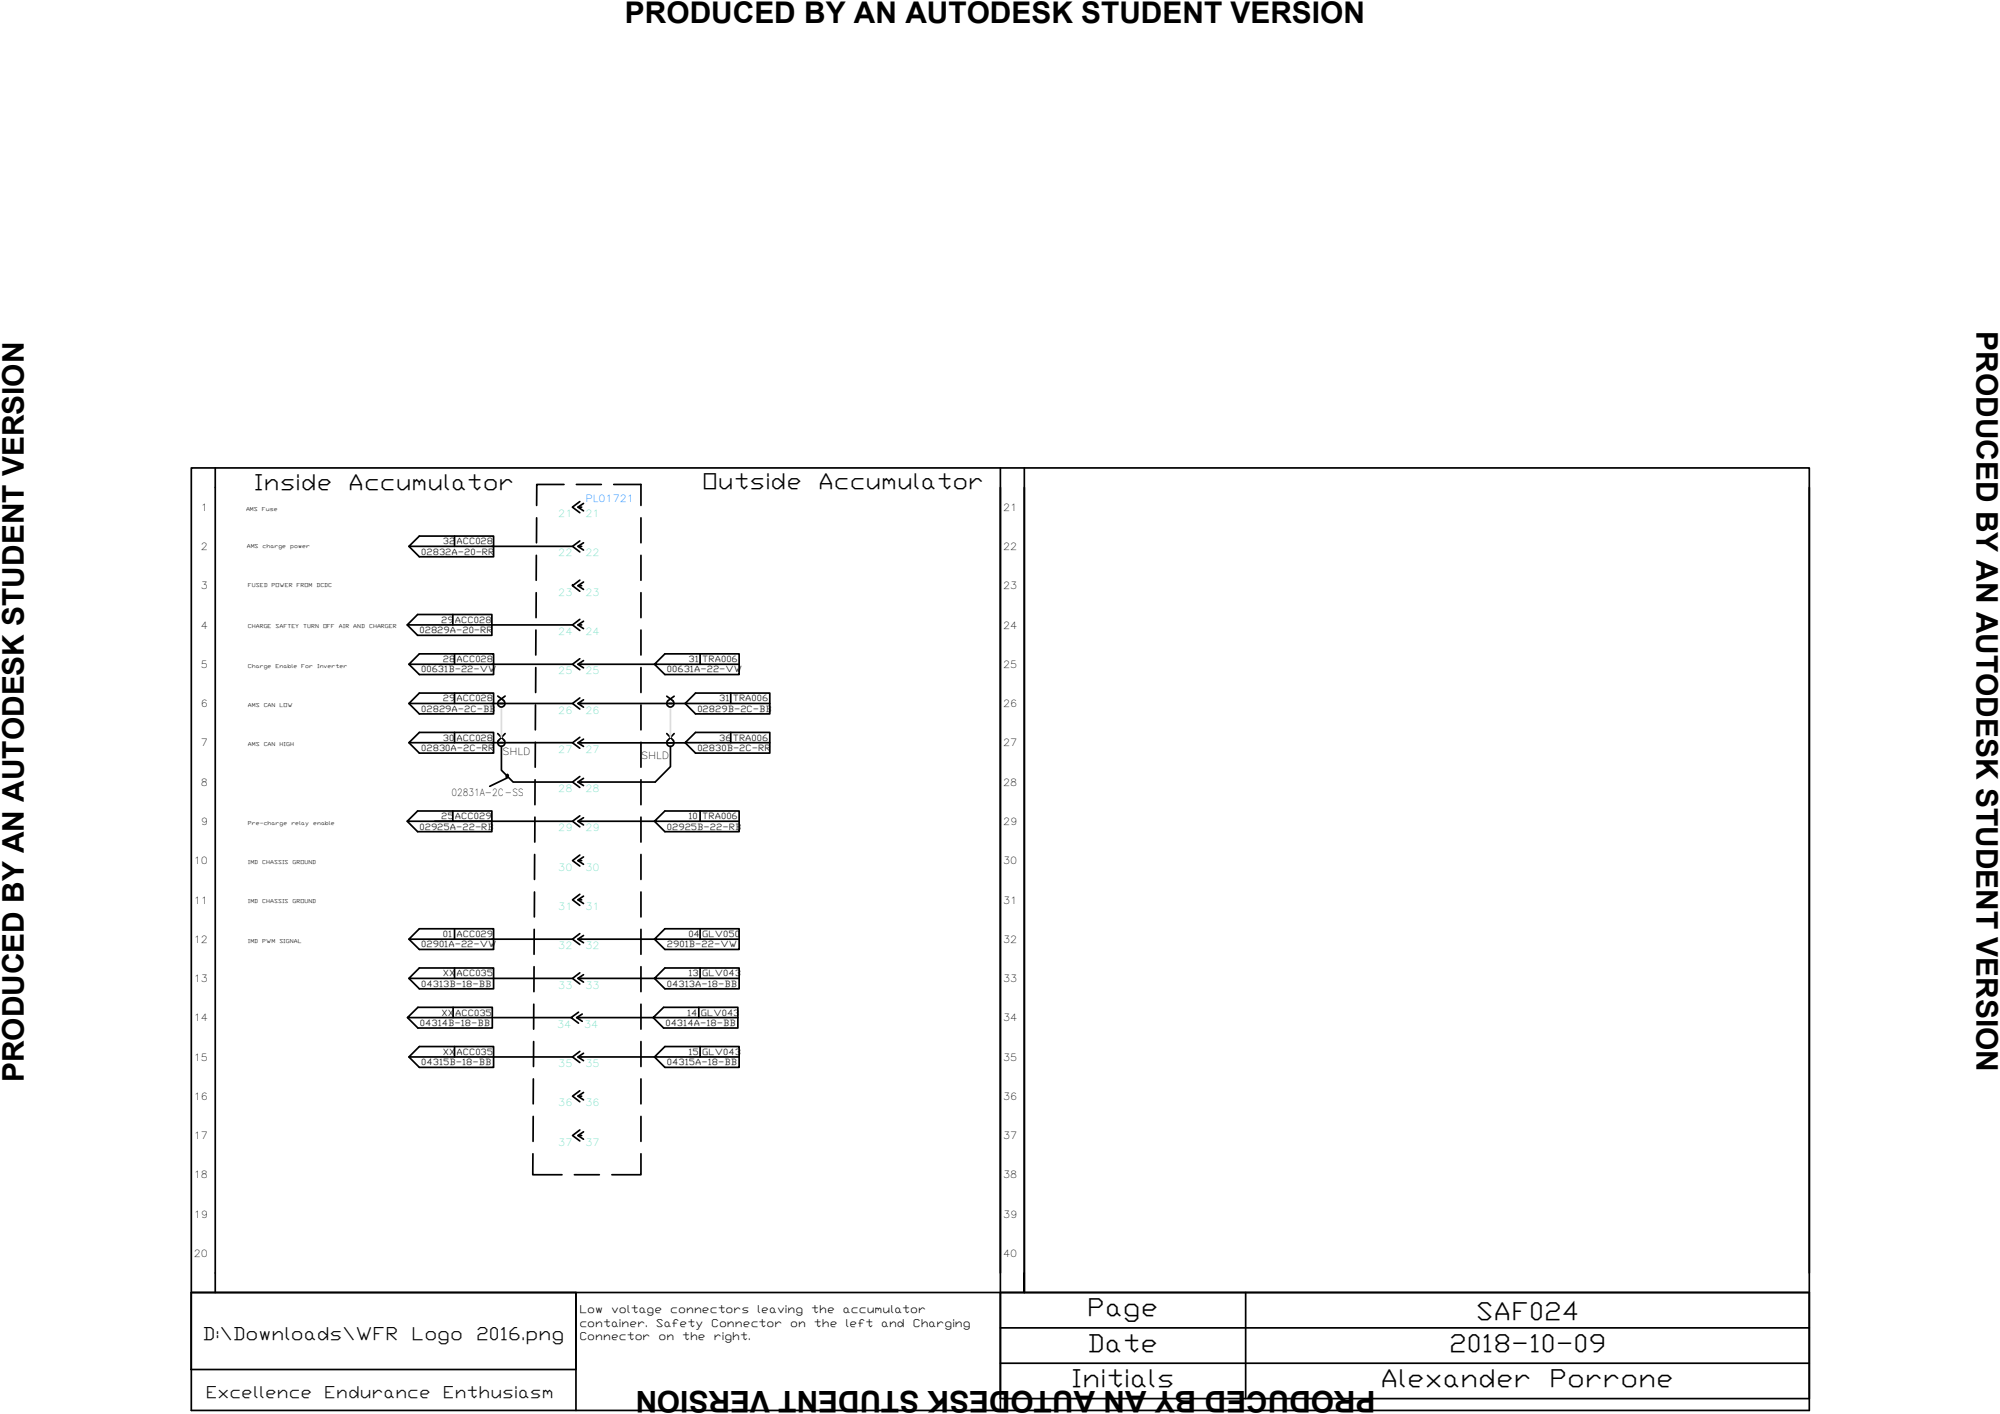
[picture p113: page 20]
Low voltage connectors leaving the accumulator container. Safety Connector on the left and Charging Connector on the right. Excellence Endurance Enthusiasm D:\Downloads\WFR Logo 2016.png; Page; SAF024 Date; 2018-10-09 Initials; Alexander Porrone 1; 37 32ACC028 02832A-20-RR 29ACC028 02829A-20-RR; TRA006 00631A-22-VW 28ACC028 00631B-22-VW; TRA006 02829B-2C-BB 29ACC028 02829A-2C-BB; 36TRA006 02830B-2C-RR 30 ACC028 02830A-2C-RR; TRA006 02925B-22-RB 25ACC029 02925A-22-RB 01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

PRODUCED BY AN AUTODESK STUDENT VERSION

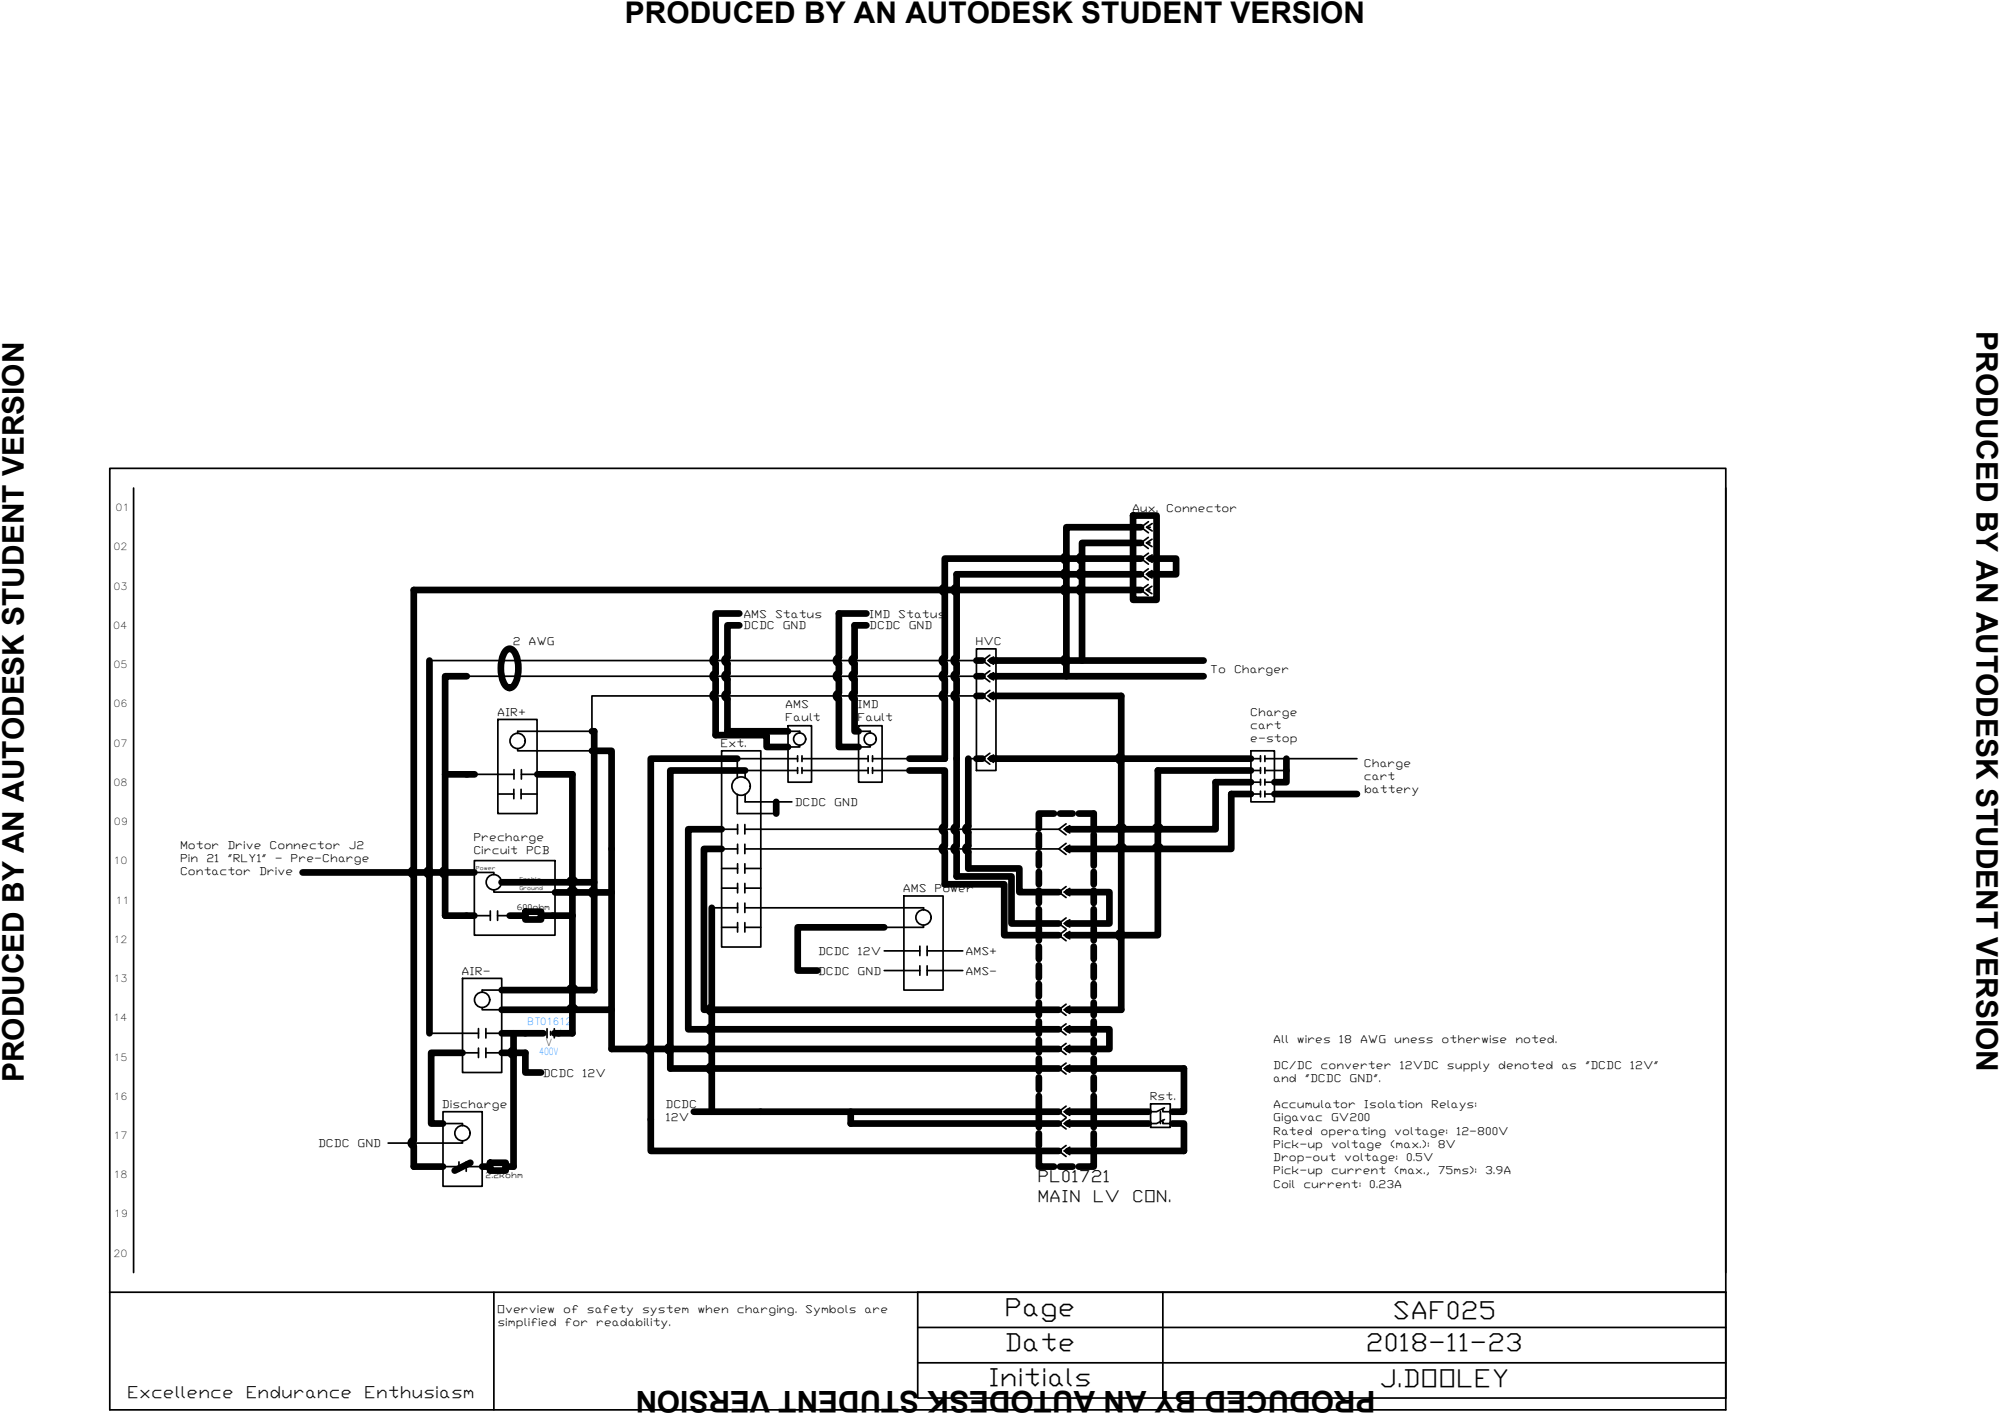
[picture p114: page 21]
Overview of safety system when charging. Symbols are simplified for readability. Excellence Endurance Enthusiasm; Page; SAF025 Date; 2018-11-23 Initials; J.DOOLEY 01 02030405060708091011 121314151617181920; To Charger Charge cart e-stop; Charge cart battery AMS+ AMS- DCDC 12V DCDC GND AIR+; Ext.; HVC AMS Power AIR-; AMS Fault; IMD Fault IMD Status DCDC GND 2 AWG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

PRODUCED BY AN AUTODESK STUDENT VERSION

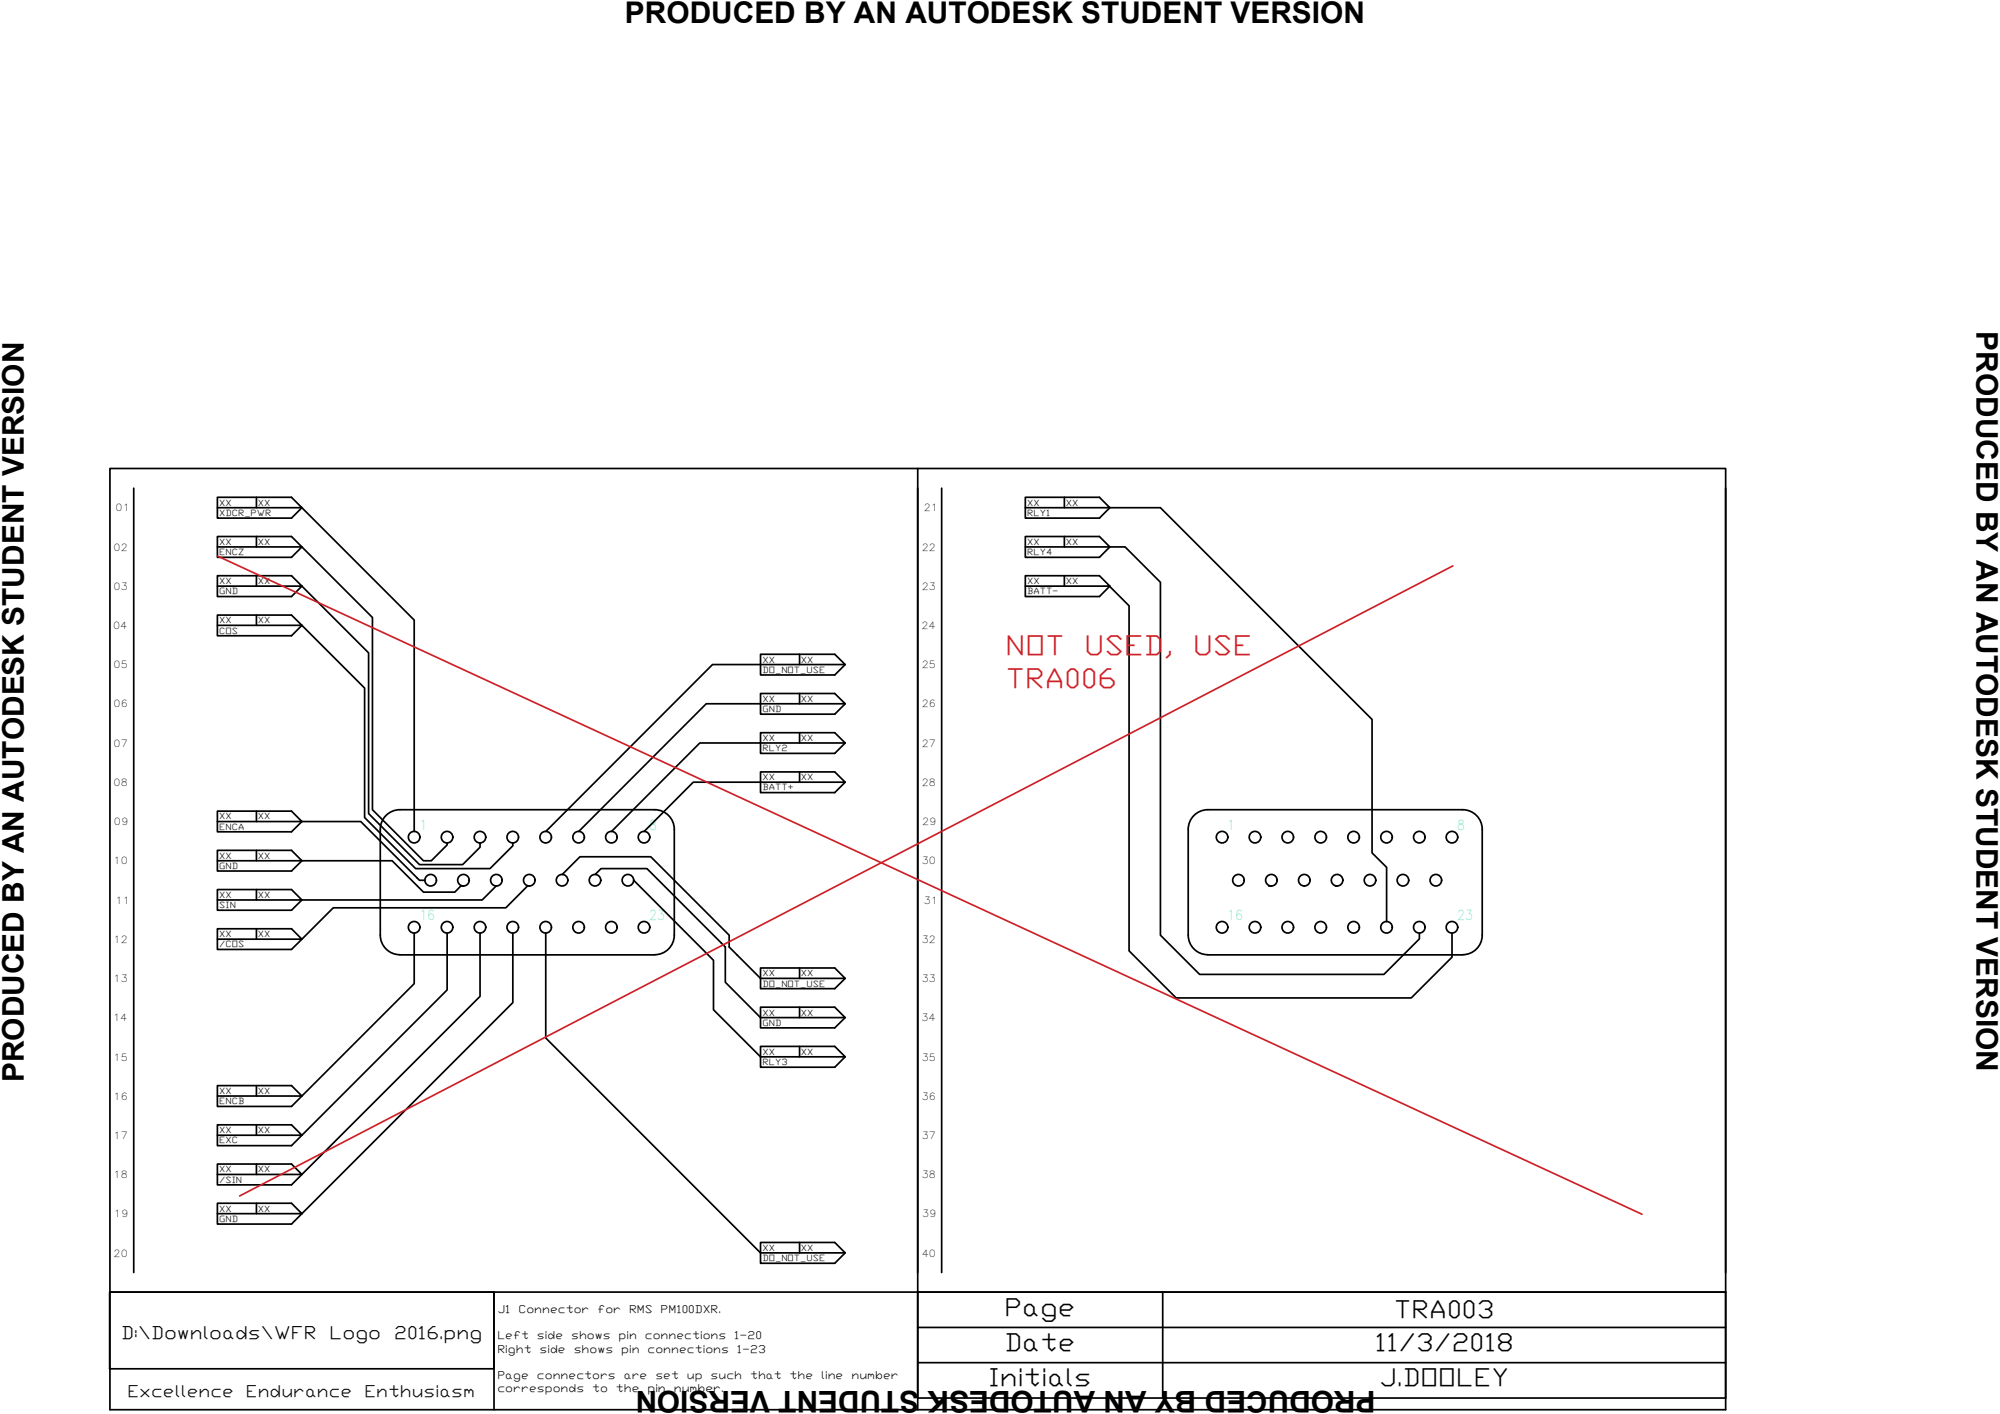
[picture p115: page 22]
J1 Connector for RMS PM100DXR. Left side shows pin connections 1-20 Right side shows pin connections 1-23 Page connectors are set up such that the line number Excellence Endurance Enthusiasm; corresponds to the pin number. D:\Downloads\WFR Logo 2016.png; Page; TRA003 Date; 11/3/2018 Initials; J.DOOLEY 01; 23 XXXDCR_PWRXX XXENCZ; XX XXGND; XX XXCOS; XXDO_NOT_USE XX XXGND; XX XXRLY2; XX XXBATT+; XX XXENCA; XX XXSIN; XX XX/COS; XX XXRLY3; XX XXENCB; XX XXEXC; XX XX/SIN; XXDO_NOT_USE XX; 23 XXRLY1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

PRODUCED BY AN AUTODESK STUDENT VERSION

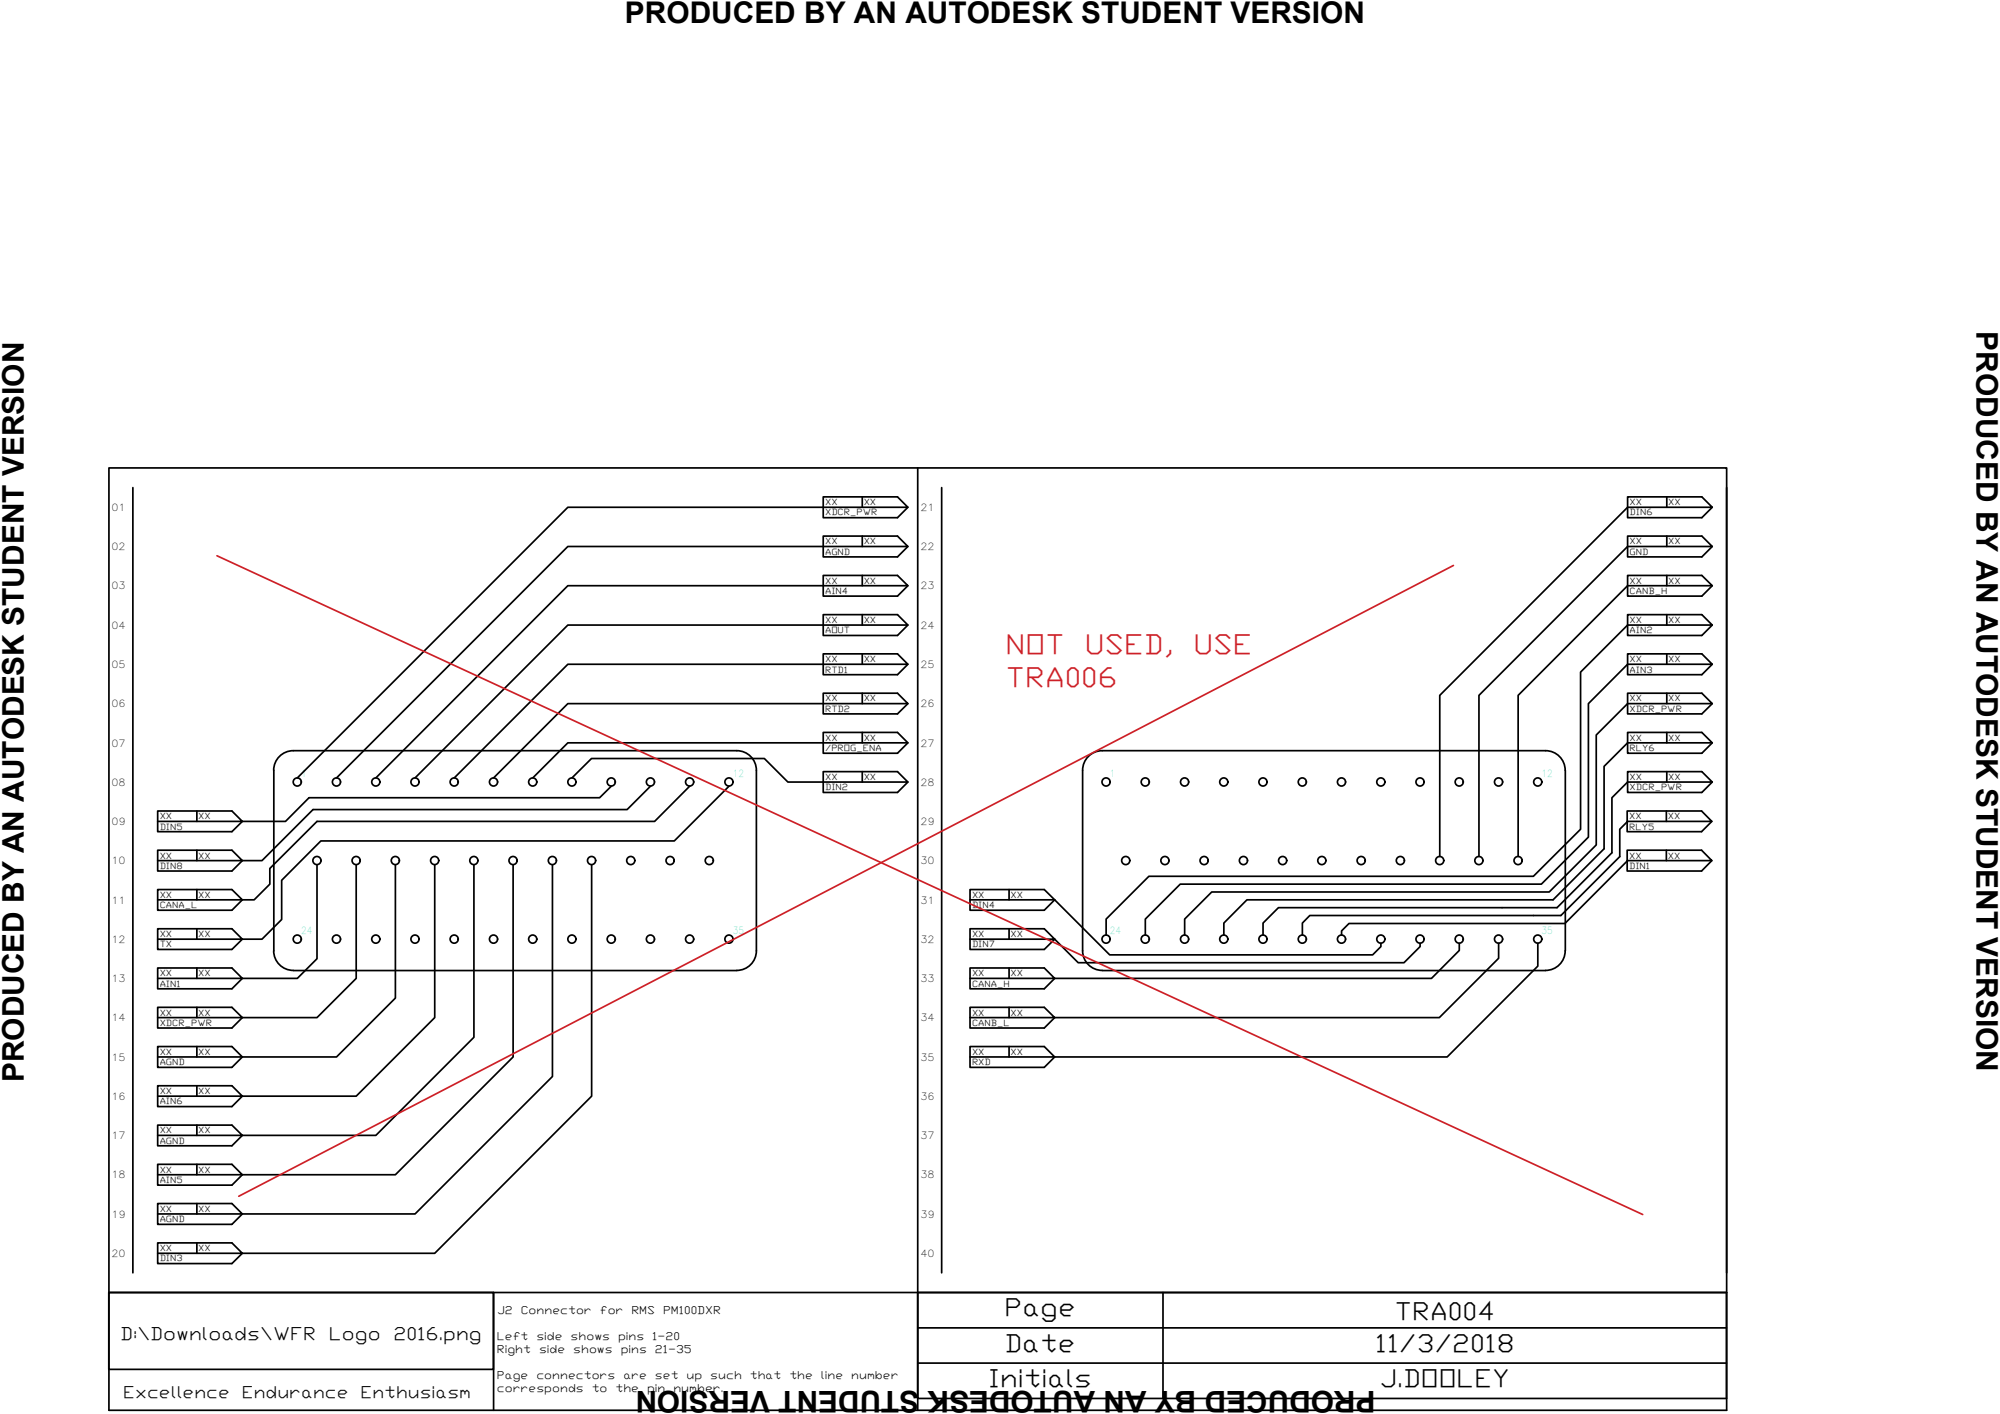
[picture p116: page 23]
J2 Connector for RMS PM100DXR Left side shows pins 1-20 Right side shows pins 21-35 Page connectors are set up such that the line number Excellence Endurance Enthusiasm; corresponds to the pin number. D:\Downloads\WFR Logo 2016.png; Page; TRA004 Date; 11/3/2018 Initials; J.DOOLEY 01; XXXDCR_PWRXX XXAGND; XX XXAIN4; XX XXAOUT; XX XXRTD1; XX XXRTD2; XX XX/PROG_ENA XX XXDIN2; XX XXDIN5; XX XXDIN8; XX XXCANA_LXX XXTX; XX XXAIN1; XX XXXDCR_PWRXX XXAGND; XX XXAIN6; XX XXAGND; XX XXAIN5; XX XXDIN3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

PRODUCED BY AN AUTODESK STUDENT VERSION

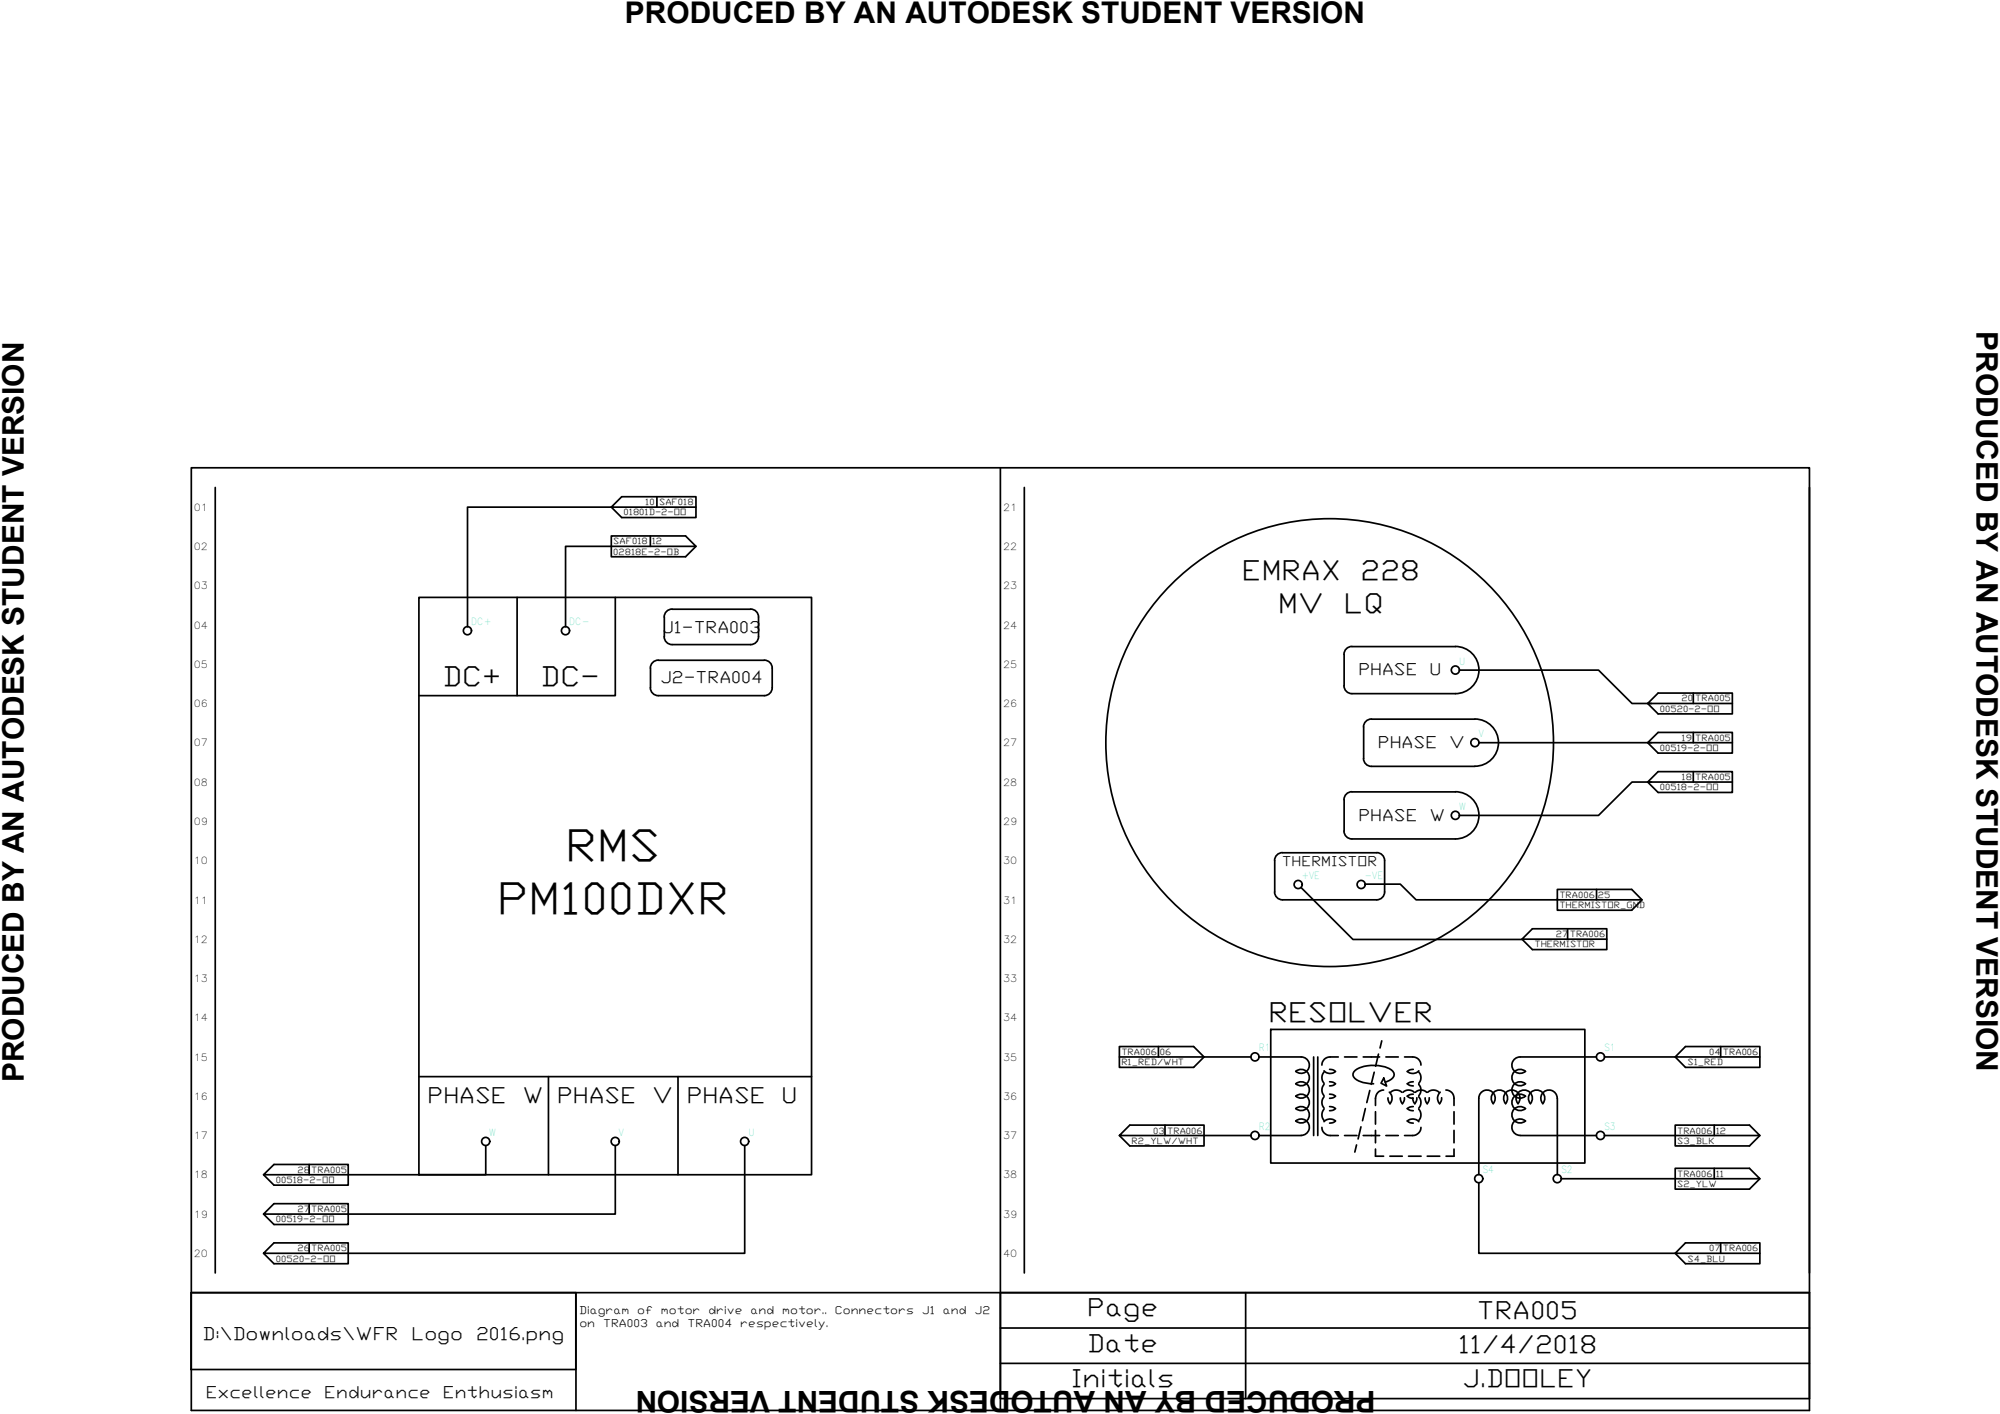
[picture p117: page 24]
Diagram of motor drive and motor.. Connectors J1 and J2 on TRA003 and TRA004 respectively. Excellence Endurance Enthusiasm D:\Downloads\WFR Logo 2016.png; Page; TRA005 Date; 11/4/2018 Initials; J.DOOLEY 01; SAF018 02818E-2-OB 12 10; SAF018 01801D-2-OO 28TRA005 00518-2-OO 27TRA005 00519-2-OO 26TRA005 00520-2-OO; J1-TRA003 J2-TRA004 W; DC- PHASE W; PHASE V; PHASE U RMS PM100DXR; 20 TRA005 00520-2-OO 19; TRA005 00519-2-OO 18; TRA005 00518-2-OO U; V W PHASE U PHASE V PHASE W EMRAX 228 MV LQ +VE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

PRODUCED BY AN AUTODESK STUDENT VERSION

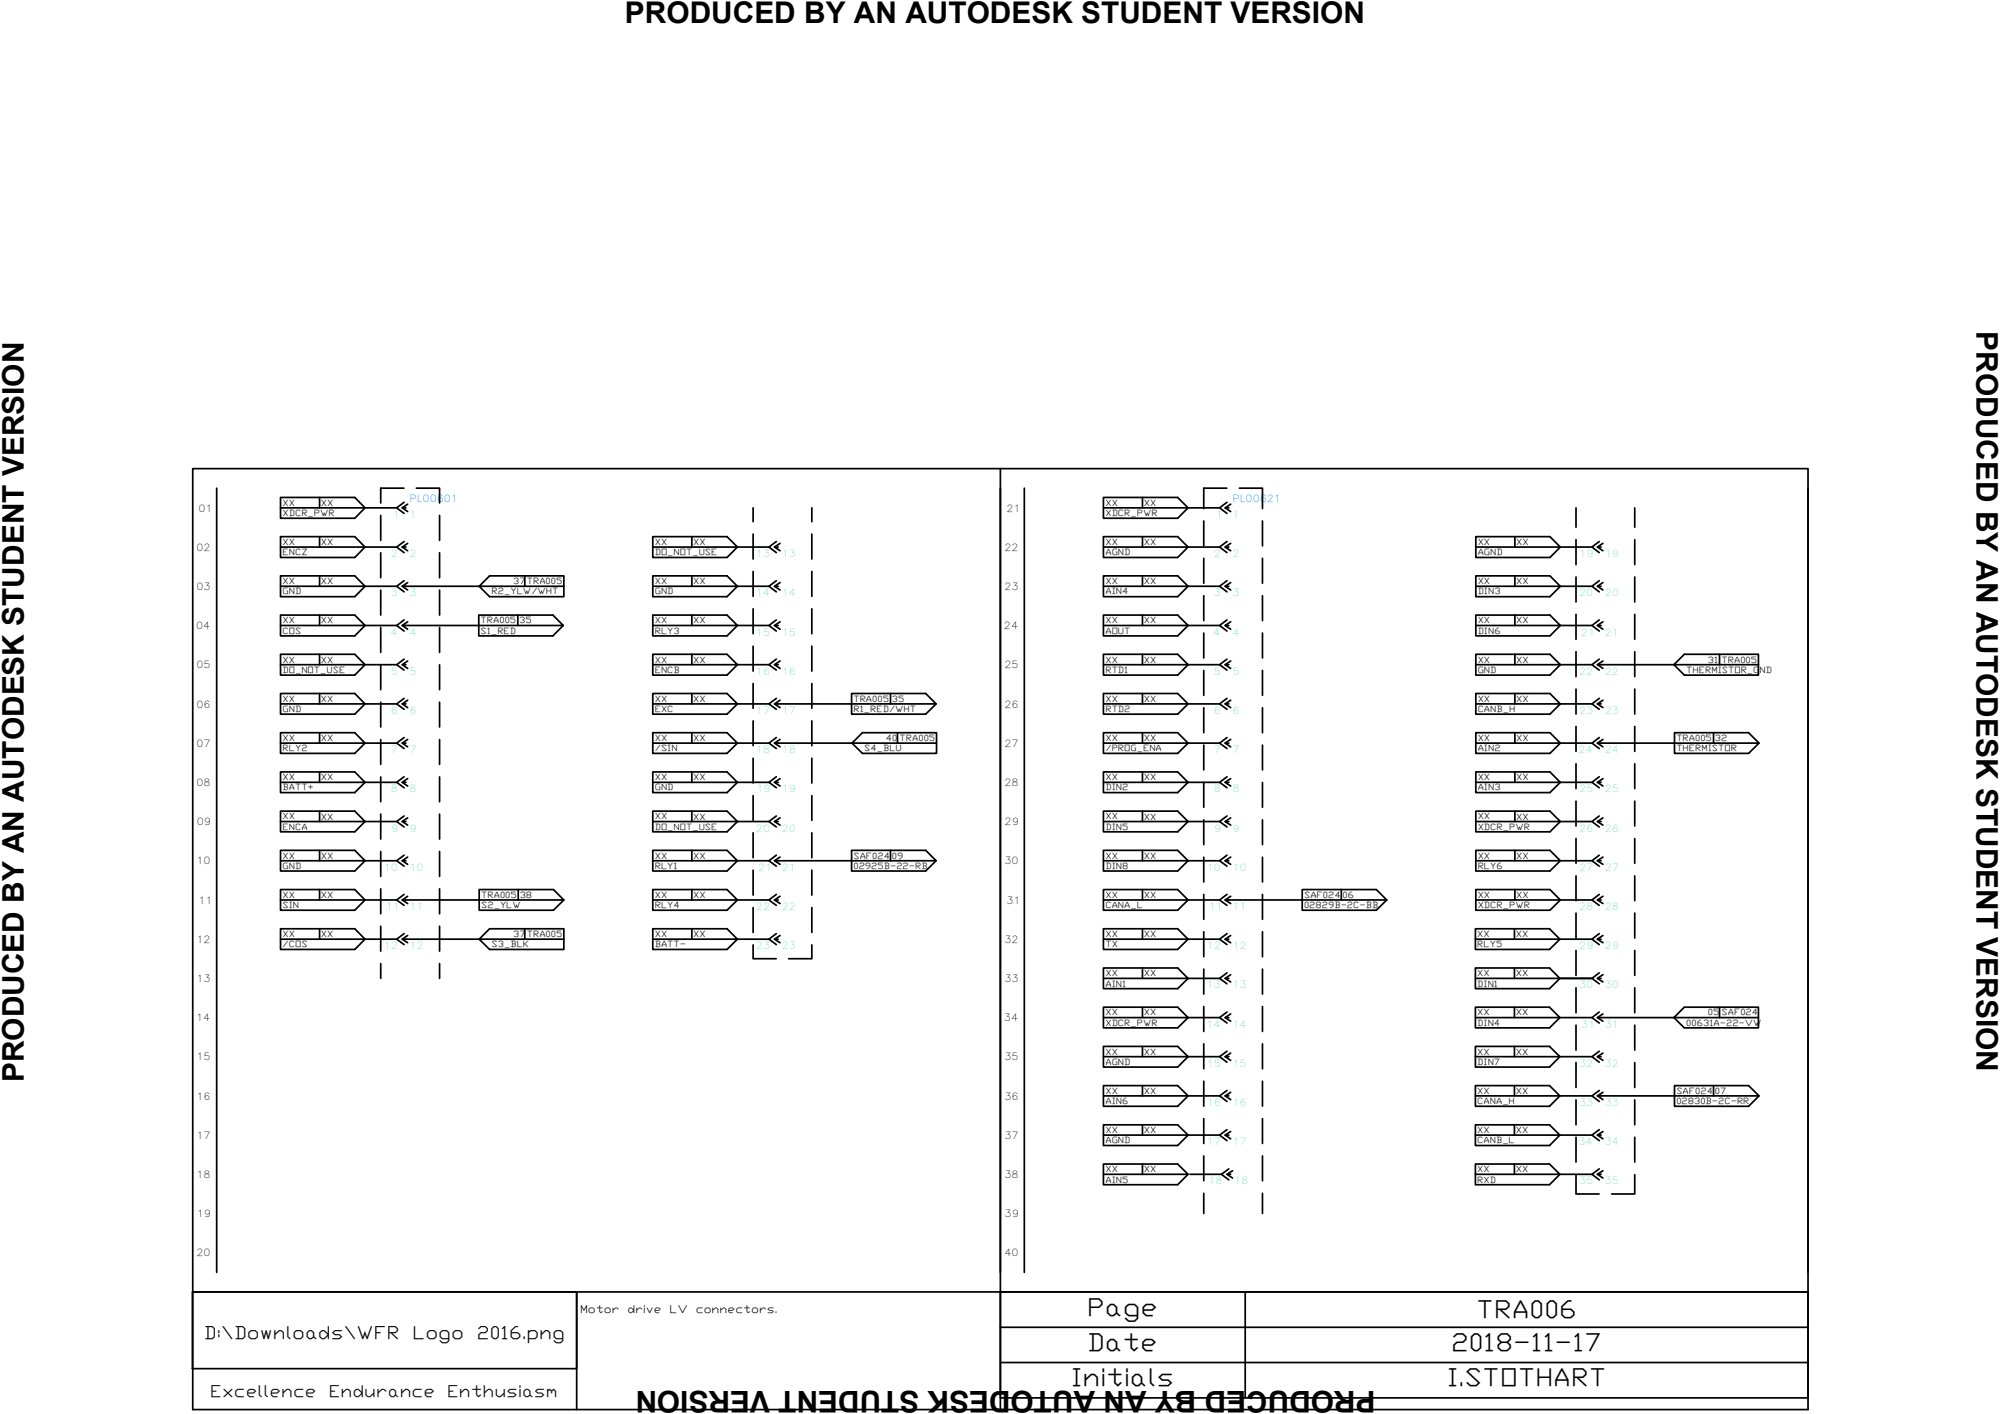
[picture p118: page 25]
Motor drive LV connectors. Excellence Endurance Enthusiasm D:\Downloads\WFR Logo 2016.png; Page; TRA006 Date; 2018-11-17 Initials; I.STOTHART 01; 35 XXXDCR_PWR XX XXENCZ; XX XXGND; XX XXCOS; XX XXDO_NOT_USE XX XXGND; XX XXRLY2; XX XXBATT+; XX XXENCA; XX XXSIN; XX XX/COS; XXDO_NOT_USE XX XXGND; XX XXRLY3; XX XXENCB; XX XXEXC; XX XX/SIN; XX XXDO_NOT_USE XX XXRLY1; XX XXRLY4; XX XXBATT-; XXXDCR_PWR XX XXAGND; XX XXAIN4; XX XXAOUT; XX XXRTD1; XX XXRTD2; XX XX/PROG_ENA XX XXDIN2; XX XXDIN5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

PRODUCED BY AN AUTODESK STUDENT VERSION

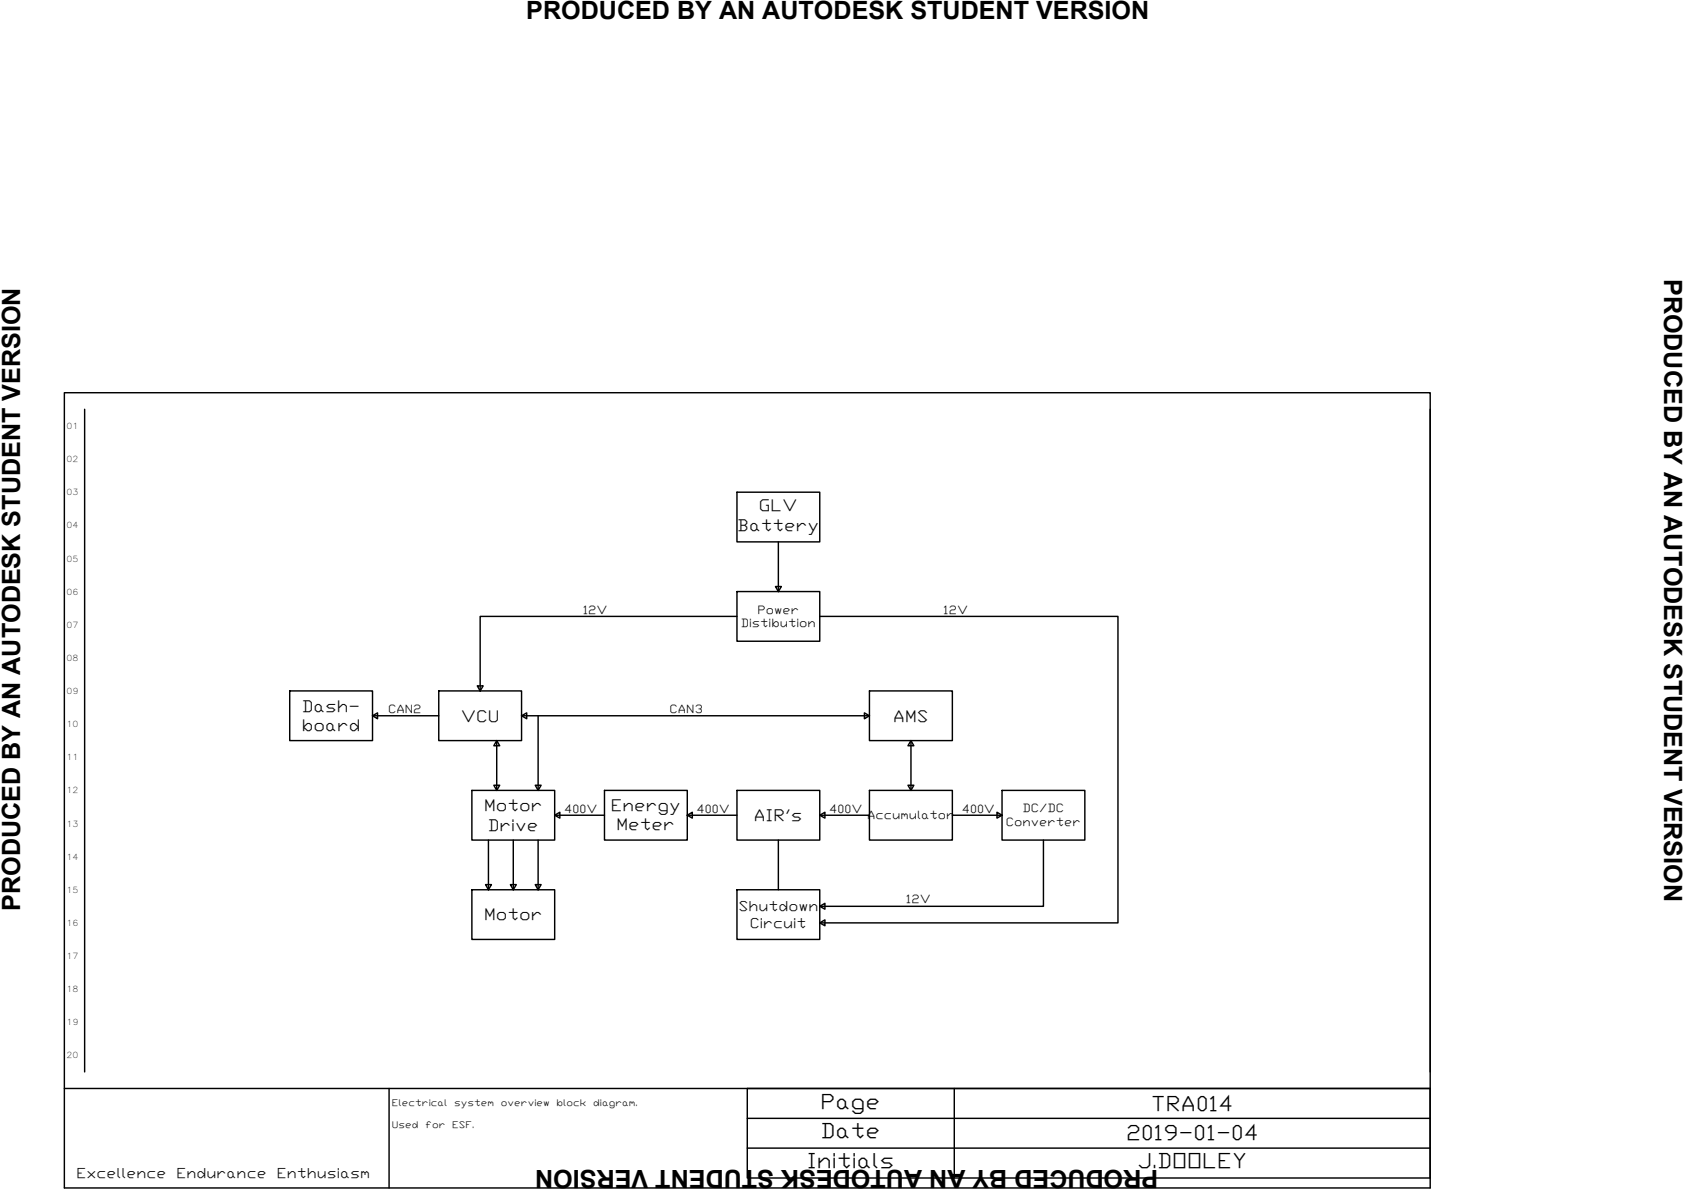
[picture p119: page 26]
Electrical system overview block diagram. Used for ESF. Excellence Endurance Enthusiasm; Page; TRA014 Date; 2019-01-04 Initials; J.DOOLEY 0102030405060708091011121314151617181920; Dash- board; VCUMotor Drive Motor; Energy Meter; AIR's Shutdown Circuit; Accumulator AMS Power Distibution GLV Battery; DC/DC Converter CAN2; CAN3 12V

PRODUCED BY AN AUTODESK STUDENT VERSION

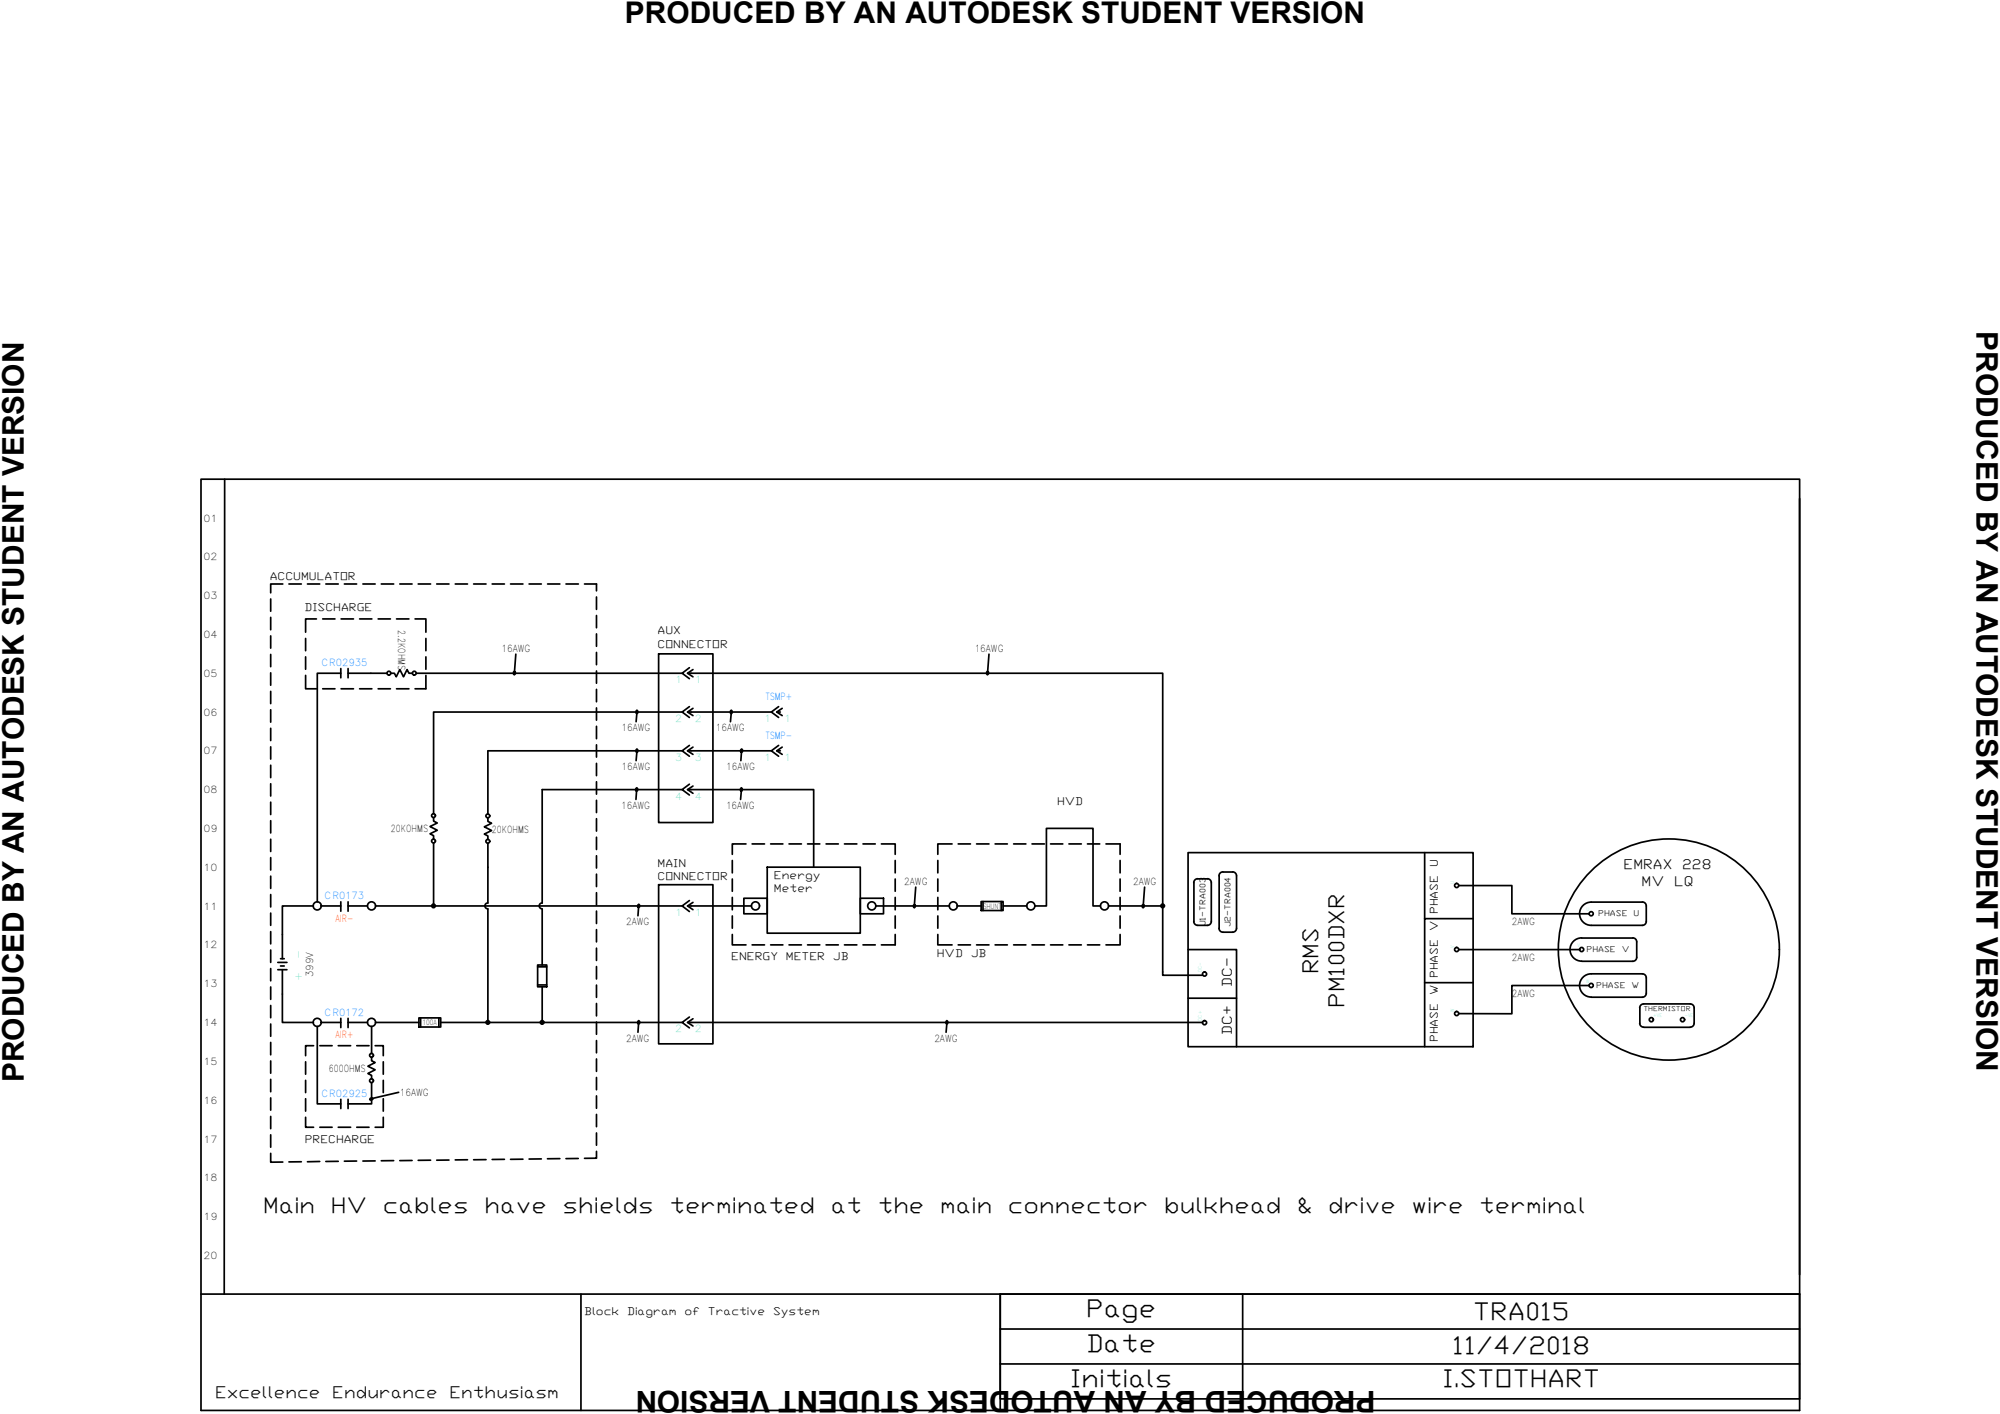
[picture p120: page 27]
Block Diagram of Tractive System Excellence Endurance Enthusiasm; Page; TRA015 Date; 11/4/2018 Initials; I.STOTHART 0102030405060708091011121314151617181920; J2-TRA004 W V U; 2.2KOHMS DISCHARGE CR02925 600OHMS PRECHARGE 4 4 16AWG 16AWG 16AWG

PRODUCED BY AN AUTODESK STUDENT VERSION

399V- MAIN CONNECTOR 2AWG 2AWG 16AWG 16AWG 16AWG 16AWG 16AWG 16AWG 2AWG 2AWG 2AWG 20KOHMS 20KOHMS HVD Main HV cables have shields terminated at the main connector bulkhead & drive wire terminal 2AWG 2AWG 2AWG ACCUMULATOR CR02935

PM100DXRU V W PHASE U PHASE V PHASE WEMRAX 228 MV LQ +VE -VE THERMISTOR AIR+ CR0172 AIR- CR0173 2 2 1 1 Energy Meter HVD JBSHUNT TSMP+ 1 1 TSMP- 1 1 ENERGY METER JB 100A AUX CONNECTOR 3 3 2 2 1 1 +

PHASE W PHASE V PHASE U RMS
