andrewrichardr/WFR2020/ESF/Figs/HVIBDC.pdf

HIGH VO LTAG E CIRCUIT | LO W VO LTAG E CIRCUIT

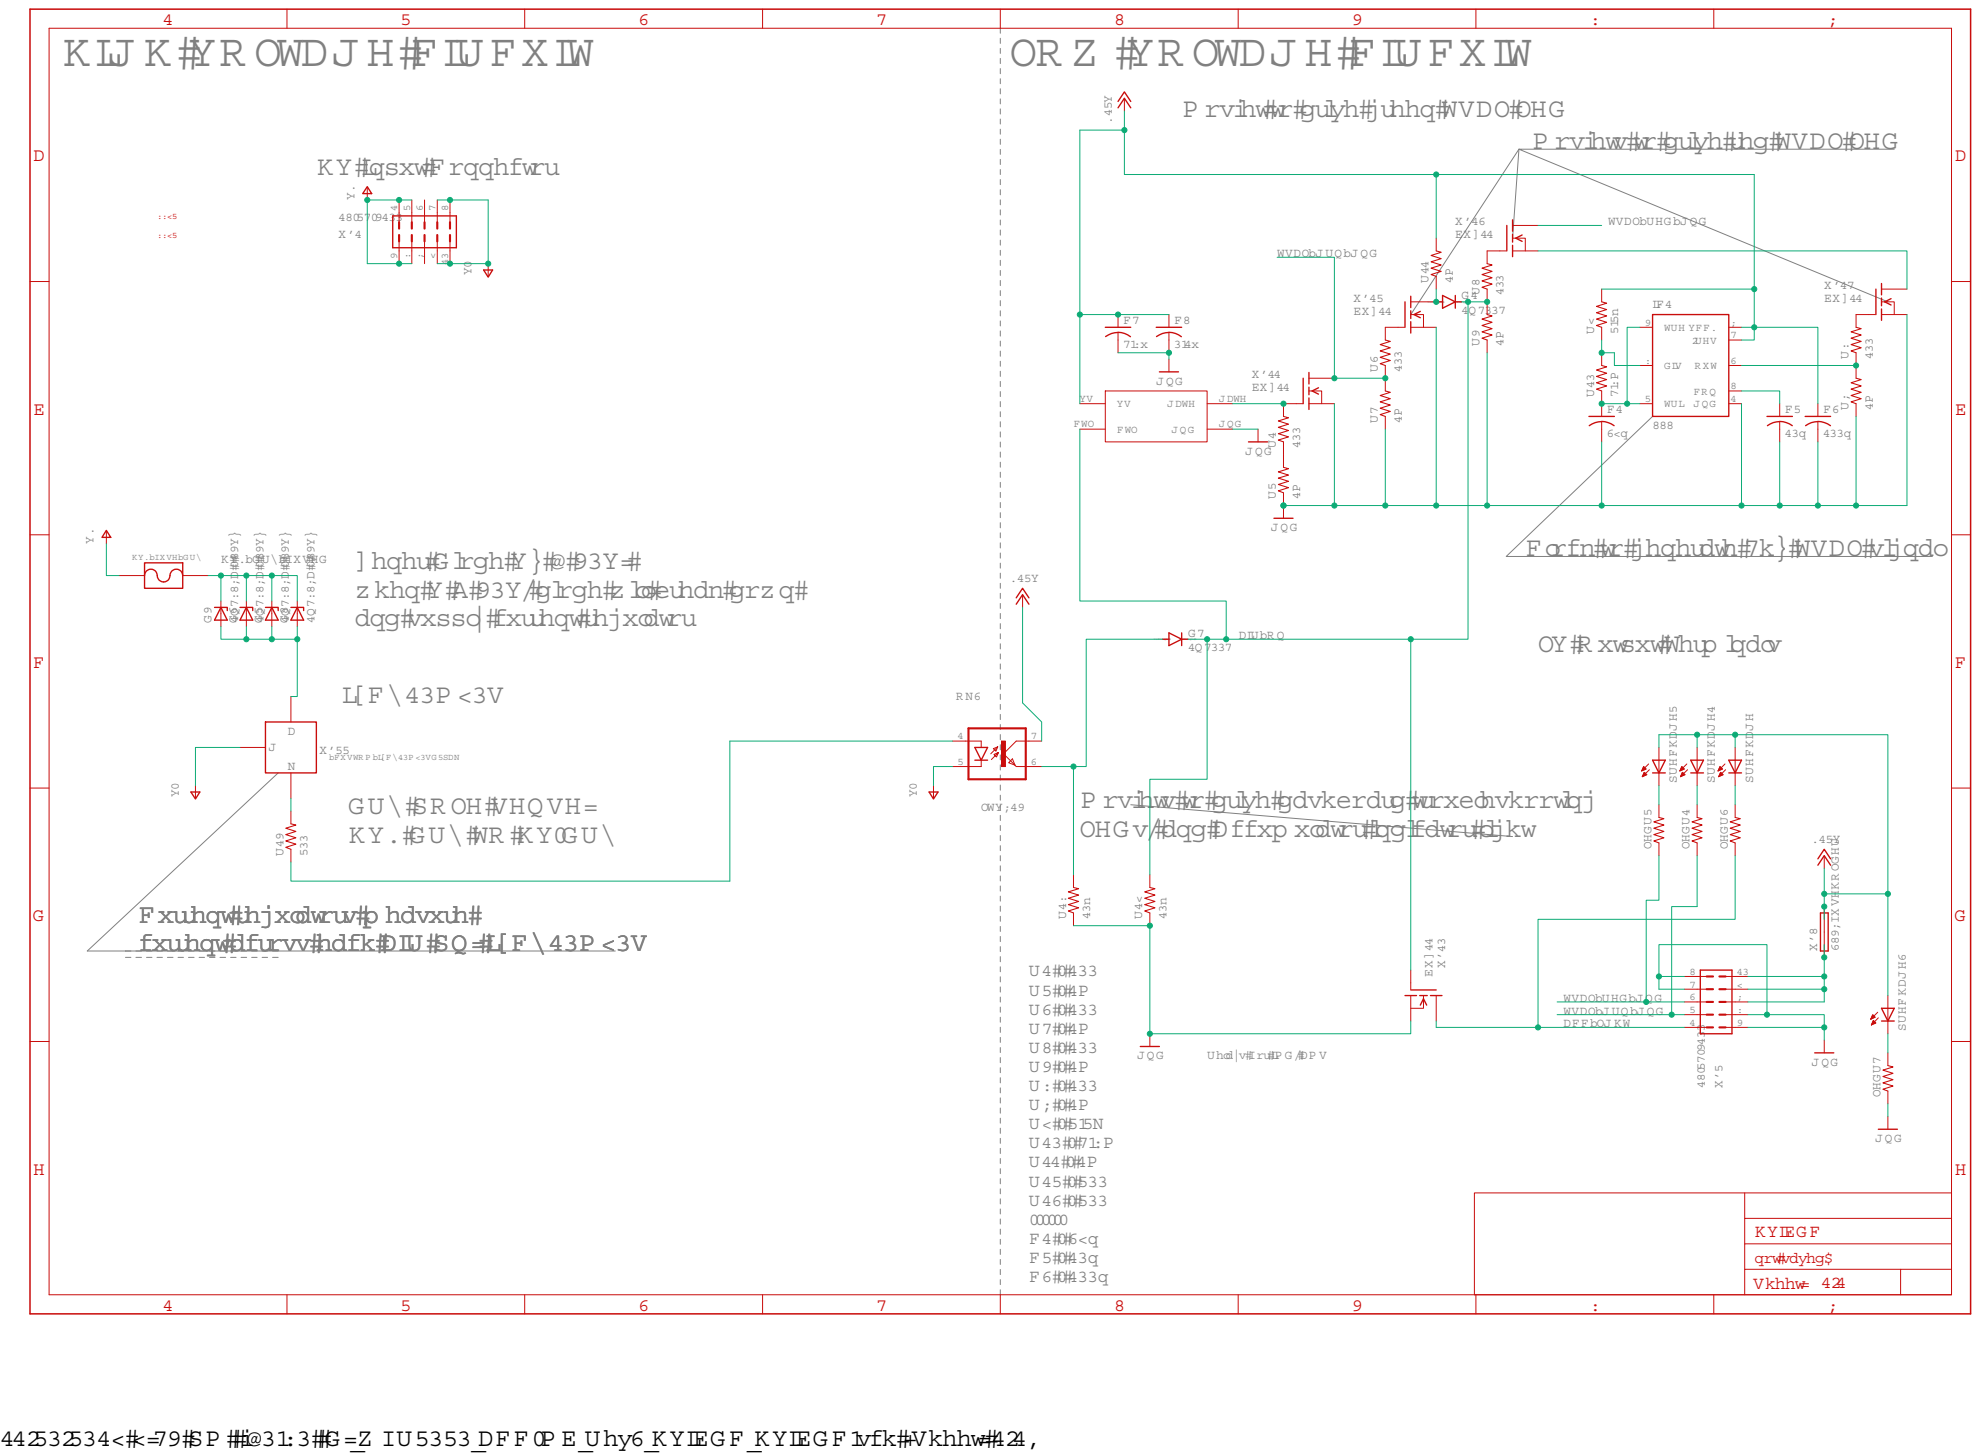
[picture p121: page 1]

M osfet to drive green TSAL LED

M osfets to drive red TSAL LED

Zener Diode Vz = 60V:
w hen V > 60V, diode will break dow n
and supply current regulator

Clock to generate 4hz TSAL signal

M osfets to drive dashboard troubleshooting
LED s, and Accum ulator indicator light

C urrent regulators m easure
current across each AIR PN: IXC Y10M 90S

R elays For IMD, AM S

\W FR 2020\ACC-M B\R ev3\HVIBDC\HVIBDC.sch (Sheet: 1/1)
