andrewrichardr/WFR2020/ACC-MB/Rev4/DCDCDC-r2/DCDCDC-R2-layout.pdf

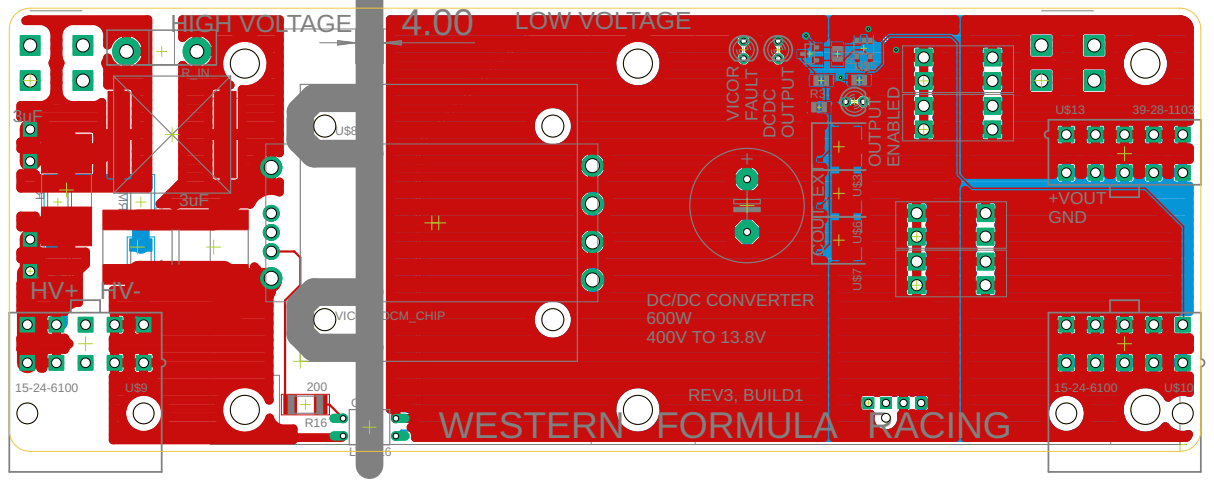
[picture p122: page 1]

R9 R10 HIGH VOLTAGE 4.00 LOW VOLTAGE

FAULT DCDC OUTPUT OUTPUT ENABLED
