andrewrichardr/WFR2020/ACC-MB/Rev4/AIRDCL/AIRDCL-sch.pdf

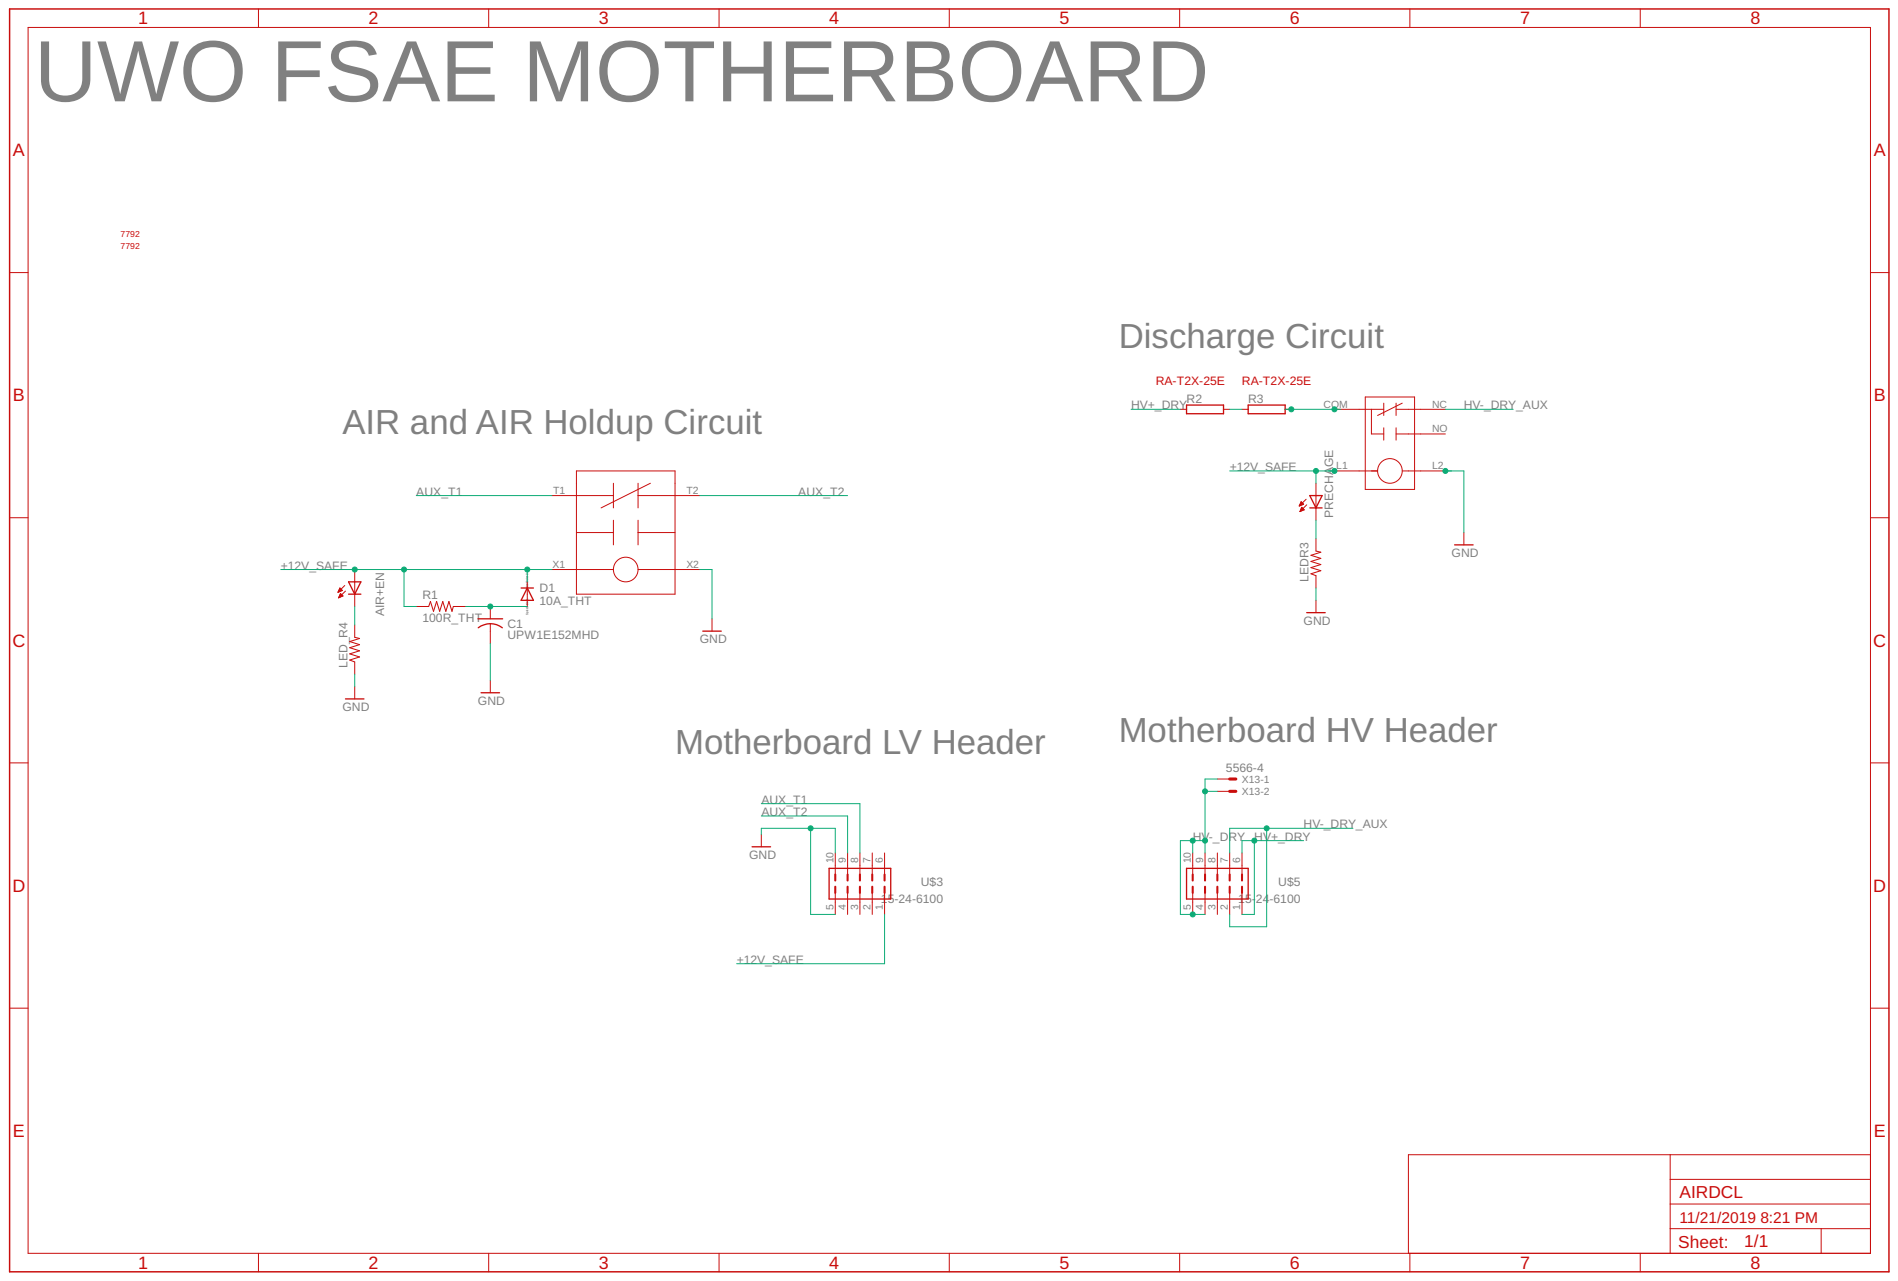
[picture p123: page 1]

SpiceOrder 1 SpiceOrder 2 SpiceOrder 1 SpiceOrder 2 UWO FSAE MOTHERBOARD

AIR and AIR Holdup Circuit
