andrewrichardr/WFR2020/ACC-MB/Rev4/AIRDCR/AIRDCR-sch.pdf

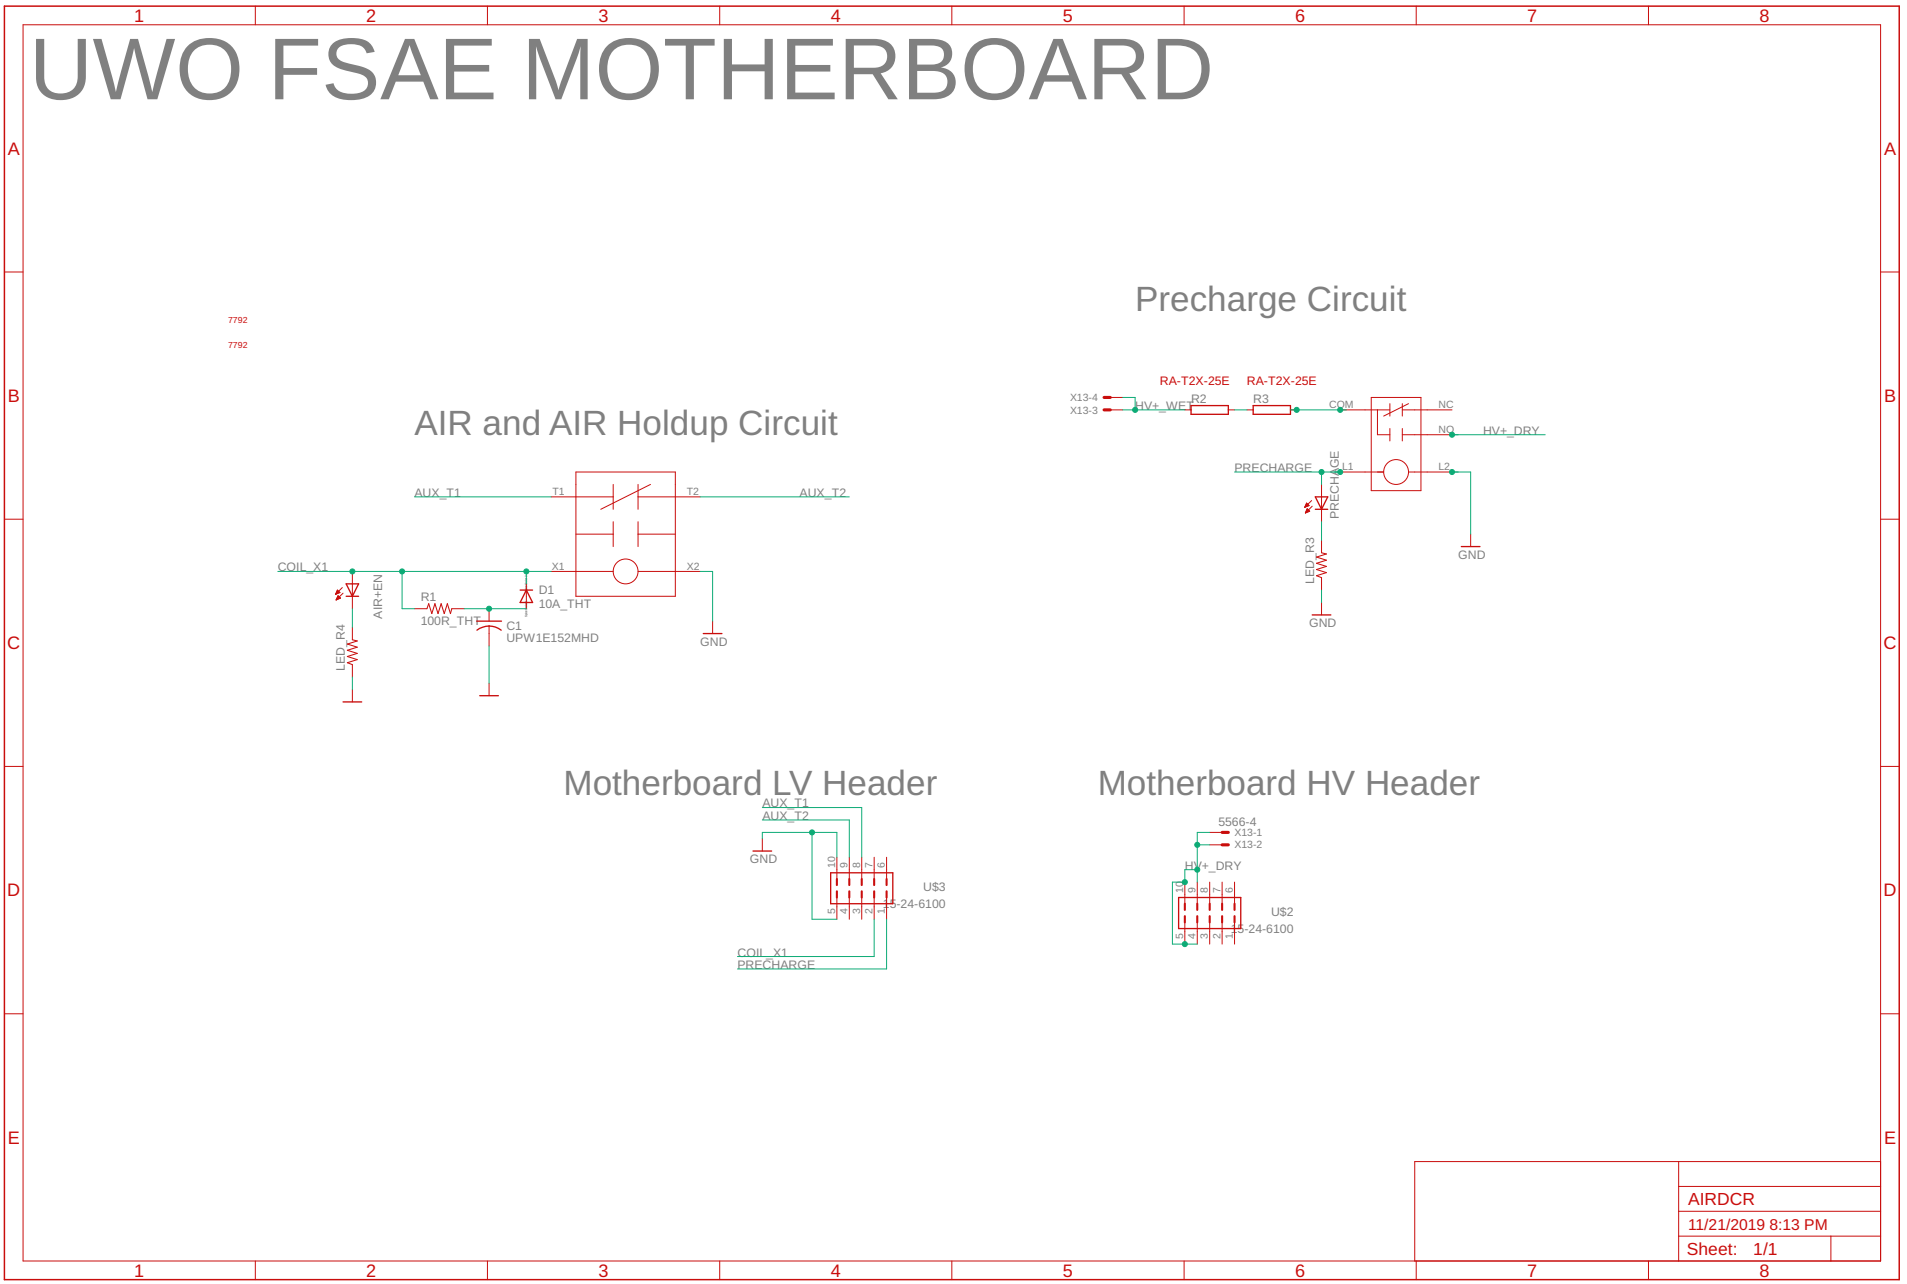
[picture p124: page 1]

SpiceOrder 1 SpiceOrder 2 SpiceOrder 1 SpiceOrder 2 UWO FSAE MOTHERBOARD

AIR and AIR Holdup Circuit
