andrewrichardr/WFR2020/ACC-MB/Rev4/MainBoard/Main1.pdf

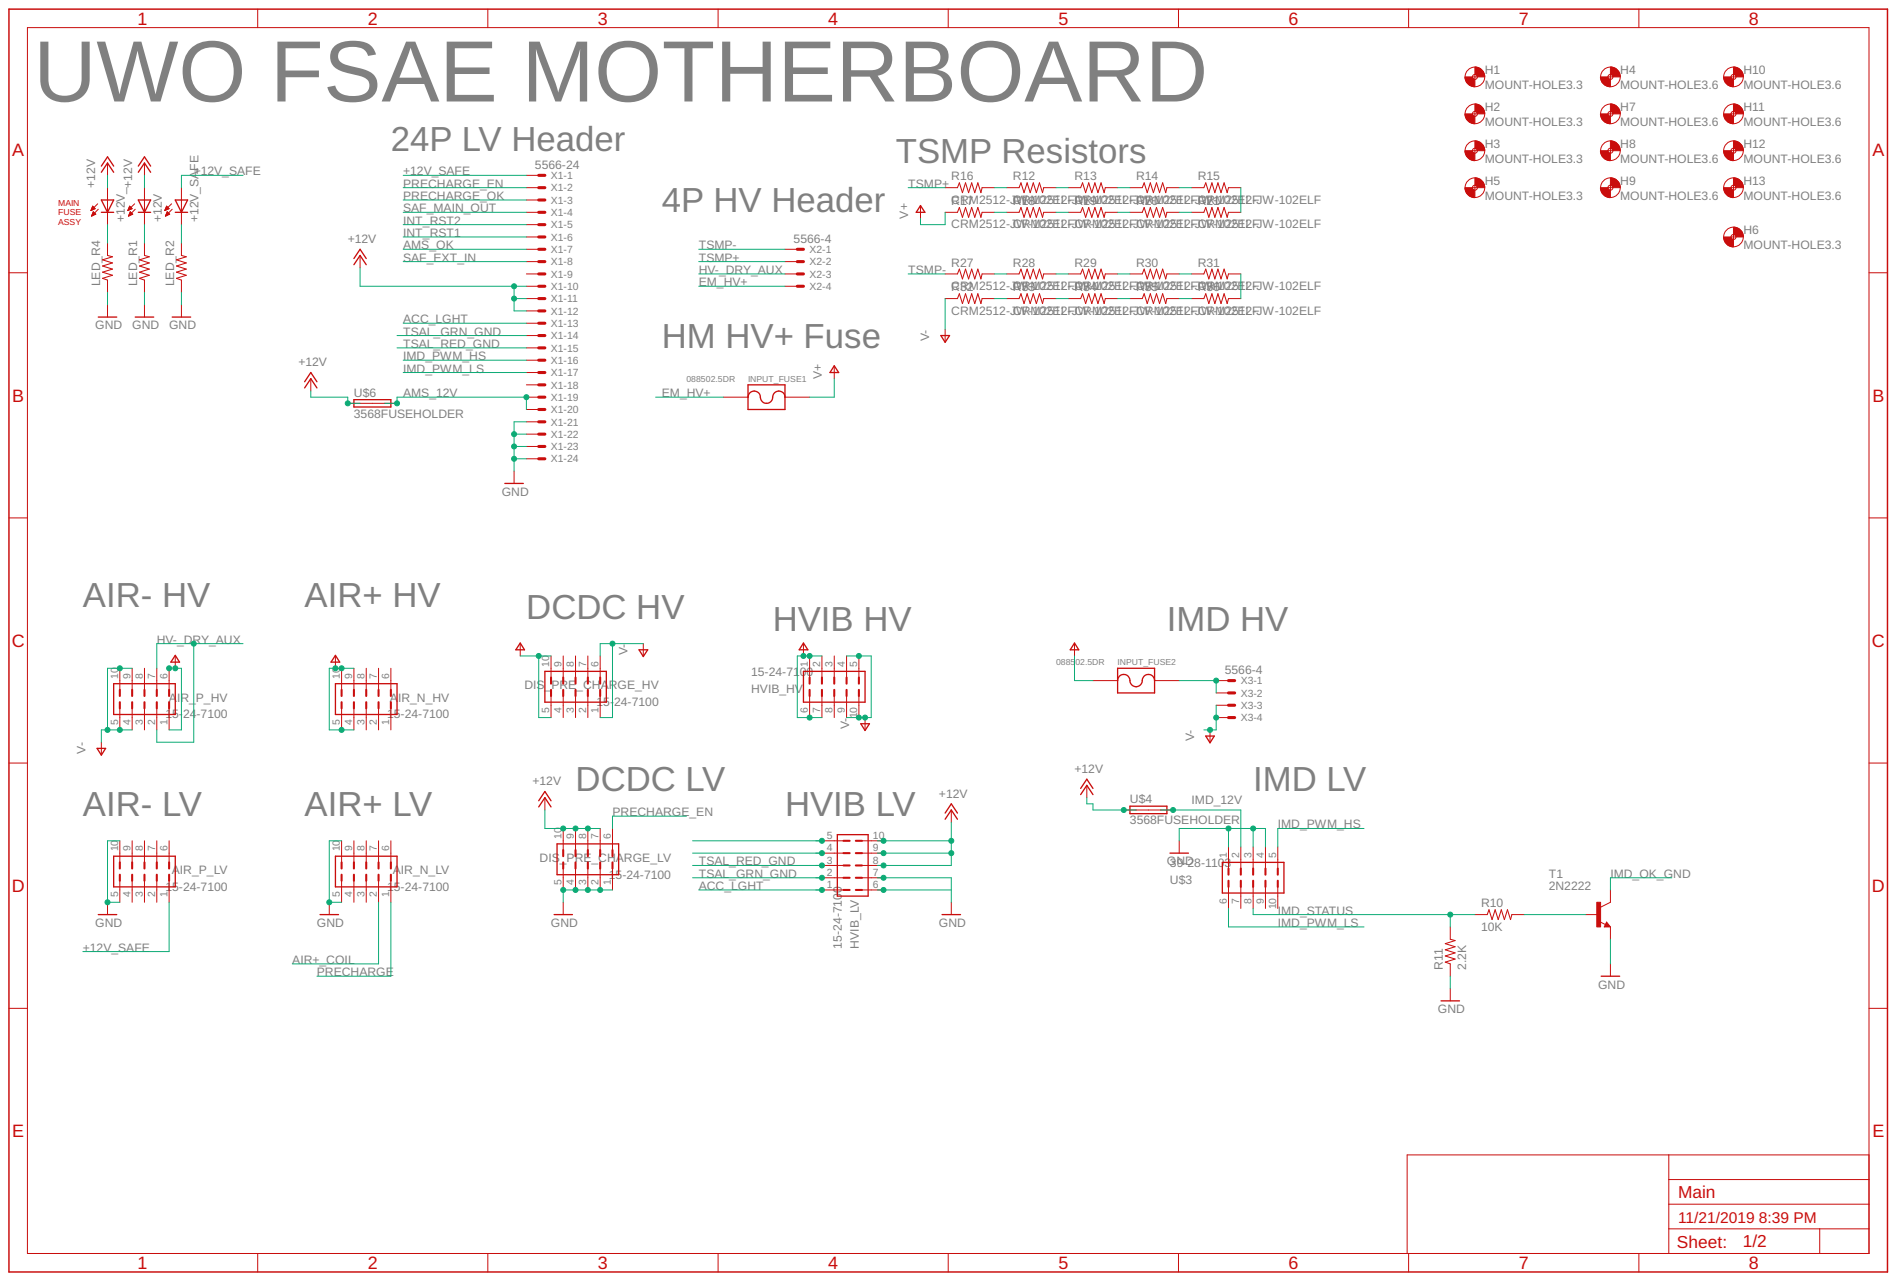
[picture p125: page 1]

MOUNT-HOLE3.6 MOUNT-HOLE3.6

TSMP Resistors 24P LV Header +12V

CRM2512-JCWR-M10225E1L2F-JCWR-M10225E1L2F-JCWR-M10225E1L2F-JCWR-M10225E1L2F-JW-102ELF CRM2512-JCWR-M10225E1L2F-JCWR-M10225E1L2F-JCWR-M10225E1L2F-JCWR-M10225E1L2F-JW-102ELF CRM2512-JCWR-M10225E1L2F-JCWR-M10225E1L2F-JCWR-M10225E1L2F-JCWR-M10225E1L2F-JW-102ELF CRM2512-JCWR-M10225E1L2F-JCWR-M10225E1L2F-JCWR-M10225E1L2F-JCWR-M10225E1L2F-JW-102ELF V- V+
