andrewrichardr/WFR2020/ACC-MB/Rev4/MainBoard/Main2.pdf

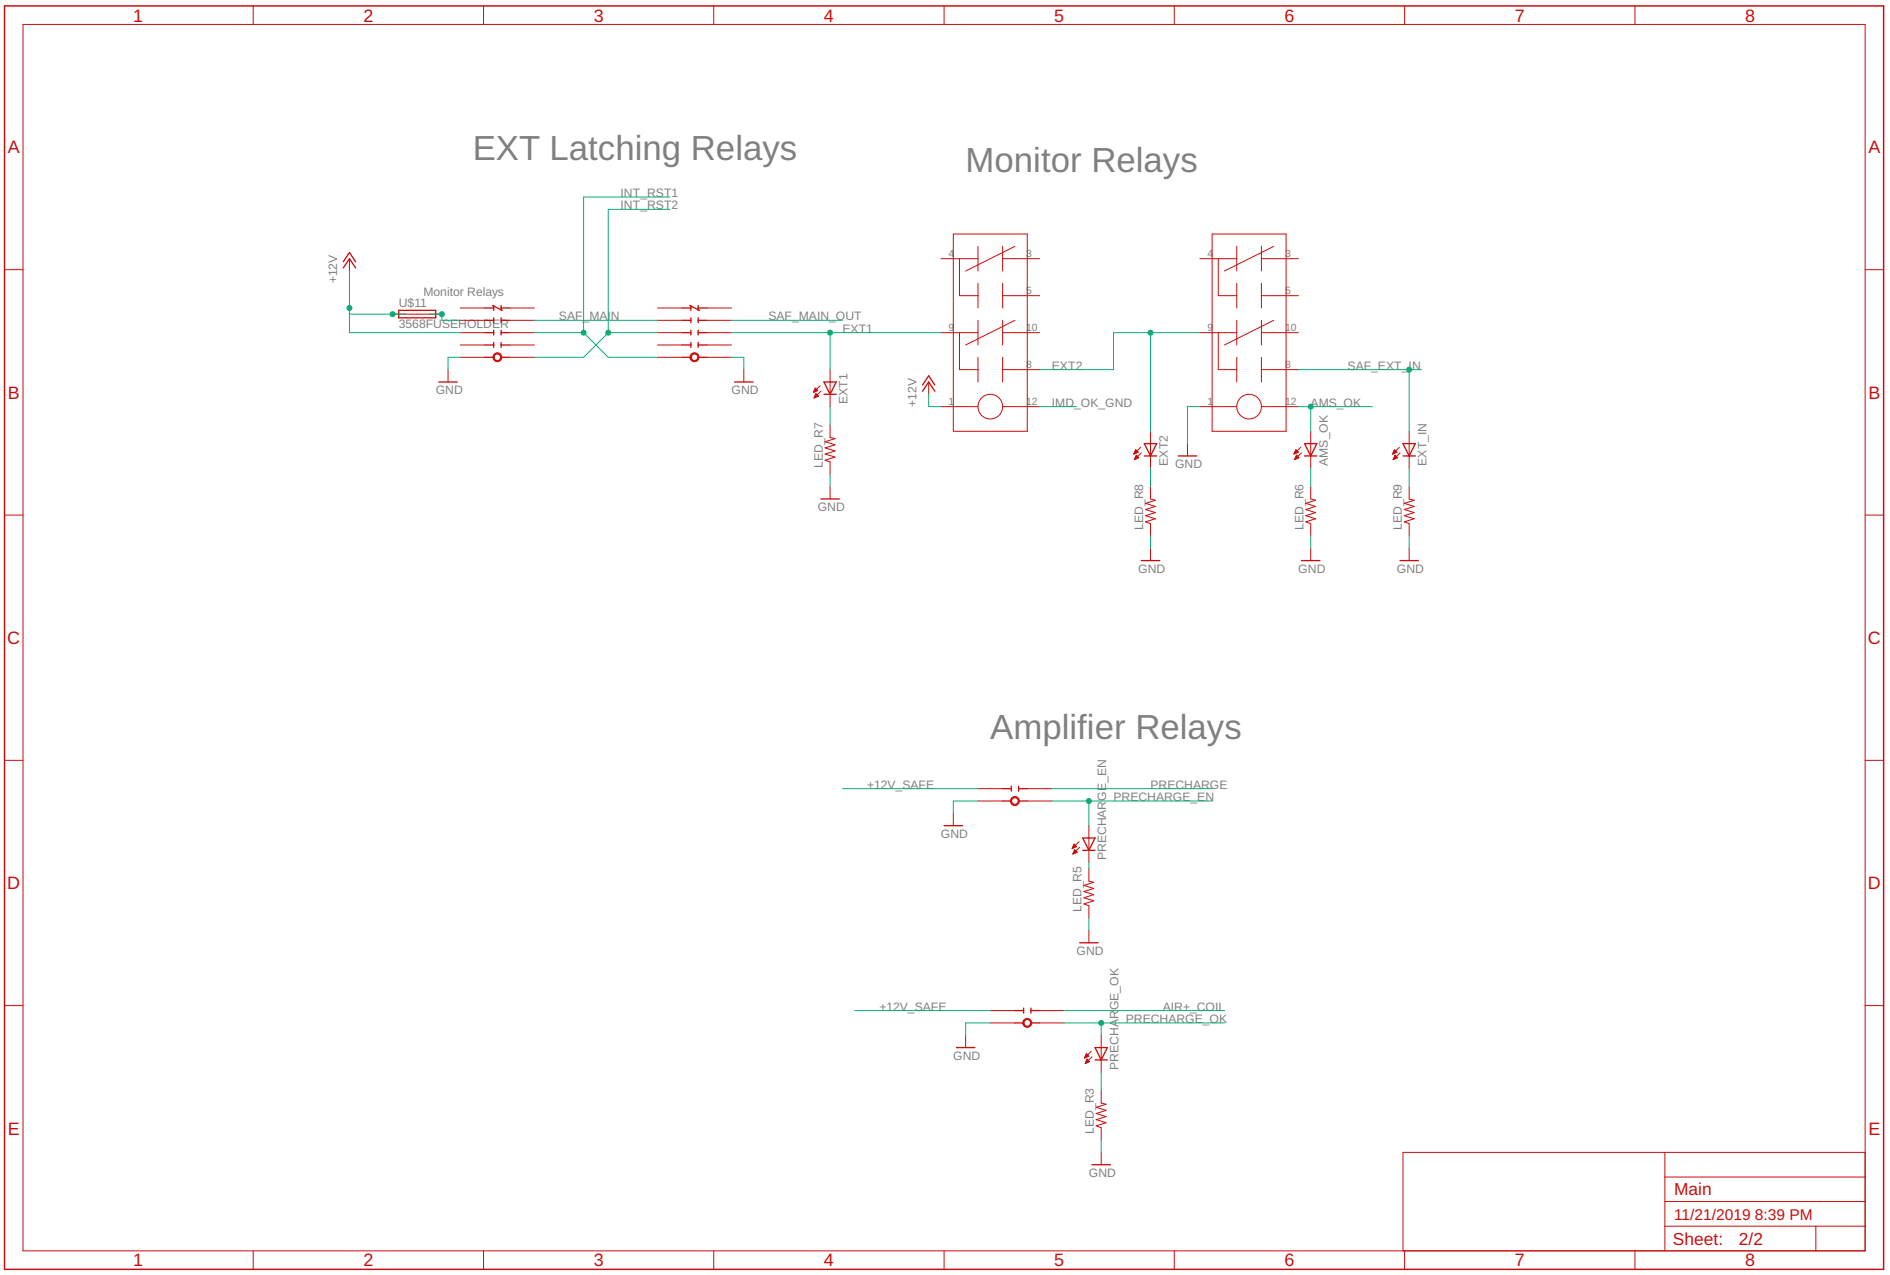
[picture p126: page 1]

Monitor Relays EXT Latching Relays
