andrewrichardr/WFR2020/ACC-MB/HVSchematic.pdf

### INSIDE ACC OUTSIDE ACC

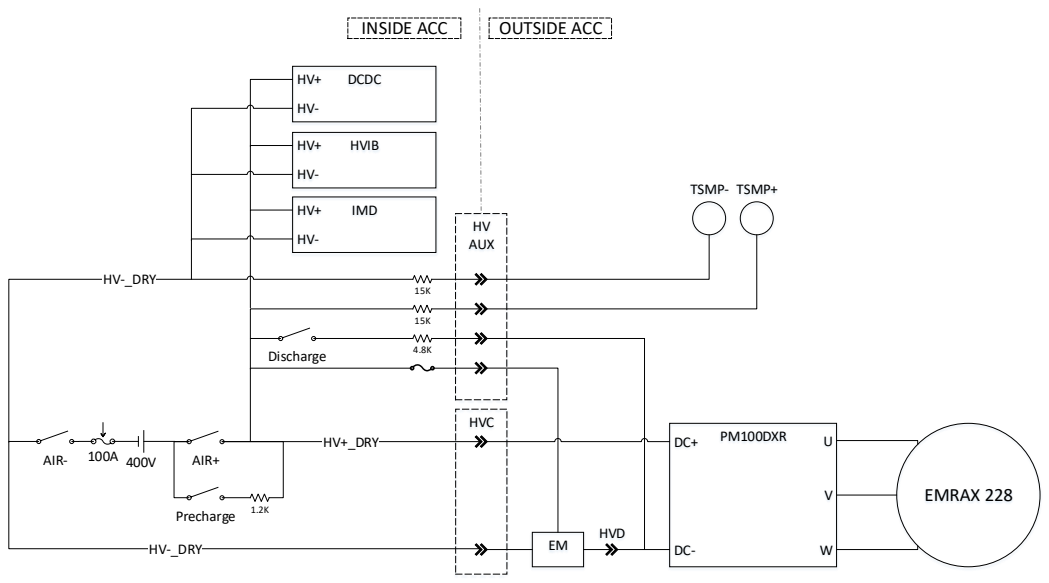
[picture p127: page 1]
AIR-; AIR+; HV-_DRY; Precharge 1.2K; HVC; HV+_DRY; HV AUX; Discharge; HVD; TSMP- TSMP+; PM100DXR; EMRAX 228; DCDC; HVIB; IMD
