andrewrichardr/WFR2020/ACC-MB/dashboard-layout.pdf

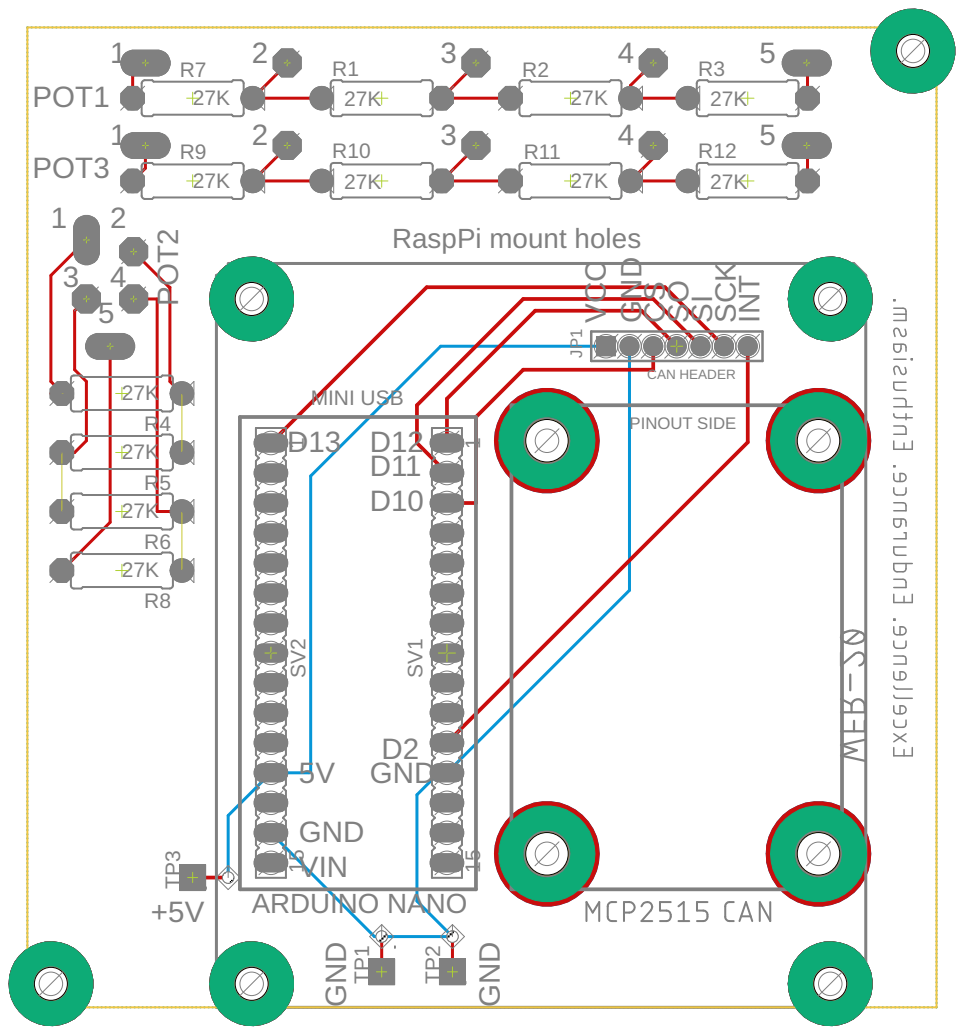
[picture p128: page 1]
