andrewrichardr/WFR2020/ACC-MB/Fusing.pdf

100A

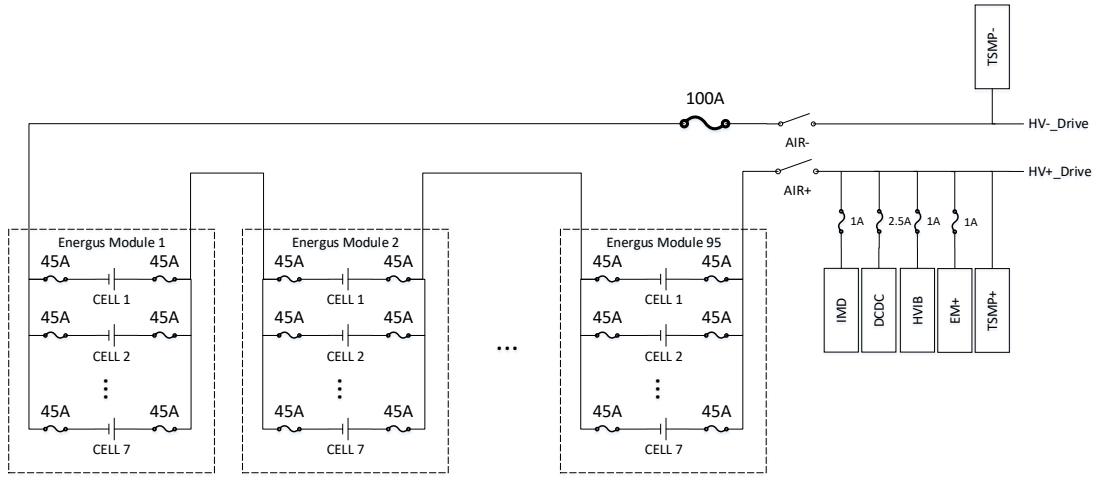
[picture p129: page 1]
CELL 1; CELL 7 ...; CELL 2; Energus Module 1; Energus Module 2; Energus Module 95; -_Drive; HV+_Drive; AIR; AIR+; IMD; DCDC; HVIB; TSMP+ TSMP-
