andrewrichardr/WFR2020/ACC-MB/Rev4/AIRDCL/AIRDCL-layout.pdf

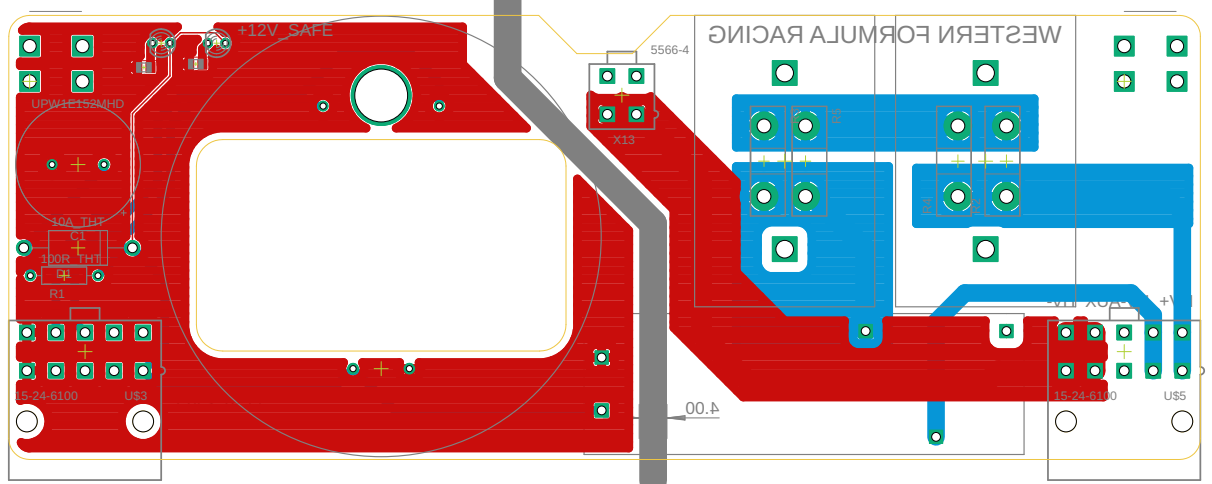
[picture p130: page 1]
