andrewrichardr/WFR2020/ACC-MB/Rev4/AIRDCR/AIRDCR-layout.pdf

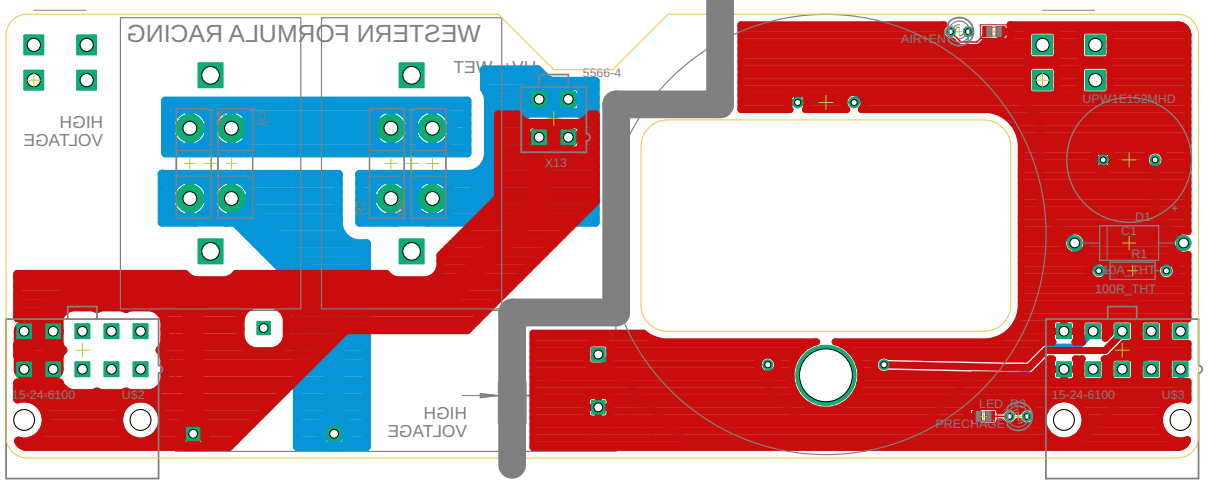
[picture p131: page 1]
