andrewrichardr/WFR2020/ACC-MB/Rev4/MainBoard/Main-layout.pdf

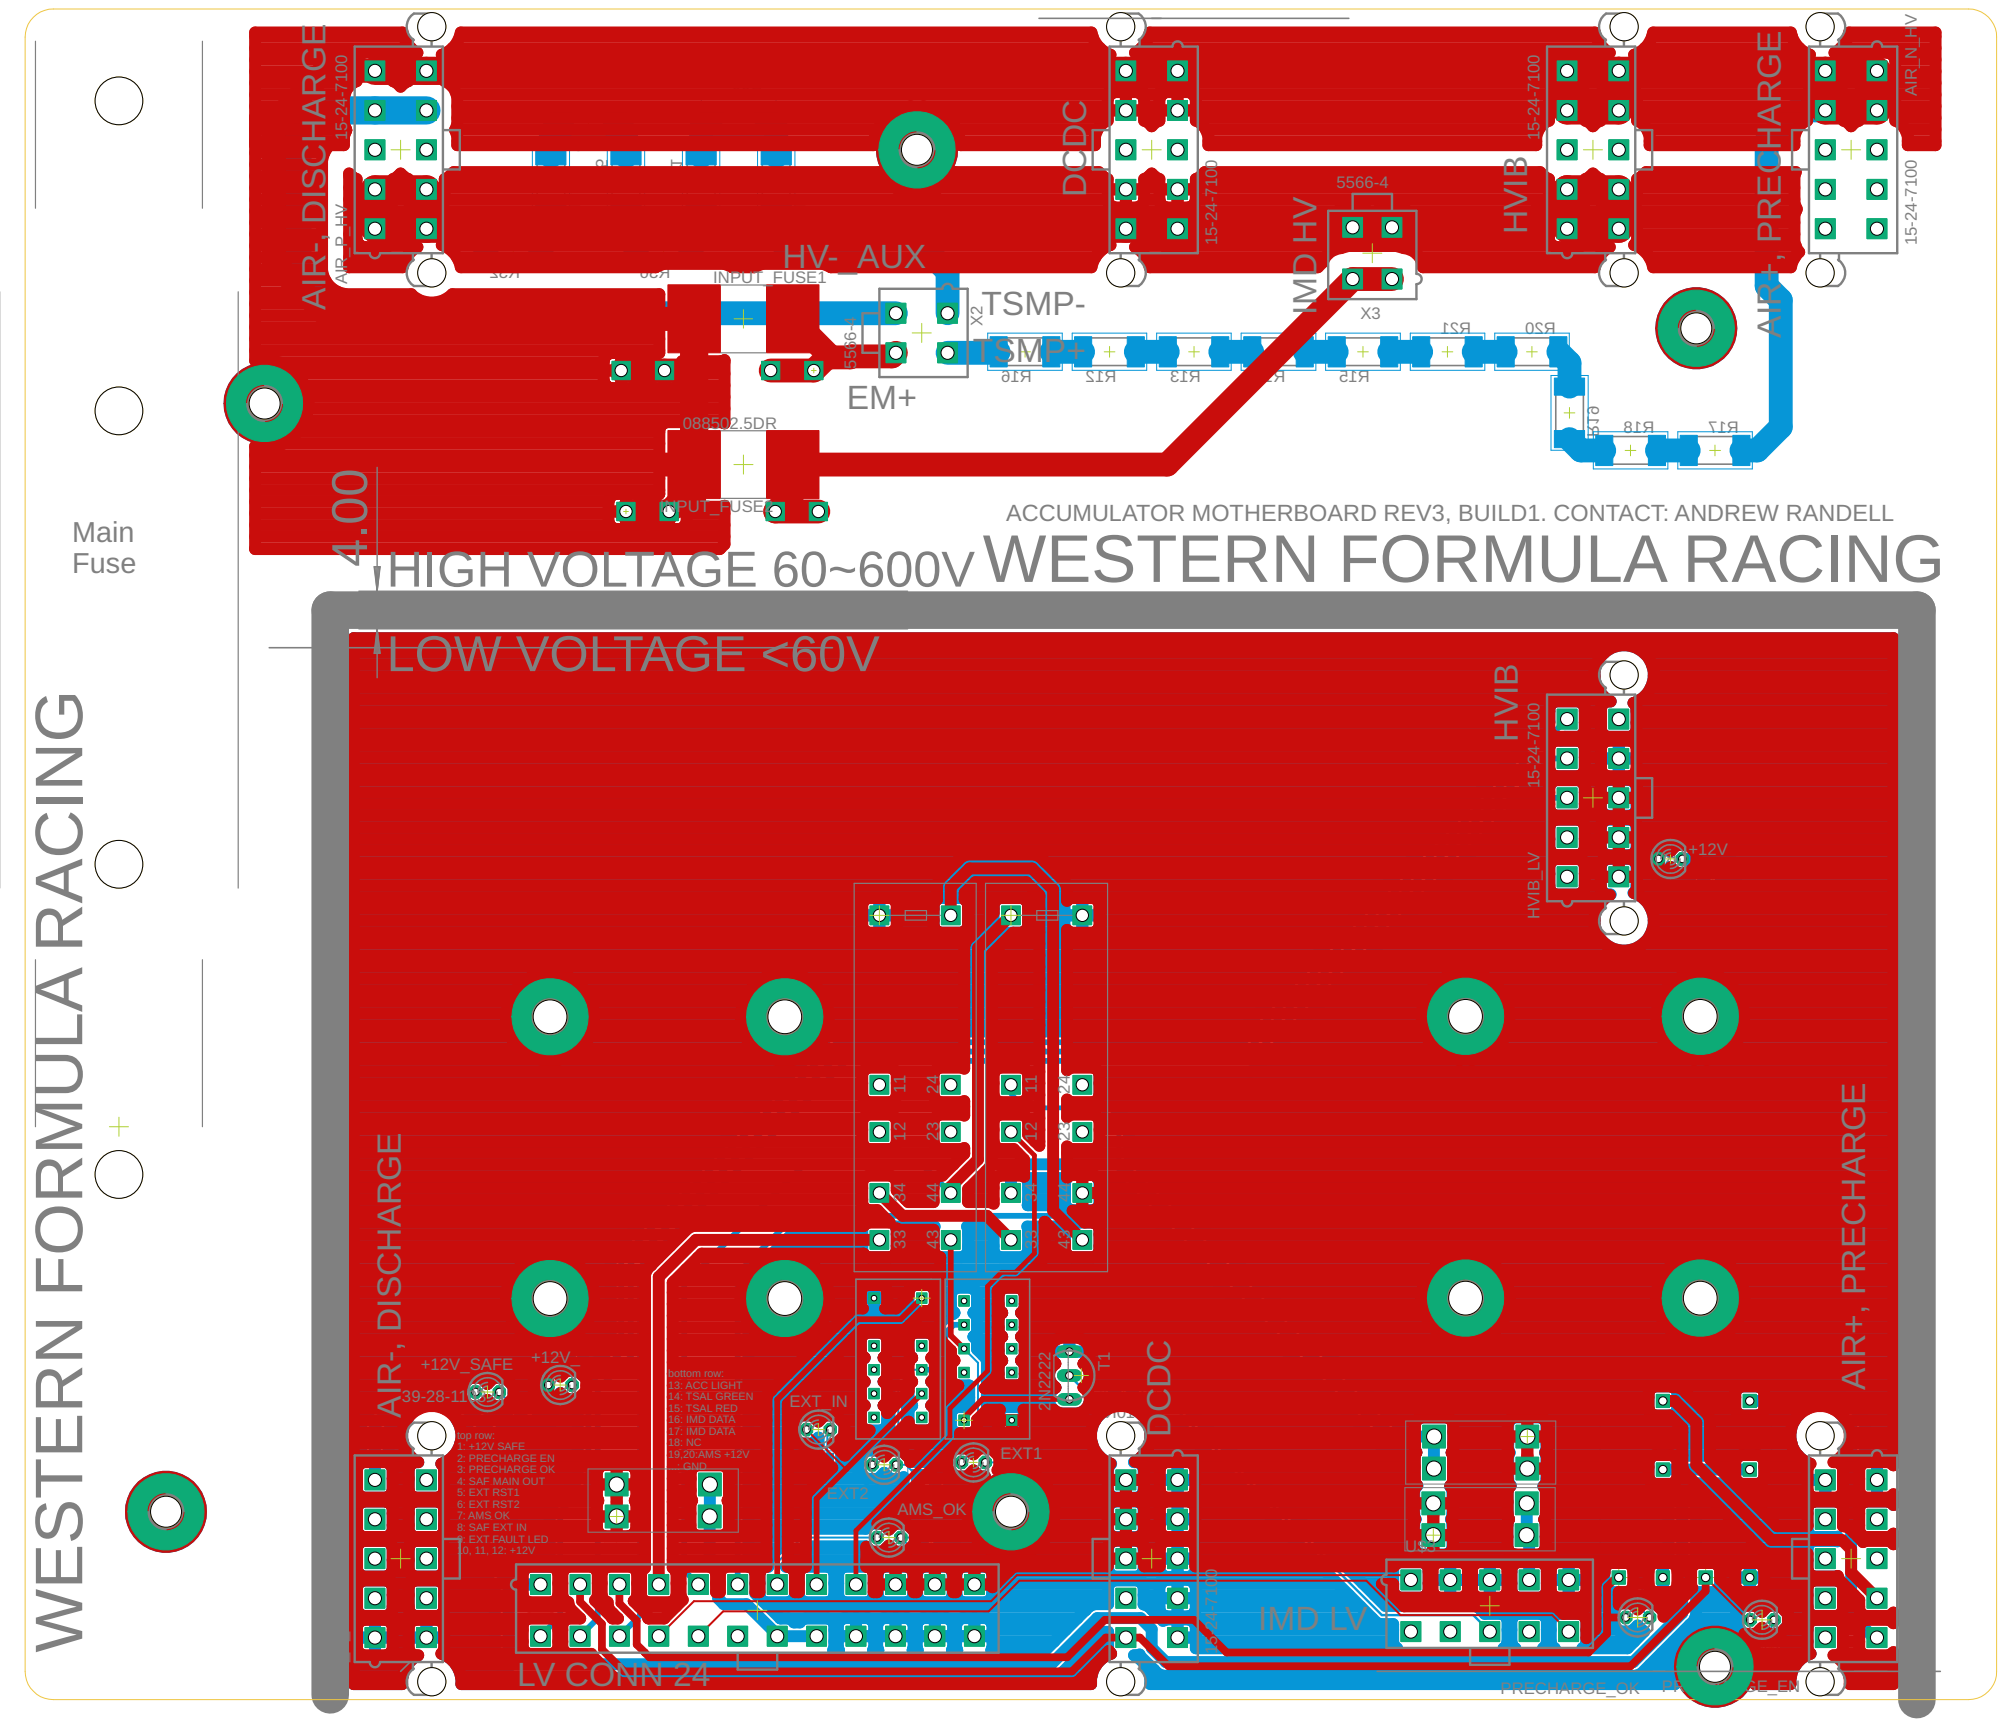
[picture p132: page 1]

ACCUMULATOR MOTHERBOARD REV3, BUILD1. CONTACT: ANDREW RANDELL

bottom row: 13: ACC LIGHT
