andrewrichardr/WFR2020/ACC-MB/Rev4/HVIBDC-R2/HVIBspice.pdf

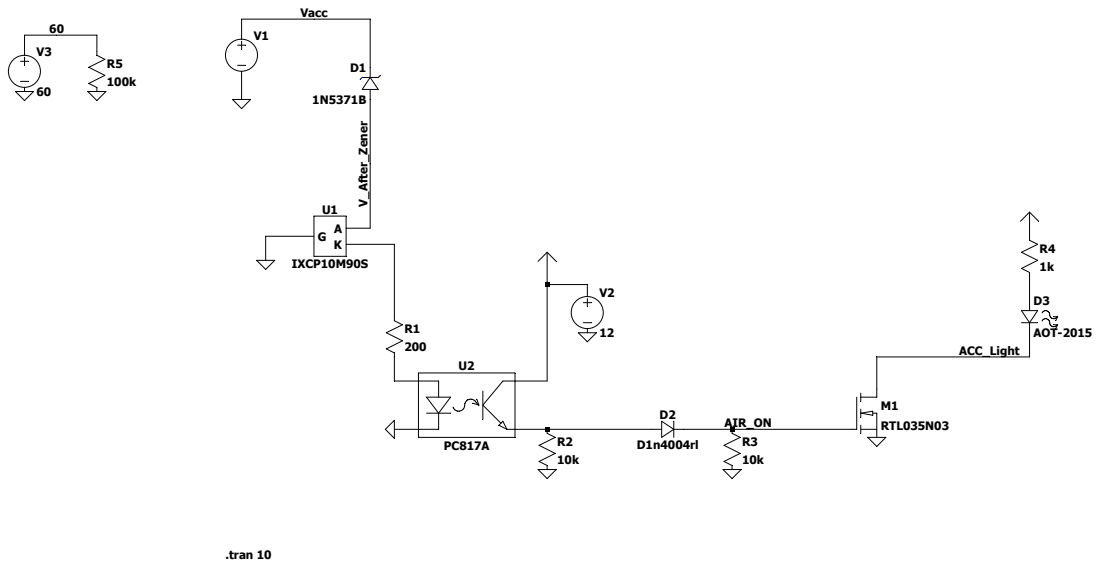
[picture p133: page 1]
