andrewrichardr/WFR2020/ACC-MB/Rev4/HVIBDC-R2/HVIBspiceresults.pdf

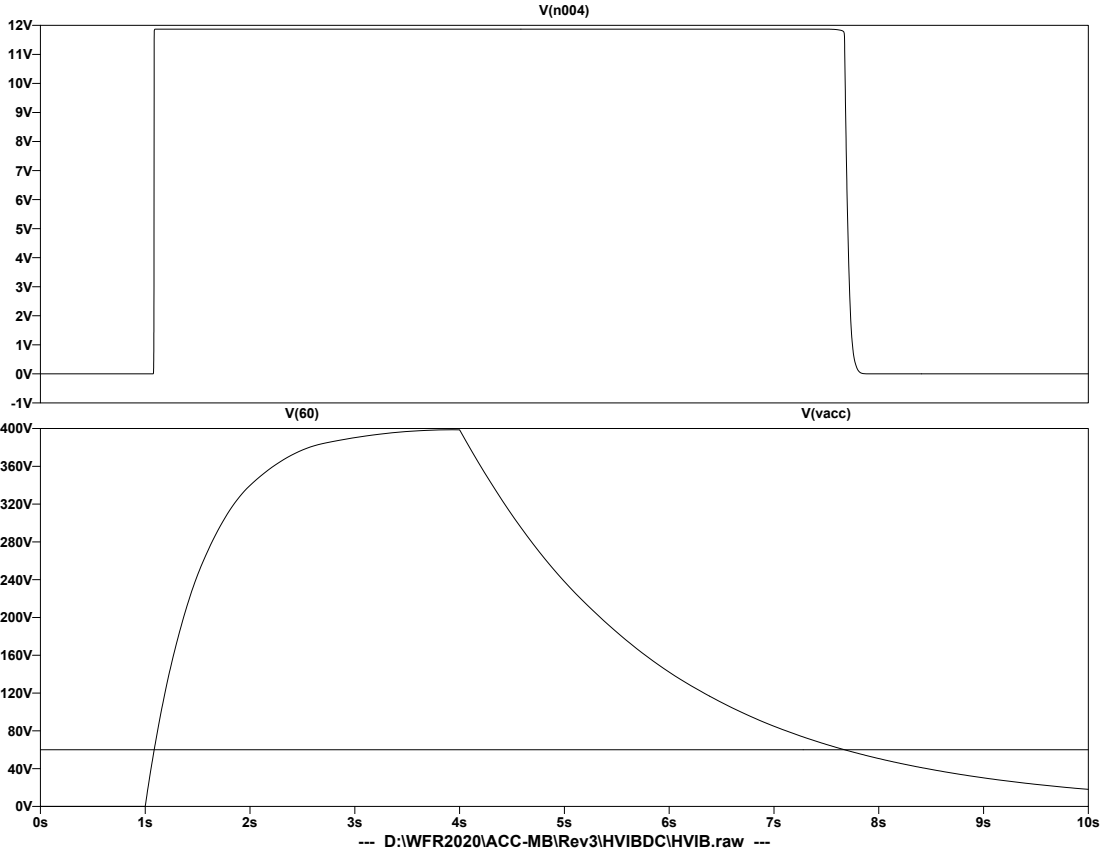
[picture p134: page 1]
V(vacc)

--- D:\WFR2020\ACC-MB\Rev3\HVIBDC\HVIB.raw ---
