andrewrichardr/WFR2020/ACC-MB/Rev4/HVIBDC-R2/HVIB.asc

D1: schottky; RB706D-40
D2: diode; D1n4004rl
D3: LED; AOT-2015
D4: diode; 1SR154-600
D5: diode; 1SR154-600
M1: nmos; RTL035N03
R1: res; 200
R2: res; 10k
R3: res; 10k
R4: res; 1k
R5: res; 100k
U1: IXCP10M90S
U2: PC817A
V1: voltage; EXP(0 400 1 0.5 4 0.5)
V2: voltage; 12
V3: voltage; 60
V4: voltage; EXP(0 400 2.5 0.6 6 0.6)
Named nets: V_After_Zener, Vacc, 0, AIR_ON, COM, ACC_Light, 60, Vgate, Vdrive, Vmobo
.tran 10
