andrewrichardr/WFR2020/ACC-MB/Rev4/MainBoard/Main.brd

## EAGLE design ACC-MB/Rev4/MainBoard/Main.brd (2020-03-10)

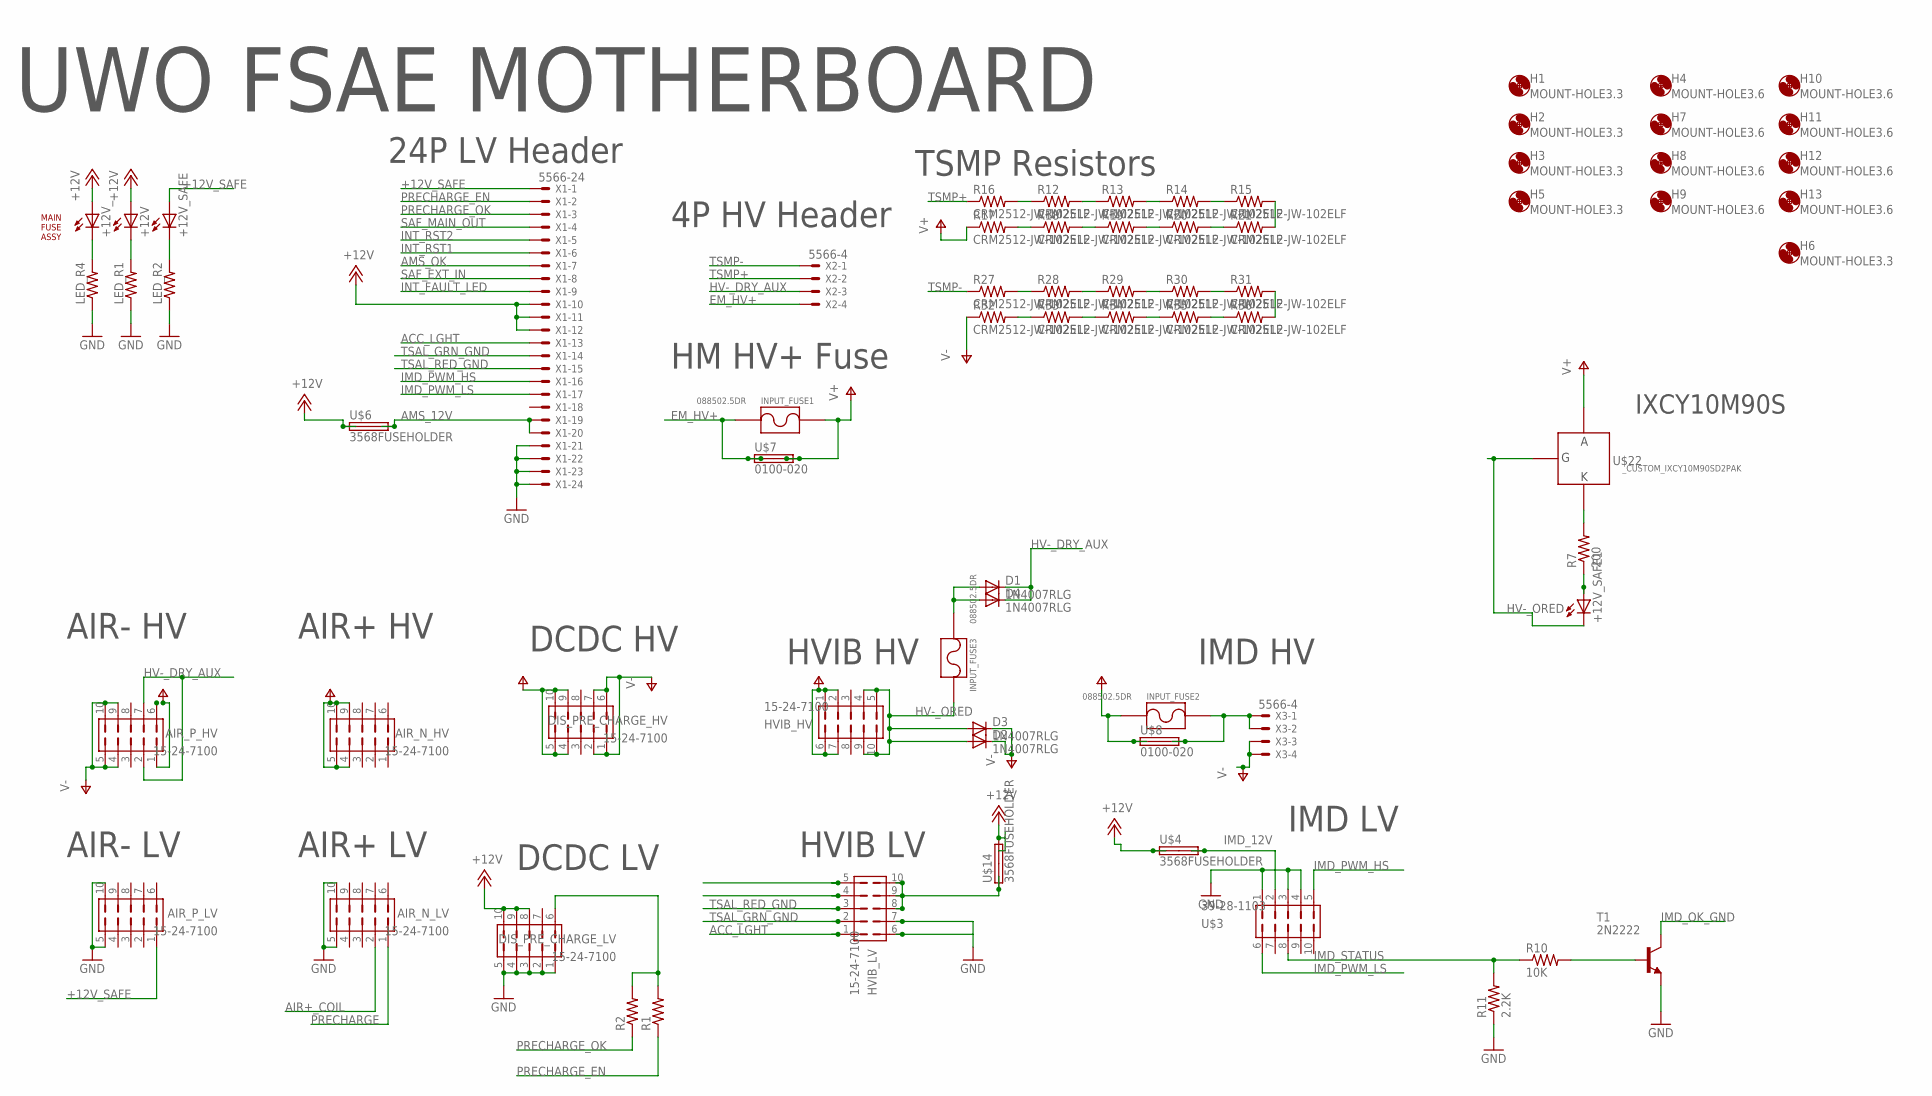
[picture p135: schematic Main.sch, sheet 1]

Parts:
+12V, +12V_, +12V_SAFE: LEDCHIP-LED0805; CHIP-LED0805
+12V_SAFE1: LED5MM
AIR_N_HV: 15-24-7100; 5566-10-BMI
AIR_N_LV: 15-24-7100; 5566-10-BMI
AIR_P_HV: 15-24-7100; 5566-10-BMI
AIR_P_LV: 15-24-7100; 5566-10-BMI
D1, D2, D3, D4: 1N4007RLG; DO41-10
DIS_PRE_CHARGE_HV: 15-24-7100; 5566-10-BMI
DIS_PRE_CHARGE_LV: 15-24-7100; 5566-10-BMI
H1, H2, H3, H5, H6: MOUNT-HOLE3.3; 3,3
H4, H7, H8, H9, H10, H11, H12, H13: MOUNT-HOLE3.6; 3,6
HVIB_HV: 15-24-7100; 5566-10-BMI
HVIB_LV: 15-24-7100; 5566-10-BMI
INPUT_FUSE1, INPUT_FUSE2, INPUT_FUSE3: 088502.5DR; _CUSTOM_PARTS_LF_885
LED_R1, LED_R2, LED_R4: R-US_R0805; R0805
R1, R2: R-US_R0805; R0805
R7: 200; R2010
R10: 10K; M0805
R11: 2.2K; M0805
R12, R13, R14, R15, R16, R17, R18, R19, R20, R21, R27, R28, R29, R30, R31, R32, R33, R34, R35, R36: CRM2512-JW-102ELF; R2512
T1: 2N2222; TO92-EBC-OVAL
U$1: MAINFUSEASSY
U$3: 39-28-1103
U$4, U$6, U$14: 3568FUSEHOLDER; 3568
U$7, U$8: 0100-020
U$22: _CUSTOM_IXCY10M90SD2PAK; TO228P991X238-3
X1: 5566-24
X2, X3: 5566-4

Connections:
+12V: +12V.A, +12V_.A, DIS_PRE_CHARGE_LV.8, DIS_PRE_CHARGE_LV.9, DIS_PRE_CHARGE_LV.10, U$4.L1 (1A), U$4.L2 (1B), U$6.L1 (1A), U$6.L2 (1B), U$14.R1 (2A), U$14.R2 (2B), X1.10, X1.11, X1.12; also elsewhere on the board
+12V_SAFE: +12V_SAFE.A, AIR_P_LV.1, X1.1; also elsewhere on the board
ACC_LGHT: HVIB_LV.1, X1.13
AIR+_COIL: AIR_N_LV.2; also elsewhere on the board
AMS_12V: U$6.R1 (2A), U$6.R2 (2B), X1.19, X1.20
AMS_OK: X1.7; also elsewhere on the board
EM_HV+: INPUT_FUSE1.P$1, U$7.P$1 (1A), U$7.P$3 (1B), X2.4
GND: AIR_N_LV.5, AIR_N_LV.10, AIR_P_LV.5, AIR_P_LV.10, DIS_PRE_CHARGE_LV.1, DIS_PRE_CHARGE_LV.2, DIS_PRE_CHARGE_LV.3, DIS_PRE_CHARGE_LV.4, DIS_PRE_CHARGE_LV.5, HVIB_LV.7, LED_R1.1, LED_R2.1, LED_R4.1, R11.1, T1.E, U$3.1, U$3.3, U$3.4, X1.21, X1.22, X1.23, X1.24; also elsewhere on the board
HV-_DRY_AUX: AIR_P_HV.2, AIR_P_HV.7, D1.C, D4.C, X2.3
HV-_ORED: +12V_SAFE1.K (C), D2.A, D3.A, HVIB_HV.4, HVIB_HV.5, HVIB_HV.9, HVIB_HV.10, INPUT_FUSE3.P$2, U$22.1 (G)
IMD_12V: U$3.2, U$4.R1 (2A), U$4.R2 (2B)
IMD_OK_GND: T1.C; also elsewhere on the board
IMD_PWM_HS: U$3.5, X1.16
IMD_PWM_LS: U$3.6, X1.17
IMD_STATUS: R10.1, R11.2, U$3.8
INT_FAULT_LED: X1.9; also elsewhere on the board
INT_RST1: X1.6; also elsewhere on the board
INT_RST2: X1.5; also elsewhere on the board
unnamed: +12V.C, LED_R1.2
unnamed: R10.2, T1.B
unnamed: +12V_.C, LED_R4.2
unnamed: +12V_SAFE.C, LED_R2.2
unnamed: R12.1, R16.2
unnamed: R12.2, R13.1
unnamed: R13.2, R14.1
unnamed: R14.2, R15.1
unnamed: R15.2, R21.2
unnamed: R20.2, R21.1
unnamed: R19.2, R20.1
unnamed: R18.2, R19.1
unnamed: R17.2, R18.1
unnamed: DIS_PRE_CHARGE_LV.6, R1.2, R2.2
unnamed: INPUT_FUSE2.P$2, U$8.P$2 (2A), U$8.P$4 (2B), X3.1, X3.2
unnamed: R7.2, U$22.2 (K)
unnamed: R27.2, R28.1
unnamed: R28.2, R29.1
unnamed: R29.2, R30.1
unnamed: R30.2, R31.1
unnamed: R31.2, R36.2
unnamed: R35.2, R36.1
unnamed: R34.2, R35.1
unnamed: R33.2, R34.1
unnamed: R32.2, R33.1
unnamed: +12V_SAFE1.A, R7.1
unnamed: HVIB_LV.8, HVIB_LV.9, HVIB_LV.10, U$14.L1 (1A), U$14.L2 (1B)
unnamed: D1.A, D4.A, INPUT_FUSE3.P$1
PRECHARGE: AIR_N_LV.1; also elsewhere on the board
PRECHARGE_EN: R1.1, X1.2; also elsewhere on the board
PRECHARGE_OK: R2.1, X1.3; also elsewhere on the board
SAF_EXT_IN: X1.8; also elsewhere on the board
SAF_MAIN_OUT: X1.4; also elsewhere on the board
TSAL_GRN_GND: HVIB_LV.2, X1.14
TSAL_RED_GND: HVIB_LV.3, X1.15
TSMP+: R16.1, X2.2
TSMP-: R27.1, X2.1
V+: AIR_N_HV.4, AIR_N_HV.5, AIR_N_HV.9, AIR_N_HV.10, AIR_P_HV.1, AIR_P_HV.6, DIS_PRE_CHARGE_HV.4, DIS_PRE_CHARGE_HV.5, DIS_PRE_CHARGE_HV.9, DIS_PRE_CHARGE_HV.10, HVIB_HV.1, HVIB_HV.2, HVIB_HV.6, HVIB_HV.7, INPUT_FUSE1.P$2, INPUT_FUSE2.P$1, R17.1, U$7.P$2 (2A), U$7.P$4 (2B), U$8.P$1 (1A), U$8.P$3 (1B), U$22.3 (A)
V-: AIR_P_HV.4, AIR_P_HV.5, AIR_P_HV.9, AIR_P_HV.10, D2.C, D3.C, DIS_PRE_CHARGE_HV.1, DIS_PRE_CHARGE_HV.2, DIS_PRE_CHARGE_HV.6, DIS_PRE_CHARGE_HV.7, R32.1, X3.3, X3.4

Notes on the sheet:
UWO FSAE MOTHERBOARD
TSMP Resistors
24P LV Header
4P HV Header
HM HV+ Fuse
AIR- HV
AIR- LV
AIR+ LV
AIR+ HV
DCDC HV
DCDC LV
HVIB HV
HVIB LV
IMD HV
IMD LV
IXCY10M90S

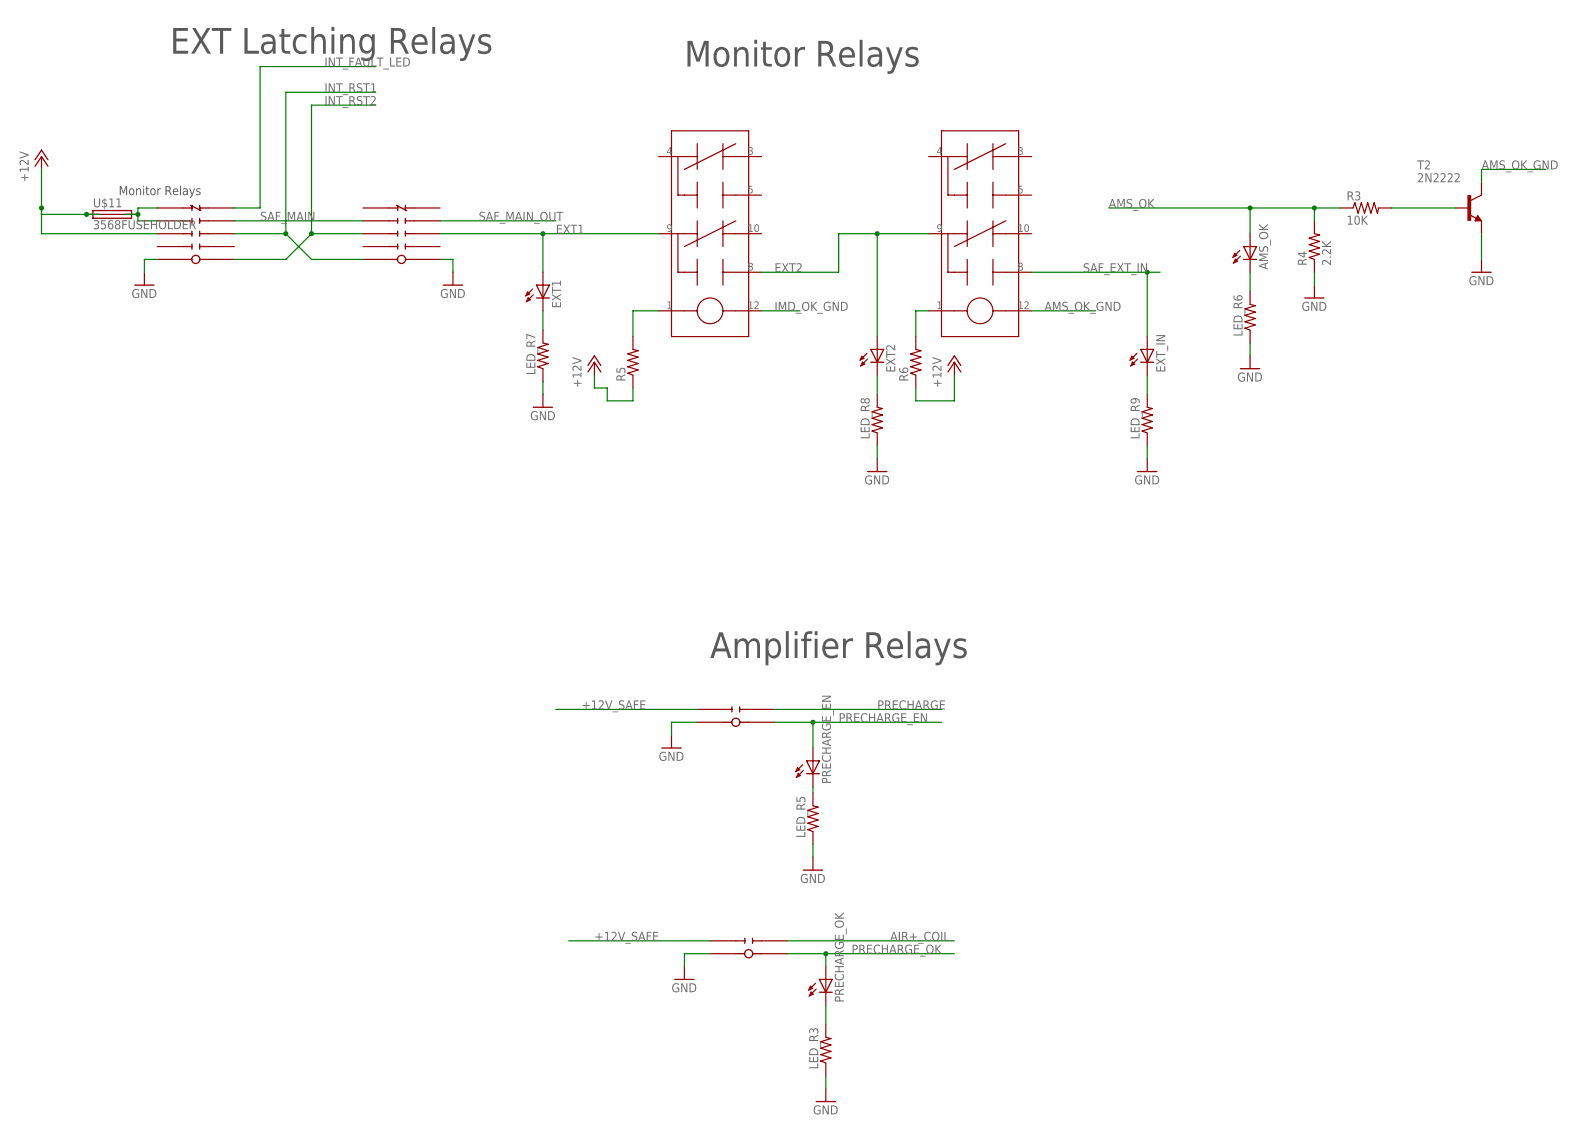
[picture p136: schematic Main.sch, sheet 2]

Parts:
AMS_OK: LEDCHIP-LED0805; CHIP-LED0805
EXT1, EXT2: LEDCHIP-LED0805; CHIP-LED0805
EXT_IN: LEDCHIP-LED0805; CHIP-LED0805
LED_R3, LED_R5, LED_R6, LED_R7, LED_R8, LED_R9: R-US_R0805; R0805
PRECHARGE_EN: LEDCHIP-LED0805; CHIP-LED0805
PRECHARGE_OK: LEDCHIP-LED0805; CHIP-LED0805
R3: 10K; M0805
R4: 2.2K; M0805
R5, R6: R-US_R0805; R0805
T2: 2N2222; TO92-EBC-OVAL
U$2, U$5: SR4M4012_TE; SR4M4012_FOOT
U$9, U$10: G5NB-1A-E
U$11: 3568FUSEHOLDER; 3568
U$12, U$13: V23079B1203B301

Connections:
+12V: R5.1, R6.1, U$2.NOA2, U$11.L1 (1A), U$11.L2 (1B); also elsewhere on the board
+12V_SAFE: U$9.2 (NOA1), U$10.2 (NOA1); also elsewhere on the board
AIR+_COIL: U$9.3 (NOB1); also elsewhere on the board
AMS_OK: AMS_OK.A, R3.1, R4.2; also elsewhere on the board
AMS_OK_GND: T2.C, U$13.12
EXT1: EXT1.A, U$5.NOB2, U$12.9
EXT2: EXT2.A, U$12.8, U$13.9
GND: LED_R3.1, LED_R5.1, LED_R6.1, LED_R7.1, LED_R8.1, LED_R9.1, R4.1, T2.E, U$2.COIL+, U$5.COIL-, U$9.1 (COIL+), U$10.1 (COIL+); also elsewhere on the board
IMD_OK_GND: U$12.12; also elsewhere on the board
INT_FAULT_LED: U$2.NCB4; also elsewhere on the board
INT_RST1: U$2.NOB2, U$5.COIL+; also elsewhere on the board
INT_RST2: U$2.COIL-, U$5.NOA2; also elsewhere on the board
unnamed: U$2.NCA4, U$2.NOA3, U$11.R1 (2A), U$11.R2 (2B)
unnamed: LED_R5.2, PRECHARGE_EN.C
unnamed: LED_R3.2, PRECHARGE_OK.C
unnamed: AMS_OK.C, LED_R6.2
unnamed: EXT1.C, LED_R7.2
unnamed: EXT2.C, LED_R8.2
unnamed: EXT_IN.C, LED_R9.2
unnamed: R3.2, T2.B
unnamed: R5.2, U$12.1
unnamed: R6.2, U$13.1
PRECHARGE: U$10.3 (NOB1); also elsewhere on the board
PRECHARGE_EN: PRECHARGE_EN.A, U$10.4 (COIL-); also elsewhere on the board
PRECHARGE_OK: PRECHARGE_OK.A, U$9.4 (COIL-); also elsewhere on the board
SAF_EXT_IN: EXT_IN.A, U$13.8; also elsewhere on the board
SAF_MAIN: U$2.NOB3, U$5.NOA3
SAF_MAIN_OUT: U$5.NOB3; also elsewhere on the board

Notes on the sheet:
Monitor Relays
EXT Latching Relays
Amplifier Relays

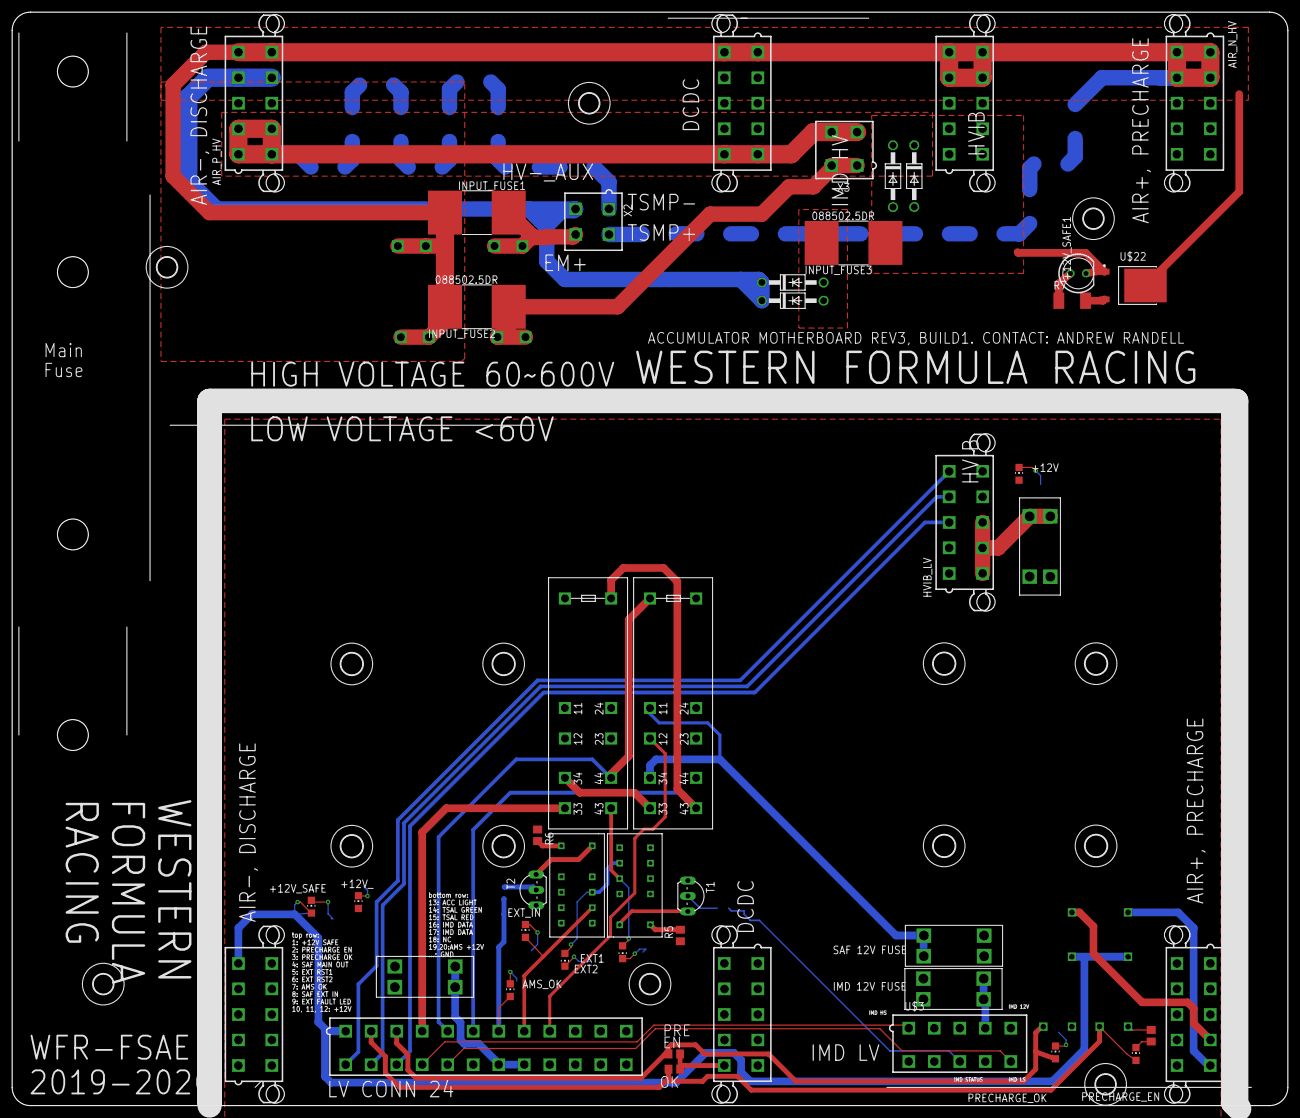
[picture p137: board ACC-MB/Rev4/MainBoard/Main.brd from above]

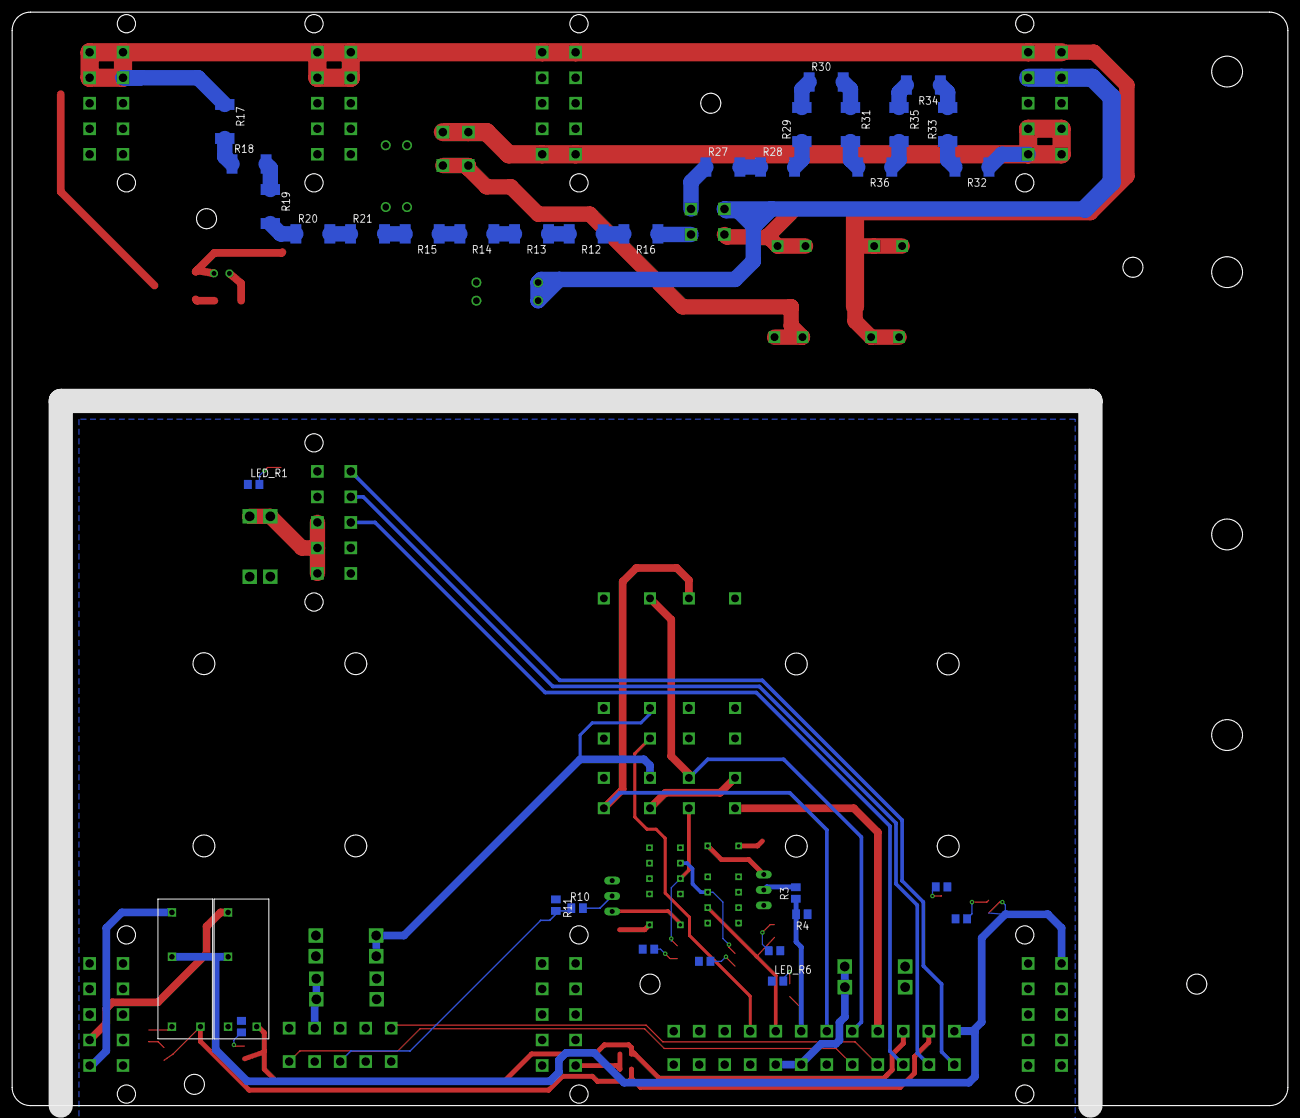
[picture p138: board ACC-MB/Rev4/MainBoard/Main.brd from below]

Board: 2 copper layers, 210.0 x 180.0 mm, 97 parts (34 on the bottom side), 71 nets.

Other parts of the board:
H14: MOUNT-HOLE3.3; 3,3
