andrewrichardr/WFR2020/KevinRev2/BSPD_v8.brd

## EAGLE design KevinRev2/BSPD_v8.brd (2020-03-10)

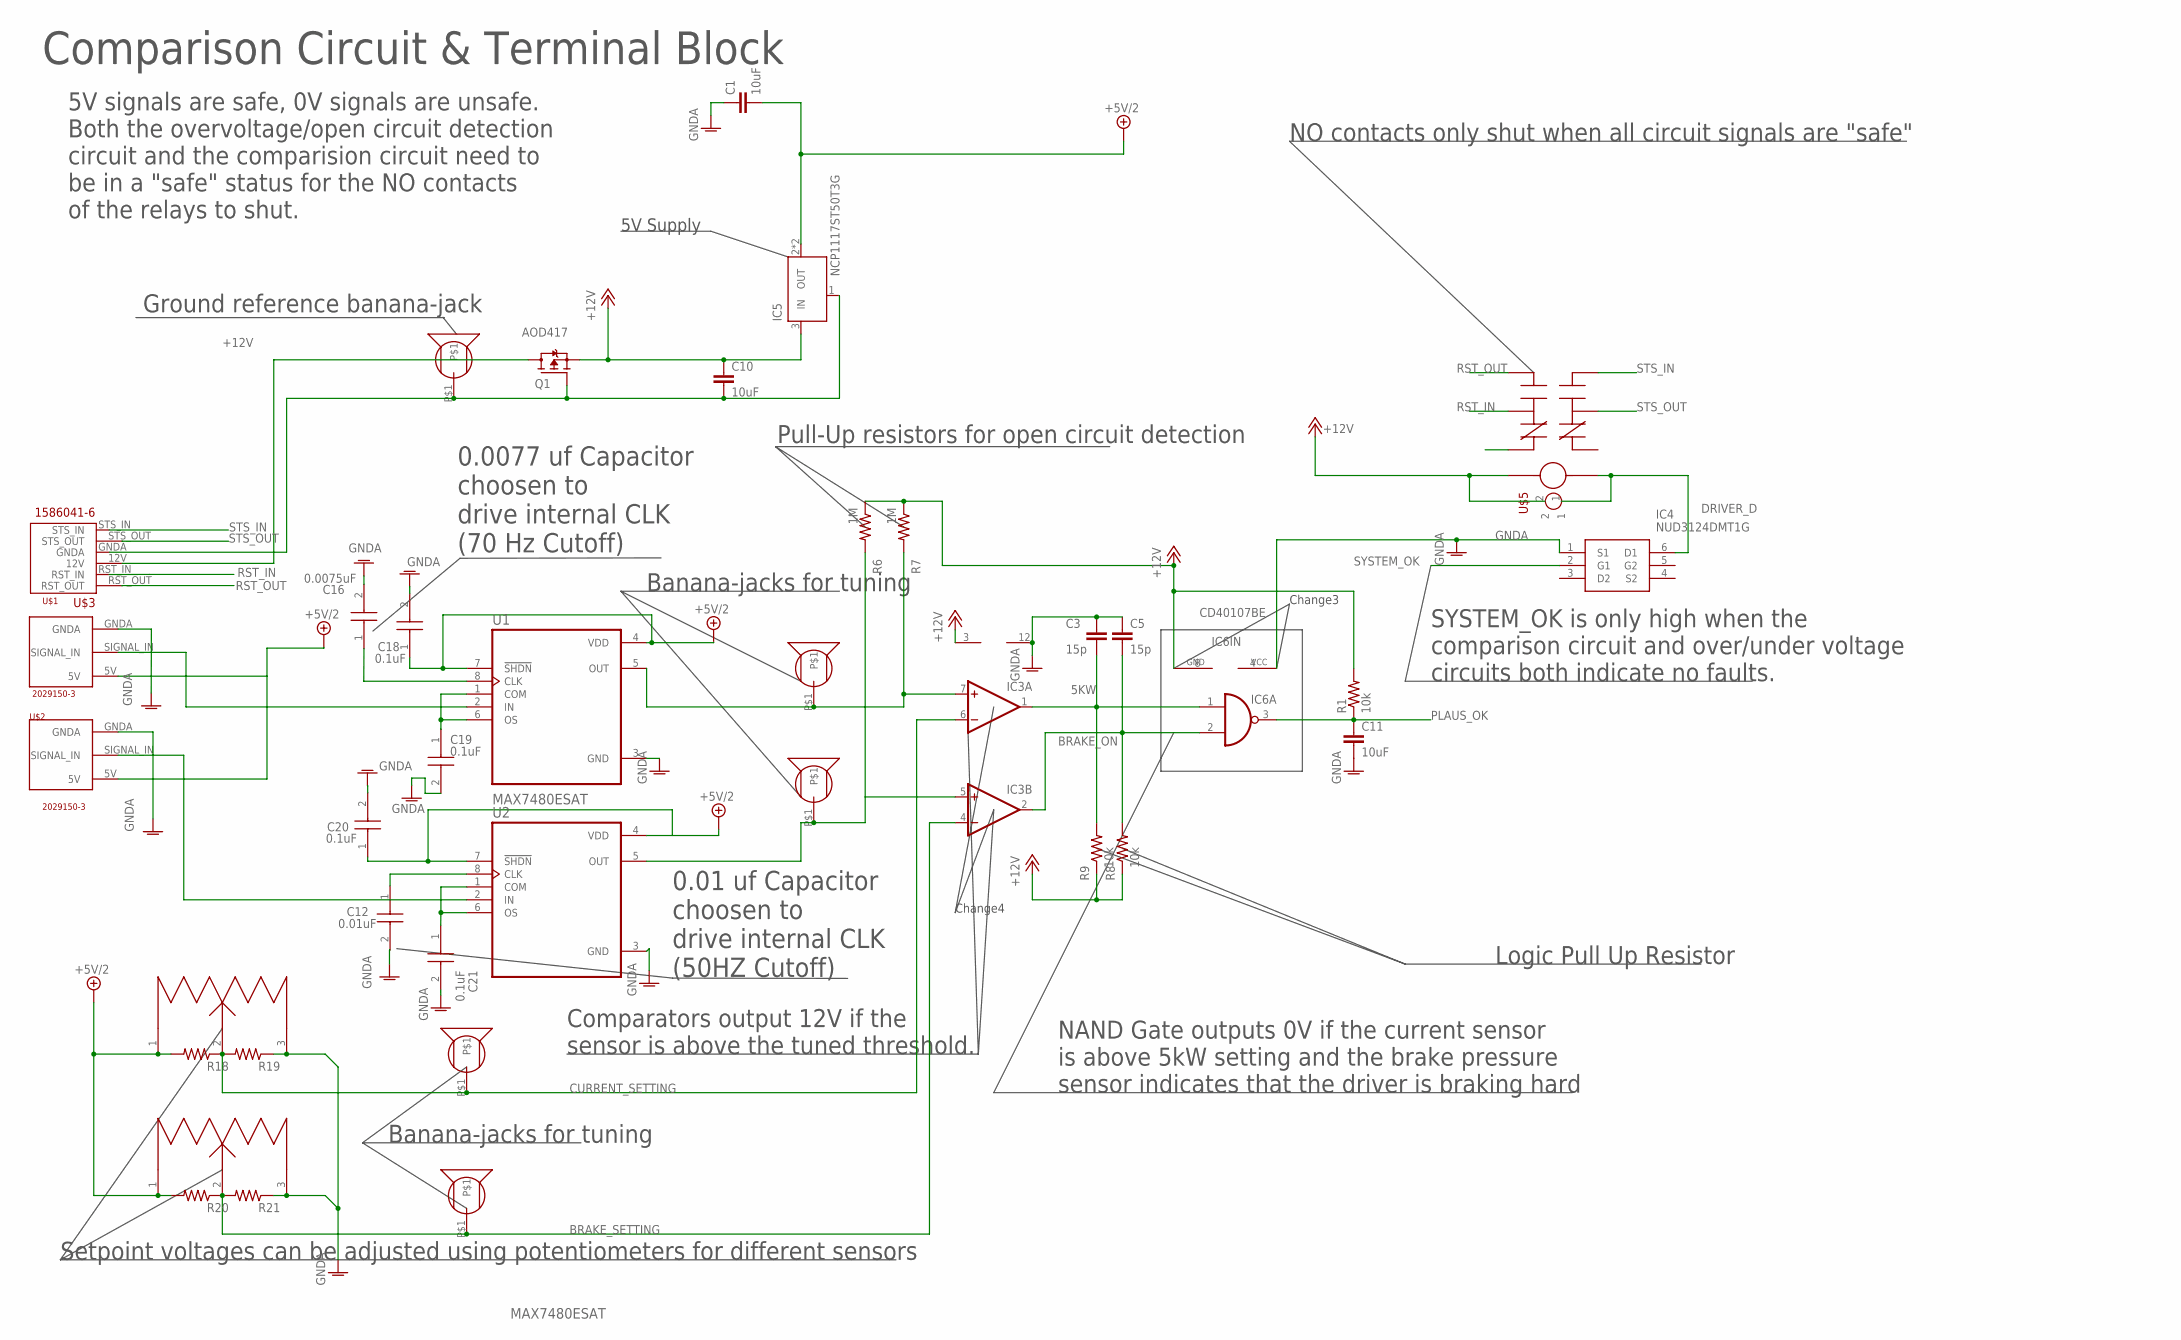
[picture p139: schematic BSPD_v8.sch, sheet 1]

Parts:
C1, C10, C11: 10uF; C0805
C3, C5: 15p; C0805
C12: 0.01uF; CAPC2012X95N
C16: 0.0075uF; CAPC2012X95N
C18, C19, C20, C21: 0.1uF; CAPC2012X140N
IC3: 4AMP_P11+7N; DIL14
IC4: NUD3124DMT1G; SOT95P275X110-6N
IC5: NCP1117ST50T3G; SOT223
IC6: CD40107BE; DIL08
Q1: AOD417; TO252
R1, R8, R9: 10k; M0805
R6, R7: 1M; M0805
R18, R19, R20, R21: R-US_M0805; M0805
U1, U2: MAX7480ESAT; SOIC127P600X175-8N
U$1, U$2: 2029150-3
U$3: 1586041-6
U$4, U$13, U$14, U$18, U$19: BSPD_PARTS_MP_BANANA_PLUG; BSPD_PARTS_BANANA_PLUG
U$5: SSL-LX3044ID-12V
U$10, U$11: PTC10LV10-103A1010
U$12: BSPD_PARTS_RLY_V23079A1001B301; BSPD_PARTS_V23079F1101B301

Connections:
5KW: C3.2, IC3.1 (OUT), IC6.1 (I0), R9.2
12V: Q1.3 (D), U$3.12V
+5V/2: C1.2, C18.1, C20.1, IC5.2 (OUT), IC5.4 (OUT), R18.2, R20.2, U1.4 (VDD), U1.7 (!SHDN), U2.4 (VDD), U2.7 (!SHDN), U$1.5V, U$2.5V, U$10.1 (CW), U$11.1 (CW); also elsewhere on the board
+12V: C10.1, IC3.3 (V+), IC5.3 (IN), IC6.8 (GND), Q1.2 (S), R1.2, R6.1, R7.1, R8.1, R9.1, U$5.2, U$12.1; also elsewhere on the board
BRAKE_ON: C5.2, IC3.2 (OUT), IC6.2 (I1), R8.2
BRAKE_PRES_IN: IC3.5 (+IN), R6.2, U2.5 (OUT), U$14.P$1; also elsewhere on the board
BRAKE_SETTING: IC3.4 (-IN), R20.1, R21.2, U$10.2 (VO), U$19.P$1
CURRENT_IN: IC3.7 (+IN), R7.2, U1.5 (OUT), U$13.P$1; also elsewhere on the board
CURRENT_SETTING: IC3.6 (-IN), R18.1, R19.2, U$11.2 (VO), U$18.P$1
DRIVER_D: IC4.6 (D1), U$5.1, U$12.12
GNDA: C1.1, C3.1, C5.1, C10.2, C11.2, C12.2, C16.2, C18.2, C19.2, C20.2, C21.2, IC3.12 (V-), IC4.1 (S1), IC5.1 (GND), IC6.4 (VCC), Q1.1 (G), R19.1, R21.1, U1.3 (GND), U2.3 (GND), U$1.GNDA, U$2.GNDA, U$3.GNDA, U$4.P$1, U$10.3 (CCW), U$11.3 (CCW); also elsewhere on the board
unnamed: U2.2 (IN), U$2.SIGNAL_IN
unnamed: U1.2 (IN), U$1.SIGNAL_IN
unnamed: C19.1, U1.1 (COM), U1.6 (OS)
unnamed: C21.1, U2.1 (COM), U2.6 (OS)
unnamed: C12.1, U2.8 (CLK)
unnamed: C16.1, U1.8 (CLK)
PLAUS_OK: C11.1, IC6.3 (O), R1.1; also elsewhere on the board
RST_IN: U$3.RST_IN, U$12.4
RST_OUT: U$3.RST_OUT, U$12.5
STS_IN: U$3.STS_IN, U$12.8
STS_OUT: U$3.STS_OUT, U$12.9
SYSTEM_OK: IC4.2 (G1); also elsewhere on the board

Notes on the sheet:
Comparison Circuit & Terminal Block
Logic Pull Up Resistor
Pull-Up resistors for open circuit detection
Banana-jacks for tuning
Setpoint voltages can be adjusted using potentiometers for different sensors
Ground reference banana-jack
5V Supply
NO contacts only shut when all circuit signals are "safe"
5V signals are safe, 0V signals are unsafe. Both the overvoltage/open circuit detection circuit and the comparision circuit need to be in a "safe" status for the NO contacts of the relays to shut.
NAND Gate outputs 0V if the current sensor is above 5kW setting and the brake pressure sensor indicates that the driver is braking hard
Comparators output 12V if the sensor is above the tuned threshold.
SYSTEM_OK is only high when the comparison circuit and over/under voltage circuits both indicate no faults.
Change3
Change4
0.0077 uf Capacitor choosen to drive internal CLK (70 Hz Cutoff)
0.01 uf Capacitor choosen to drive internal CLK (50HZ Cutoff)

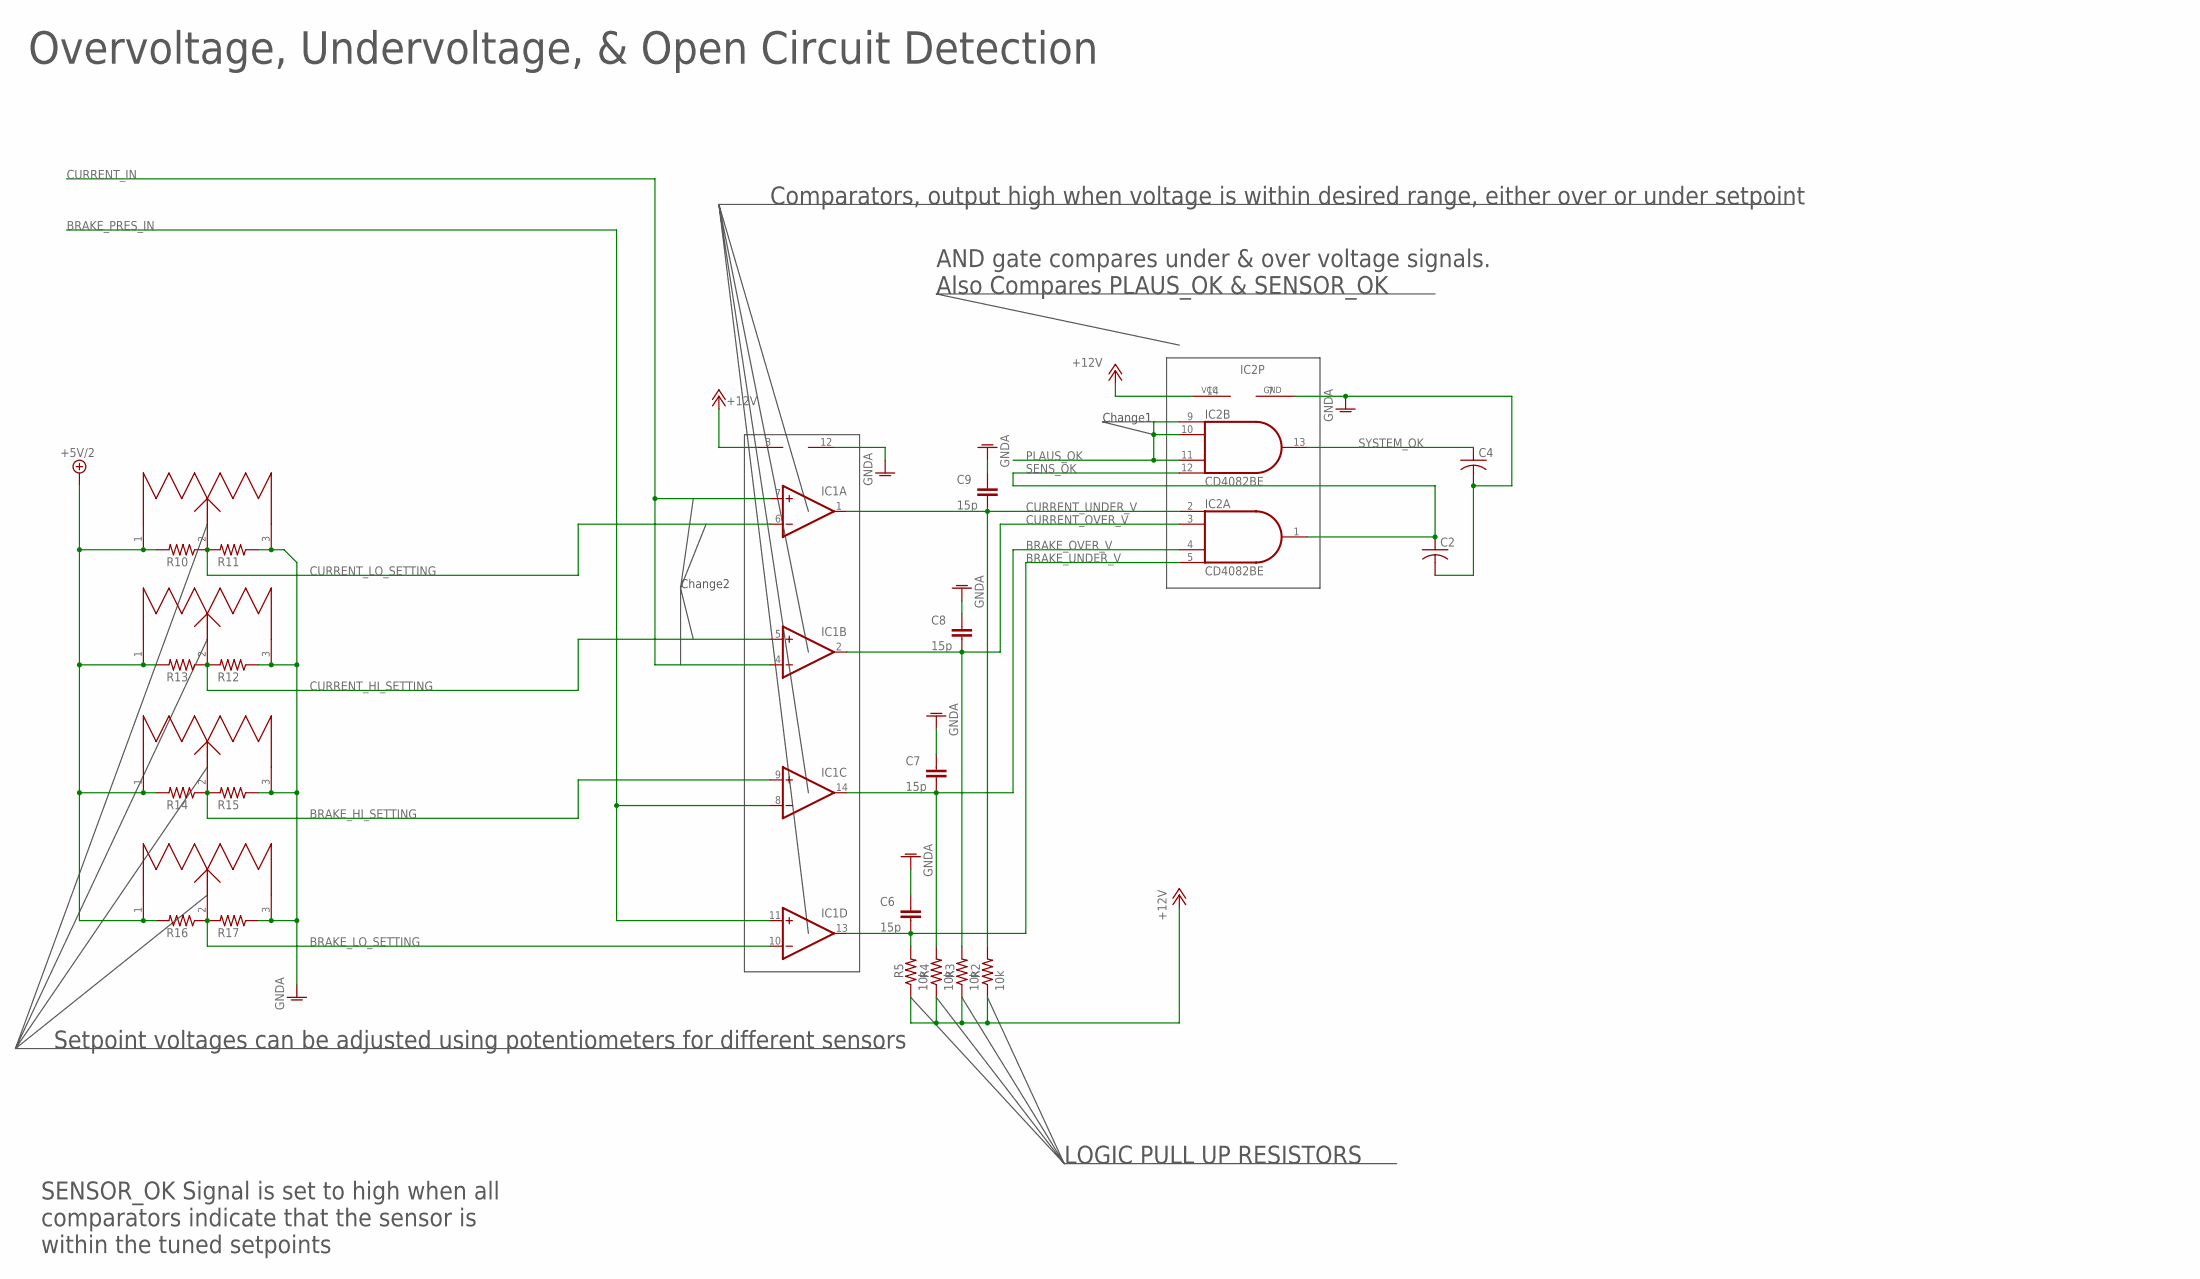
[picture p140: schematic BSPD_v8.sch, sheet 2]

Parts:
C2, C4: C-USC0805; C0805
C6, C7, C8, C9: 15p; C0805
IC1: 4AMP_P11+7N; DIL14
IC2: CD4082BE; DIL14
R2, R3, R4, R5: 10k; M0805
R10, R11, R12, R13, R14, R15, R16, R17: R-US_M0805; M0805
U$6, U$7, U$8, U$9: PTC10LV10-103A1010

Connections:
+5V/2: R10.2, R13.2, R14.2, R16.2, U$6.1 (CW), U$7.1 (CW), U$8.1 (CW), U$9.1 (CW); also elsewhere on the board
+12V: IC1.3 (V+), IC2.14 (VCC), R2.1, R3.1, R4.1, R5.1; also elsewhere on the board
BRAKE_HI_SETTING: IC1.9 (+IN), R14.1, R15.2, U$8.2 (VO)
BRAKE_LO_SETTING: IC1.10 (-IN), R16.1, R17.2, U$9.2 (VO)
BRAKE_OVER_V: C7.2, IC1.14 (OUT), IC2.4 (I2), R4.2
BRAKE_PRES_IN: IC1.8 (-IN), IC1.11 (+IN); also elsewhere on the board
BRAKE_UNDER_V: C6.2, IC1.13 (OUT), IC2.5 (I3), R5.2
CURRENT_HI_SETTING: IC1.5 (+IN), R12.2, R13.1, U$7.2 (VO)
CURRENT_IN: IC1.4 (-IN), IC1.7 (+IN); also elsewhere on the board
CURRENT_LO_SETTING: IC1.6 (-IN), R10.1, R11.2, U$6.2 (VO)
CURRENT_OVER_V: C8.2, IC1.2 (OUT), IC2.3 (I1), R3.2
CURRENT_UNDER_V: C9.2, IC1.1 (OUT), IC2.2 (I0), R2.2
GNDA: C2.2, C4.2, C6.1, C7.1, C8.1, C9.1, IC1.12 (V-), IC2.7 (GND), R11.1, R12.1, R15.1, R17.1, U$6.3 (CCW), U$7.3 (CCW), U$8.3 (CCW), U$9.3 (CCW); also elsewhere on the board
PLAUS_OK: IC2.9 (I0), IC2.10 (I1), IC2.11 (I2); also elsewhere on the board
SENS_OK: C2.1, IC2.1 (O), IC2.12 (I3)
SYSTEM_OK: C4.1, IC2.13 (O); also elsewhere on the board

Notes on the sheet:
Overvoltage, Undervoltage, & Open Circuit Detection
Setpoint voltages can be adjusted using potentiometers for different sensors
AND gate compares under & over voltage signals. Also Compares PLAUS_OK & SENSOR_OK
Comparators, output high when voltage is within desired range, either over or under setpoint
SENSOR_OK Signal is set to high when all comparators indicate that the sensor is within the tuned setpoints
LOGIC PULL UP RESISTORS
Change1
Change2

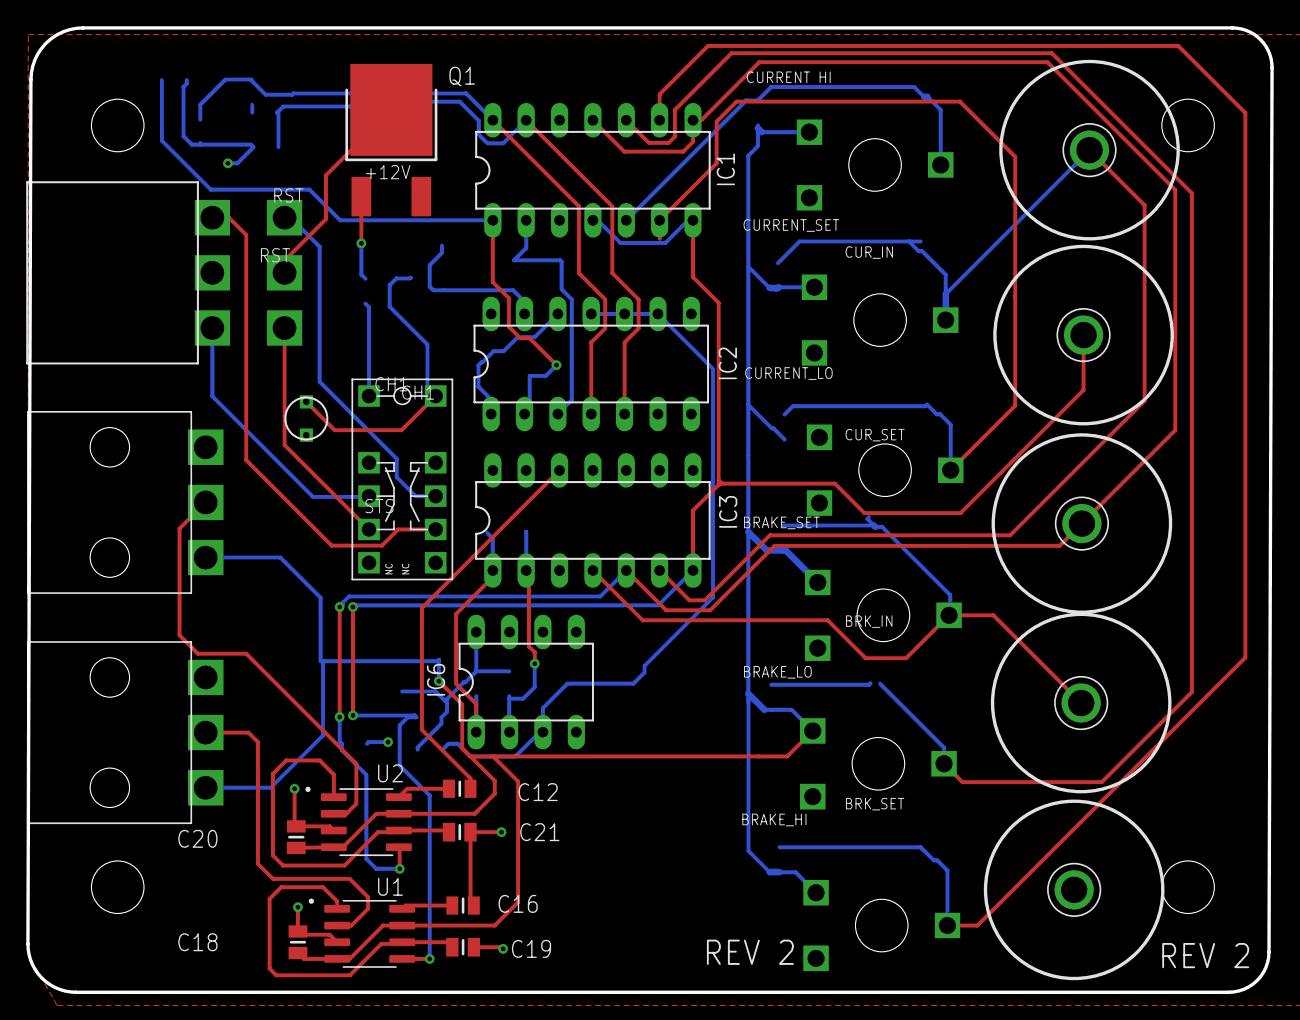
[picture p141: board BSPD_v8.brd from above]

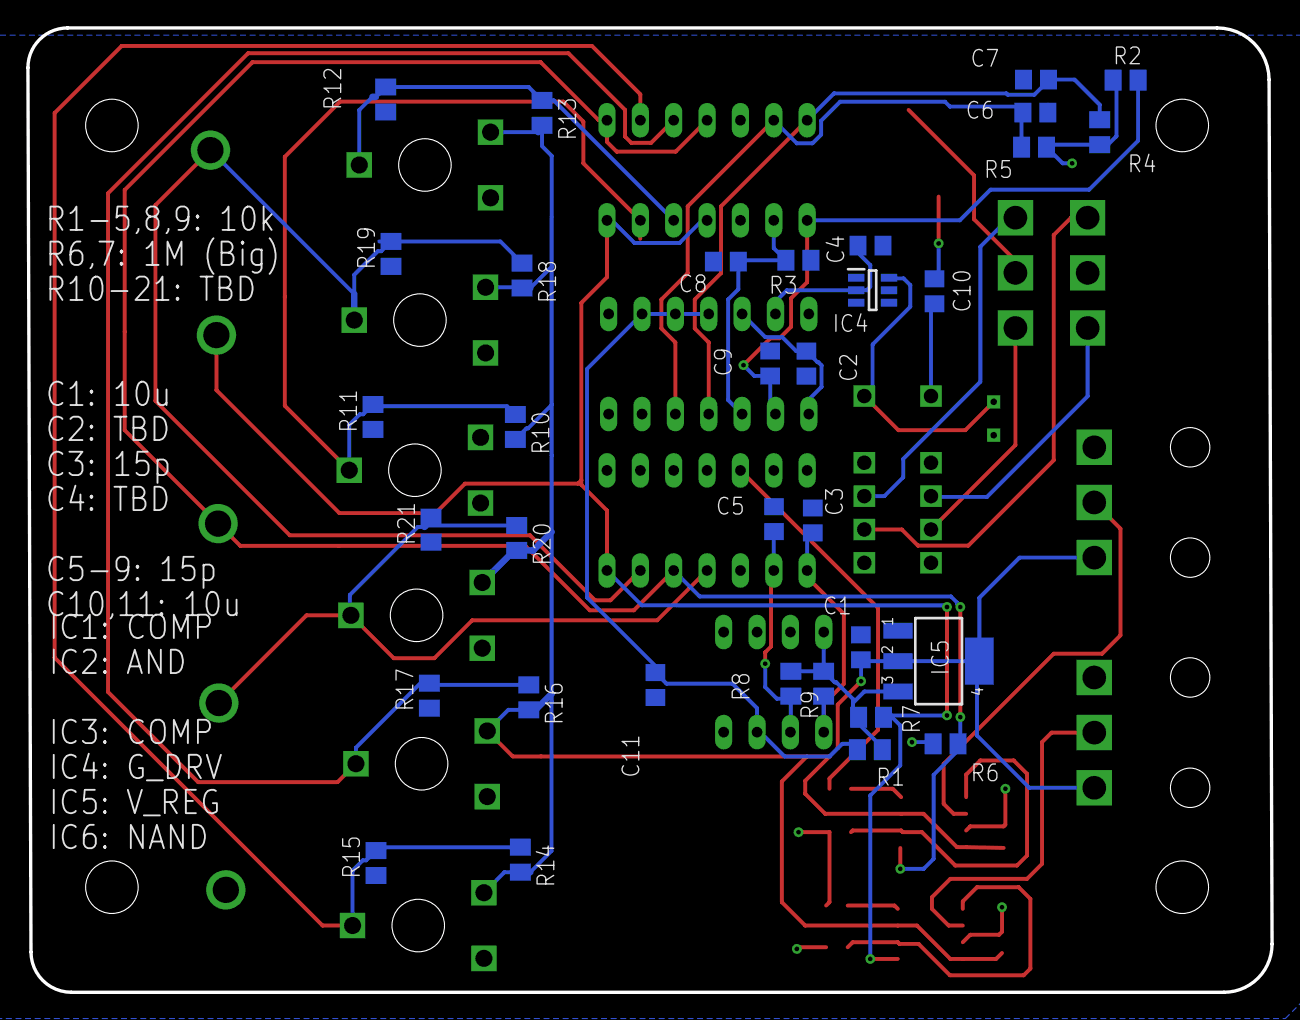
[picture p142: board BSPD_v8.brd from below]

Board: 2 copper layers, 94.7 x 73.4 mm, 63 parts (34 on the bottom side), 32 nets.
