andrewrichardr/WFR2020/ACC-MB/Rev4/IMDDC/IMDDC.brd

## EAGLE design ACC-MB/Rev4/IMDDC/IMDDC.brd (2019-10-13)

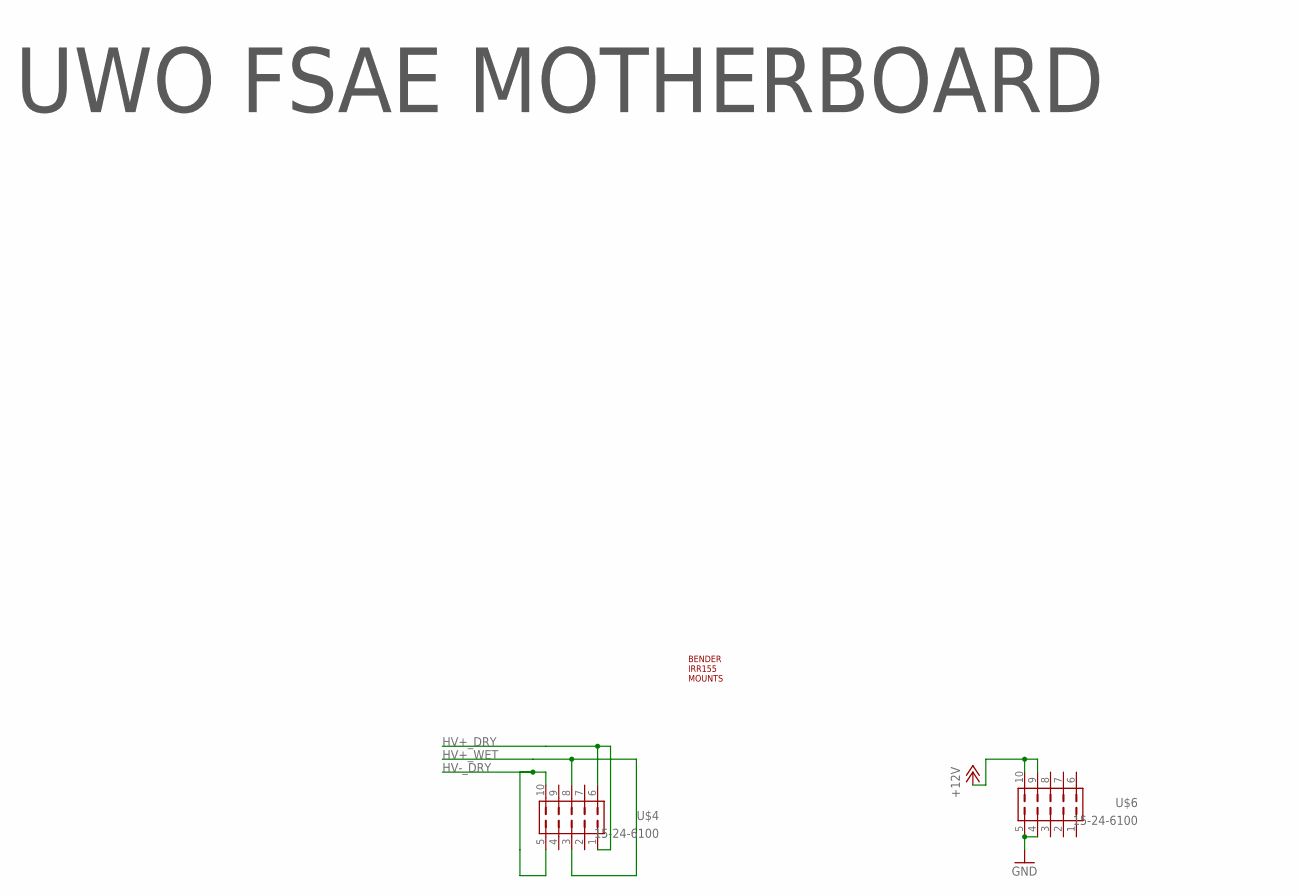
[picture p143: schematic IMDDC.sch]

Parts:
U$1: BENDER_IRR155
U$4, U$6: 15-24-6100

Connections:
+12V: U$6.9, U$6.10
GND: U$6.4, U$6.5
HV+_DRY: U$4.1, U$4.6
HV+_WET: U$4.3, U$4.8
HV-_DRY: U$4.5, U$4.10

Notes on the sheet:
UWO FSAE MOTHERBOARD

Board: 2 copper layers, 3 parts (2 on the bottom side), 5 nets, no tracks yet.
