andrewrichardr/WFR2020/ACC-MB/Rev4/CRDC/CRDC.brd

## EAGLE design ACC-MB/Rev4/CRDC/CRDC.brd (2019-11-23)

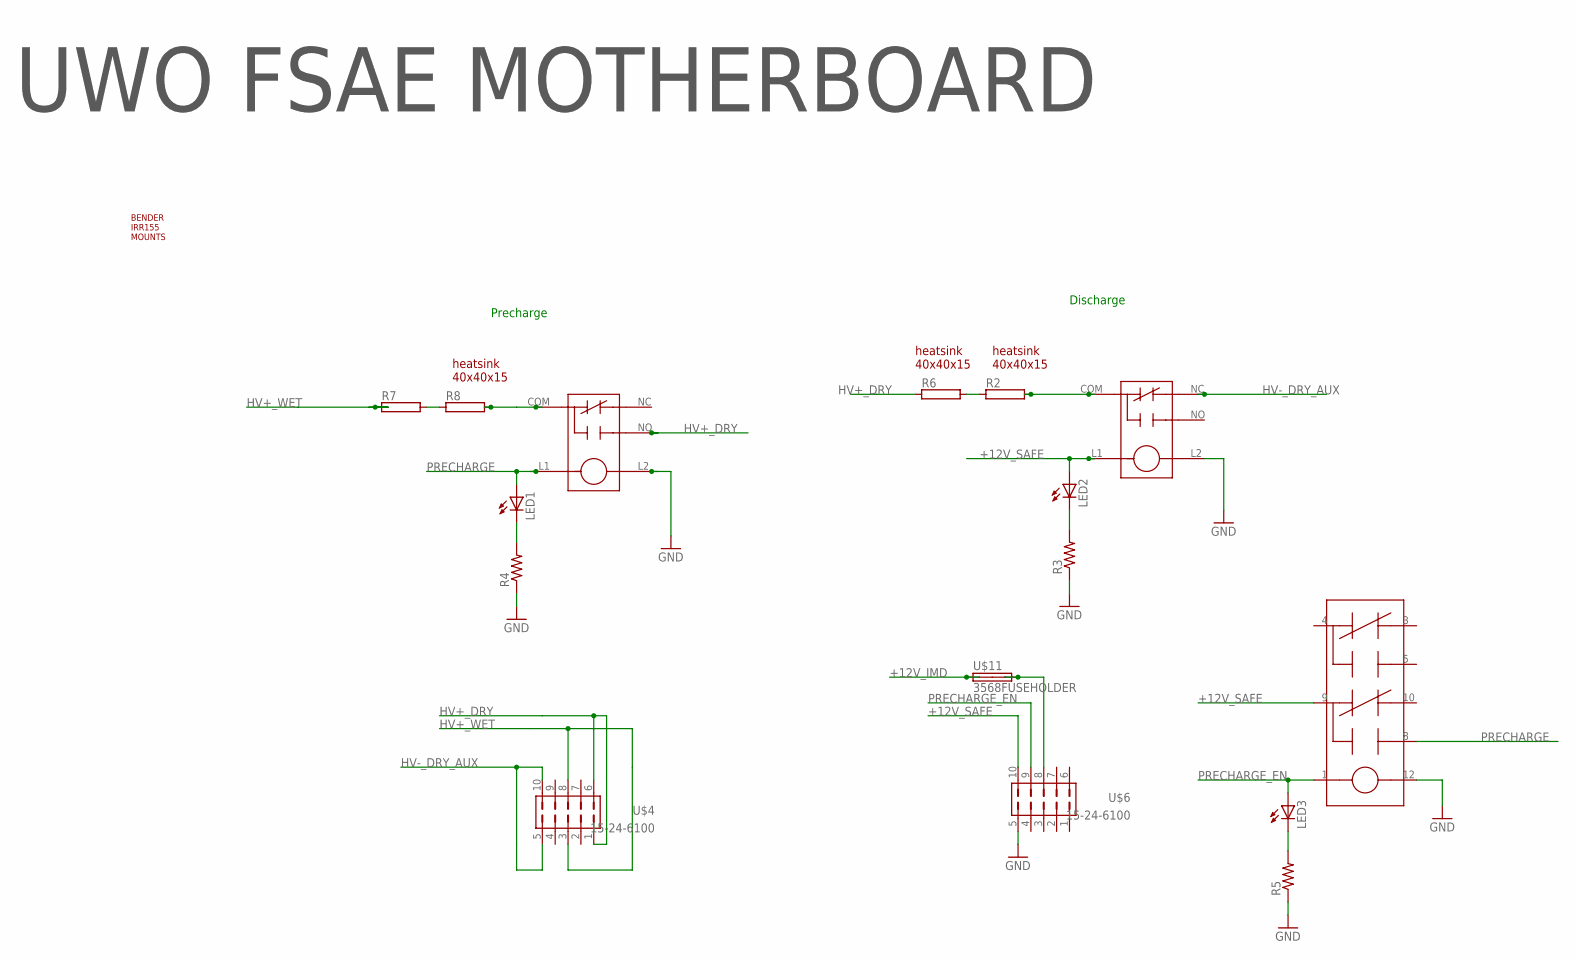
[picture p144: schematic CRDC.sch]

Parts:
LED1, LED2, LED3: LED3MM
R2, R6, R7, R8: RMG100-H; TO-247-2H
R3, R4, R5: R-US_R0805; R0805
U$1, U$2: G81C335
U$4, U$6: 15-24-6100
U$5, U$8, U$9: HEATSINK40X40X15
U$7: V23079B1203B301
U$10: BENDER_IRR155
U$11: 3568FUSEHOLDER; 3568

Connections:
+12V_IMD: U$11.L1 (1A), U$11.L2 (1B)
+12V_SAFE: LED2.A, U$2.L1, U$6.10, U$7.9
GND: R3.1, R4.1, R5.1, U$1.L2, U$2.L2, U$6.5, U$7.12
HV+_DRY: R6.1, U$1.NO, U$4.1, U$4.6
HV+_WET: R7.1, U$4.3, U$4.8
HV-_DRY_AUX: U$2.NC, U$4.5, U$4.10
unnamed: LED2.K (C), R3.2
unnamed: LED3.K (C), R5.2
unnamed: U$6.8, U$11.R1 (2A), U$11.R2 (2B)
unnamed: R2.2, U$2.COM
unnamed: LED1.K (C), R4.2
unnamed: R2.1, R6.2
unnamed: R7.2, R8.1
unnamed: R8.2, U$1.COM
PRECHARGE: LED1.A, U$1.L1, U$7.8
PRECHARGE_EN: LED3.A, U$6.9, U$7.1

Notes on the sheet:
UWO FSAE MOTHERBOARD
Precharge
Discharge

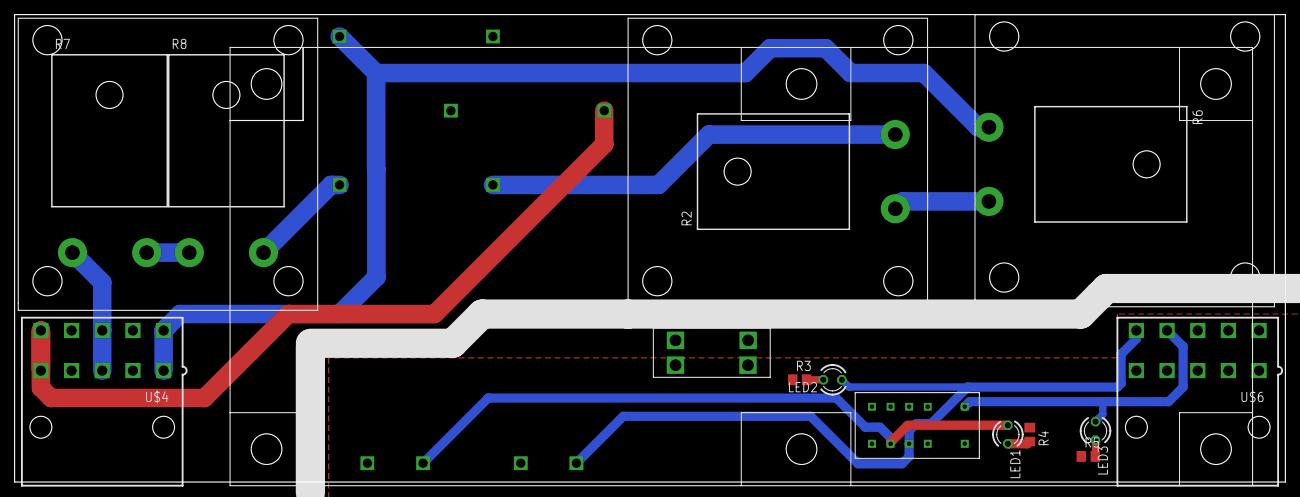
[picture p145: board ACC-MB/Rev4/CRDC/CRDC.brd from above]

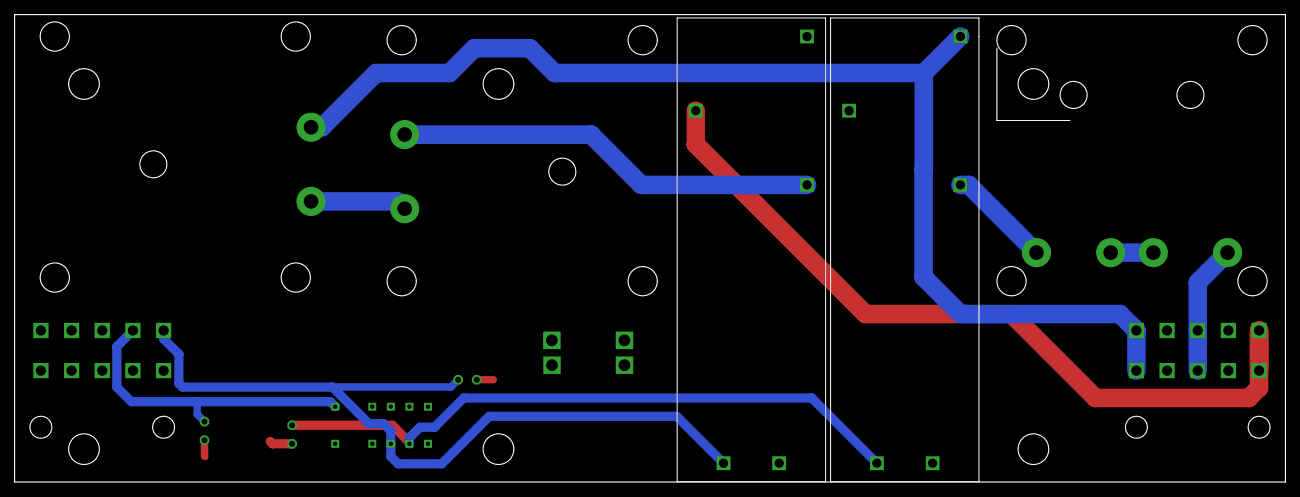
[picture p146: board ACC-MB/Rev4/CRDC/CRDC.brd from below]

Board: 2 copper layers, 174.0 x 64.0 mm, 20 parts (2 on the bottom side), 16 nets.
