andrewrichardr/WFR2020/ACC-MB/Rev4/AIRDCR/AIRDCR.brd

## EAGLE design ACC-MB/Rev4/AIRDCR/AIRDCR.brd (2020-03-10)

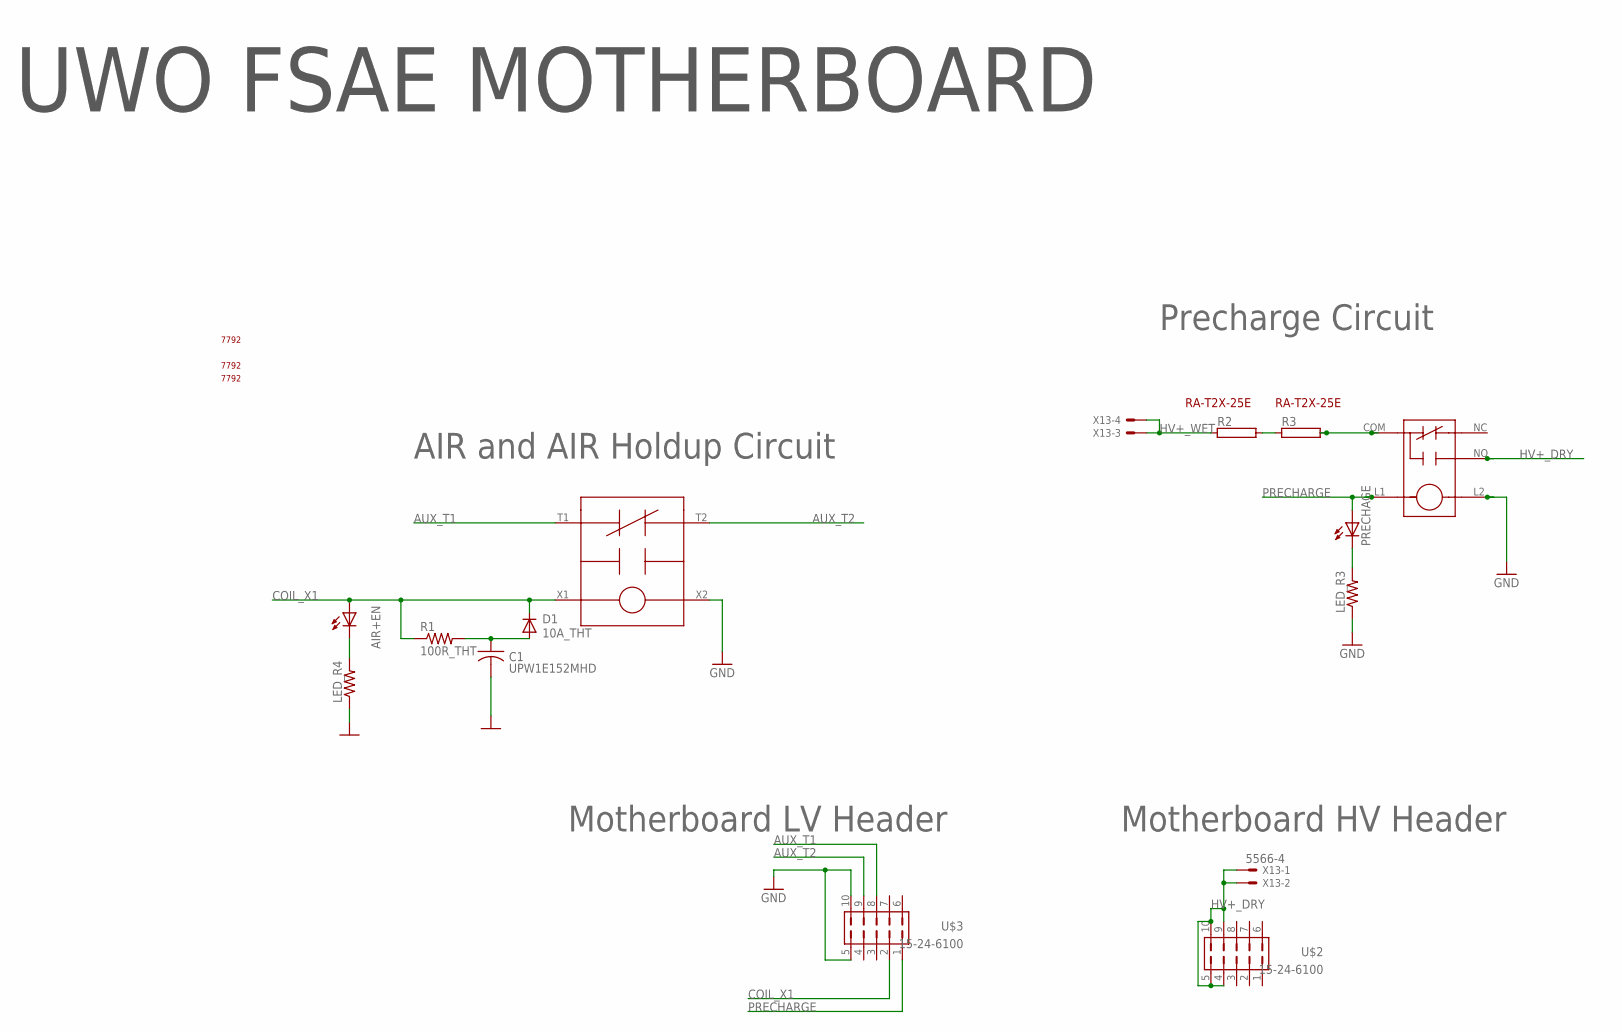
[picture p147: schematic AIRDCR.sch]

Parts:
AIR+EN: LEDCHIPLED_0805; CHIPLED_0805
C1: UPW1E152MHD; CAPPRD750W65D1800H3700B
D1: 10A_THT; DIOAD1570W120L850D500B
LED_R3, LED_R4: R-US_R0805; R0805
PRECHAGE: LEDCHIPLED_0805; CHIPLED_0805
R1: 100R_THT; RESAD976W63L650D250B
R2, R3: RMG100-V; TO-247-2V
U$1: GV245BPB; GV224
U$2, U$3: 15-24-6100
U$4: G81C335
U$5, U$6, U$7: 7792
U$8, U$9: RA-T2X-25E
X13: 5566-4

Connections:
AUX_T1: U$1.T1, U$3.8
AUX_T2: U$1.T2, U$3.9
COIL_X1: AIR+EN.A, D1.1 (C), R1.1, U$1.X1, U$3.2
GND: C1.2, LED_R3.1, LED_R4.1, U$1.X2, U$3.5, U$3.10, U$4.L2
HV+_DRY: U$2.4, U$2.5, U$2.9, U$2.10, U$4.NO, X13.1, X13.2
HV+_WET: R2.1, X13.3, X13.4
unnamed: LED_R3.2, PRECHAGE.C
unnamed: C1.1, D1.2 (A), R1.2
unnamed: R2.2, R3.1
unnamed: AIR+EN.C, LED_R4.2
unnamed: R3.2, U$4.COM
PRECHARGE: PRECHAGE.A, U$3.1, U$4.L1

Notes on the sheet:
UWO FSAE MOTHERBOARD
AIR and AIR Holdup Circuit
Precharge Circuit
Motherboard LV Header
Motherboard HV Header

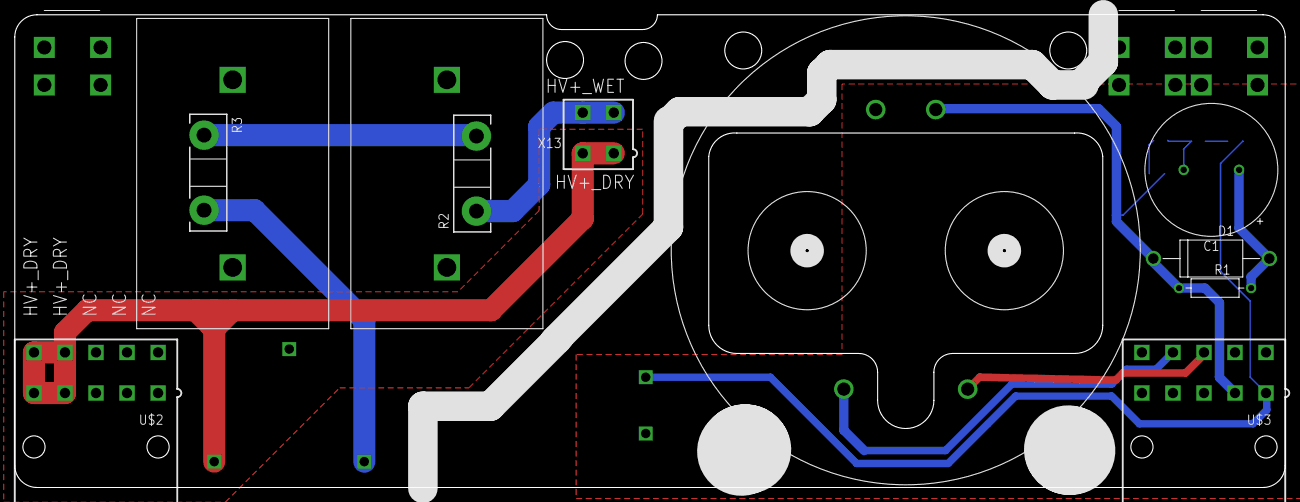
[picture p148: board ACC-MB/Rev4/AIRDCR/AIRDCR.brd from above]

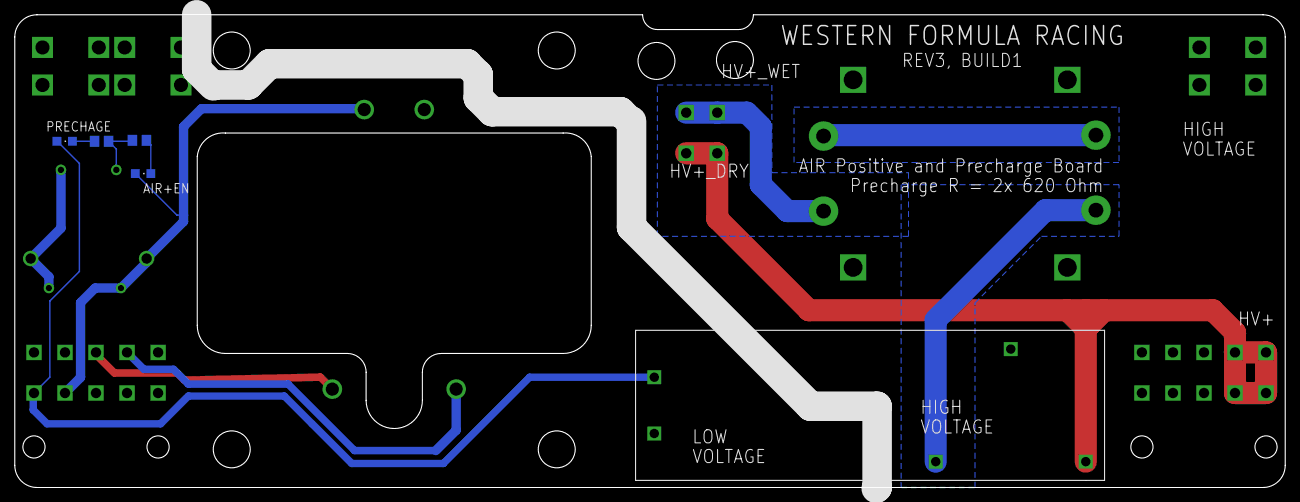
[picture p149: board ACC-MB/Rev4/AIRDCR/AIRDCR.brd from below]

Board: 2 copper layers, 172.0 x 64.0 mm, 19 parts (5 on the bottom side), 12 nets.
