andrewrichardr/WFR2020/ACC-MB/Rev4/HVIBDC/HVIBDC.brd

## EAGLE design ACC-MB/Rev4/HVIBDC/HVIBDC.brd (2020-01-11)

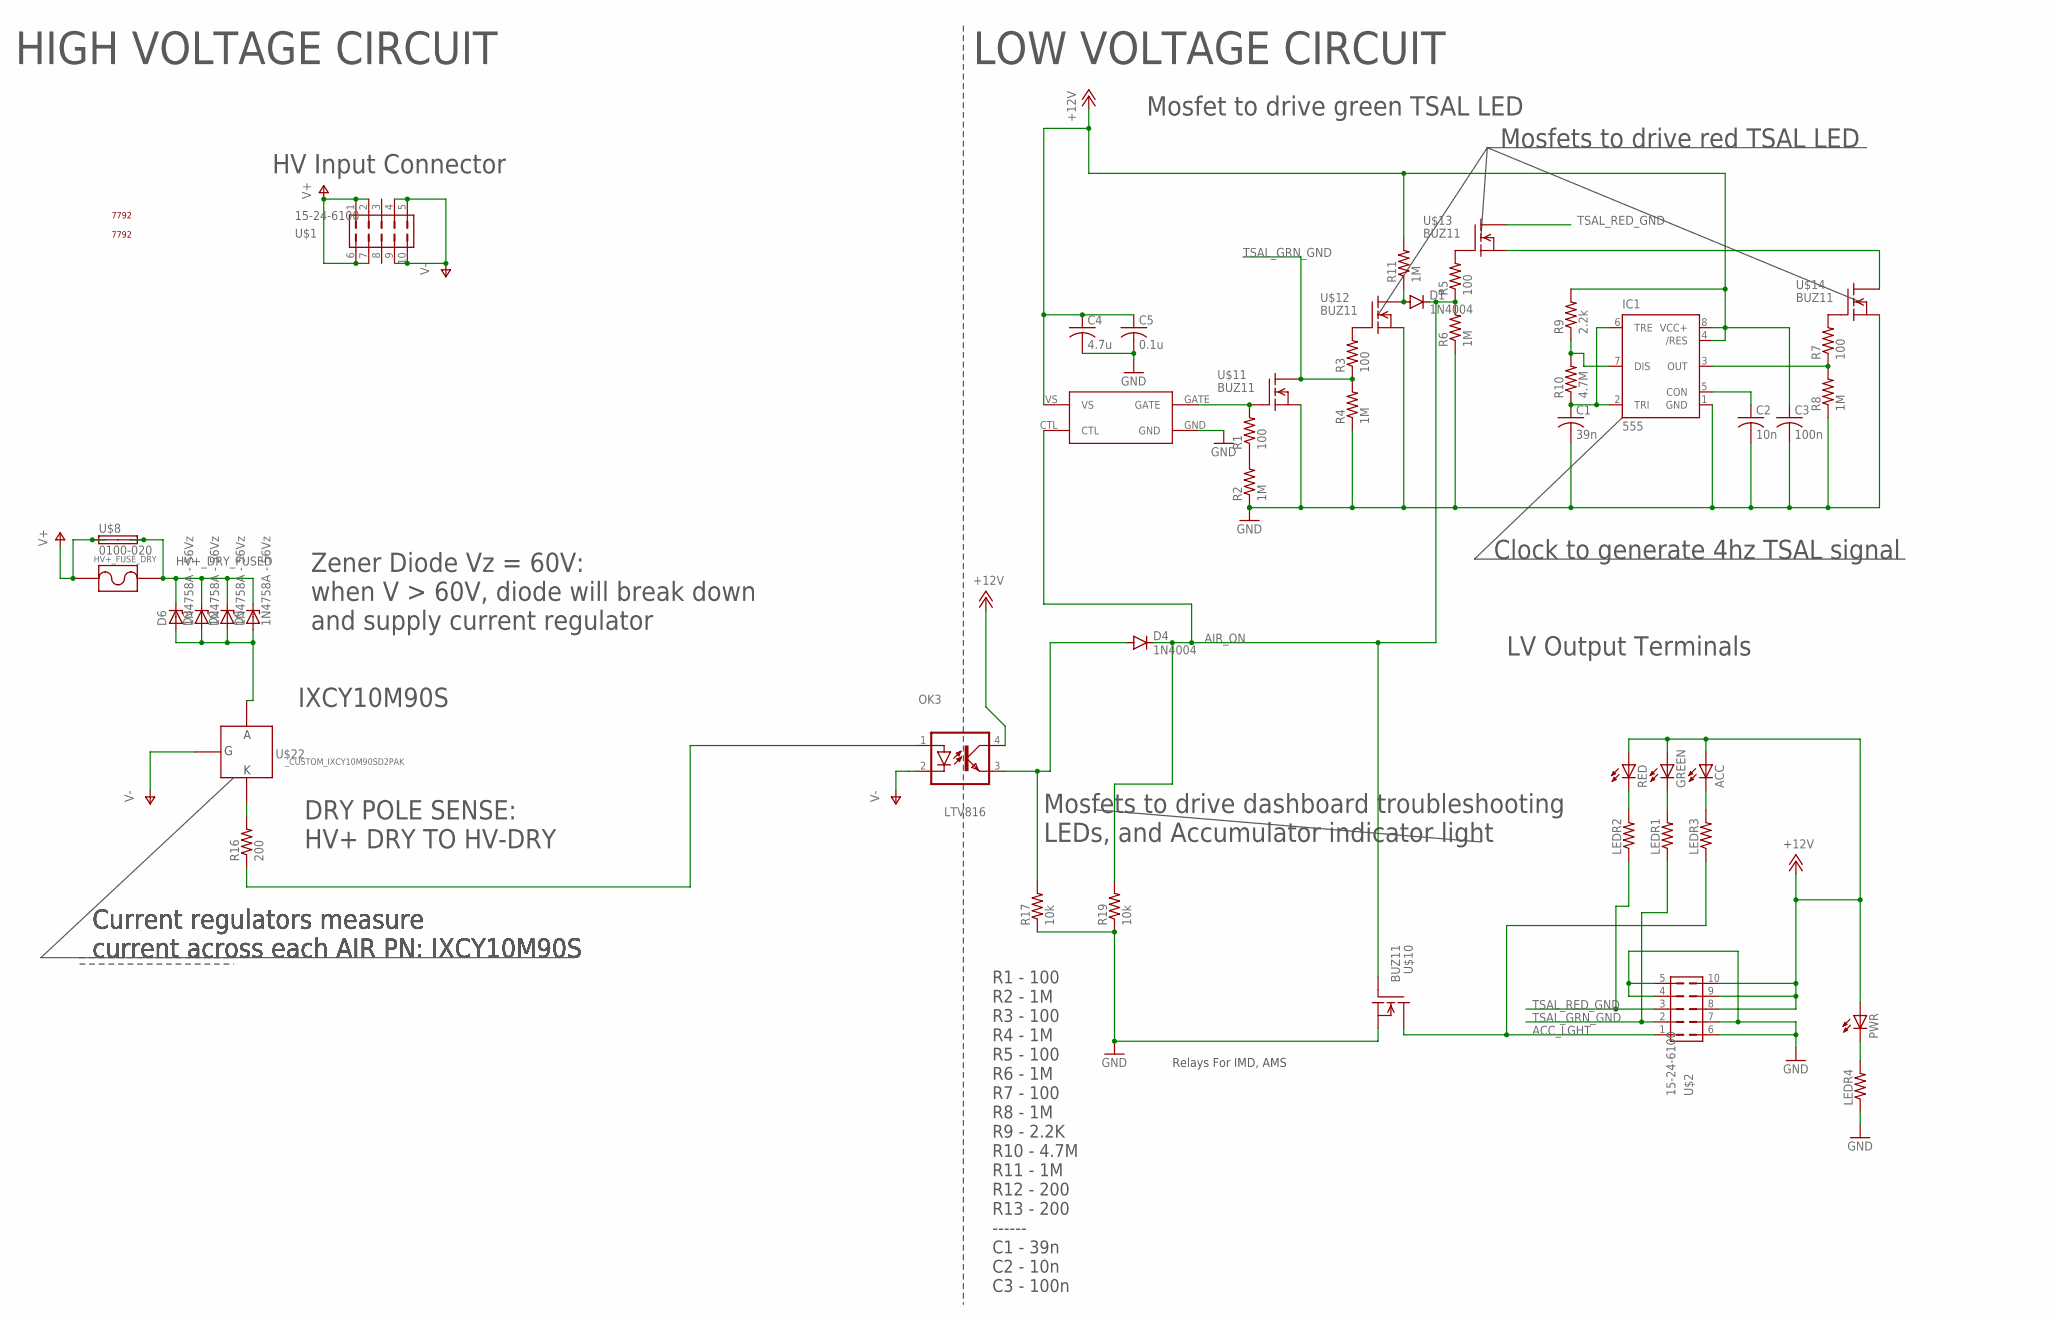
[picture p150: schematic HVIBDC.sch]

Parts:
ACC: LEDCHIPLED_0805; CHIPLED_0805
C1: 39n; C0805
C2: 10n; C0805
C3: 100n; C0805
C4: 4.7u; C0805
C5: 0.1u; C0805
D1, D4: 1N4004; DO41-10
D2, D3, D5, D6: 1N4758A - 56Vz; ZDIO12.5
GREEN: LEDCHIPLED_0805; CHIPLED_0805
HV+_FUSE_DRY: _CUSTOM_PARTS_LF_885
IC1: 555; DIP08
LEDR1, LEDR2, LEDR3, LEDR4: R-US_R0805; R0805
OK3: LTV816; DIL04
PWR: LEDCHIPLED_0805; CHIPLED_0805
R1, R3, R5, R7: 100; R0805
R2, R4, R6, R8, R11: 1M; R0805
R9: 2.2k; R0805
R10: 4.7M; R0805
R16: 200; R2010
R17, R19: 10k; R0805
RED: LEDCHIPLED_0805; CHIPLED_0805
U$1, U$2: 15-24-6100
U$3, U$4: 7792
U$8: 0100-020
U$10, U$11, U$12, U$13, U$14: BUZ11; TO220
U$15: MIC4417; PDM_2019_REVB_MIC4416YM4-TR
U$22: _CUSTOM_IXCY10M90SD2PAK; TO228P991X238-3

Connections:
+12V: ACC.A, C3.1, C4.1, C5.1, GREEN.A, IC1.4 (/RES), IC1.8 (VCC+), OK3.4 (COL), PWR.A, R9.2, R11.2, RED.A, U$2.8, U$2.9, U$2.10, U$15.VS
ACC_LGHT: LEDR3.1, U$2.1, U$10.2 (D)
AIR_ON: D1.C, D4.C, R5.1, R6.2, R19.2, U$10.1 (G), U$15.CTL
GND: C1.2, C2.2, C3.2, C4.2, C5.2, IC1.1 (GND), LEDR4.1, R2.1, R4.1, R6.1, R8.1, R17.1, R19.1, U$2.4, U$2.5, U$2.6, U$2.7, U$10.3 (S), U$11.3 (S), U$12.3 (S), U$14.3 (S), U$15.GND
HV+_DRY_FUSED: D2.C, D3.C, D5.C, D6.C, HV+_FUSE_DRY.P$1, U$8.P$2 (2A), U$8.P$4 (2B)
unnamed: R1.1, R2.2
unnamed: R1.2, U$11.1 (G), U$15.GATE
unnamed: R3.2, U$12.1 (G)
unnamed: C2.1, IC1.5 (CON)
unnamed: IC1.7 (DIS), R9.1, R10.2
unnamed: R5.2, U$13.1 (G)
unnamed: R7.2, U$14.1 (G)
unnamed: IC1.3 (OUT), R7.1, R8.2
unnamed: C1.1, IC1.2 (TRI), IC1.6 (TRE), R10.1
unnamed: ACC.C, LEDR3.2
unnamed: GREEN.C, LEDR1.2
unnamed: U$13.3 (S), U$14.2 (D)
unnamed: D4.A, OK3.3 (EMIT), R17.2
unnamed: D1.A, R11.1, U$12.2 (D)
unnamed: LEDR2.2, RED.C
unnamed: LEDR4.2, PWR.C
unnamed: R16.2, U$22.2 (K)
unnamed: D2.A, D3.A, D5.A, D6.A, U$22.3 (A)
unnamed: OK3.1 (A), R16.1
TSAL_GRN_GND: LEDR1.1, R3.1, R4.2, U$2.2, U$11.2 (D)
TSAL_RED_GND: LEDR2.1, U$2.3, U$13.2 (D)
V+: HV+_FUSE_DRY.P$2, U$1.1, U$1.2, U$1.6, U$1.7, U$8.P$1 (1A), U$8.P$3 (1B)
V-: OK3.2 (C), U$1.4, U$1.5, U$1.9, U$1.10, U$22.1 (G)

Notes on the sheet:
HIGH VOLTAGE CIRCUIT
LOW VOLTAGE CIRCUIT
Mosfets to drive dashboard troubleshooting LEDs, and Accumulator indicator light
Clock to generate 4hz TSAL signal
Mosfets to drive red TSAL LED
Mosfet to drive green TSAL LED
LV Output Terminals
R1 - 100 R2 - 1M R3 - 100 R4 - 1M R5 - 100 R6 - 1M R7 - 100 R8 - 1M R9 - 2.2K R10 - 4.7M R11 - 1M R12 - 200 R13 - 200 ------ C1 - 39n C2 - 10n C3 - 100n
Relays For IMD, AMS
Current regulators measure current across each AIR PN: IXCY10M90S
DRY POLE SENSE: HV+ DRY TO HV-DRY
IXCY10M90S
Zener Diode Vz = 60V: when V > 60V, diode will break down and supply current regulator
HV Input Connector

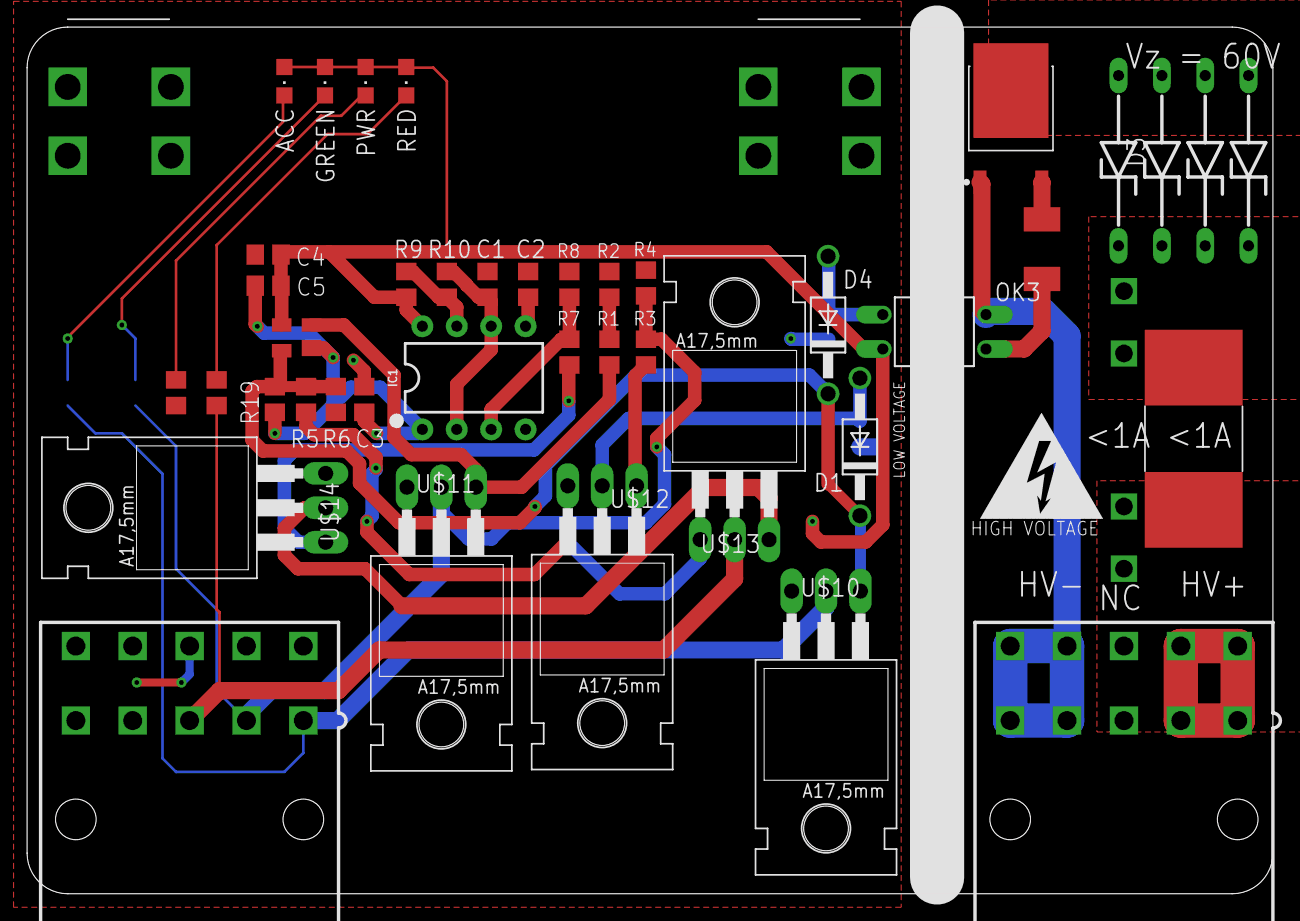
[picture p151: board HVIBDC.brd from above]

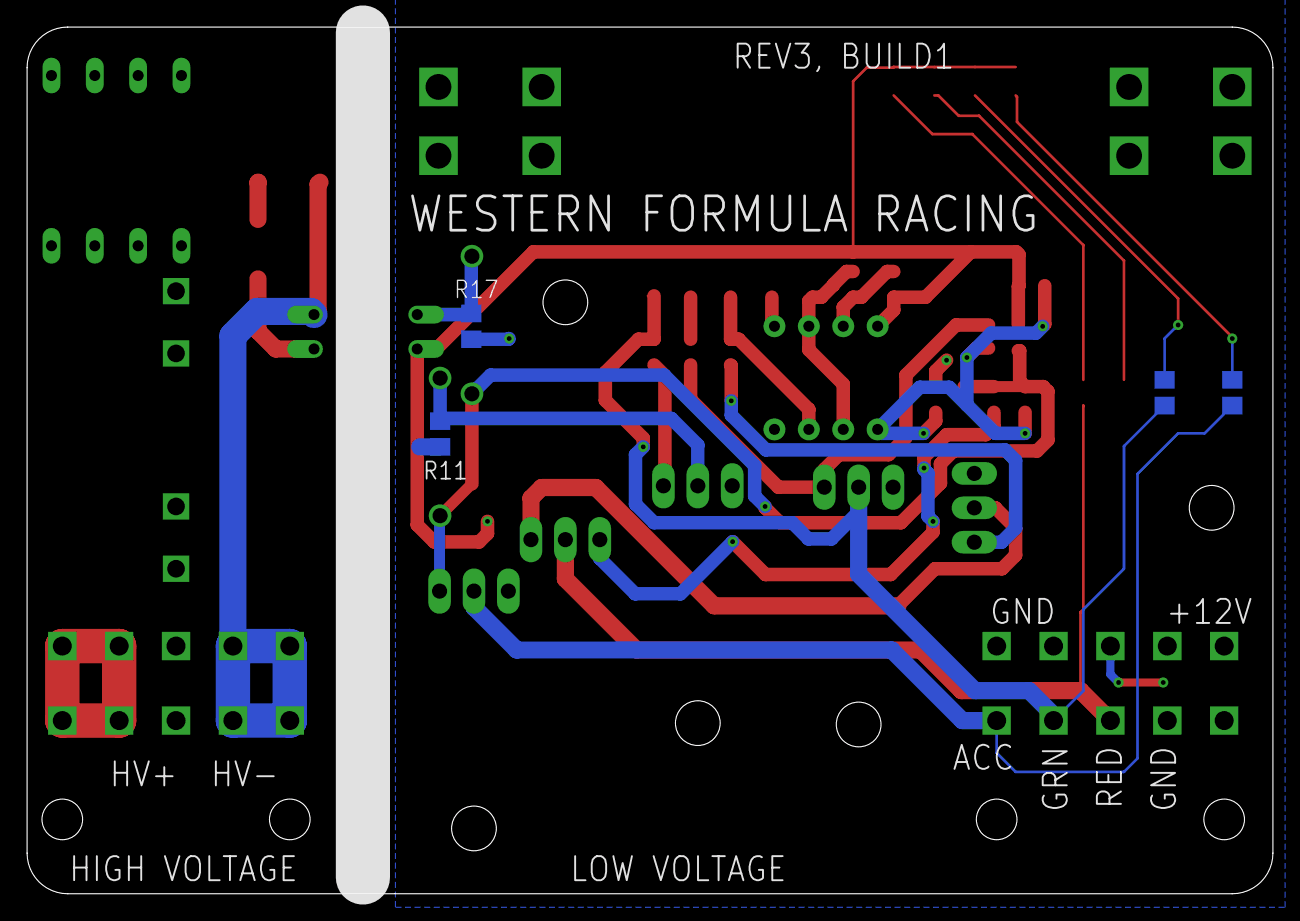
[picture p152: board HVIBDC.brd from below]

Board: 2 copper layers, 92.0 x 64.0 mm, 48 parts (4 on the bottom side), 28 nets.
