andrewrichardr/WFR2020/Zach/sensor calibration board.brd

## EAGLE design Zach/sensor calibration board.brd (2020-03-10)

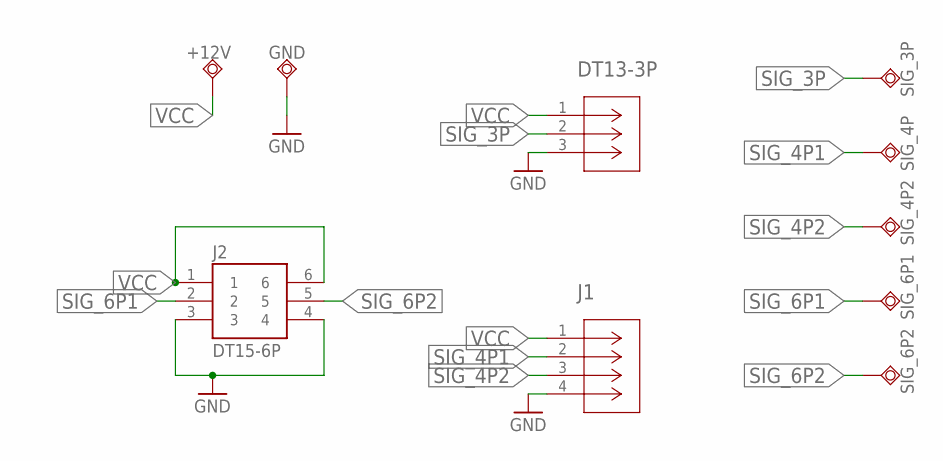
[picture p153: schematic sensor calibration board.sch]

Parts:
+12V: TPSQPAD1-20Y; P1-20Y
DT13-3P: DTF13-3P; CONN3_DTF13-3P
GND: TPSQPAD1-20Y; P1-20Y
J1: DT15-4P-G003S; CONN4_DT15-4P-G003
J2: DT15-6P; TE_DT15-6P
SIG_3P, SIG_4P, SIG_4P2, SIG_6P1, SIG_6P2: TPSQPAD1-20Y; P1-20Y

Connections:
GND: DT13-3P.3, GND.1, J1.4, J2.3, J2.4
SIG_3P: DT13-3P.2, SIG_3P.1
SIG_4P1: J1.2, SIG_4P.1
SIG_4P2: J1.3, SIG_4P2.1
SIG_6P1: J2.2, SIG_6P1.1
SIG_6P2: J2.5, SIG_6P2.1
VCC: +12V.1, DT13-3P.1, J1.1, J2.1, J2.6

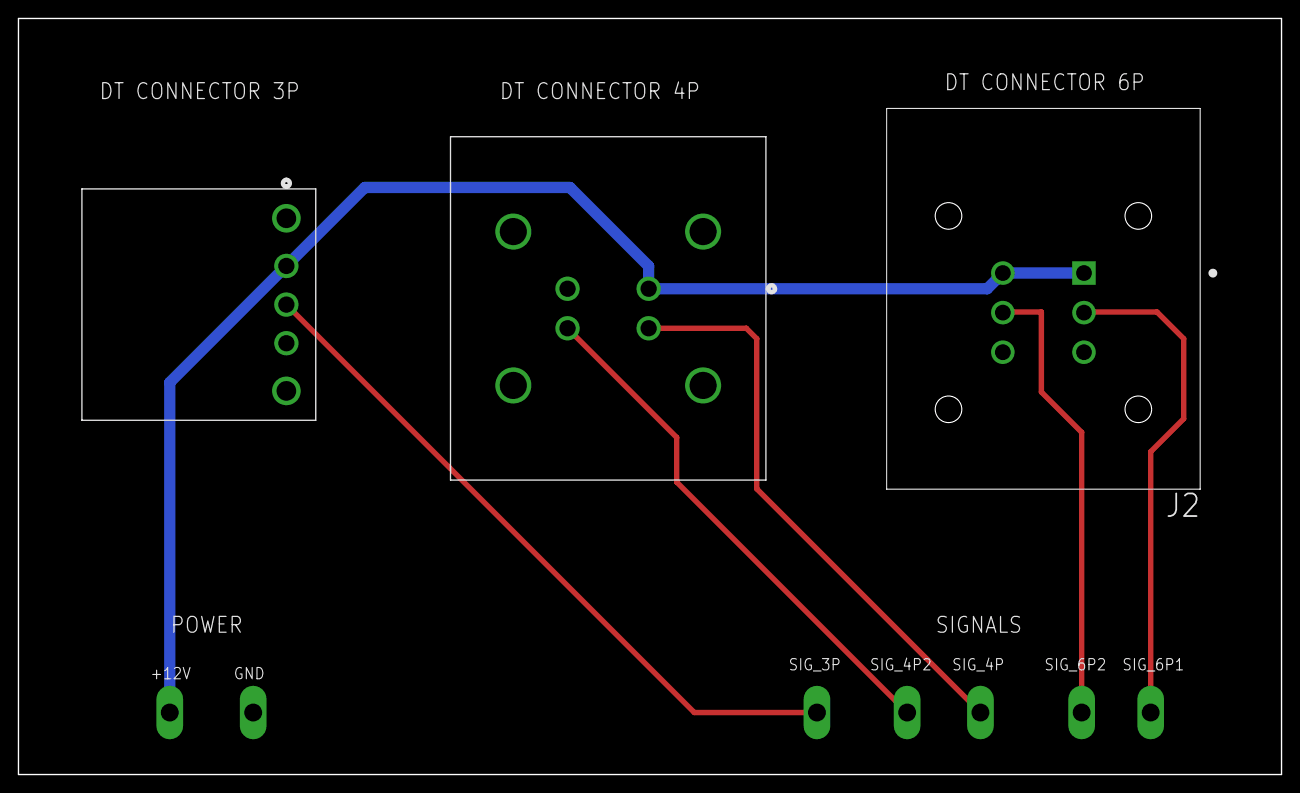
[picture p154: board sensor calibration board.brd from above]

Board: 2 copper layers, 142.0 x 85.0 mm, 10 parts (0 on the bottom side), 7 nets.
