andrewrichardr/WFR2020/PDM-GLV/PDM.brd

## EAGLE design PDM-GLV/PDM.brd (2020-01-11)

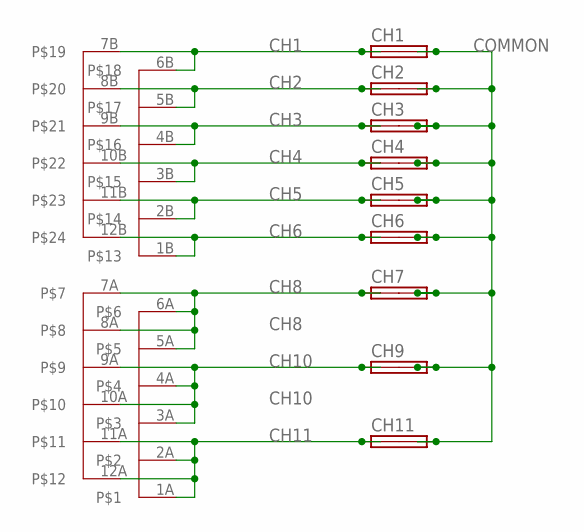
[picture p158: schematic PDM.sch]

Parts:
CH1, CH2, CH3, CH4, CH5, CH6, CH7, CH9, CH11: 3568FUSEHOLDER; 3568
U$4: DTM1312PA12BR008; DE_12X2_PIN_HEADER

Connections:
CH1: CH1.L1 (1A), CH1.L2 (1B), U$4.6B, U$4.7B
CH2: CH2.L1 (1A), CH2.L2 (1B), U$4.5B, U$4.8B
CH3: CH3.L1 (1A), CH3.L2 (1B), U$4.4B, U$4.9B
CH4: CH4.L1 (1A), CH4.L2 (1B), U$4.3B, U$4.10B
CH5: CH5.L1 (1A), CH5.L2 (1B), U$4.2B, U$4.11B
CH6: CH6.L1 (1A), CH6.L2 (1B), U$4.1B, U$4.12B
CH8: CH7.L1 (1A), CH7.L2 (1B), U$4.5A, U$4.6A, U$4.7A, U$4.8A
CH10: CH9.L1 (1A), CH9.L2 (1B), U$4.3A, U$4.4A, U$4.9A, U$4.10A
CH11: CH11.L1 (1A), CH11.L2 (1B), U$4.1A, U$4.2A, U$4.11A, U$4.12A
COMMON: CH1.R1 (2A), CH1.R2 (2B), CH2.R1 (2A), CH2.R2 (2B), CH3.R1 (2A), CH3.R2 (2B), CH4.R1 (2A), CH4.R2 (2B), CH5.R1 (2A), CH5.R2 (2B), CH6.R1 (2A), CH6.R2 (2B), CH7.R1 (2A), CH7.R2 (2B), CH9.R1 (2A), CH9.R2 (2B), CH11.R1 (2A), CH11.R2 (2B)

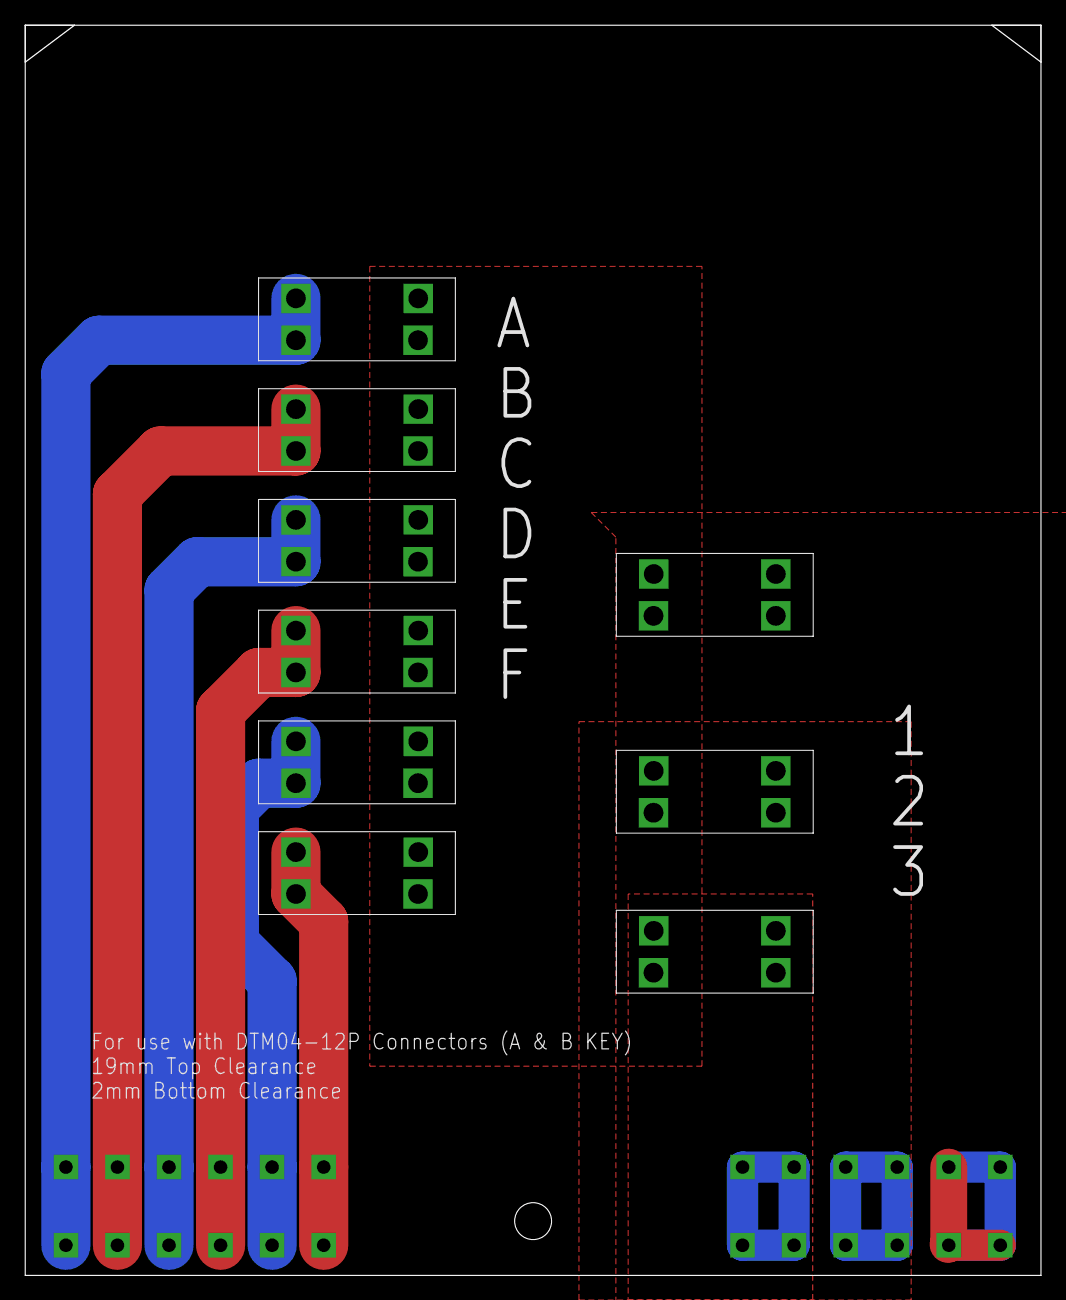
[picture p159: board PDM.brd from above]

Board: 2 copper layers, 82.5 x 101.6 mm, 10 parts (0 on the bottom side), 10 nets.
