andrewrichardr/WFR2020/dashboard/dashboard (2).brd

## EAGLE design dashboard/dashboard (2).brd (2020-01-11)

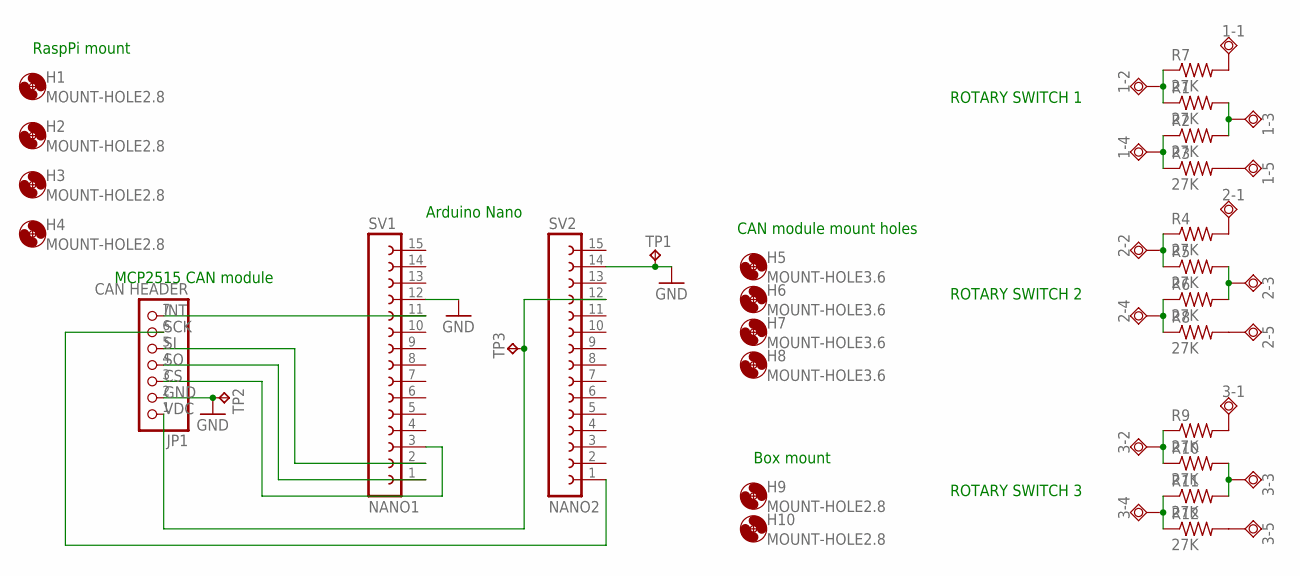
[picture p160: schematic dashboard (2).sch]

Parts:
1-1, 1-5, 2-1, 2-5, 3-1, 3-5: TPSQPAD1-13Y; P1-13Y
1-2, 1-3, 1-4, 2-2, 2-3, 2-4, 3-2, 3-3, 3-4: TPSQPAD1-13; P1-13
H1, H2, H3, H4, H9, H10: MOUNT-HOLE2.8; 2,8
H5, H6, H7, H8: MOUNT-HOLE3.6; 3,6
JP1: CAN HEADER; 1X07M
R1, R2, R3, R4, R5, R6, R7, R8, R9, R10, R11, R12: 27K; 0309/10
SV1: NANO1; FE15
SV2: NANO2; FE15
TP1, TP2, TP3: TPTP20SQ; TP20SQ

Connections:
2-2: 2-2.1, R4.1, R5.1
CS: JP1.3, SV1.3
GND: JP1.2, SV1.12, SV2.14, TP1.TP, TP2.TP
INT: JP1.7, SV1.11
unnamed: 1-1.1, R7.2
unnamed: 1-4.1, R2.1, R3.1
unnamed: 2-3.1, R5.2, R6.2
unnamed: 2-1.1, R4.2
unnamed: 3-1.1, R9.2
unnamed: 1-2.1, R1.1, R7.1
unnamed: 1-3.1, R1.2, R2.2
unnamed: 2-4.1, R6.1, R8.1
unnamed: 3-2.1, R9.1, R10.1
unnamed: 3-3.1, R10.2, R11.2
unnamed: 3-4.1, R11.1, R12.1
unnamed: 2-5.1, R8.2
unnamed: 1-5.1, R3.2
unnamed: 3-5.1, R12.2
SCK: JP1.6, SV2.1
SI: JP1.5, SV1.2
SO: JP1.4, SV1.1
VDC: JP1.1, SV2.12, TP3.TP

Notes on the sheet:
CAN module mount holes
Box mount
RaspPi mount
MCP2515 CAN module
Arduino Nano
ROTARY SWITCH 1
ROTARY SWITCH 2
ROTARY SWITCH 3

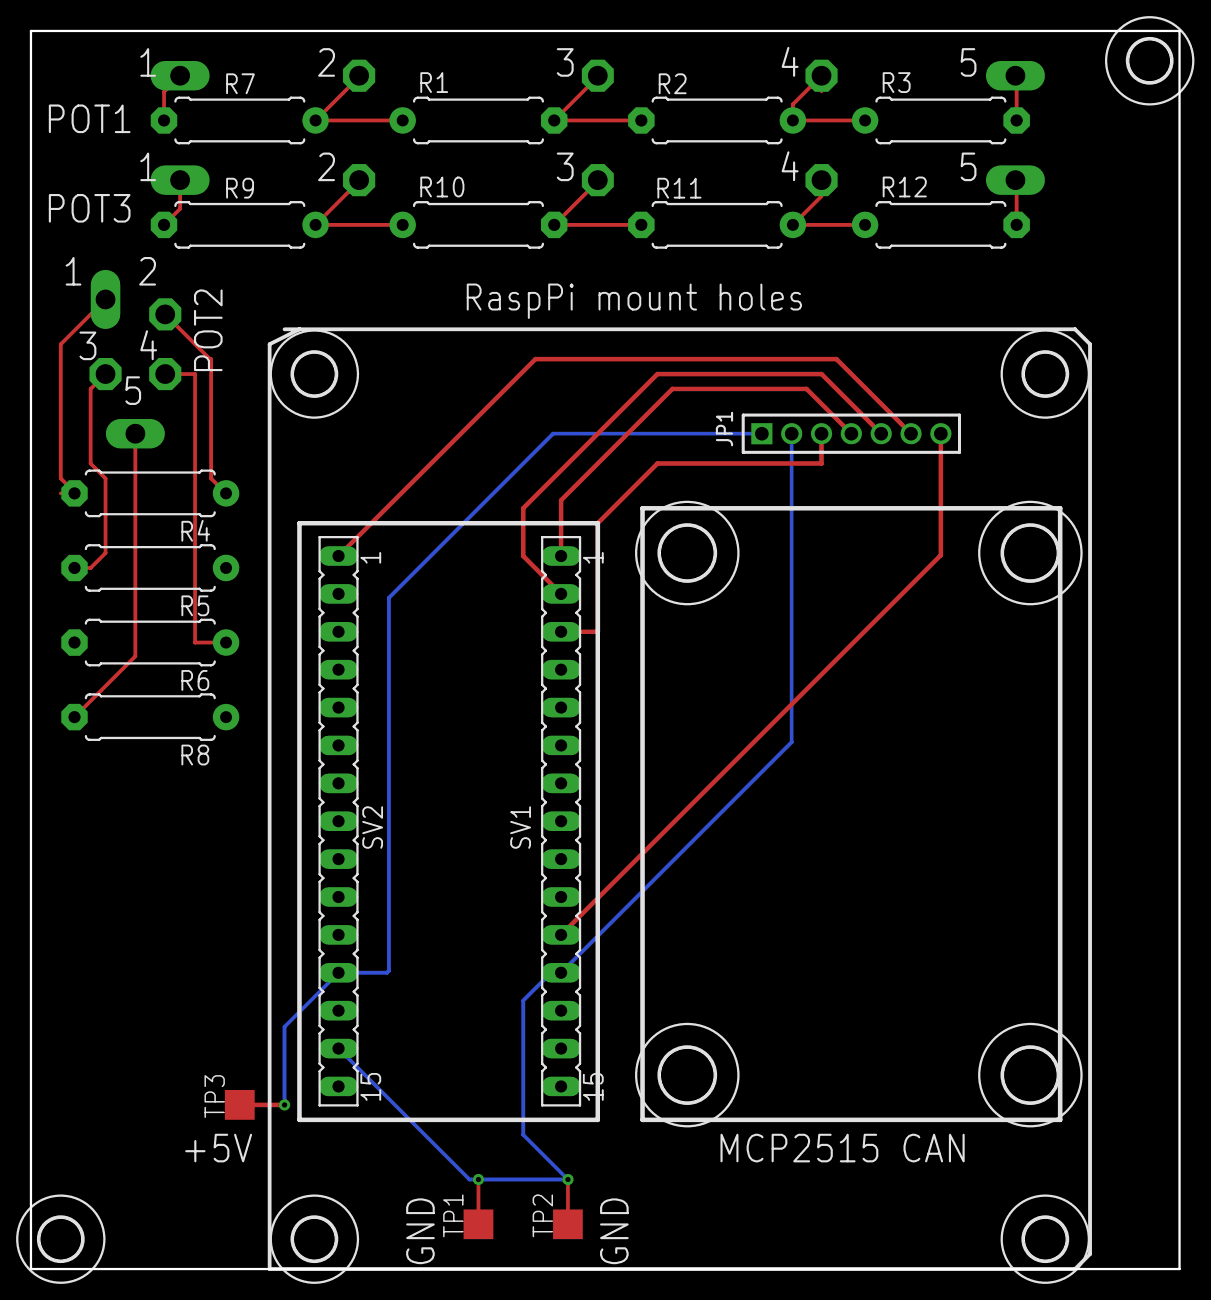
[picture p161: board dashboard (2).brd from above]

Board: 2 copper layers, 77.0 x 83.0 mm, 43 parts (0 on the bottom side), 22 nets.
