andrewrichardr/WFR2020/boardqwang/TempSensorCircuit_v3.brd

## EAGLE design boardqwang/TempSensorCircuit_v3.brd (2019-12-12)

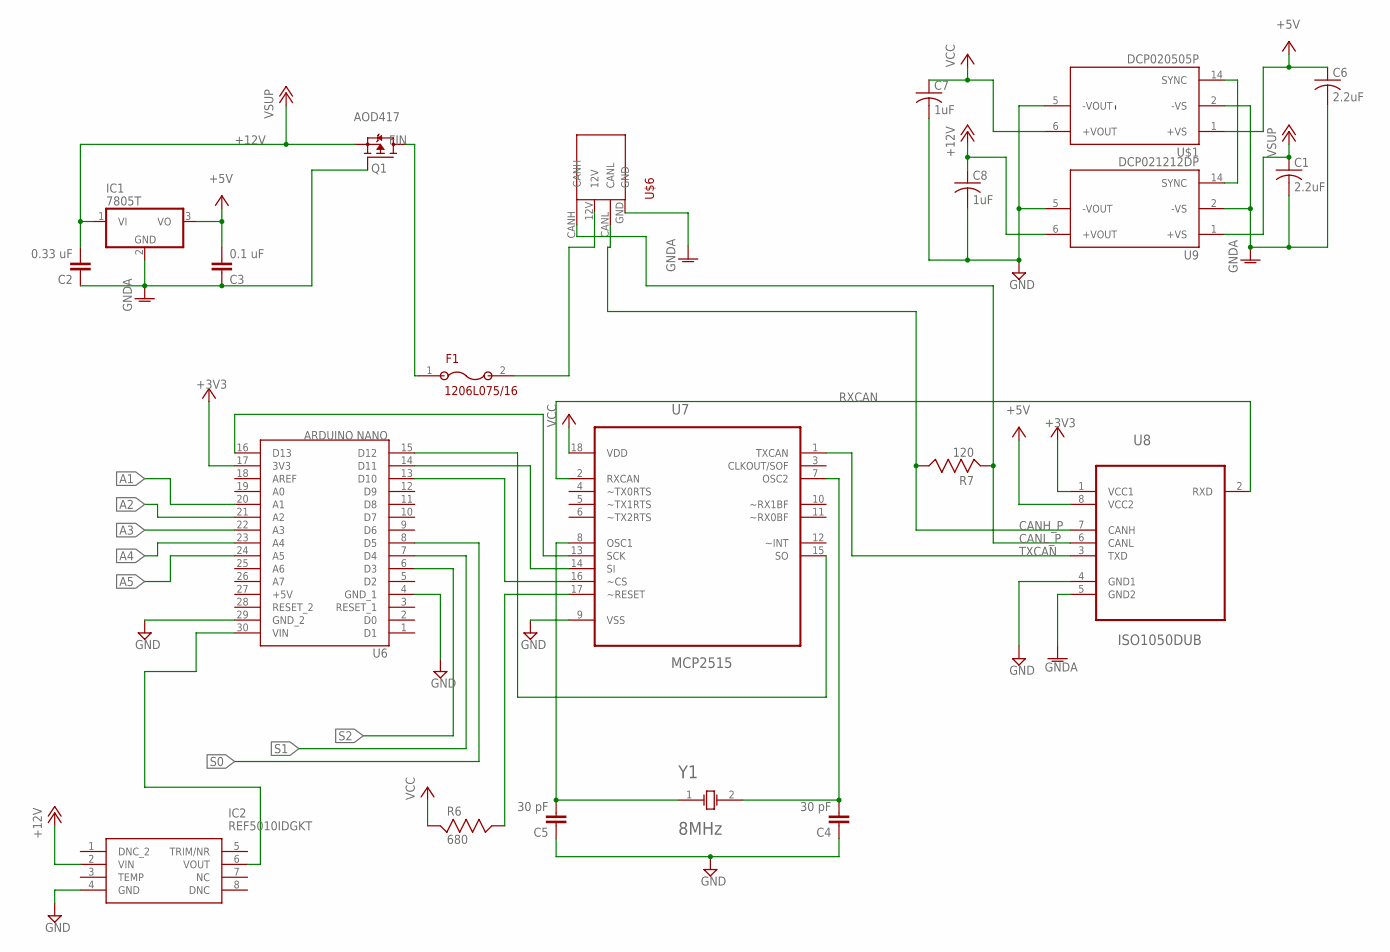
[picture p162: schematic TempSensorCircuit_v3.sch, sheet 1]

Parts:
C1, C6: 2.2uF; C0805
C2: 0.33 uF; C5B2.5
C3: 0.1 uF; C5B2.5
C4, C5: 30 pF; C5B2.5
C7, C8: 1uF; C0805
F1: 1206L075/16
IC1: 7805T; TO220H
IC2: REF5010IDGKT; SOP65P490X110-8N
Q1: AOD417; TO252
R6: 680; RESC2012X60
R7: 120; RESC2012X60
U6: ARDUINO NANO; NANO
U7: MCP2515; DIP254P762X432-18
U8: ISO1050DUB; SOP254P1040X485-8N
U9: DCP021212DP; DIP763W46P254L1969H533Q14
U$1: DCP020505P; DIP763W46P254L1969H533Q14
U$6: 0026013142-ND
Y1: 8MHz; XTAL_HC49P488W43L1135T465H360

Connections:
+3V3: U6.17 (3V3), U8.1 (VCC1)
+5V: C3.2, C6.1, IC1.3 (VO), U6.27 (+5V), U8.8 (VCC2), U$1.1 (+VS)
+12V: C1.1, C2.2, C8.1, IC1.1 (VI), IC2.2 (VIN), Q1.2 (S), U9.1 (+VS), U9.6 (+VOUT)
A1: U6.20 (A1); also elsewhere on the board
A2: U6.21 (A2); also elsewhere on the board
A3: U6.22 (A3); also elsewhere on the board
A4: U6.23 (A4); also elsewhere on the board
A5: U6.24 (A5); also elsewhere on the board
CANH_P: R7.2, U8.7 (CANH), U$6.CANL
CANL_P: R7.1, U8.6 (CANL), U$6.CANH
FIN: F1.1, Q1.3 (D)
GND: C4.1, C5.1, C7.2, C8.2, IC2.4 (GND), U6.4 (GND_1), U6.29 (GND_2), U7.9 (VSS), U8.4 (GND1), U9.5 (-VOUT), U$1.5 (-VOUT); also elsewhere on the board
GNDA: C1.2, C2.1, C3.1, C6.2, IC1.2 (GND), Q1.1 (G), U8.5 (GND2), U9.2 (-VS), U$1.2 (-VS), U$6.GND
unnamed: R6.2, U7.17 (~RESET)
unnamed: U6.16 (D13), U7.13 (SCK)
unnamed: U6.14 (D11), U7.14 (SI)
unnamed: U6.15 (D12), U7.15 (SO)
unnamed: U6.13 (D10), U7.16 (~CS)
unnamed: IC2.6 (VOUT), U6.30 (VIN)
unnamed: F1.2, U$6.12V
unnamed: U9.14 (SYNC), U$1.14 (SYNC)
OSC_N: C5.2, U7.8 (OSC1), Y1.1
OSC_P: C4.2, U7.7 (OSC2), Y1.2
RXCAN: U7.2 (RXCAN), U8.2 (RXD)
S0: U6.8 (D5); also elsewhere on the board
S1: U6.7 (D4); also elsewhere on the board
S2: U6.6 (D3); also elsewhere on the board
TXCAN: U7.1 (TXCAN), U8.3 (TXD)
VCC: C7.1, R6.1, U7.18 (VDD), U$1.6 (+VOUT); also elsewhere on the board

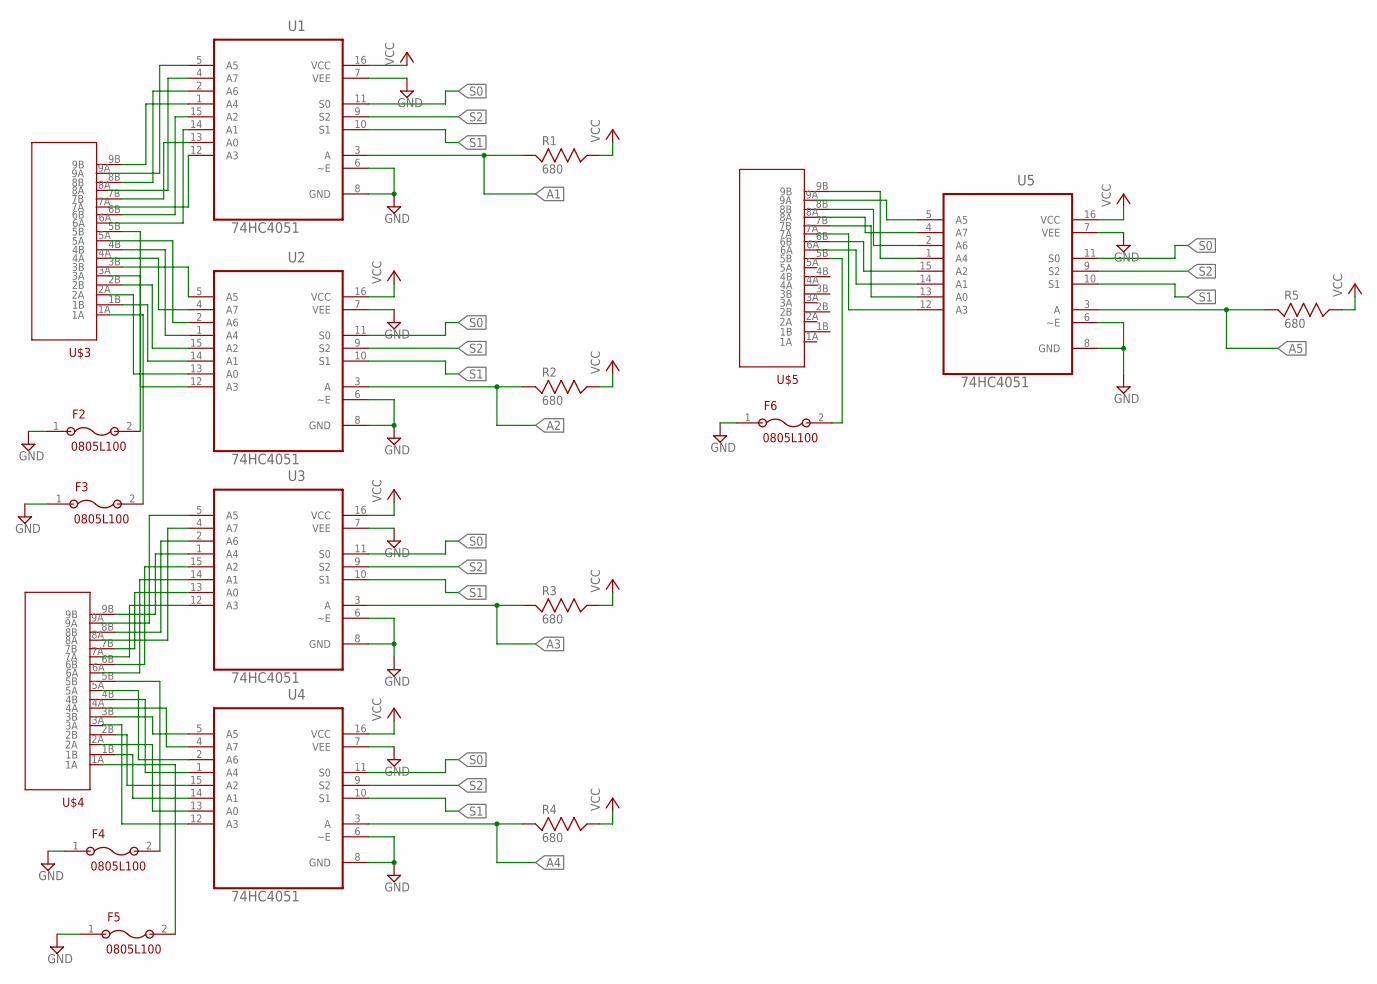
[picture p163: schematic TempSensorCircuit_v3.sch, sheet 2]

Parts:
F2, F3, F4, F5, F6: 0805L100; 2012
R1, R2, R3, R4, R5: 680; RESC2012X60
U1, U2, U3, U4, U5: 74HC4051; DIP254P762X508-16
U$3, U$4, U$5: WM1359-ND

Connections:
A1: R1.1, U1.3 (A); also elsewhere on the board
A2: R2.1, U2.3 (A); also elsewhere on the board
A3: R3.1, U3.3 (A); also elsewhere on the board
A4: R4.1, U4.3 (A); also elsewhere on the board
A5: R5.1, U5.3 (A); also elsewhere on the board
GND: F2.1, F3.1, F4.1, F5.1, F6.1, U1.6 (~E), U1.7 (VEE), U1.8 (GND), U2.6 (~E), U2.7 (VEE), U2.8 (GND), U3.6 (~E), U3.7 (VEE), U3.8 (GND), U4.6 (~E), U4.7 (VEE), U4.8 (GND), U5.6 (~E), U5.7 (VEE), U5.8 (GND); also elsewhere on the board
unnamed: U1.1 (A4), U$3.9B
unnamed: U1.2 (A6), U$3.8B
unnamed: U1.5 (A5), U$3.9A
unnamed: U1.4 (A7), U$3.8A
unnamed: U1.15 (A2), U$3.6B
unnamed: U1.14 (A1), U$3.6A
unnamed: U1.13 (A0), U$3.7B
unnamed: U1.12 (A3), U$3.7A
unnamed: U2.2 (A6), U$3.5A
unnamed: U2.1 (A4), U$3.4B
unnamed: U2.4 (A7), U$3.4A
unnamed: U2.5 (A5), U$3.3B
unnamed: U2.15 (A2), U$3.2B
unnamed: U2.14 (A1), U$3.1B
unnamed: U2.12 (A3), U$3.3A
unnamed: U2.13 (A0), U$3.2A
unnamed: F2.2, U$3.5B
unnamed: F3.2, U$3.1A
unnamed: U3.1 (A4), U$4.9B
unnamed: U3.2 (A6), U$4.8B
unnamed: U3.4 (A7), U$4.8A
unnamed: U3.5 (A5), U$4.9A
unnamed: U3.15 (A2), U$4.6B
unnamed: U3.14 (A1), U$4.6A
unnamed: U3.13 (A0), U$4.7B
unnamed: U3.12 (A3), U$4.7A
unnamed: F4.2, U$4.5B
unnamed: U4.1 (A4), U$4.4B
unnamed: U4.2 (A6), U$4.5A
unnamed: U4.4 (A7), U$4.4A
unnamed: U4.5 (A5), U$4.3B
unnamed: U4.15 (A2), U$4.2B
unnamed: U4.14 (A1), U$4.1B
unnamed: U4.13 (A0), U$4.2A
unnamed: U4.12 (A3), U$4.3A
unnamed: F5.2, U$4.1A
unnamed: U5.1 (A4), U$5.9B
unnamed: U5.2 (A6), U$5.8B
unnamed: U5.4 (A7), U$5.8A
unnamed: U5.5 (A5), U$5.9A
unnamed: U5.15 (A2), U$5.6B
unnamed: U5.14 (A1), U$5.6A
unnamed: U5.13 (A0), U$5.7B
unnamed: U5.12 (A3), U$5.7A
unnamed: F6.2, U$5.5B
S0: U1.11 (S0), U2.11 (S0), U3.11 (S0), U4.11 (S0), U5.11 (S0); also elsewhere on the board
S1: U1.10 (S1), U2.10 (S1), U3.10 (S1), U4.10 (S1), U5.10 (S1); also elsewhere on the board
S2: U1.9 (S2), U2.9 (S2), U3.9 (S2), U4.9 (S2), U5.9 (S2); also elsewhere on the board
VCC: R1.2, R2.2, R3.2, R4.2, R5.2, U1.16 (VCC), U2.16 (VCC), U3.16 (VCC), U4.16 (VCC), U5.16 (VCC); also elsewhere on the board

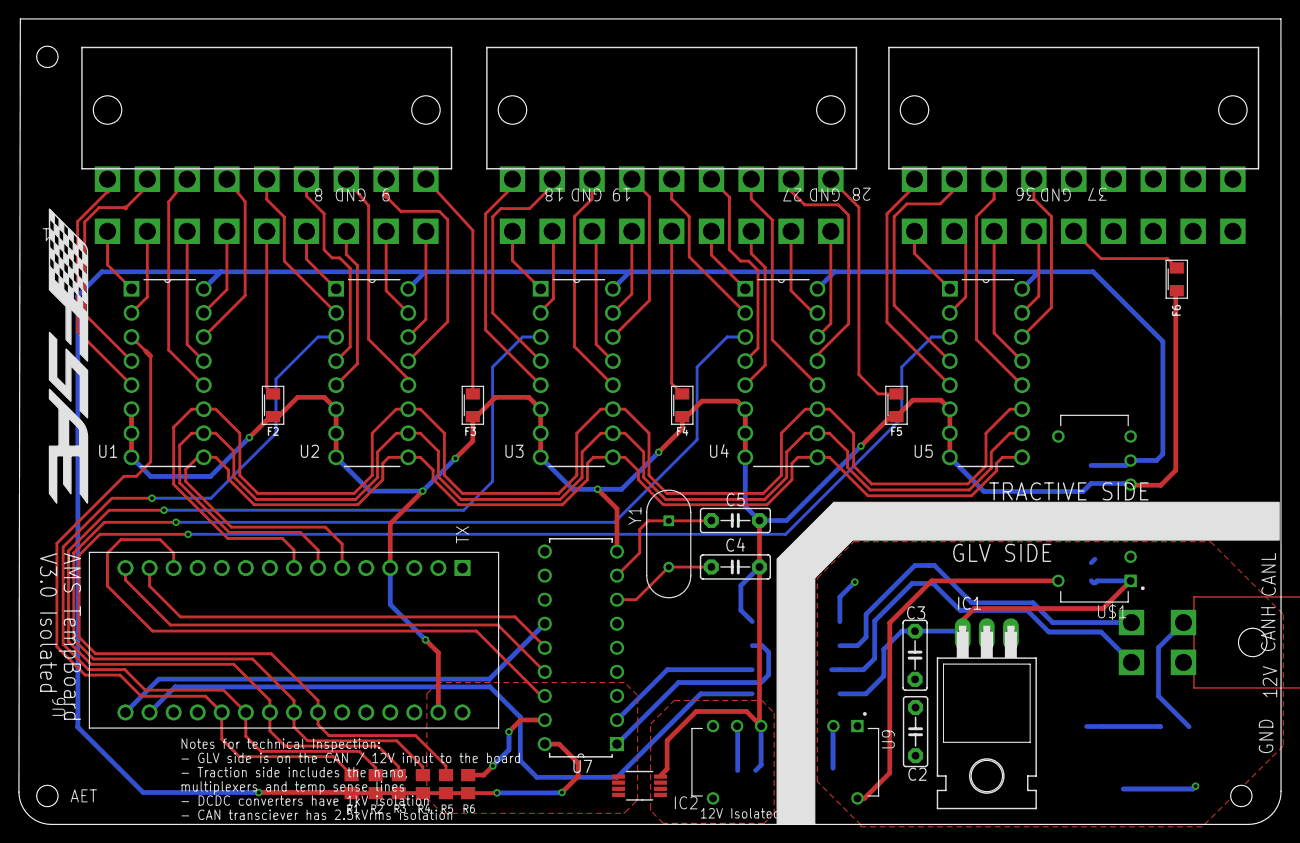
[picture p164: board TempSensorCircuit_v3.brd from above]

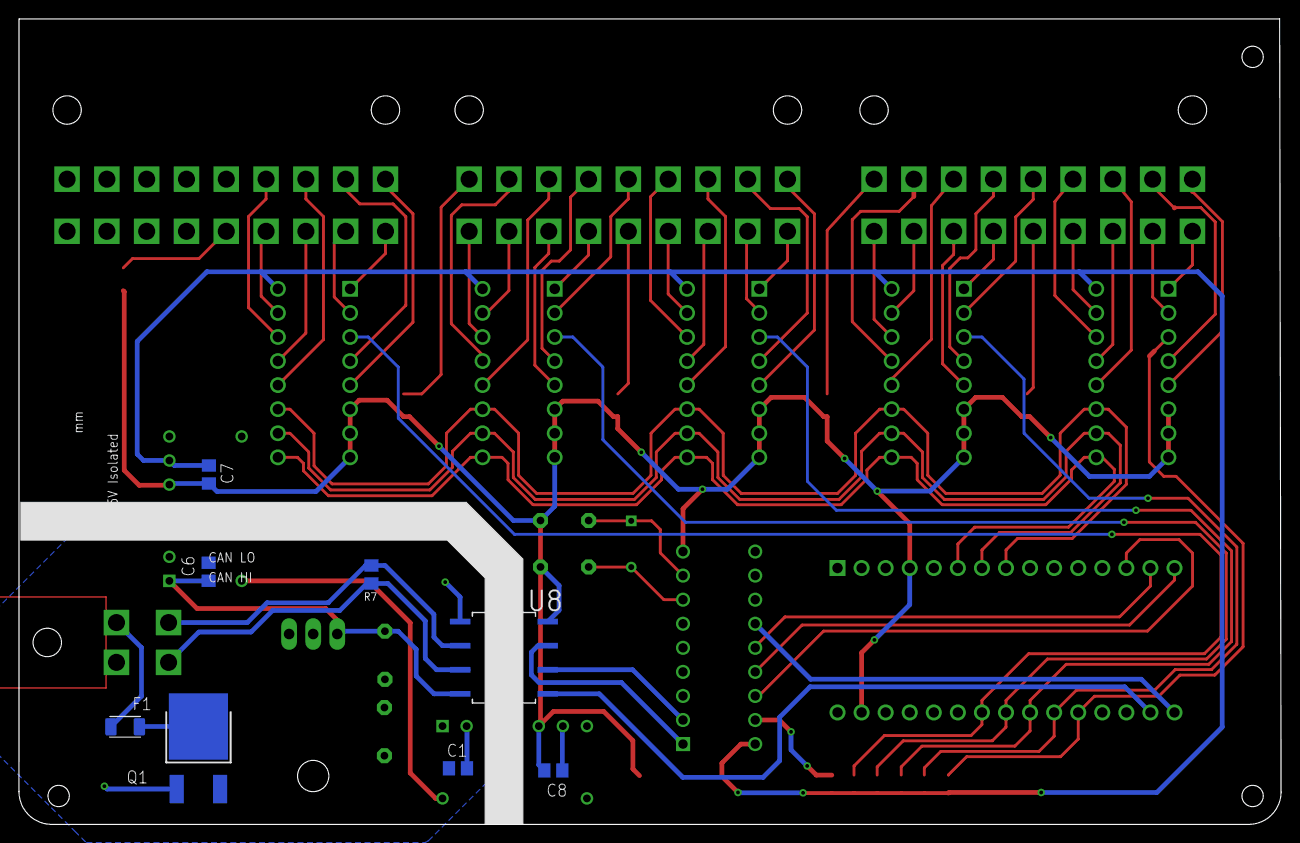
[picture p165: board TempSensorCircuit_v3.brd from below]

Board: 2 copper layers, 133.2 x 85.0 mm, 39 parts (8 on the bottom side), 74 nets.
