andrewrichardr/WFR2020/ACC-MB/Rev1/AIRDCR/AIRDCR.brd

## EAGLE design ACC-MB/Rev1/AIRDCR/AIRDCR.brd (2019-11-23, an earlier design)

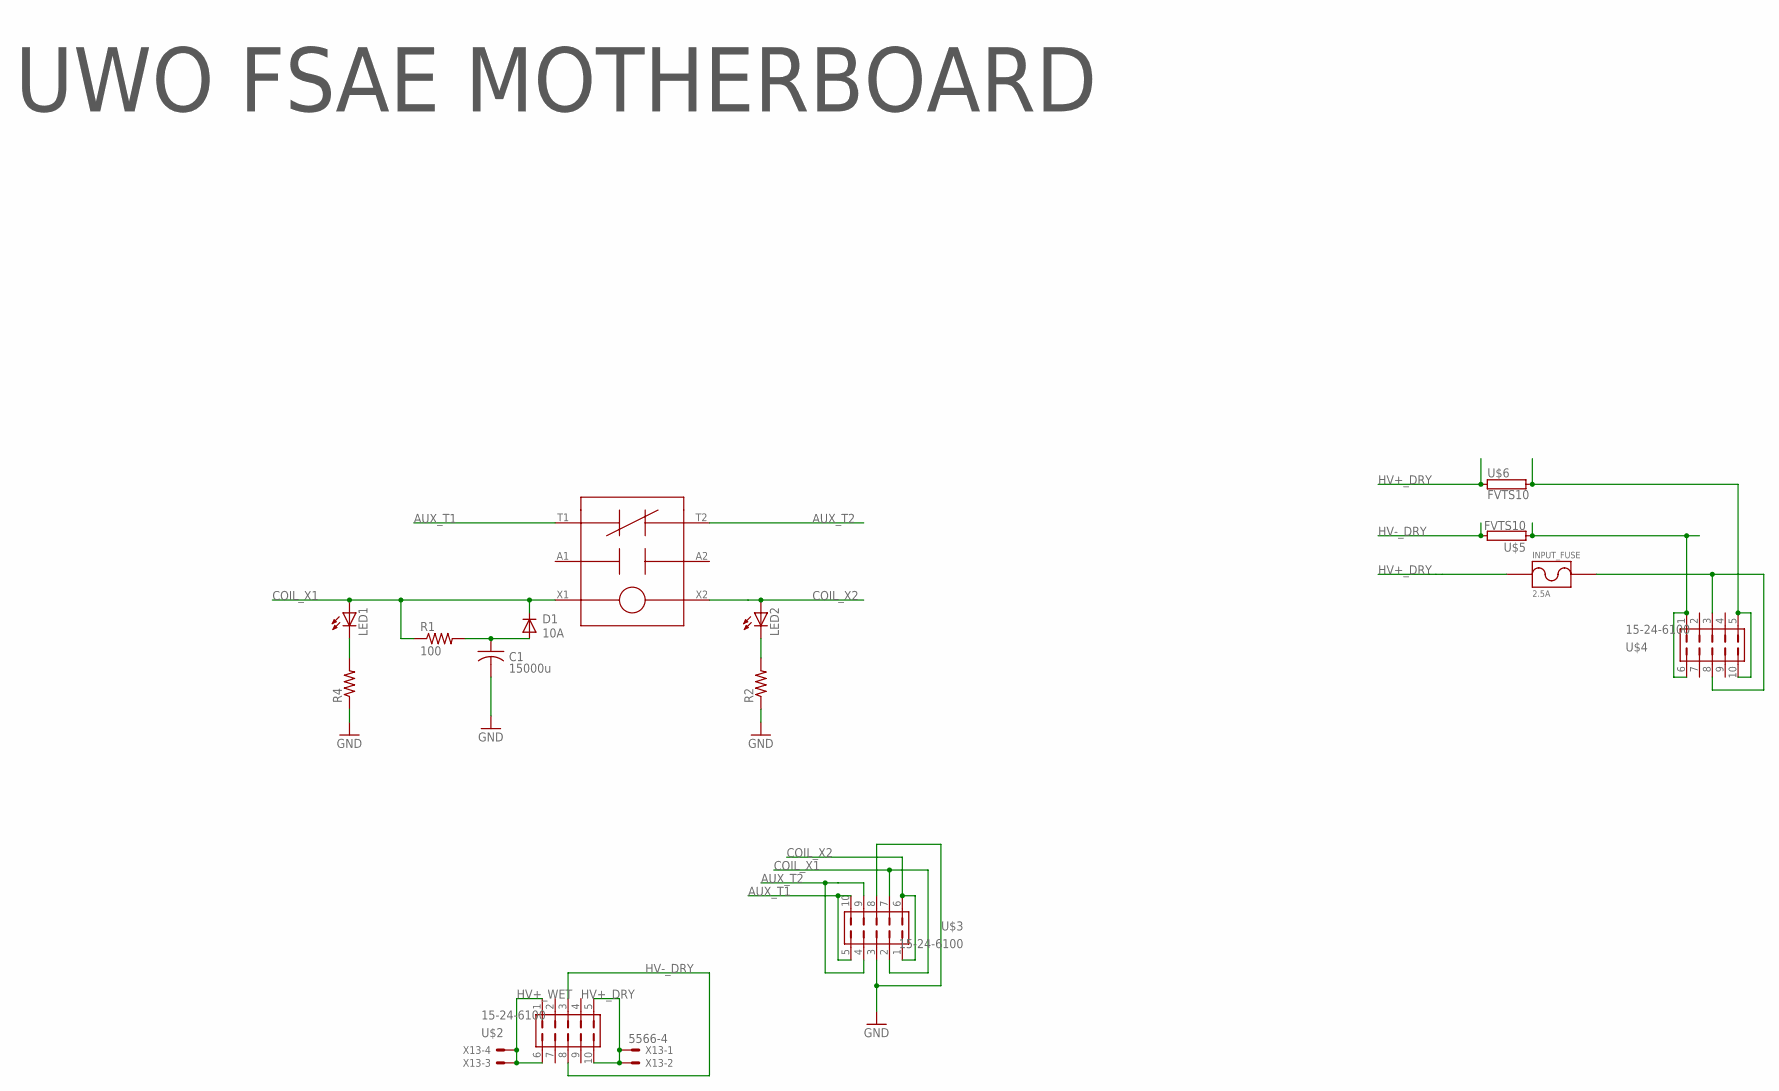
[picture p166: schematic AIRDCR.sch]

Parts:
C1: 15000u; CAPPRD750W65D1800H3700B
D1: 10A; DIOAD1570W120L850D500B
INPUT_FUSE: 2.5A; _CUSTOM_PARTS_LF_885
LED1, LED2: LED3MM
R1: 100; RESAD976W63L650D250B
R2, R4: R-US_R0805; R0805
U$1: GV224
U$2, U$3, U$4: 15-24-6100
U$5, U$6: FVTS10
X13: 5566-4

Connections:
AUX_T1: U$1.T1, U$3.5, U$3.10
AUX_T2: U$1.T2, U$3.4, U$3.9
COIL_X1: D1.1 (C), LED1.A, R1.1, U$1.X1, U$3.2, U$3.7
COIL_X2: LED2.A, U$1.X2, U$3.1, U$3.6
GND: C1.2, R2.1, R4.1, U$3.3, U$3.8
HV+_DRY: INPUT_FUSE.P$1, U$2.5, U$2.10, U$6.P$1 (1), X13.1, X13.2
HV+_WET: U$2.1, U$2.6, X13.3, X13.4
HV-_DRY: U$2.3, U$2.8, U$5.P$2 (2)
unnamed: LED2.K (C), R2.2
unnamed: INPUT_FUSE.P$2, U$4.3, U$4.8
unnamed: C1.1, D1.2 (A), R1.2
unnamed: LED1.K (C), R4.2
unnamed: U$4.5, U$4.10, U$6.P$2 (2)
unnamed: U$4.1, U$4.6, U$5.P$1 (1)

Notes on the sheet:
UWO FSAE MOTHERBOARD

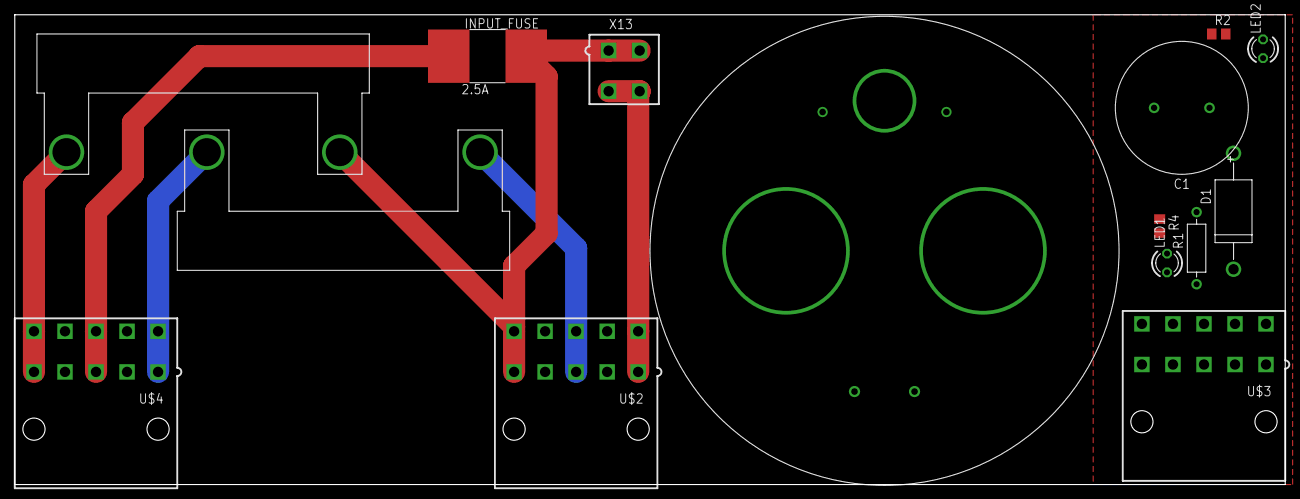
[picture p167: board ACC-MB/Rev1/AIRDCR/AIRDCR.brd from above]

Board: 2 copper layers, 172.0 x 63.6 mm, 15 parts (0 on the bottom side), 14 nets.
