andrewrichardr/WFR2020/ACC-MB/Rev2/AIRDCL/AIRDCL.brd

## EAGLE design ACC-MB/Rev2/AIRDCL/AIRDCL.brd (2019-11-23, an earlier design)

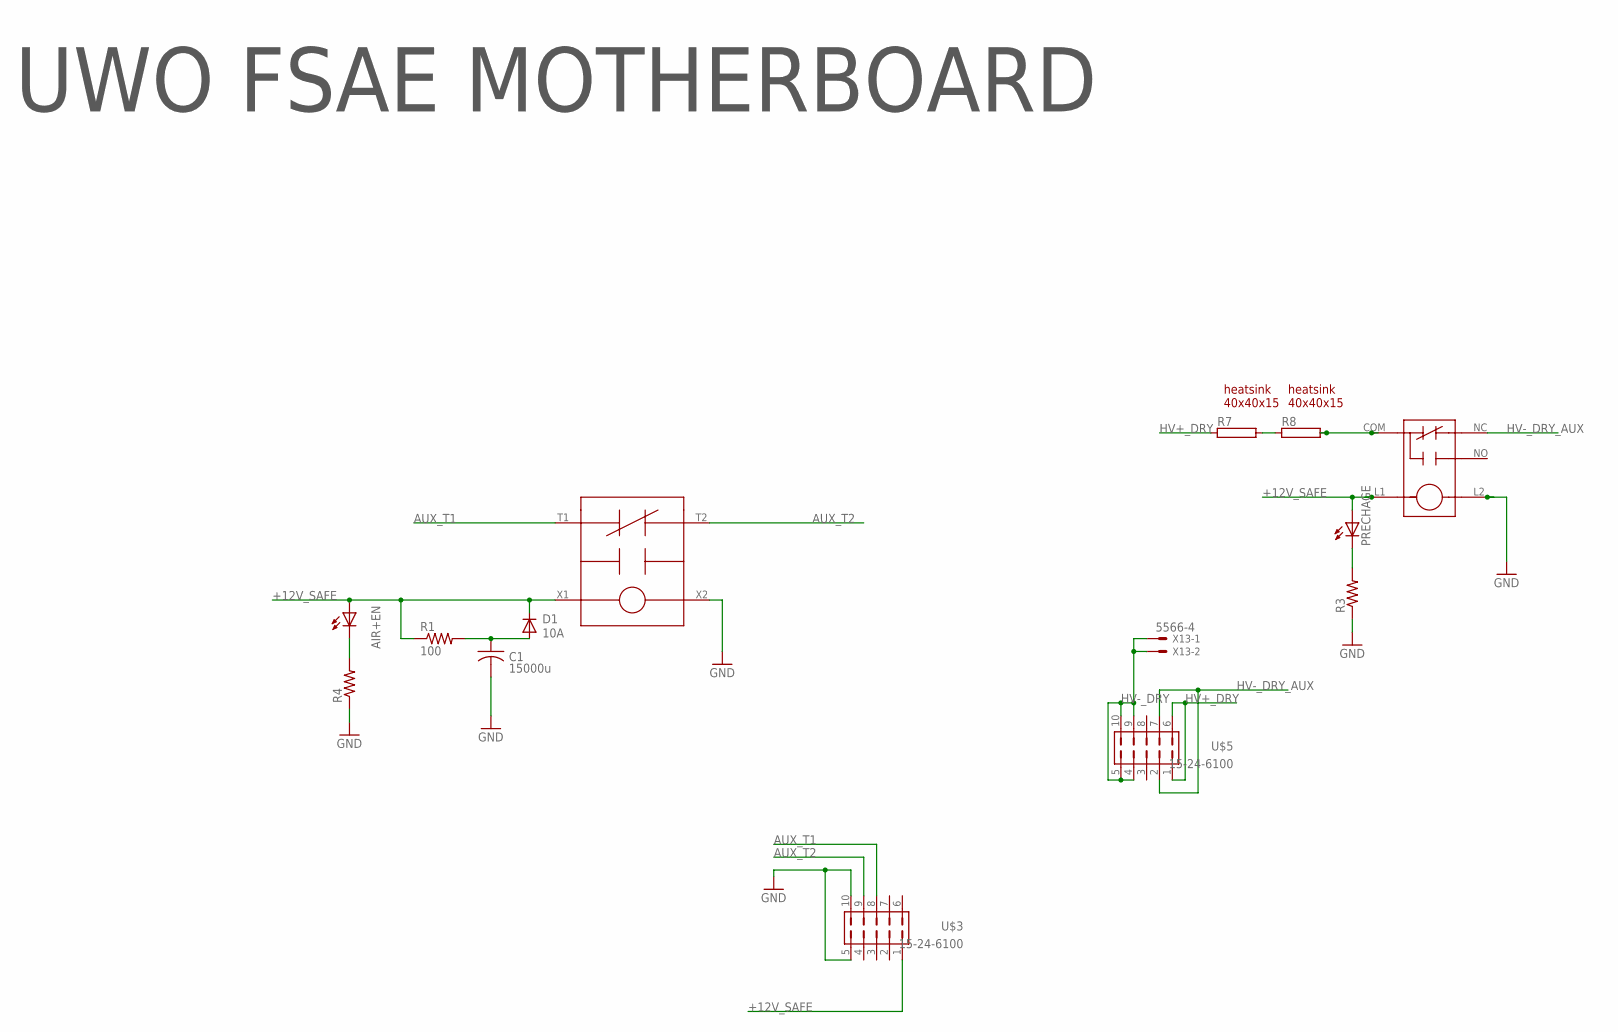
[picture p168: schematic AIRDCL.sch]

Parts:
AIR+EN: LED3MM
C1: 15000u; CAPPRD750W65D1800H3700B
D1: 10A; DIOAD1570W120L850D500B
PRECHAGE: LED3MM
R1: 100; RESAD976W63L650D250B
R3, R4: R-US_R0805; R0805
R7, R8: RMG100-H; TO-247-2H
U$1: GV224
U$2, U$8: HEATSINK40X40X15
U$3, U$5: 15-24-6100
U$4: G81C335
X13: 5566-4

Connections:
+12V_SAFE: AIR+EN.A, D1.1 (C), PRECHAGE.A, R1.1, U$1.X1, U$3.1, U$4.L1
AUX_T1: U$1.T1, U$3.8
AUX_T2: U$1.T2, U$3.9
GND: C1.2, R3.1, R4.1, U$1.X2, U$3.5, U$3.10, U$4.L2
HV+_DRY: R7.1, U$5.1, U$5.6
HV-_DRY: U$5.4, U$5.5, U$5.9, U$5.10, X13.1, X13.2
HV-_DRY_AUX: U$4.NC, U$5.2, U$5.7
unnamed: PRECHAGE.K (C), R3.2
unnamed: C1.1, D1.2 (A), R1.2
unnamed: AIR+EN.K (C), R4.2
unnamed: R7.2, R8.1
unnamed: R8.2, U$4.COM

Notes on the sheet:
UWO FSAE MOTHERBOARD

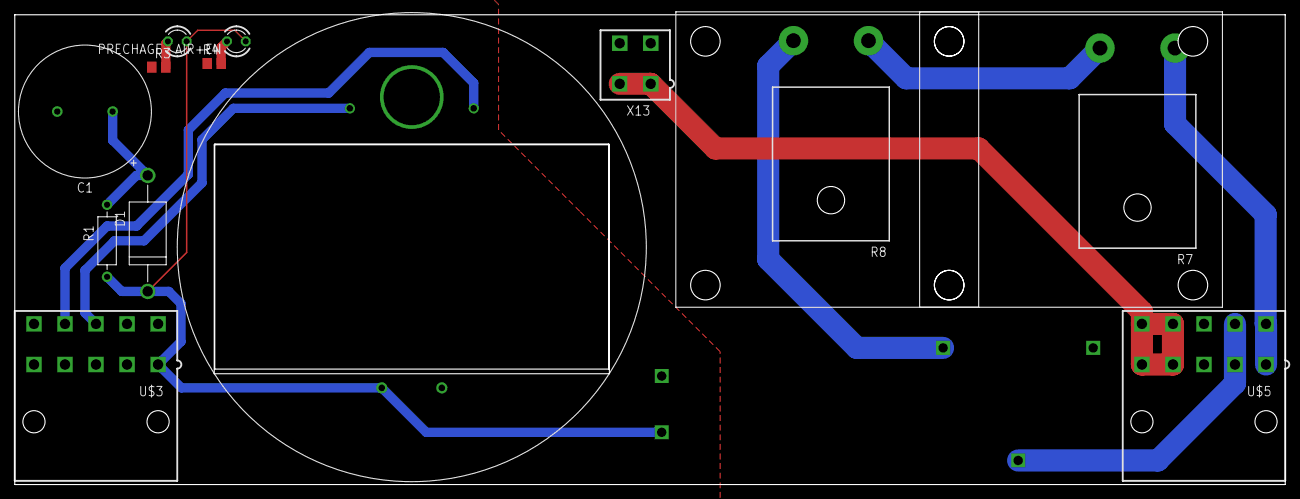
[picture p169: board AIRDCL.brd from above]

Board: 2 copper layers, 172.0 x 63.6 mm, 16 parts (1 on the bottom side), 12 nets.
