andrewrichardr/WFR2020/ACC-MB/Rev2/DCDCDC-r2/DCDCDC-R2.brd

## EAGLE design ACC-MB/Rev2/DCDCDC-r2/DCDCDC-R2.brd (2019-11-23, an earlier design)

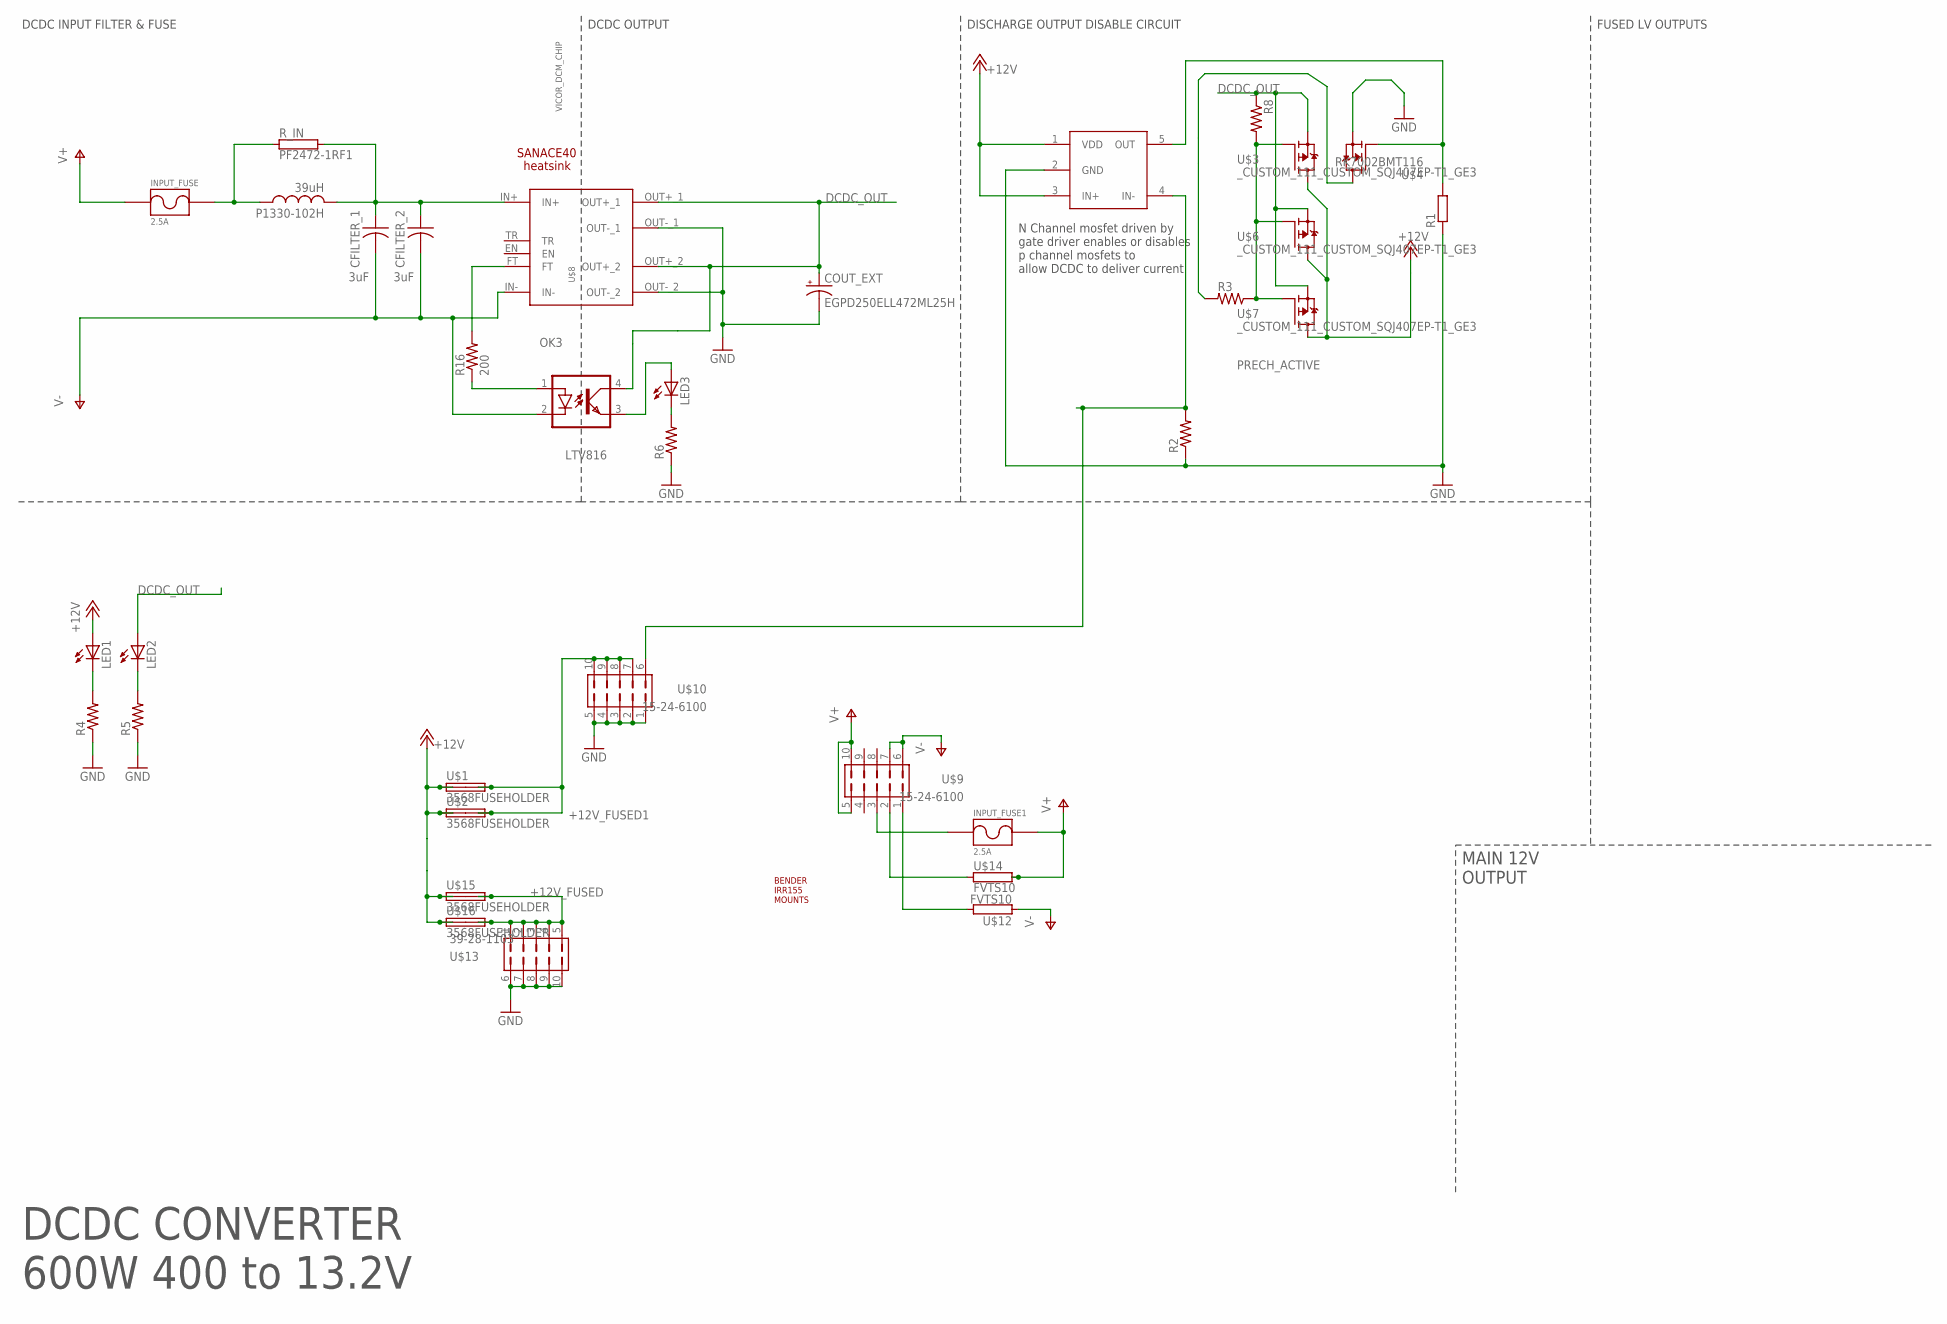
[picture p170: schematic DCDCDC-R2.sch]

Parts:
CFILTER_1, CFILTER_2: 3uF; CERALINK_FA3
COUT_EXT: EGPD250ELL472ML25H; E7,5-16
INPUT_FUSE, INPUT_FUSE1: 2.5A; _CUSTOM_PARTS_LF_885
LED1, LED2, LED3: LED3MM
OK3: LTV816; DIL04
P1330-102H: 39uH; L_1510_NONSTANDARD
R1: R-EU_R0805; R0805
R2, R3, R4, R5, R6, R8: R-US_R0805; R0805
R16: 200; R2010
R_IN: PF2472-1RF1; TO-247-2V
U$1, U$2, U$15, U$16: 3568FUSEHOLDER; 3568
U$3, U$6, U$7: _CUSTOM_111_CUSTOM_SQJ407EP-T1_GE3; _CUSTOM_111_CUSTOM_TRANS_SIRA90DP-T1-GE3
U$4: RK7002BMT116; SOT23
U$5: UCC27511AQDBVRQ1; SOT23-5L
U$8: VICOR_DCM_CHIP; VICOR_CHIP_HEATSINK
U$9, U$10: 15-24-6100
U$11: BENDER_IRR155
U$12, U$14: FVTS10
U$13: 39-28-1103
U$17: VICOR_HEATSINK_19MMLONG; VICOR_HEATSINK_19MM_LONG
U$18: SANACE40

Connections:
+12V: LED1.A, U$1.L1 (1A), U$1.L2 (1B), U$2.L1 (1A), U$2.L2 (1B), U$3.5 (D), U$5.1 (VDD), U$5.3 (IN+), U$6.5 (D), U$7.5 (D), U$15.L1 (1A), U$15.L2 (1B), U$16.L1 (1A), U$16.L2 (1B)
+12V_FUSED: U$13.1, U$13.2, U$13.3, U$13.4, U$13.5, U$15.R1 (2A), U$15.R2 (2B), U$16.R1 (2A), U$16.R2 (2B)
+12V_FUSED1: U$1.R1 (2A), U$1.R2 (2B), U$2.R1 (2A), U$2.R2 (2B), U$10.7, U$10.8, U$10.9, U$10.10
DCDC_OUT: COUT_EXT.+, LED2.A, OK3.4 (COL), R8.1, U$3.1 (S), U$3.2 (S), U$3.3 (S), U$6.1 (S), U$6.2 (S), U$6.3 (S), U$7.1 (S), U$7.2 (S), U$7.3 (S), U$8.OUT+_1, U$8.OUT+_2
GND: COUT_EXT.-, R1.1, R2.1, R4.1, R5.1, R6.1, U$4.2 (S), U$5.2 (GND), U$8.OUT-_1, U$8.OUT-_2, U$10.1, U$10.2, U$10.3, U$10.4, U$10.5, U$13.6, U$13.7, U$13.8, U$13.9, U$13.10
unnamed: R3.1, R8.2, U$3.4 (G), U$6.4 (G), U$7.4 (G)
unnamed: R1.2, U$4.1 (G), U$5.5 (OUT)
unnamed: CFILTER_1.P$1 (1), CFILTER_2.P$1 (1), P1330-102H.P$2 (2), R_IN.2, U$8.IN+
unnamed: R3.2, U$4.3 (D)
unnamed: LED1.K (C), R4.2
unnamed: LED2.K (C), R5.2
unnamed: R16.2, U$8.FT
unnamed: OK3.1 (A), R16.1
unnamed: LED3.K (C), R6.2
unnamed: LED3.A, OK3.3 (EMIT)
unnamed: INPUT_FUSE1.P$1, U$9.3
unnamed: U$9.2, U$14.P$1 (1)
unnamed: U$9.1, U$12.P$2 (2)
PRECH_ACTIVE: R2.2, U$5.4 (IN-), U$10.6
V+: INPUT_FUSE.P$1, INPUT_FUSE1.P$2, U$9.5, U$9.10, U$14.P$2 (2)
V+_FUSED: INPUT_FUSE.P$2, P1330-102H.P$1 (1), R_IN.1
V-: CFILTER_1.P$2 (2), CFILTER_2.P$2 (2), OK3.2 (C), U$8.IN-, U$9.6, U$9.7, U$12.P$1 (1)

Notes on the sheet:
DCDC CONVERTER 600W 400 to 13.2V
DISCHARGE OUTPUT DISABLE CIRCUIT
FUSED LV OUTPUTS
MAIN 12V OUTPUT
DCDC OUTPUT
DCDC INPUT FILTER & FUSE
N Channel mosfet driven by gate driver enables or disables p channel mosfets to allow DCDC to deliver current

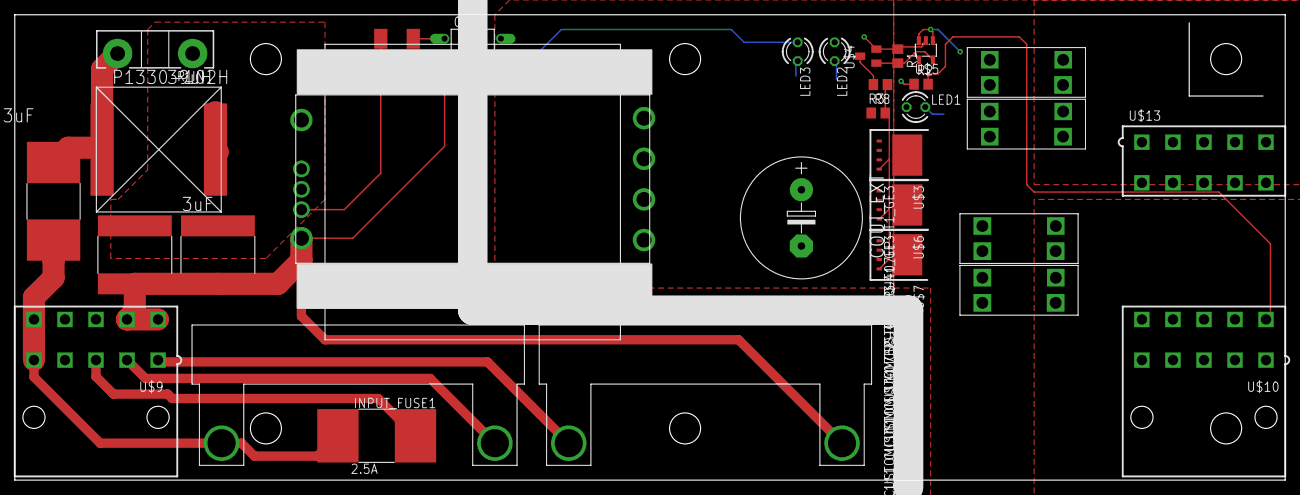
[picture p171: board ACC-MB/Rev2/DCDCDC-r2/DCDCDC-R2.brd from above]

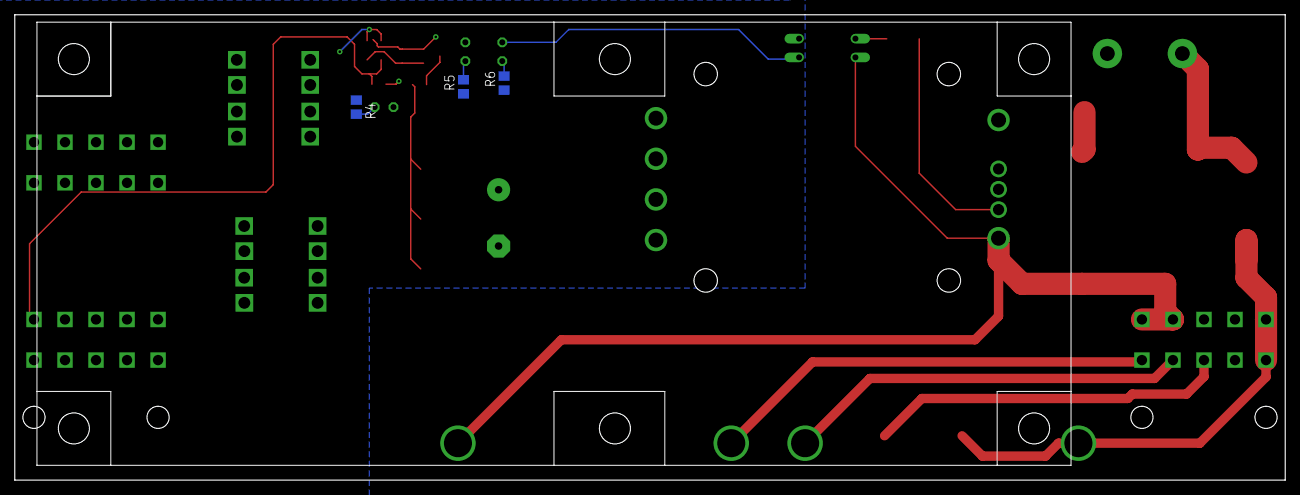
[picture p172: board ACC-MB/Rev2/DCDCDC-r2/DCDCDC-R2.brd from below]

Board: 2 copper layers, 172.0 x 63.0 mm, 37 parts (4 on the bottom side), 22 nets.
