andrewrichardr/WFR2020/ACC-MB/Rev1/MainBoard/Main.brd

## EAGLE design ACC-MB/Rev1/MainBoard/Main.brd (2019-10-13, an earlier design)

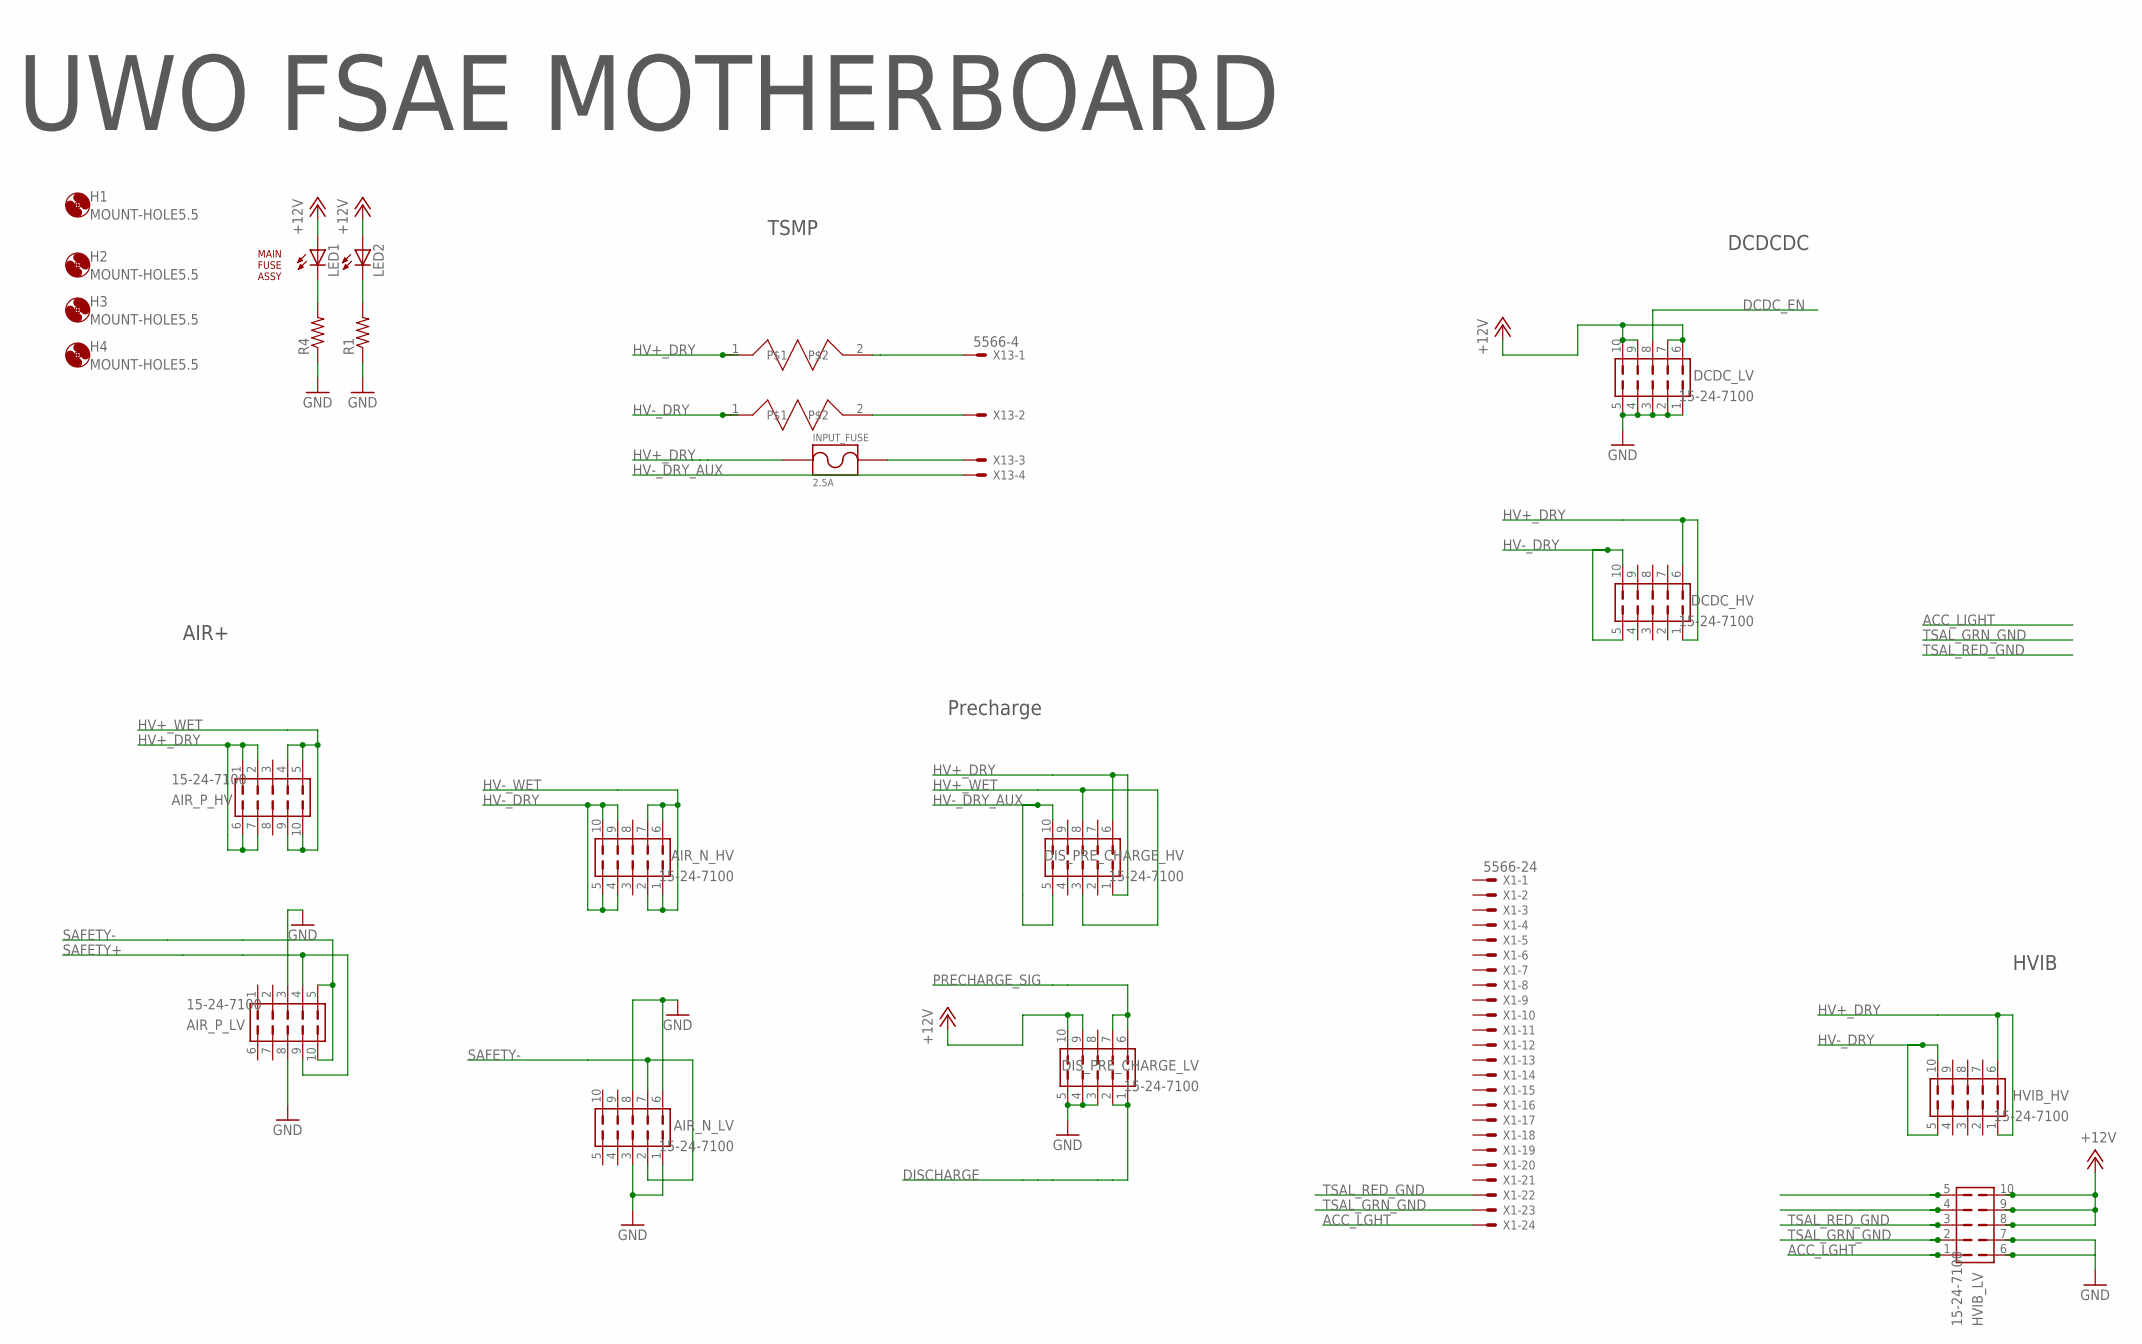
[picture p173: schematic Main.sch]

Parts:
AIR_N_HV: 15-24-7100; 5566-10-BMI
AIR_N_LV: 15-24-7100; 5566-10-BMI
AIR_P_HV: 15-24-7100; 5566-10-BMI
AIR_P_LV: 15-24-7100; 5566-10-BMI
DCDC_HV: 15-24-7100; 5566-10-BMI
DCDC_LV: 15-24-7100; 5566-10-BMI
DIS_PRE_CHARGE_HV: 15-24-7100; 5566-10-BMI
DIS_PRE_CHARGE_LV: 15-24-7100; 5566-10-BMI
H1, H2, H3, H4: MOUNT-HOLE5.5; 5,5
HVIB_HV: 15-24-7100; 5566-10-BMI
HVIB_LV: 15-24-7100; 5566-10-BMI
INPUT_FUSE: 2.5A; _CUSTOM_PARTS_LF_885
LED1, LED2: LED3MM
R1, R4: R-US_R0805; R0805
U$1: MAINFUSEASSY
U$3, U$4: TO247RESISTORHEATINK; _CUSTOM_TO-247-2V
X1: 5566-24
X13: 5566-4

Connections:
+12V: DCDC_LV.6, DCDC_LV.7, DCDC_LV.9, DCDC_LV.10, DIS_PRE_CHARGE_LV.9, DIS_PRE_CHARGE_LV.10, HVIB_LV.8, HVIB_LV.9, HVIB_LV.10, LED1.A, LED2.A
ACC_LGHT: HVIB_LV.1, X1.24
DCDC_EN: DCDC_LV.8
DISCHARGE: DIS_PRE_CHARGE_LV.1, DIS_PRE_CHARGE_LV.2
GND: AIR_N_LV.1, AIR_N_LV.3, AIR_N_LV.6, AIR_N_LV.8, AIR_P_LV.3, AIR_P_LV.8, DCDC_LV.1, DCDC_LV.2, DCDC_LV.3, DCDC_LV.4, DCDC_LV.5, DIS_PRE_CHARGE_LV.3, DIS_PRE_CHARGE_LV.4, DIS_PRE_CHARGE_LV.5, HVIB_LV.7, R1.1, R4.1
HV+_DRY: AIR_P_HV.1, AIR_P_HV.2, AIR_P_HV.6, AIR_P_HV.7, DCDC_HV.1, DCDC_HV.6, DIS_PRE_CHARGE_HV.1, DIS_PRE_CHARGE_HV.6, HVIB_HV.1, HVIB_HV.6, INPUT_FUSE.P$1, U$3.1
HV+_WET: AIR_P_HV.4, AIR_P_HV.5, AIR_P_HV.9, AIR_P_HV.10, DIS_PRE_CHARGE_HV.3, DIS_PRE_CHARGE_HV.8
HV-_DRY: AIR_N_HV.4, AIR_N_HV.5, AIR_N_HV.9, AIR_N_HV.10, DCDC_HV.5, DCDC_HV.10, HVIB_HV.5, HVIB_HV.10, U$4.1
HV-_DRY_AUX: DIS_PRE_CHARGE_HV.5, DIS_PRE_CHARGE_HV.10, X13.4
HV-_WET: AIR_N_HV.1, AIR_N_HV.2, AIR_N_HV.6, AIR_N_HV.7
unnamed: LED2.K (C), R1.2
unnamed: INPUT_FUSE.P$2, X13.3
unnamed: LED1.K (C), R4.2
unnamed: U$3.2, X13.1
unnamed: U$4.2, X13.2
PRECHARGE_SIG: DIS_PRE_CHARGE_LV.6, DIS_PRE_CHARGE_LV.7
SAFETY+: AIR_P_LV.4, AIR_P_LV.9
SAFETY-: AIR_N_LV.2, AIR_N_LV.7, AIR_P_LV.5, AIR_P_LV.10
TSAL_GRN_GND: HVIB_LV.2, X1.23
TSAL_RED_GND: HVIB_LV.3, X1.22

Notes on the sheet:
UWO FSAE MOTHERBOARD
DCDCDC
TSMP
AIR+
Precharge
HVIB

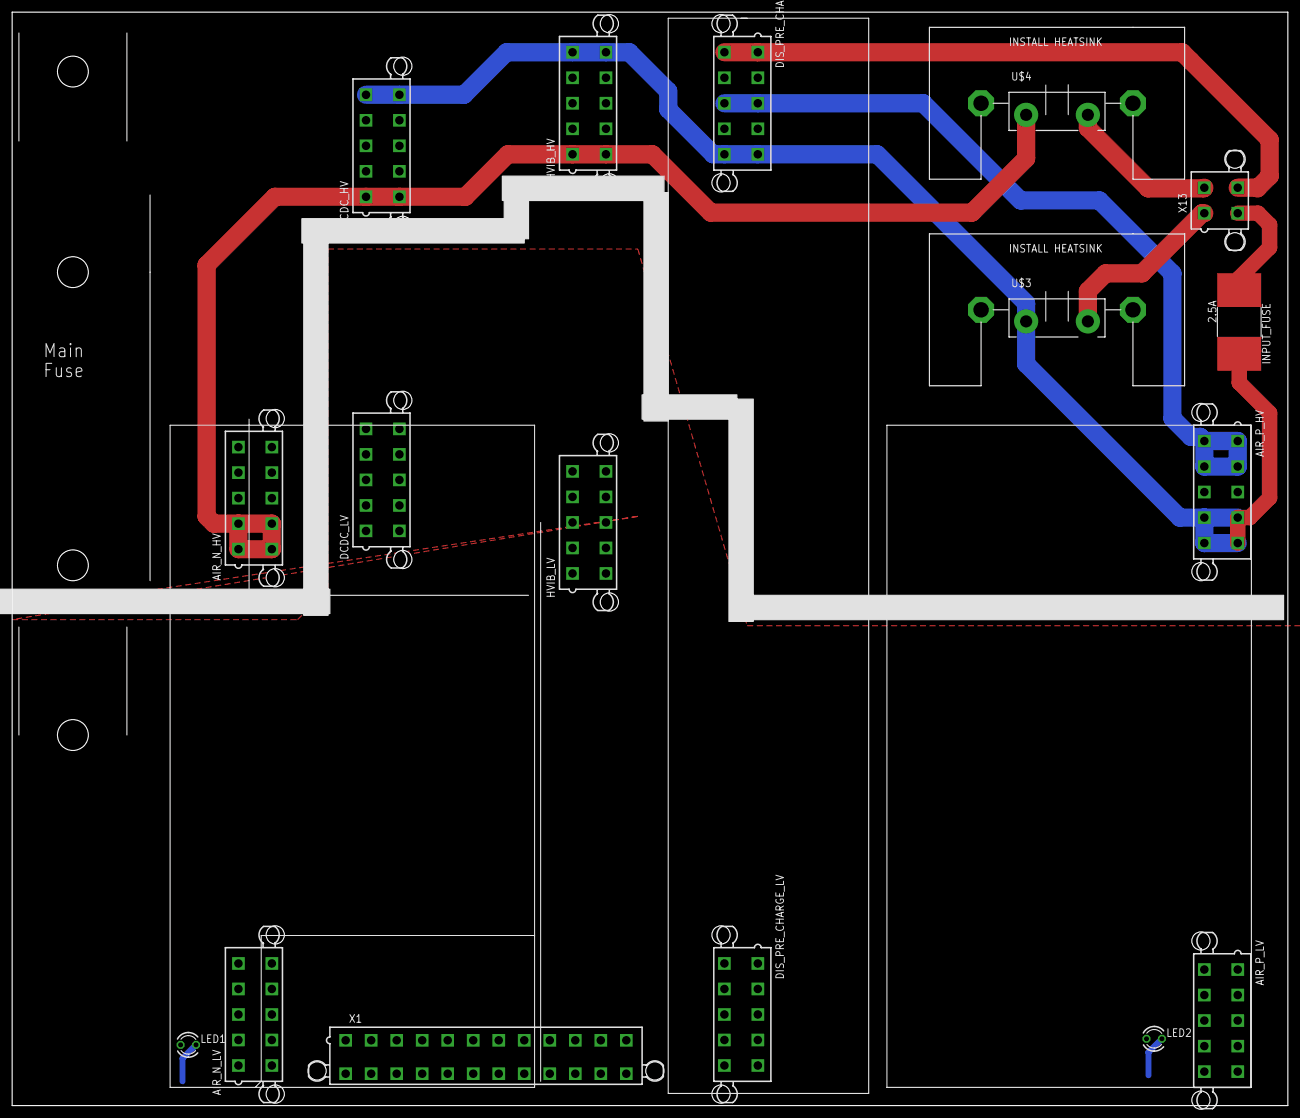
[picture p174: board ACC-MB/Rev1/MainBoard/Main.brd from above]

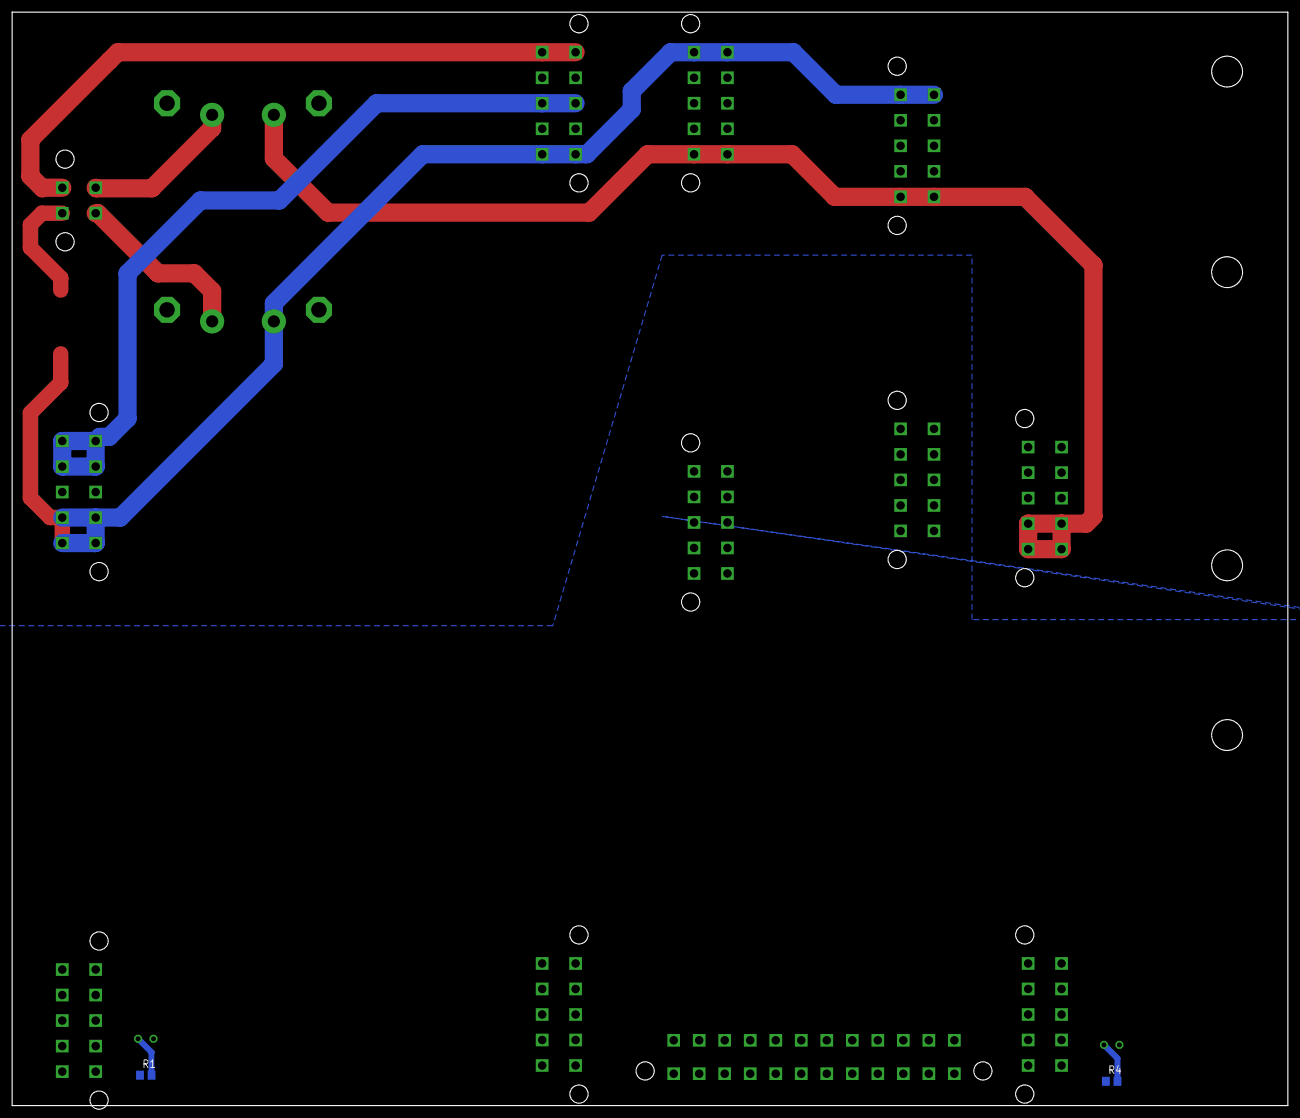
[picture p175: board ACC-MB/Rev1/MainBoard/Main.brd from below]

Board: 2 copper layers, 210.0 x 180.0 mm, 24 parts (2 on the bottom side), 19 nets.
