andrewrichardr/WFR2020/ACC-MB/Rev1/DCDCDC/DCDCDC.brd

## EAGLE design ACC-MB/Rev1/DCDCDC/DCDCDC.brd (2019-10-11, an earlier design)

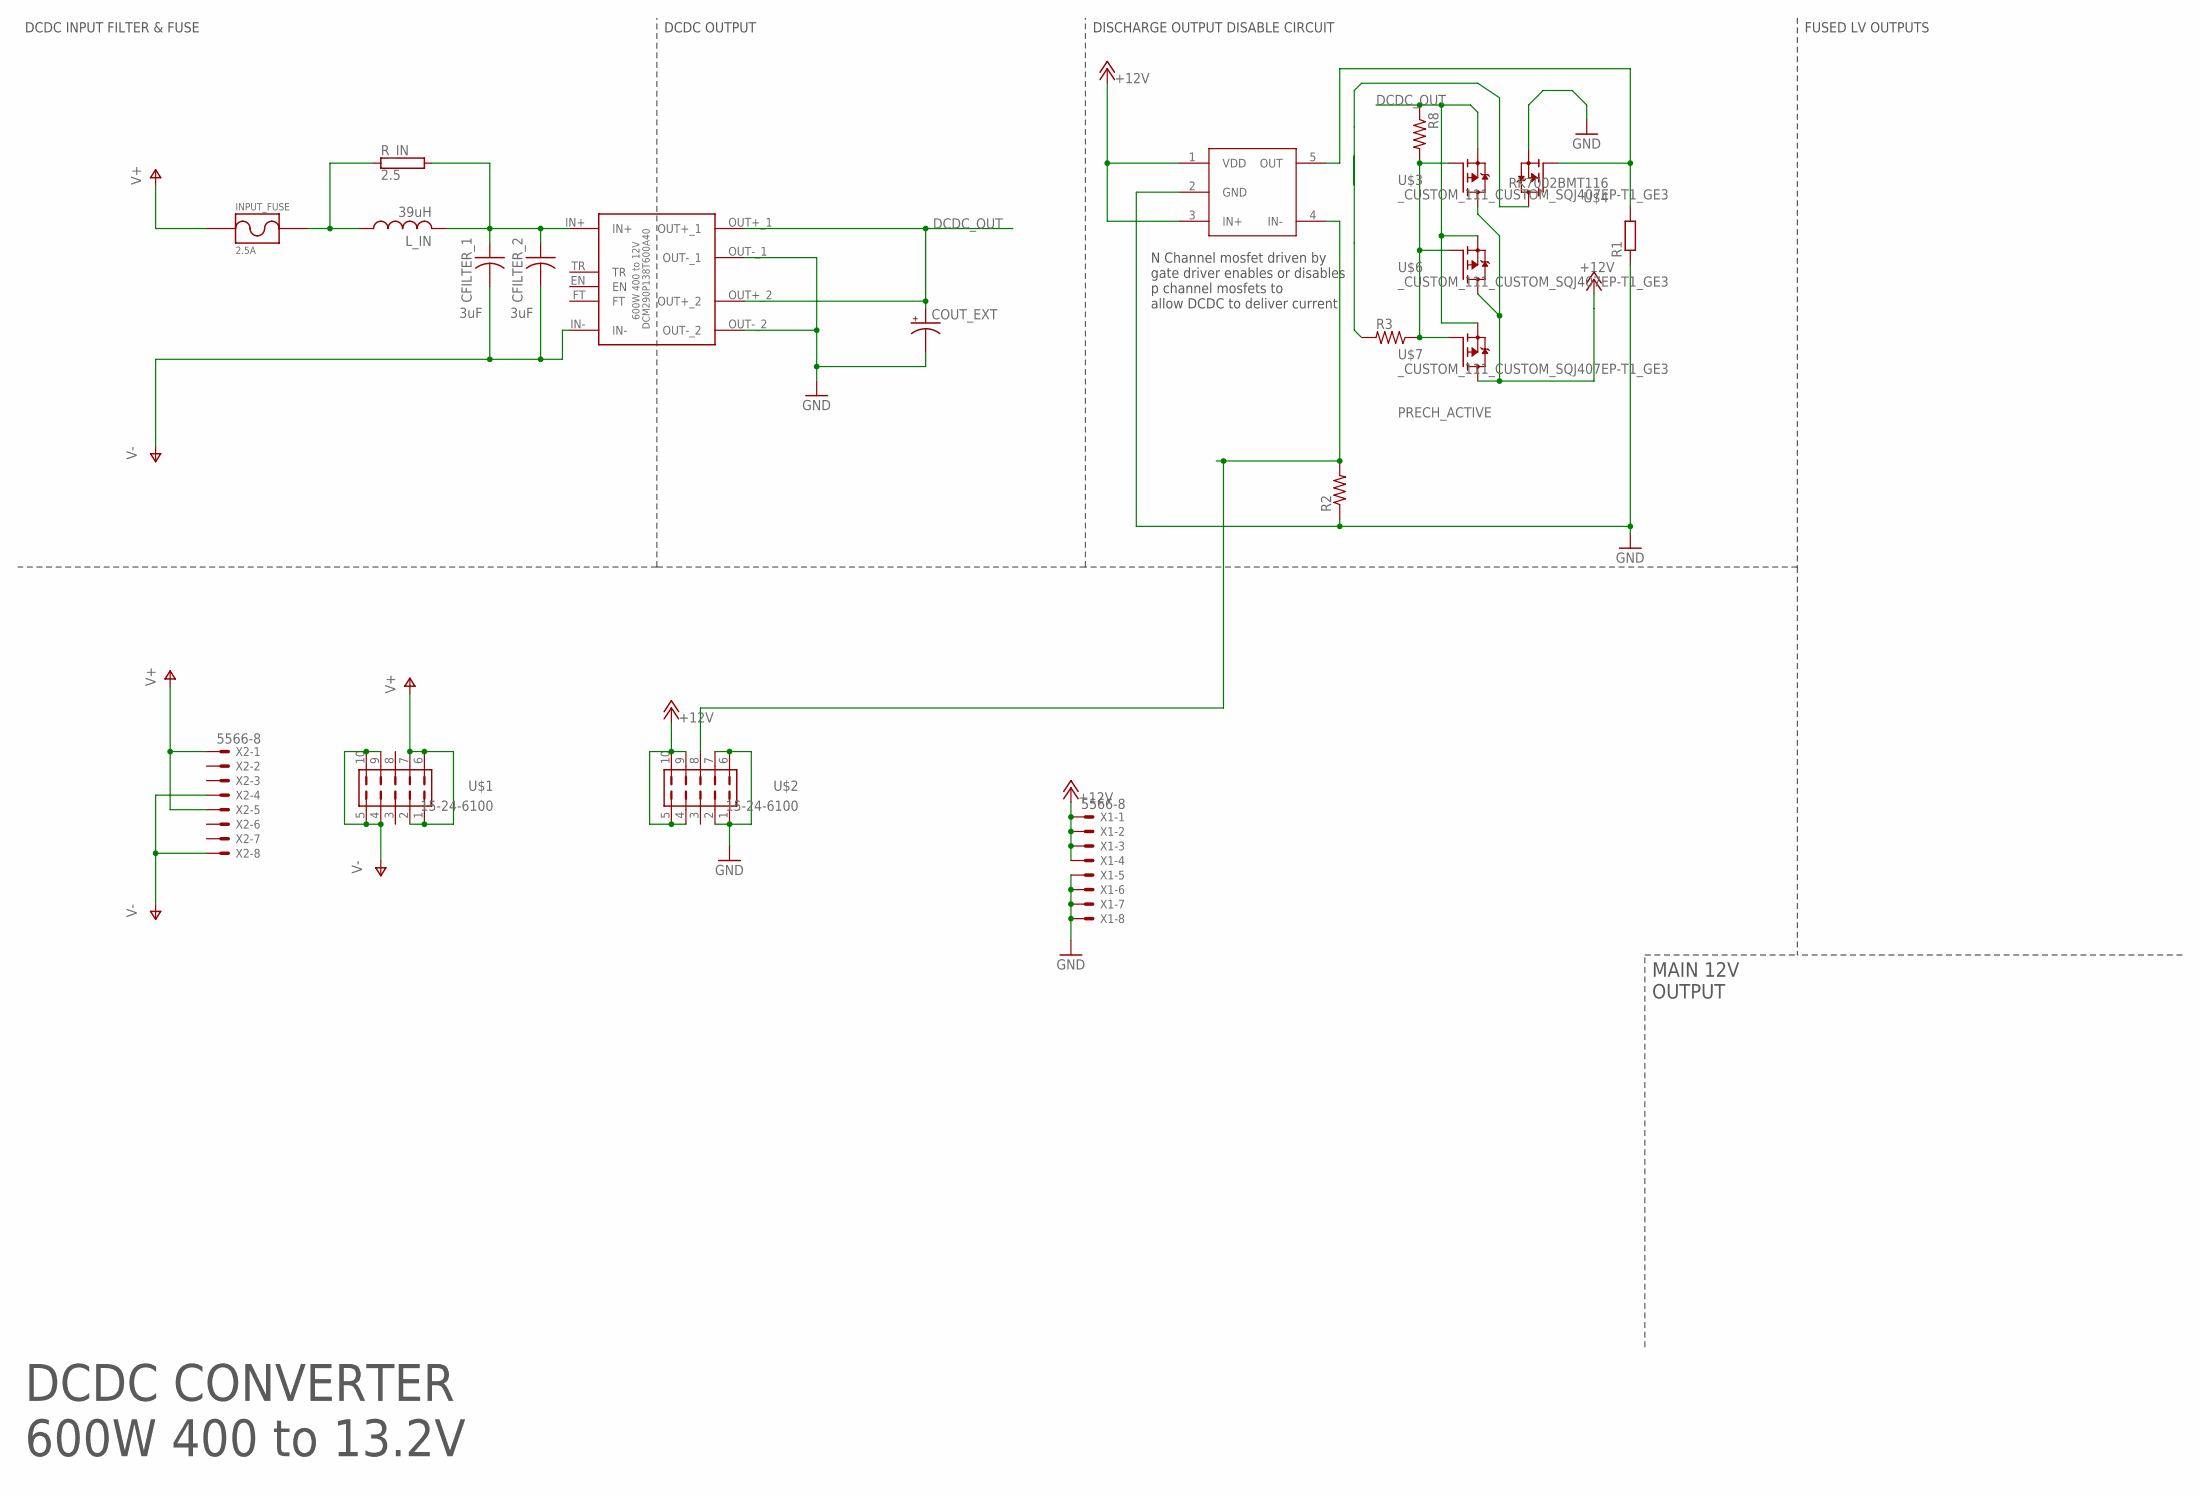
[picture p176: schematic DCDCDC.sch]

Parts:
CFILTER_1, CFILTER_2: 3uF; CERALINK_FA3
COUT_EXT: CPOL-USE7.5-16; E7,5-16
DCM290P138T600A40: 600W 400 to 12V; VICOR_CHIP_HEATSINK
INPUT_FUSE: 2.5A; _CUSTOM_PARTS_LF_885
L_IN: 39uH; L_1510_NONSTANDARD
R1: R-EU_R0805; R0805
R2, R3, R8: R-US_R0805; R0805
R_IN: 2.5; TO-247-2V
U$1, U$2: 15-24-6100
U$3, U$6, U$7: _CUSTOM_111_CUSTOM_SQJ407EP-T1_GE3; _CUSTOM_111_CUSTOM_TRANS_SIRA90DP-T1-GE3
U$4: RK7002BMT116; SOT23
U$5: UCC27511AQDBVRQ1; SOT23-5L
X1, X2: 5566-8

Connections:
+12V: U$2.4, U$2.5, U$2.9, U$2.10, U$3.5 (D), U$5.1 (VDD), U$5.3 (IN+), U$6.5 (D), U$7.5 (D), X1.1, X1.2, X1.3, X1.4
DCDC_OUT: COUT_EXT.+, DCM290P138T600A40.OUT+_1, DCM290P138T600A40.OUT+_2, R8.1, U$3.1 (S), U$3.2 (S), U$3.3 (S), U$6.1 (S), U$6.2 (S), U$6.3 (S), U$7.1 (S), U$7.2 (S), U$7.3 (S)
GND: COUT_EXT.-, DCM290P138T600A40.OUT-_1, DCM290P138T600A40.OUT-_2, R1.1, R2.1, U$2.1, U$2.2, U$2.6, U$2.7, U$4.2 (S), U$5.2 (GND), X1.5, X1.6, X1.7, X1.8
unnamed: R3.1, R8.2, U$3.4 (G), U$6.4 (G), U$7.4 (G)
unnamed: R1.2, U$4.1 (G), U$5.5 (OUT)
unnamed: CFILTER_1.P$1 (1), CFILTER_2.P$1 (1), DCM290P138T600A40.IN+, L_IN.P$2 (2), R_IN.2
unnamed: R3.2, U$4.3 (D)
PRECH_ACTIVE: R2.2, U$2.8, U$5.4 (IN-)
V+: INPUT_FUSE.P$1, U$1.1, U$1.2, U$1.6, U$1.7, X2.1, X2.5
V+_FUSED: INPUT_FUSE.P$2, L_IN.P$1 (1), R_IN.1
V-: CFILTER_1.P$2 (2), CFILTER_2.P$2 (2), DCM290P138T600A40.IN-, U$1.4, U$1.5, U$1.9, U$1.10, X2.4, X2.8

Notes on the sheet:
DCDC CONVERTER 600W 400 to 13.2V
DISCHARGE OUTPUT DISABLE CIRCUIT
FUSED LV OUTPUTS
MAIN 12V OUTPUT
DCDC OUTPUT
DCDC INPUT FILTER & FUSE
N Channel mosfet driven by gate driver enables or disables p channel mosfets to allow DCDC to deliver current

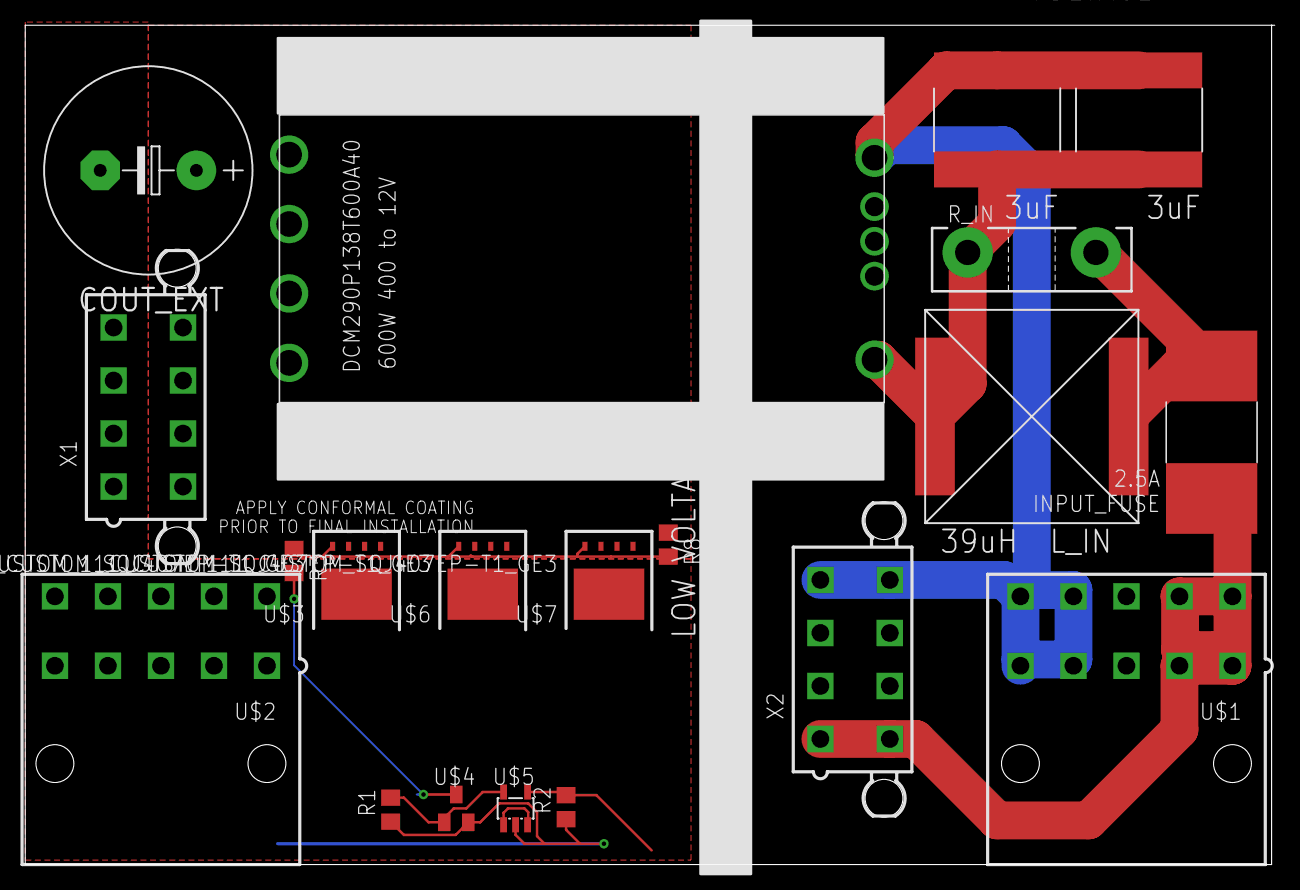
[picture p177: board DCDCDC.brd from above]

Board: 2 copper layers, 98.8 x 66.5 mm, 20 parts (0 on the bottom side), 11 nets.
