andrewrichardr/WFR2020/ACC-MB/Rev0/MainBoard/Main.brd

## EAGLE design ACC-MB/Rev0/MainBoard/Main.brd (2019-10-11, an earlier design)

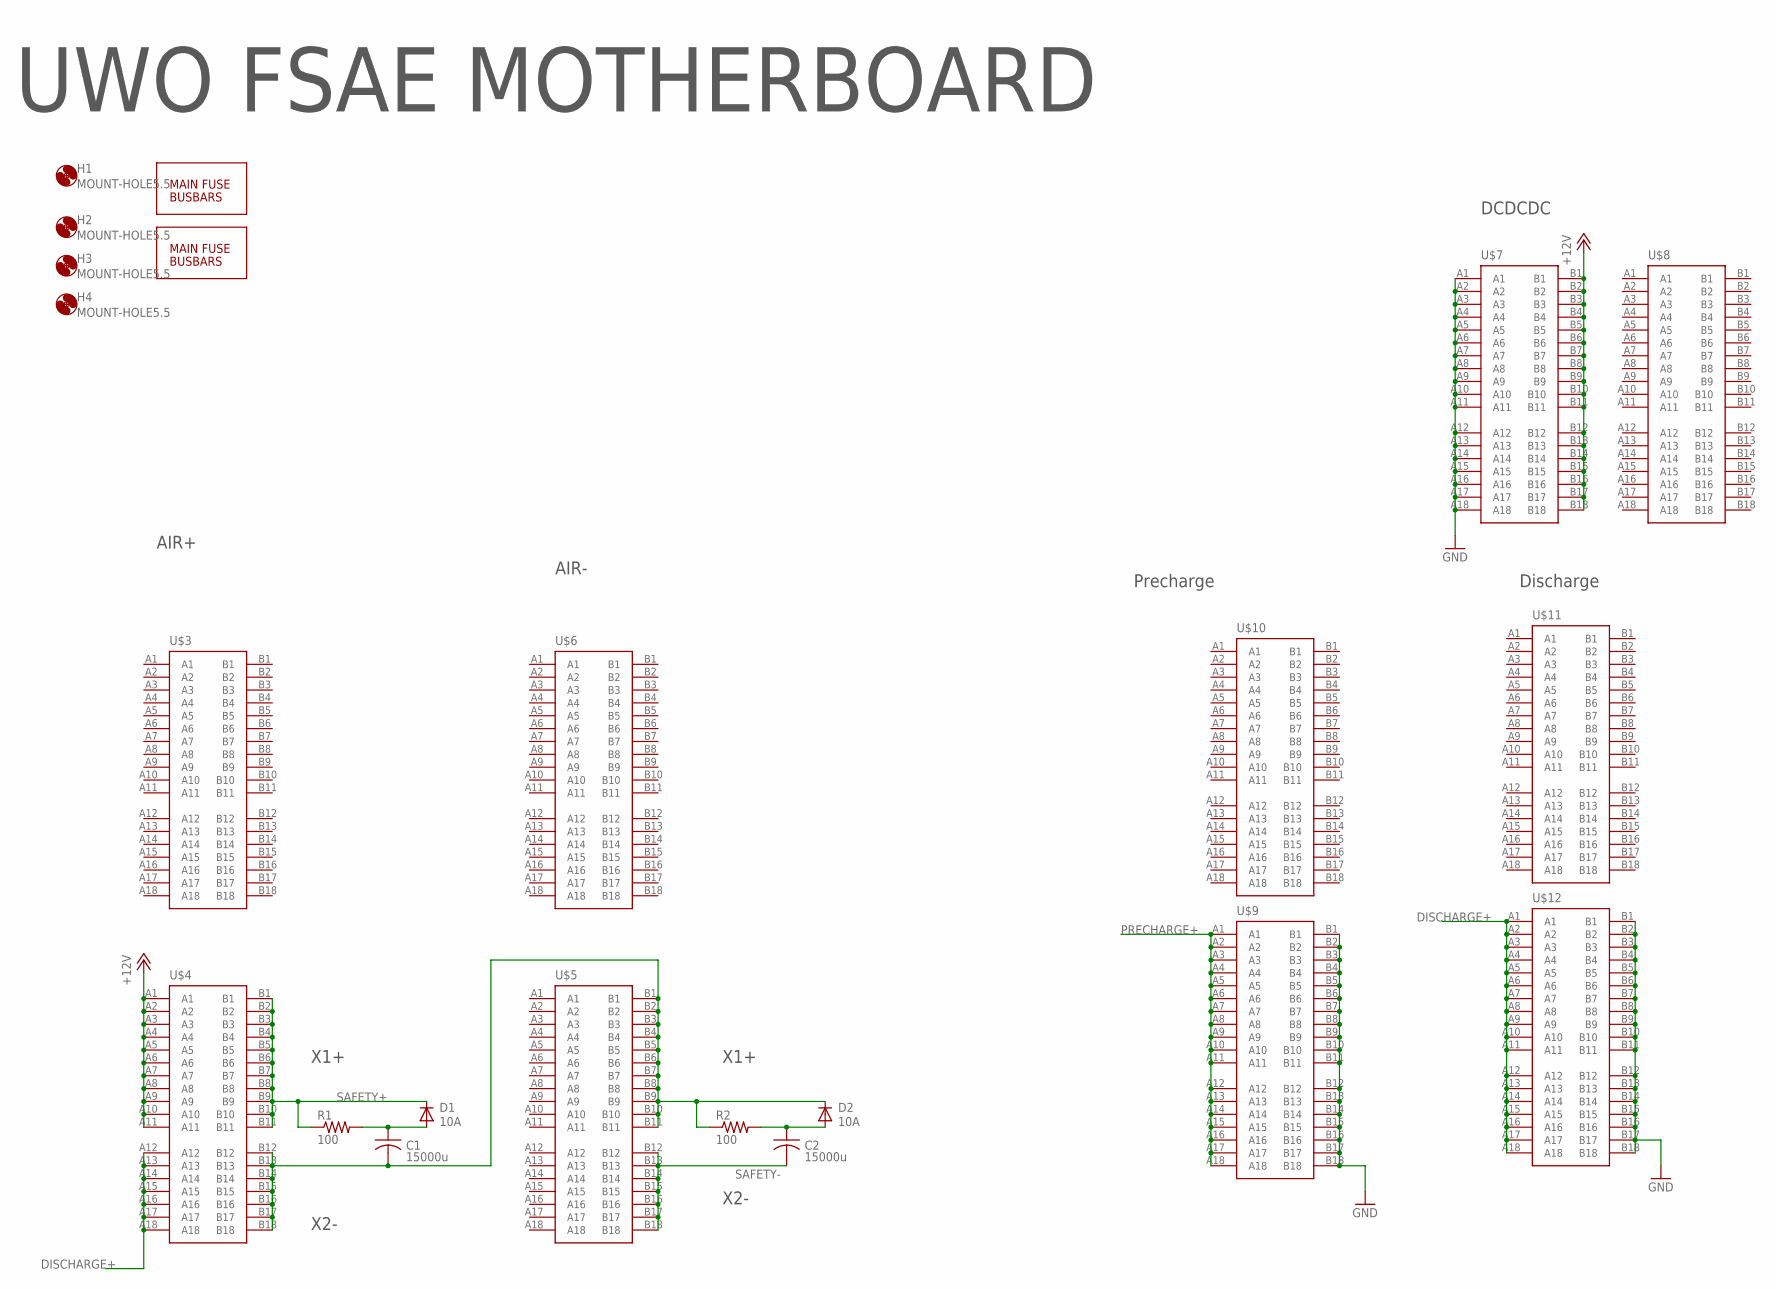
[picture p178: schematic Main.sch, sheet 1]

Parts:
C1, C2: 15000u; CAPPRD750W65D1800H3700B
D1, D2: 10A; DIOAD1570W120L850D500B
H1, H2, H3, H4: MOUNT-HOLE5.5; 5,5
R1, R2: 100; RESAD976W63L650D250B
U$1, U$2: FUSE_HOLDER
U$3, U$4, U$5, U$6, U$7, U$8, U$9, U$10, U$11, U$12: PCIE-36-CONN; PCI-E-36-CONN

Connections:
+12V: U$4.A1, U$4.A2, U$4.A3, U$4.A4, U$4.A5, U$4.A6, U$4.A7, U$4.A8, U$4.A9, U$4.A10, U$4.A11, U$7.B1, U$7.B2, U$7.B3, U$7.B4, U$7.B5, U$7.B6, U$7.B7, U$7.B8, U$7.B9, U$7.B10, U$7.B11, U$7.B12, U$7.B13, U$7.B14, U$7.B15, U$7.B16, U$7.B17, U$7.B18; also elsewhere on the board
DISCHARGE+: U$4.A12, U$4.A13, U$4.A14, U$4.A15, U$4.A16, U$4.A17, U$4.A18, U$12.A1, U$12.A2, U$12.A3, U$12.A4, U$12.A5, U$12.A6, U$12.A7, U$12.A8, U$12.A9, U$12.A10, U$12.A11, U$12.A12, U$12.A13, U$12.A14, U$12.A15, U$12.A16, U$12.A17, U$12.A18
GND: U$7.A1, U$7.A2, U$7.A3, U$7.A4, U$7.A5, U$7.A6, U$7.A7, U$7.A8, U$7.A9, U$7.A10, U$7.A11, U$7.A12, U$7.A13, U$7.A14, U$7.A15, U$7.A16, U$7.A17, U$7.A18, U$9.B1, U$9.B2, U$9.B3, U$9.B4, U$9.B5, U$9.B6, U$9.B7, U$9.B8, U$9.B9, U$9.B10, U$9.B11, U$9.B12, U$9.B13, U$9.B14, U$9.B15, U$9.B16, U$9.B17, U$9.B18, U$12.B1, U$12.B2, U$12.B3, U$12.B4, U$12.B5, U$12.B6, U$12.B7, U$12.B8, U$12.B9, U$12.B10, U$12.B11, U$12.B12, U$12.B13, U$12.B14, U$12.B15, U$12.B16, U$12.B17, U$12.B18; also elsewhere on the board
unnamed: C1.1, D1.2 (A), R1.2
unnamed: C1.2, D2.1 (C), R2.1, U$4.B12, U$4.B13, U$4.B14, U$4.B15, U$4.B16, U$4.B17, U$4.B18, U$5.B1, U$5.B2, U$5.B3, U$5.B4, U$5.B5, U$5.B6, U$5.B7, U$5.B8, U$5.B9, U$5.B10, U$5.B11
unnamed: C2.1, D2.2 (A), R2.2
PRECHARGE+: U$9.A1, U$9.A2, U$9.A3, U$9.A4, U$9.A5, U$9.A6, U$9.A7, U$9.A8, U$9.A9, U$9.A10, U$9.A11, U$9.A12, U$9.A13, U$9.A14, U$9.A15, U$9.A16, U$9.A17, U$9.A18; also elsewhere on the board
SAFETY+: D1.1 (C), R1.1, U$4.B1, U$4.B2, U$4.B3, U$4.B4, U$4.B5, U$4.B6, U$4.B7, U$4.B8, U$4.B9, U$4.B10, U$4.B11; also elsewhere on the board
SAFETY-: C2.2, U$5.B12, U$5.B13, U$5.B14, U$5.B15, U$5.B16, U$5.B17, U$5.B18; also elsewhere on the board

Notes on the sheet:
UWO FSAE MOTHERBOARD
DCDCDC
AIR-
AIR+
Precharge
Discharge
X1+
X2-

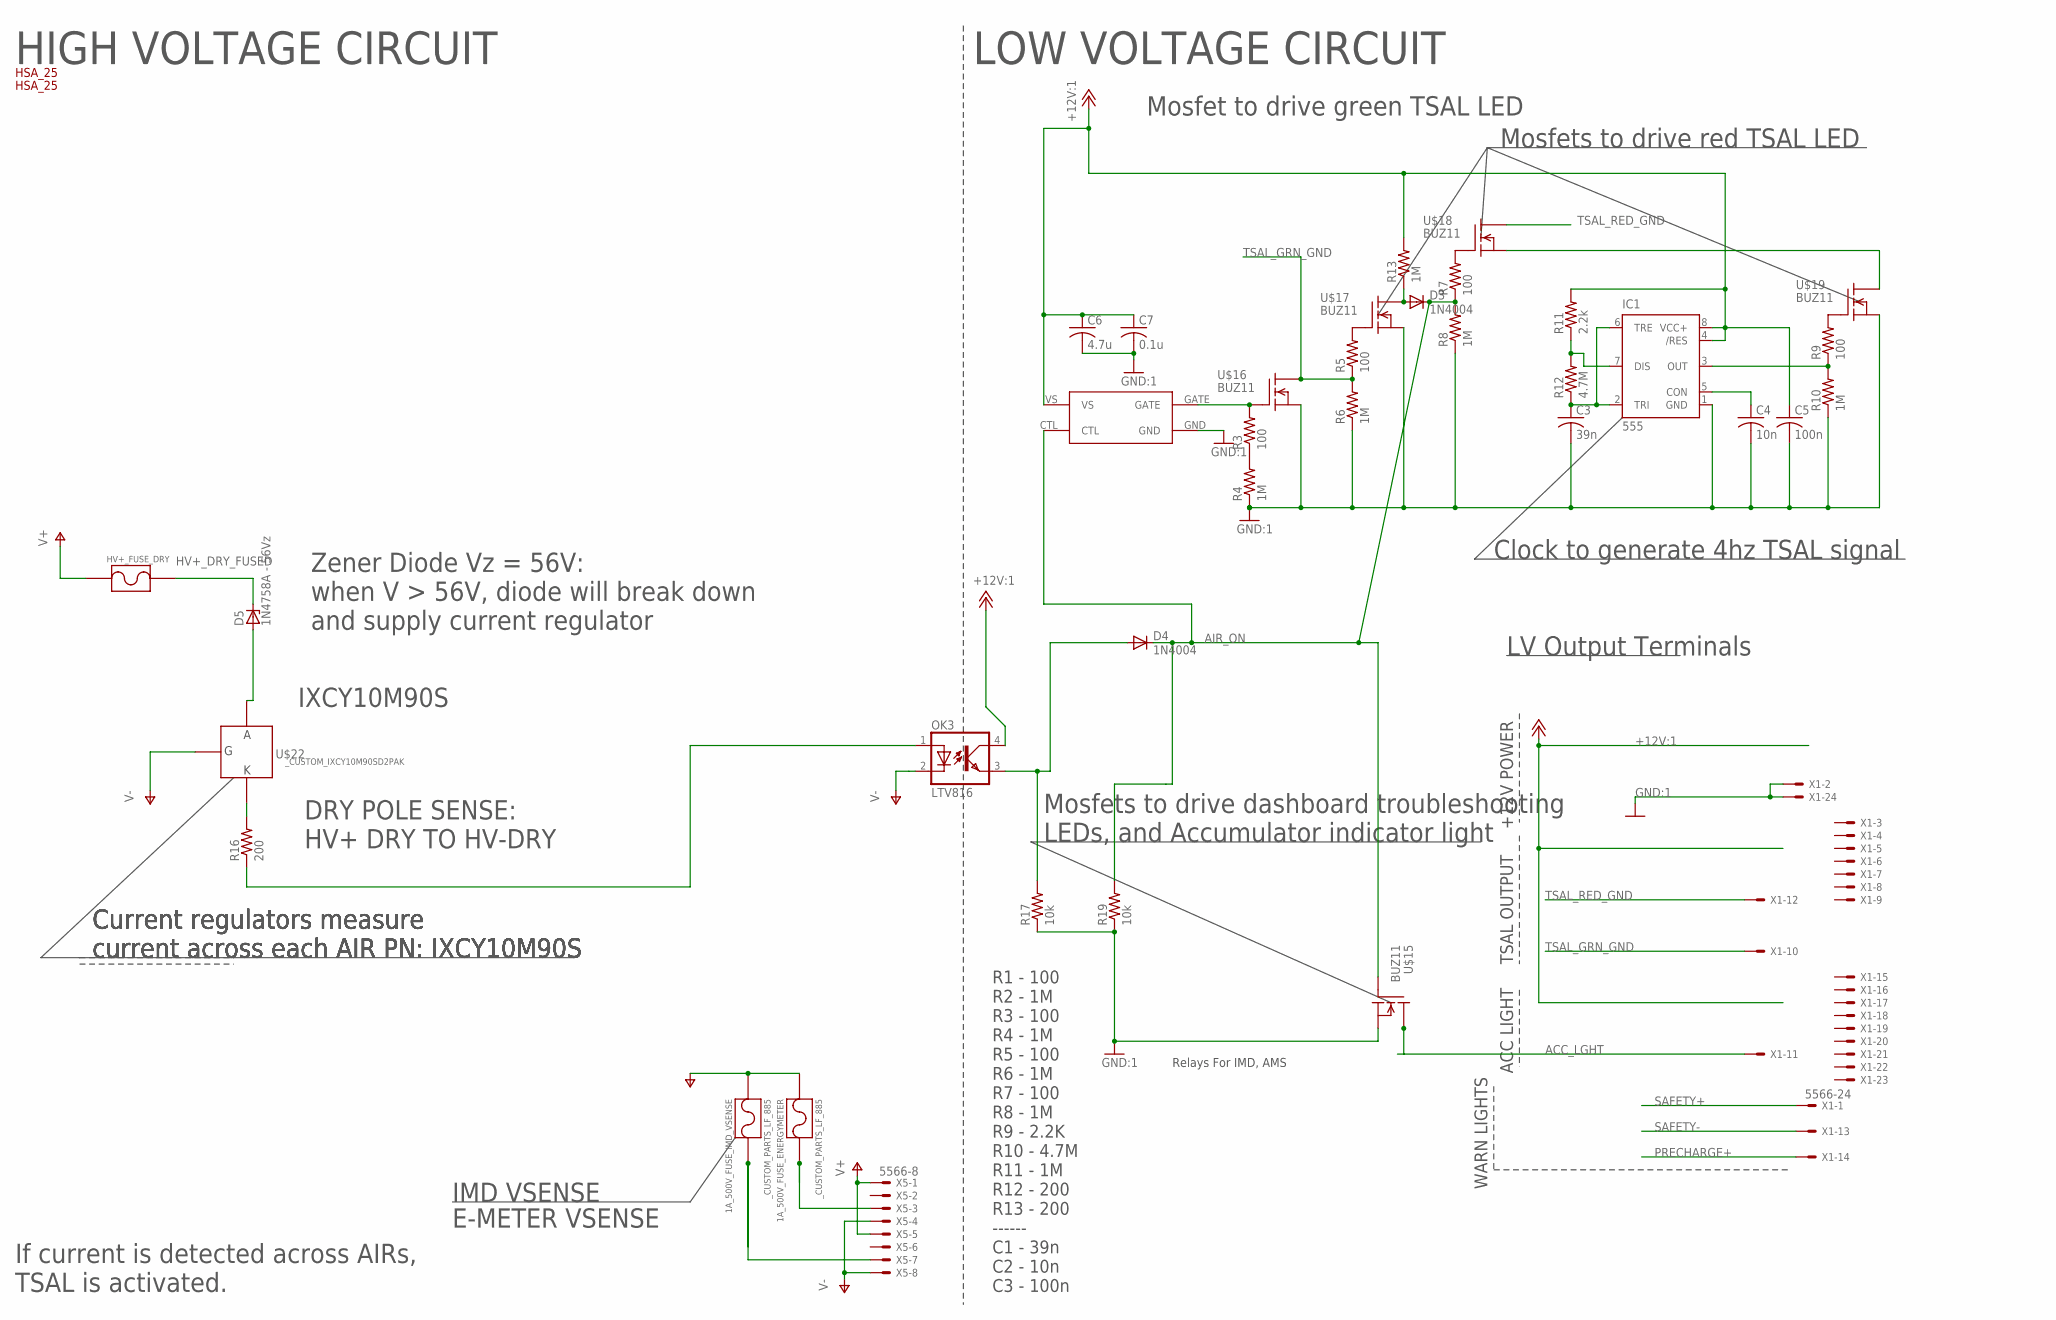
[picture p179: schematic Main.sch, sheet 2]

Parts:
1A_500V_FUSE_ENERGYMETER, 1A_500V_FUSE_IMD_VSENSE: _CUSTOM_PARTS_LF_885
C3: 39n; C0805
C4: 10n; C0805
C5: 100n; C0805
C6: 4.7u; C0805
C7: 0.1u; C0805
D3, D4: 1N4004; DO41-10
D5: 1N4758A - 56Vz; ZDIO12.5
HV+_FUSE_DRY: _CUSTOM_PARTS_LF_885
IC1: 555; DIP08
OK3: LTV816; DIL04
R3, R5, R7, R9: 100; R0805:1
R4, R6, R8, R10, R13: 1M; R0805:1
R11: 2.2k; R0805:1
R12: 4.7M; R0805:1
R16: 200; R2010
R17, R19: 10k; R0805:1
U$15, U$16, U$17, U$18, U$19: BUZ11; TO220
U$22: _CUSTOM_IXCY10M90SD2PAK; TO228P991X238-3
U$23: MIC4417; PDM_2019_REVB_MIC4416YM4-TR
U$24, U$25: HSA25; HSA_25_FOOT
X1: 5566-24
X5: 5566-8

Connections:
+12V: C5.1, C6.1, C7.1, IC1.4 (/RES), IC1.8 (VCC+), OK3.4 (COL), R11.2, R13.2, U$23.VS; also elsewhere on the board
ACC_LGHT: U$15.2 (D), X1.11
AIR_ON: D3.C, D4.C, R7.1, R8.2, R19.2, U$15.1 (G), U$23.CTL
GND: C3.2, C4.2, C5.2, C6.2, C7.2, IC1.1 (GND), R4.1, R6.1, R8.1, R10.1, R17.1, R19.1, U$15.3 (S), U$16.3 (S), U$17.3 (S), U$19.3 (S), U$23.GND, X1.2, X1.24; also elsewhere on the board
HV+_DRY_FUSED: D5.C, HV+_FUSE_DRY.P$1
unnamed: C4.1, IC1.5 (CON)
unnamed: 1A_500V_FUSE_ENERGYMETER.P$2, X5.3
unnamed: IC1.7 (DIS), R11.1, R12.2
unnamed: IC1.3 (OUT), R9.1, R10.2
unnamed: C3.1, IC1.2 (TRI), IC1.6 (TRE), R12.1
unnamed: R3.1, R4.2
unnamed: R3.2, U$16.1 (G), U$23.GATE
unnamed: R5.2, U$17.1 (G)
unnamed: U$18.3 (S), U$19.2 (D)
unnamed: D4.A, OK3.3 (EMIT), R17.2
unnamed: D3.A, R13.1, U$17.2 (D)
unnamed: R7.2, U$18.1 (G)
unnamed: R9.2, U$19.1 (G)
unnamed: 1A_500V_FUSE_IMD_VSENSE.P$2, X5.7
unnamed: R16.2, U$22.2 (K)
unnamed: D5.A, U$22.3 (A)
unnamed: OK3.1 (A), R16.1
PRECHARGE+: X1.14; also elsewhere on the board
SAFETY+: X1.1; also elsewhere on the board
SAFETY-: X1.13; also elsewhere on the board
TSAL_GRN_GND: R5.1, R6.2, U$16.2 (D), X1.10
TSAL_RED_GND: U$18.2 (D), X1.12
V+: HV+_FUSE_DRY.P$2, X5.1, X5.5
V-: 1A_500V_FUSE_ENERGYMETER.P$1, 1A_500V_FUSE_IMD_VSENSE.P$1, OK3.2 (C), U$22.1 (G), X5.4, X5.8

Notes on the sheet:
HIGH VOLTAGE CIRCUIT
LOW VOLTAGE CIRCUIT
TSAL OUTPUT
ACC LIGHT
WARN LIGHTS
Current regulators measure current across each AIR PN: IXCY10M90S
Mosfets to drive dashboard troubleshooting LEDs, and Accumulator indicator light
Clock to generate 4hz TSAL signal
Mosfets to drive red TSAL LED
Mosfet to drive green TSAL LED
+12V POWER
If current is detected across AIRs, TSAL is activated.
LV Output Terminals
R1 - 100 R2 - 1M R3 - 100 R4 - 1M R5 - 100 R6 - 1M R7 - 100 R8 - 1M R9 - 2.2K R10 - 4.7M R11 - 1M R12 - 200 R13 - 200 ------ C1 - 39n C2 - 10n C3 - 100n
E-METER VSENSE
IMD VSENSE
DRY POLE SENSE: HV+ DRY TO HV-DRY
Relays For IMD, AMS
IXCY10M90S
Zener Diode Vz = 56V: when V > 56V, diode will break down and supply current regulator

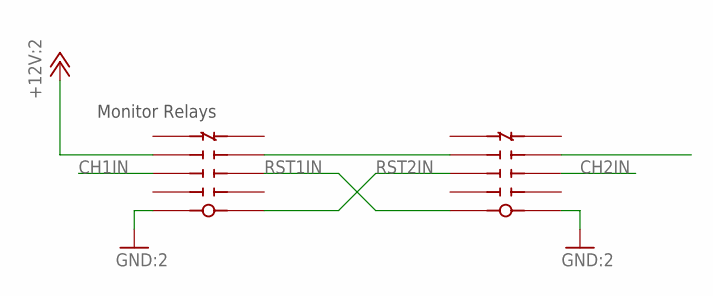
[picture p180: schematic Main.sch, sheet 3]

Parts:
U$13, U$14: SR4M4012_TE; SR4M4012_FOOT

Connections:
+12V: U$13.NOA3; also elsewhere on the board
CH1IN: U$13.NOA2
CH2IN: U$14.NOB2
GND: U$13.COIL+, U$14.COIL-; also elsewhere on the board
unnamed: U$13.NOB3, U$14.NOA3
RST1IN: U$13.NOB2, U$14.COIL+
RST2IN: U$13.COIL-, U$14.NOA2

Notes on the sheet:
Monitor Relays
