andrewrichardr/WFR2020/ACC-MB/Rev0/MainBoard/Main.brd

## EAGLE design ACC-MB/Rev0/MainBoard/Main.brd (continued)

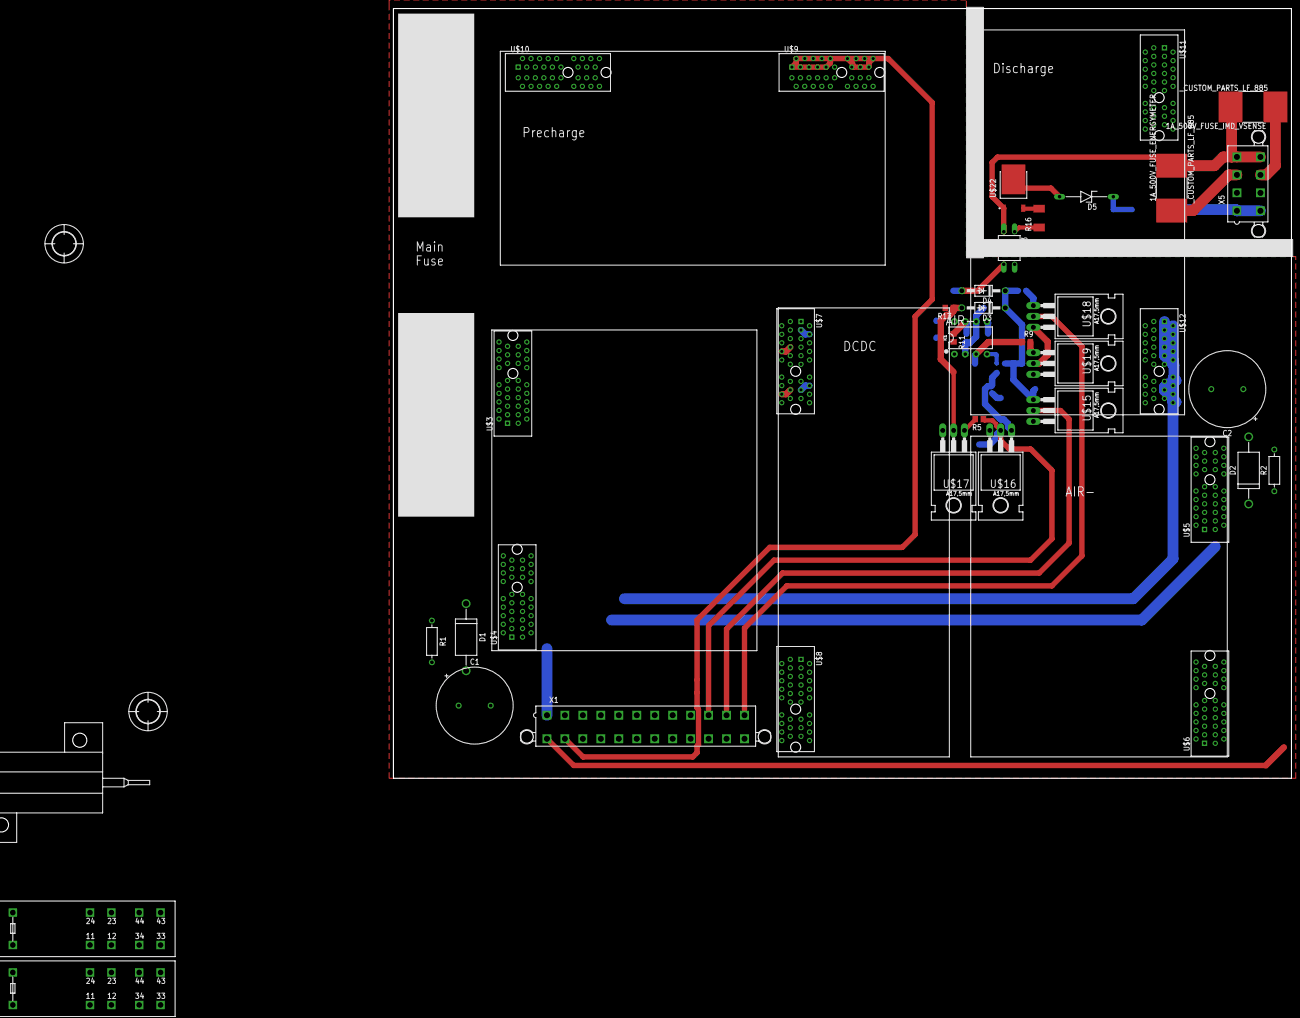
[picture p181: board ACC-MB/Rev0/MainBoard/Main.brd from above]

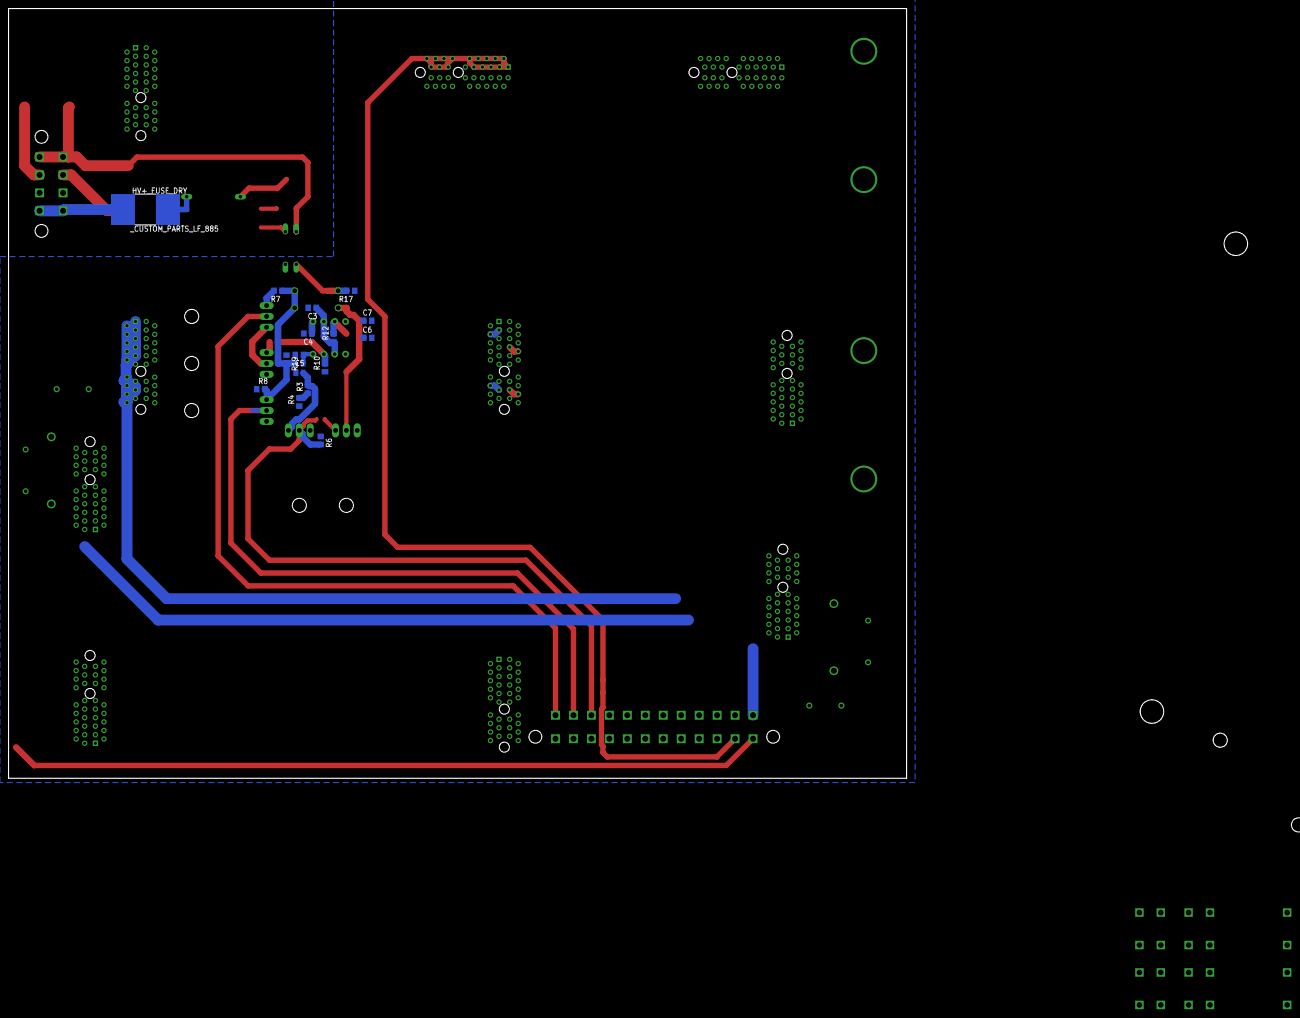
[picture p182: board ACC-MB/Rev0/MainBoard/Main.brd from below]

Board: 2 copper layers, 210.0 x 180.0 mm, 62 parts (16 on the bottom side), 36 nets.
