andrewrichardr/WFR2020/ACC-MB/Rev0/AIRDC/AIRDC.brd

## EAGLE design ACC-MB/Rev0/AIRDC/AIRDC.brd (2019-10-01, an earlier design)

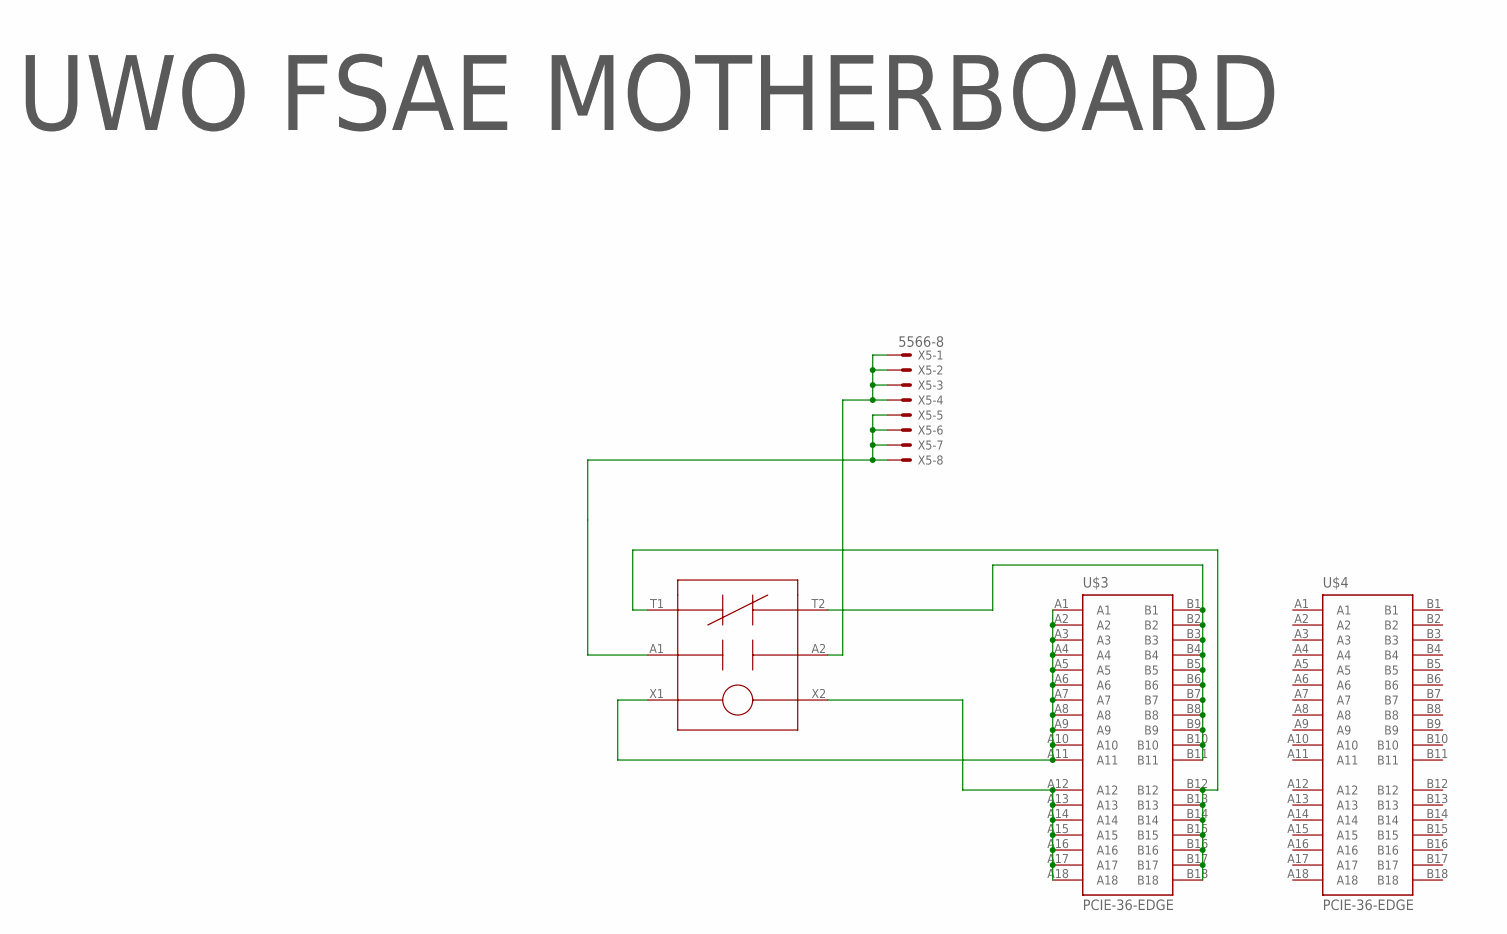
[picture p183: schematic AIRDC.sch]

Parts:
U$1: GV224
U$3, U$4: PCIE-36-EDGE; PCI-E_SLOT_36
X5: 5566-8

Connections:
unnamed: U$1.T1, U$3.B12, U$3.B13, U$3.B14, U$3.B15, U$3.B16, U$3.B17, U$3.B18
unnamed: U$1.X1, U$3.A1, U$3.A2, U$3.A3, U$3.A4, U$3.A5, U$3.A6, U$3.A7, U$3.A8, U$3.A9, U$3.A10, U$3.A11
unnamed: U$1.X2, U$3.A12, U$3.A13, U$3.A14, U$3.A15, U$3.A16, U$3.A17, U$3.A18
unnamed: U$1.A1, X5.5, X5.6, X5.7, X5.8
unnamed: U$1.A2, X5.1, X5.2, X5.3, X5.4
unnamed: U$1.T2, U$3.B1, U$3.B2, U$3.B3, U$3.B4, U$3.B5, U$3.B6, U$3.B7, U$3.B8, U$3.B9, U$3.B10, U$3.B11

Notes on the sheet:
UWO FSAE MOTHERBOARD

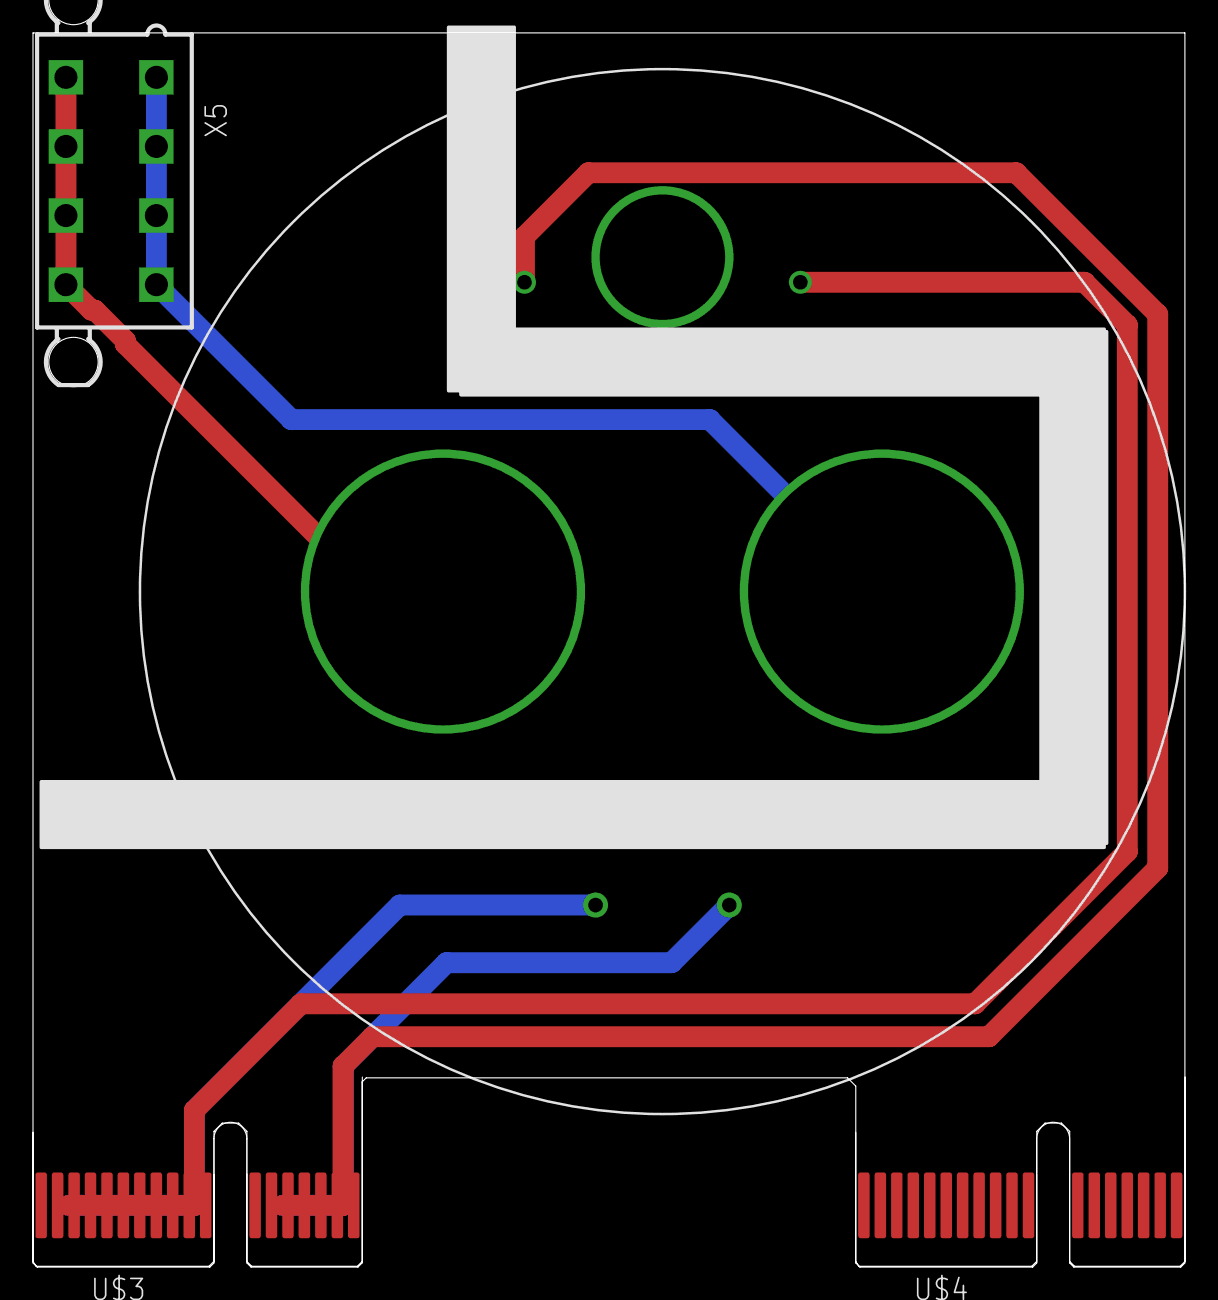
[picture p184: board AIRDC.brd from above]

Board: 2 copper layers, 70.0 x 75.0 mm, 4 parts (0 on the bottom side), 6 nets.
