andrewrichardr/WFR2020/2019/HOLDUP.brd

## EAGLE design 2019/HOLDUP.brd (2019-09-23)

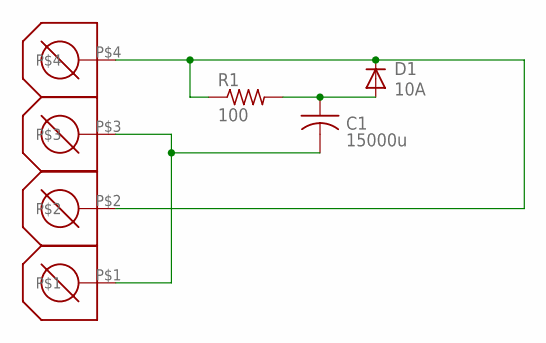
[picture p185: schematic HOLDUP.sch]

Parts:
C1: 15000u; CAPPRD750W65D1800H3700B
D1: 10A; DIOAD1570W120L850D500B
J1: TE_282834-4; 282834-4_FOOT
R1: 100; RESAD976W63L650D250B

Connections:
unnamed: D1.1 (C), J1.P$2, J1.P$4, R1.1
unnamed: C1.2, J1.P$1, J1.P$3
unnamed: C1.1, D1.2 (A), R1.2

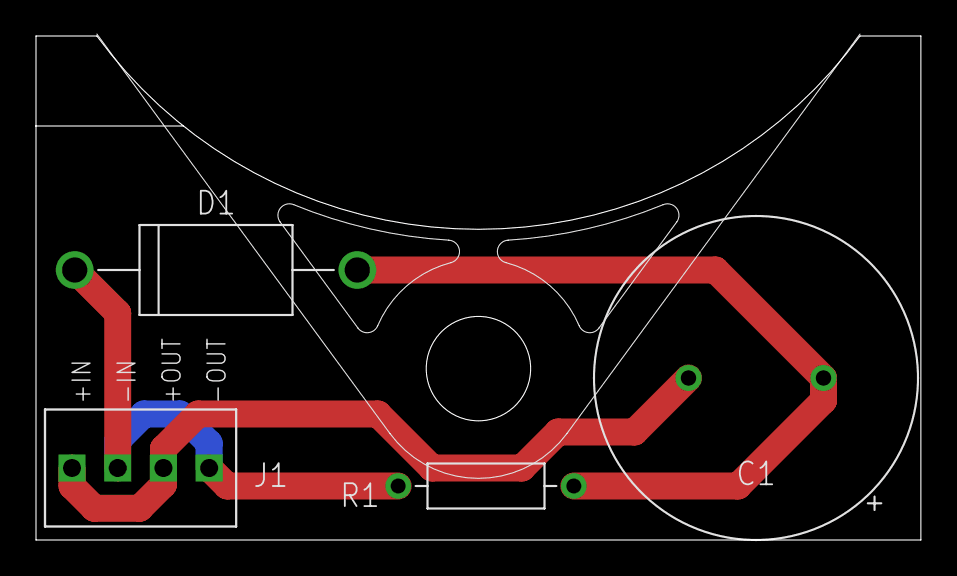
[picture p186: board HOLDUP.brd from above]

Board: 2 copper layers, 49.2 x 28.0 mm, 4 parts (0 on the bottom side), 3 nets.
