andrewrichardr/WFR2020/ACC-MB/Rev0/ACC-MB-R0.brd

## EAGLE design ACC-MB/Rev0/ACC-MB-R0.brd (2019-09-20, an earlier design)

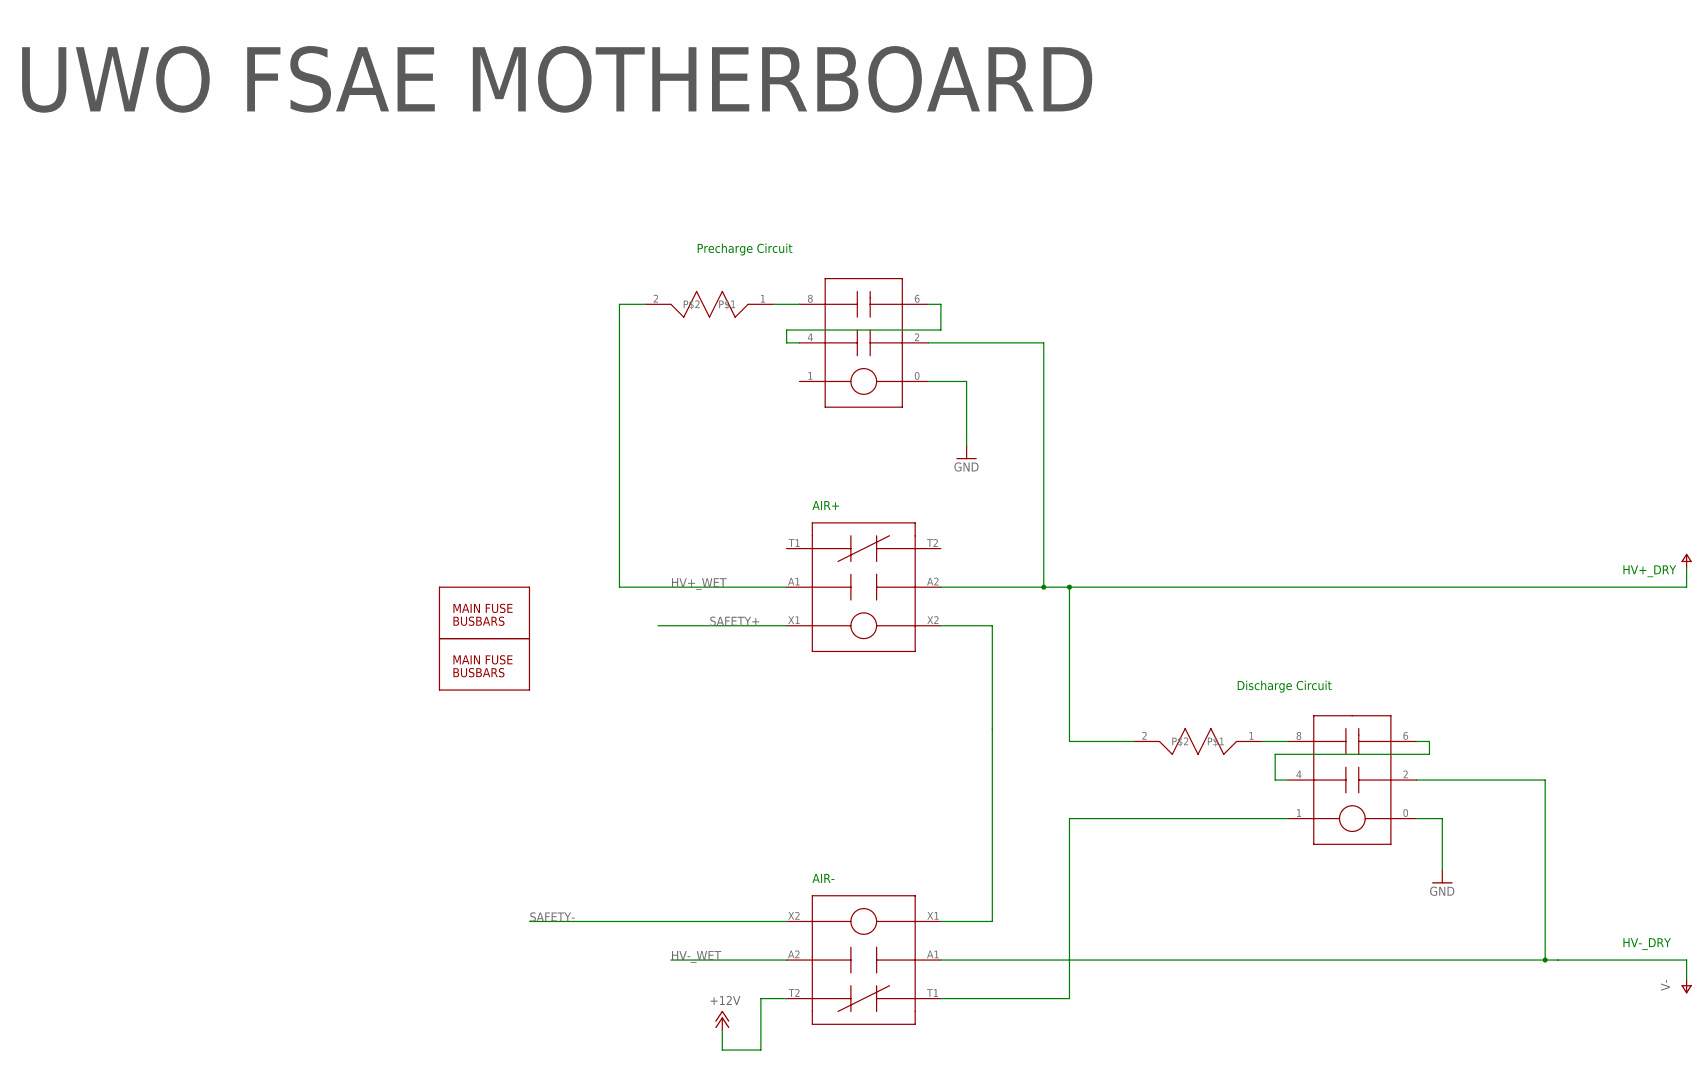
[picture p187: schematic ACC-MB-R0.sch, sheet 1]

Parts:
U$1, U$34: G7L
U$4, U$35: TO247RESISTORHEATINK; _CUSTOM_TO-247-2V
U$24, U$33: FUSE_HOLDER
U$31, U$32: GV224

Connections:
+12V: U$32.T2; also elsewhere on the board
GND: U$1.0, U$34.0; also elsewhere on the board
HV+_WET: U$31.A1, U$35.2
HV-_WET: U$32.A2
unnamed: U$34.8, U$35.1
unnamed: U$34.4, U$34.6
unnamed: U$1.1, U$32.T1
unnamed: U$31.X2, U$32.X1
unnamed: U$1.4, U$1.6
unnamed: U$1.8, U$4.1
SAFETY+: U$31.X1
SAFETY-: U$32.X2
V+: U$4.2, U$31.A2, U$34.2; also elsewhere on the board
V-: U$1.2, U$32.A1; also elsewhere on the board

Notes on the sheet:
UWO FSAE MOTHERBOARD
HV-_DRY
AIR-
AIR+
HV+_DRY
Precharge Circuit
Discharge Circuit

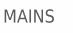
[picture p188: schematic ACC-MB-R0.sch, sheet 2]

Notes on the sheet:
MAINS

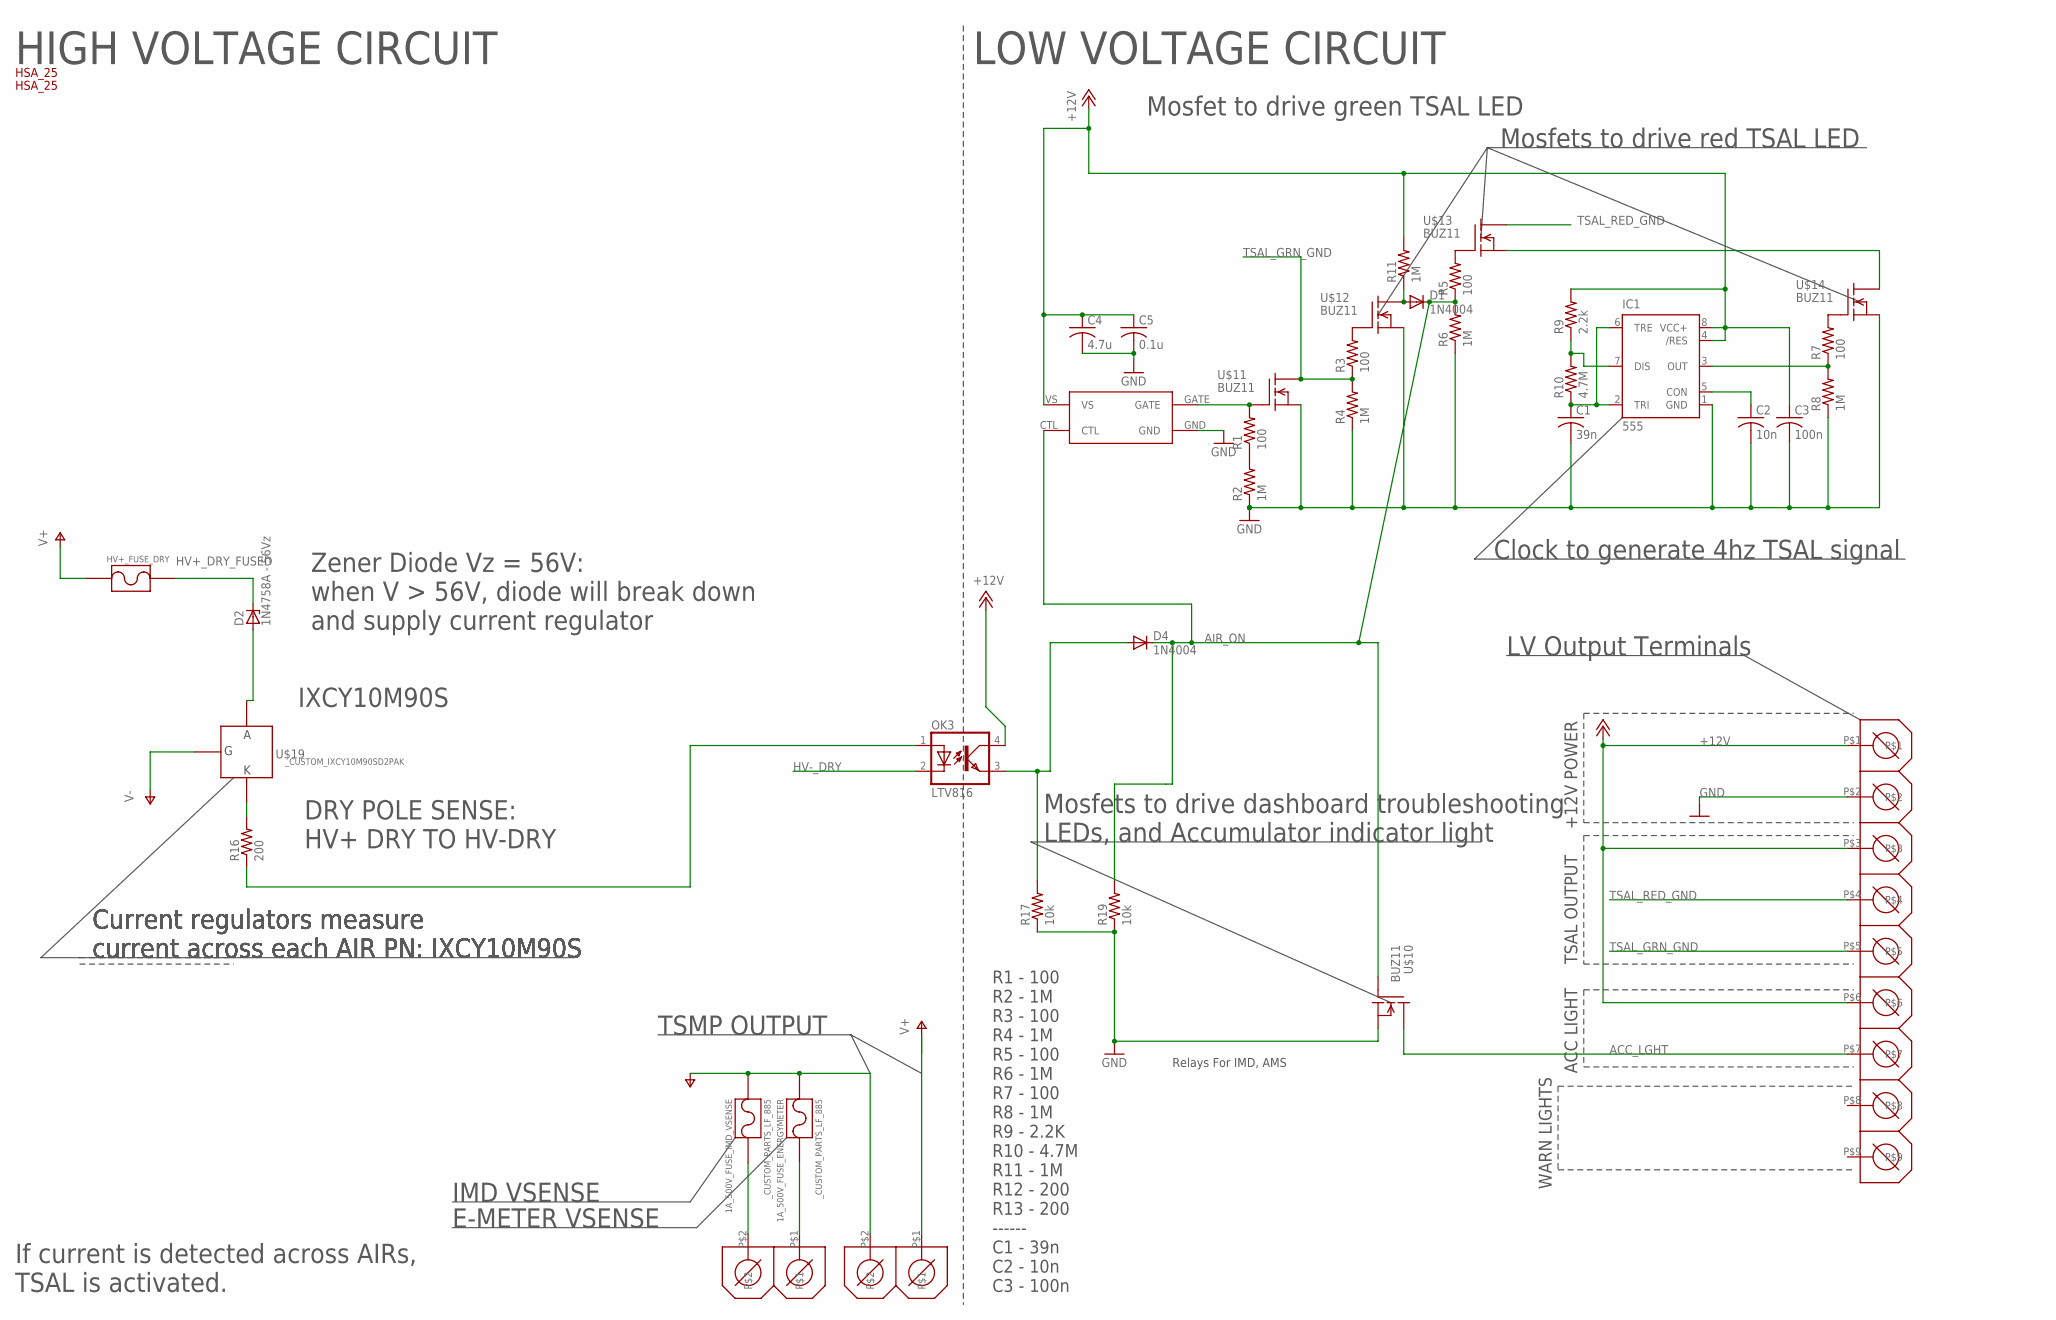
[picture p189: schematic ACC-MB-R0.sch, sheet 3]

Parts:
1A_500V_FUSE_ENERGYMETER, 1A_500V_FUSE_IMD_VSENSE: _CUSTOM_PARTS_LF_885
C1: 39n; C0805
C2: 10n; C0805
C3: 100n; C0805
C4: 4.7u; C0805
C5: 0.1u; C0805
D1, D4: 1N4004; DO41-10
D2: 1N4758A - 56Vz; ZDIO12.5
HV+_FUSE_DRY: _CUSTOM_PARTS_LF_885
IC1: 555; DIP08
OK3: LTV816; DIL04
R1, R3, R5, R7: 100; R0805:1
R2, R4, R6, R8, R11: 1M; R0805:1
R9: 2.2k; R0805:1
R10: 4.7M; R0805:1
R16: 200; R2010
R17, R19: 10k; R0805:1
U$2, U$3: HSA25; HSA_25_FOOT
U$7: PHOENIX_1725724; 1725724_FOOT
U$10, U$11, U$12, U$13, U$14: BUZ11; TO220
U$15: MIC4417; PDM_2019_REVB_MIC4416YM4-TR
U$16, U$17: DCDC_PARTS_282838-2_TE; DCDC_PARTS_282838-2_FOOT
U$19: _CUSTOM_IXCY10M90SD2PAK; TO228P991X238-3

Connections:
+12V: C3.1, C4.1, C5.1, IC1.4 (/RES), IC1.8 (VCC+), OK3.4 (COL), R9.2, R11.2, U$7.P$1, U$7.P$3, U$7.P$6, U$15.VS; also elsewhere on the board
ACC_LGHT: U$7.P$7, U$10.2 (D)
AIR_ON: D1.C, D4.C, R5.1, R6.2, R19.2, U$10.1 (G), U$15.CTL
GND: C1.2, C2.2, C3.2, C4.2, C5.2, IC1.1 (GND), R2.1, R4.1, R6.1, R8.1, R17.1, R19.1, U$7.P$2, U$10.3 (S), U$11.3 (S), U$12.3 (S), U$14.3 (S), U$15.GND; also elsewhere on the board
HV+_DRY_FUSED: D2.C, HV+_FUSE_DRY.P$1
HV-_DRY: OK3.2 (C)
unnamed: R1.1, R2.2
unnamed: R1.2, U$11.1 (G), U$15.GATE
unnamed: R3.2, U$12.1 (G)
unnamed: C2.1, IC1.5 (CON)
unnamed: IC1.7 (DIS), R9.1, R10.2
unnamed: R5.2, U$13.1 (G)
unnamed: R7.2, U$14.1 (G)
unnamed: IC1.3 (OUT), R7.1, R8.2
unnamed: C1.1, IC1.2 (TRI), IC1.6 (TRE), R10.1
unnamed: D2.A, U$19.3 (A)
unnamed: U$13.3 (S), U$14.2 (D)
unnamed: D4.A, OK3.3 (EMIT), R17.2
unnamed: D1.A, R11.1, U$12.2 (D)
unnamed: R16.2, U$19.2 (K)
unnamed: 1A_500V_FUSE_IMD_VSENSE.P$2, U$17.P$2
unnamed: 1A_500V_FUSE_ENERGYMETER.P$2, U$17.P$1
unnamed: OK3.1 (A), R16.1
TSAL_GRN_GND: R3.1, R4.2, U$7.P$5, U$11.2 (D)
TSAL_RED_GND: U$7.P$4, U$13.2 (D)
V+: HV+_FUSE_DRY.P$2, U$16.P$1; also elsewhere on the board
V-: 1A_500V_FUSE_ENERGYMETER.P$1, 1A_500V_FUSE_IMD_VSENSE.P$1, U$16.P$2, U$19.1 (G); also elsewhere on the board

Notes on the sheet:
HIGH VOLTAGE CIRCUIT
LOW VOLTAGE CIRCUIT
TSAL OUTPUT
ACC LIGHT
WARN LIGHTS
Current regulators measure current across each AIR PN: IXCY10M90S
Mosfets to drive dashboard troubleshooting LEDs, and Accumulator indicator light
Clock to generate 4hz TSAL signal
Mosfets to drive red TSAL LED
Mosfet to drive green TSAL LED
+12V POWER
If current is detected across AIRs, TSAL is activated.
LV Output Terminals
R1 - 100 R2 - 1M R3 - 100 R4 - 1M R5 - 100 R6 - 1M R7 - 100 R8 - 1M R9 - 2.2K R10 - 4.7M R11 - 1M R12 - 200 R13 - 200 ------ C1 - 39n C2 - 10n C3 - 100n
TSMP OUTPUT
E-METER VSENSE
IMD VSENSE
DRY POLE SENSE: HV+ DRY TO HV-DRY
Relays For IMD, AMS
IXCY10M90S
Zener Diode Vz = 56V: when V > 56V, diode will break down and supply current regulator

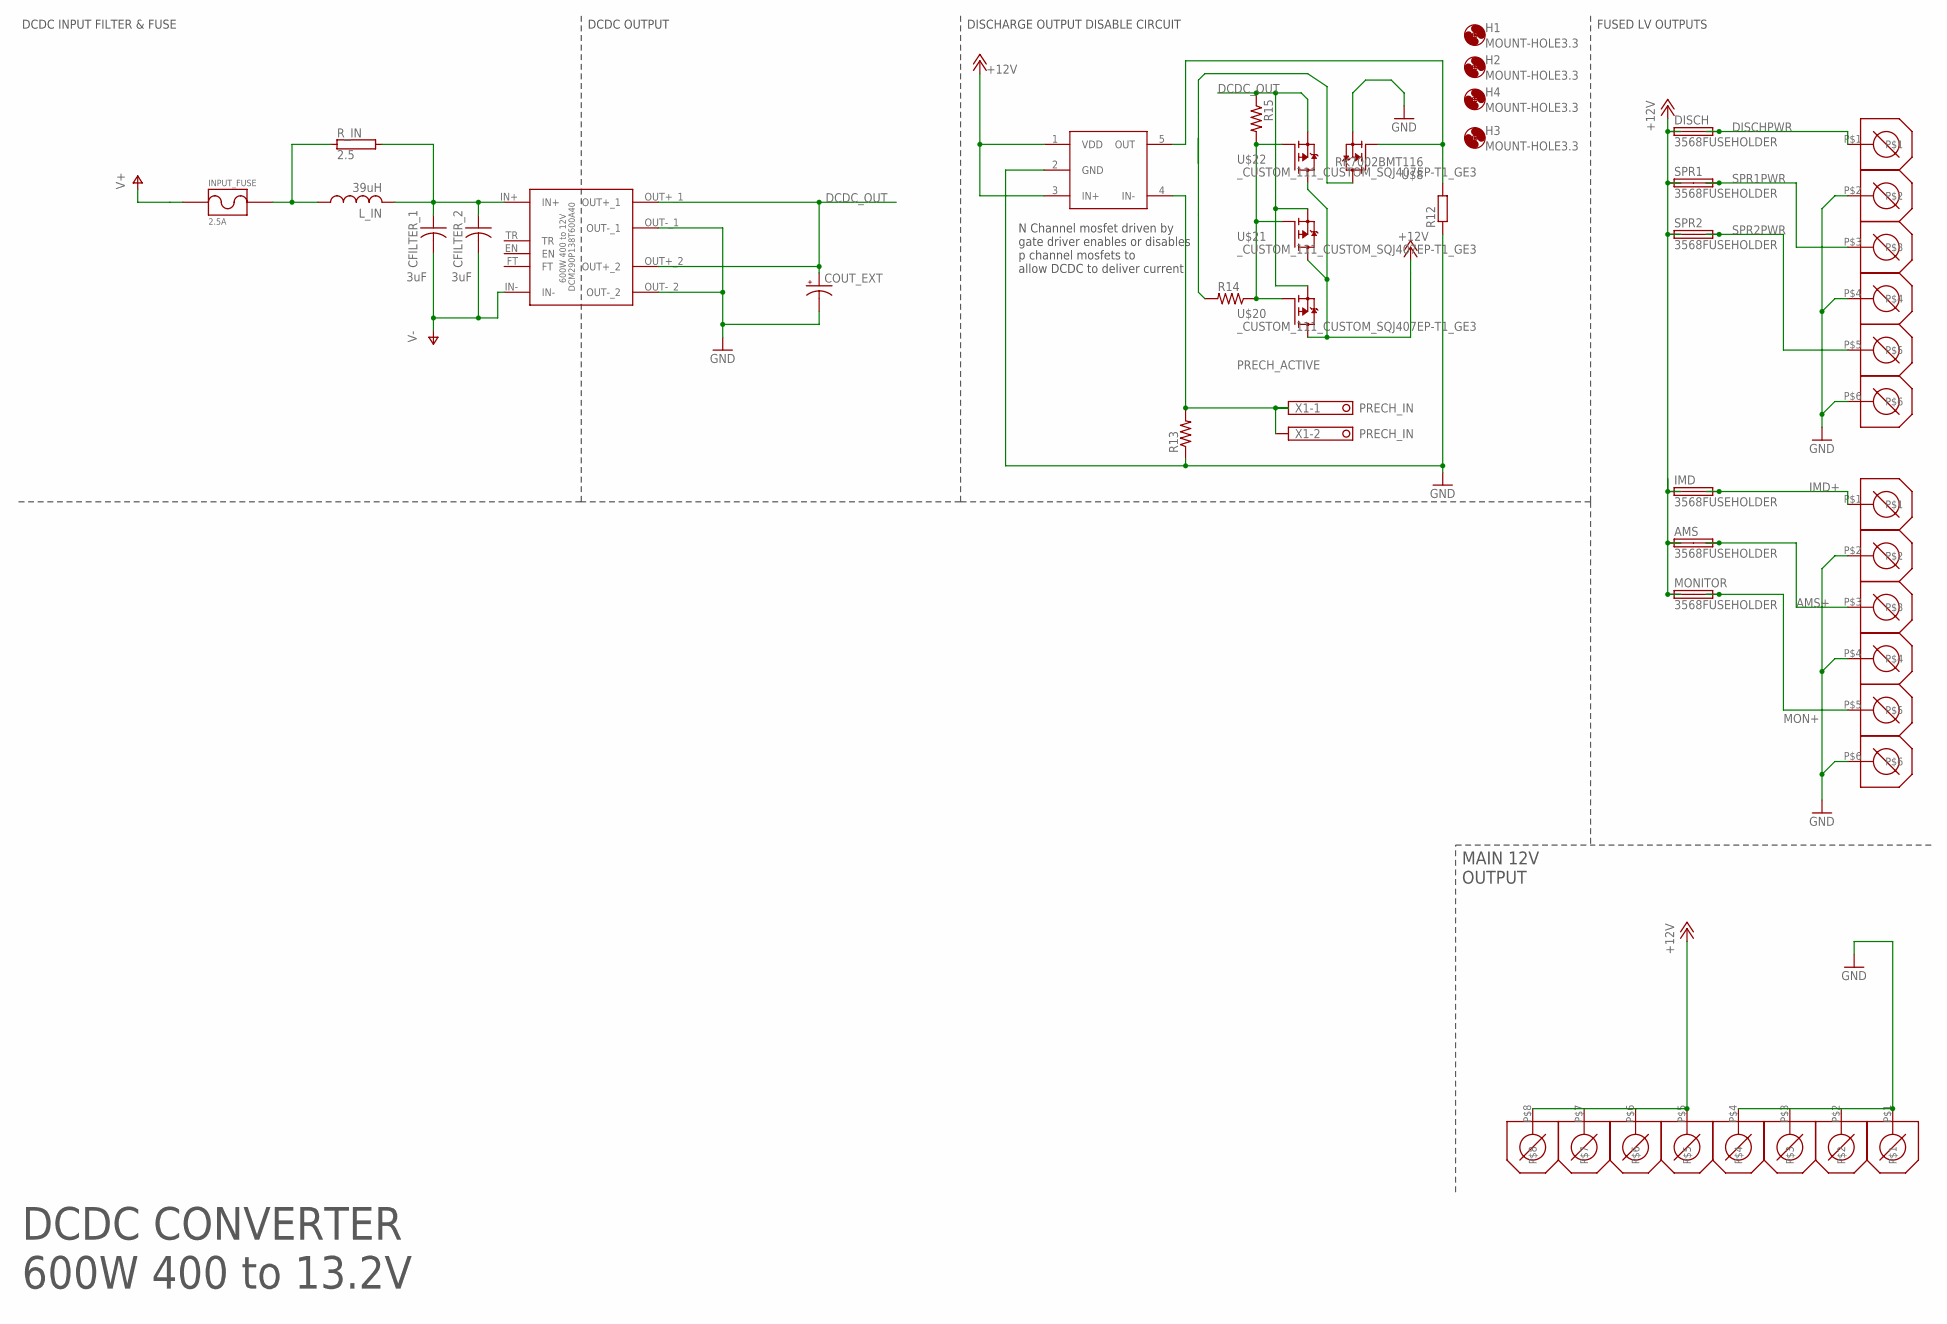
[picture p190: schematic ACC-MB-R0.sch, sheet 4]

Parts:
AMS: 3568FUSEHOLDER; 3568
CFILTER_1, CFILTER_2: 3uF; CERALINK_FA3
COUT_EXT: CPOL-USE7.5-16; E7,5-16
DCM290P138T600A40: 600W 400 to 12V; VICOR_CHIP_HEATSINK
DISCH: 3568FUSEHOLDER; 3568
H1, H2, H3, H4: MOUNT-HOLE3.3; 3,3
IMD: 3568FUSEHOLDER; 3568
INPUT_FUSE: 2.5A; _CUSTOM_PARTS_LF_885
L_IN: 39uH; L_1510_NONSTANDARD
MONITOR: 3568FUSEHOLDER; 3568
R12: R-EU_R0805; R0805
R13, R14, R15: R-US_R0805; R0805
R_IN: 2.5; TO-247-2V
SPR1, SPR2: 3568FUSEHOLDER; 3568
U$5, U$6: 1935200_PHOENIX; 1777587_FOOT
U$8: RK7002BMT116; SOT23
U$9: 1777600_PHOENIX; 1777600_FOOT
U$18: UCC27511AQDBVRQ1; SOT23-5L
U$20, U$21, U$22: _CUSTOM_111_CUSTOM_SQJ407EP-T1_GE3; _CUSTOM_111_CUSTOM_TRANS_SIRA90DP-T1-GE3
X1: PRECH_IN; 1751248

Connections:
+12V: AMS.L1 (1A), AMS.L2 (1B), DISCH.L1 (1A), DISCH.L2 (1B), IMD.L1 (1A), IMD.L2 (1B), MONITOR.L1 (1A), MONITOR.L2 (1B), SPR1.L1 (1A), SPR1.L2 (1B), SPR2.L1 (1A), SPR2.L2 (1B), U$9.P$5, U$9.P$6, U$9.P$7, U$9.P$8, U$18.1 (VDD), U$18.3 (IN+), U$20.5 (D), U$21.5 (D), U$22.5 (D); also elsewhere on the board
AMS+: AMS.R1 (2A), AMS.R2 (2B), U$5.P$3
DCDC_OUT: COUT_EXT.+, DCM290P138T600A40.OUT+_1, DCM290P138T600A40.OUT+_2, R15.1, U$20.1 (S), U$20.2 (S), U$20.3 (S), U$21.1 (S), U$21.2 (S), U$21.3 (S), U$22.1 (S), U$22.2 (S), U$22.3 (S)
DISCHPWR: DISCH.R1 (2A), DISCH.R2 (2B), U$6.P$1
GND: COUT_EXT.-, DCM290P138T600A40.OUT-_1, DCM290P138T600A40.OUT-_2, R12.1, R13.1, U$5.P$2, U$5.P$4, U$5.P$6, U$6.P$2, U$6.P$4, U$6.P$6, U$8.2 (S), U$9.P$1, U$9.P$2, U$9.P$3, U$9.P$4, U$18.2 (GND); also elsewhere on the board
IMD+: IMD.R1 (2A), IMD.R2 (2B), U$5.P$1
MON+: MONITOR.R1 (2A), MONITOR.R2 (2B), U$5.P$5
unnamed: R12.2, U$8.1 (G), U$18.5 (OUT)
unnamed: CFILTER_1.P$1 (1), CFILTER_2.P$1 (1), DCM290P138T600A40.IN+, L_IN.P$2 (2), R_IN.2
unnamed: R14.2, U$8.3 (D)
unnamed: R14.1, R15.2, U$20.4 (G), U$21.4 (G), U$22.4 (G)
PRECH_ACTIVE: R13.2, U$18.4 (IN-), X1.1, X1.2
SPR1PWR: SPR1.R1 (2A), SPR1.R2 (2B), U$6.P$3
SPR2PWR: SPR2.R1 (2A), SPR2.R2 (2B), U$6.P$5
V+: INPUT_FUSE.P$1; also elsewhere on the board
V+_FUSED: INPUT_FUSE.P$2, L_IN.P$1 (1), R_IN.1
V-: CFILTER_1.P$2 (2), CFILTER_2.P$2 (2), DCM290P138T600A40.IN-; also elsewhere on the board

Notes on the sheet:
DCDC CONVERTER 600W 400 to 13.2V
DISCHARGE OUTPUT DISABLE CIRCUIT
FUSED LV OUTPUTS
MAIN 12V OUTPUT
DCDC OUTPUT
DCDC INPUT FILTER & FUSE
N Channel mosfet driven by gate driver enables or disables p channel mosfets to allow DCDC to deliver current

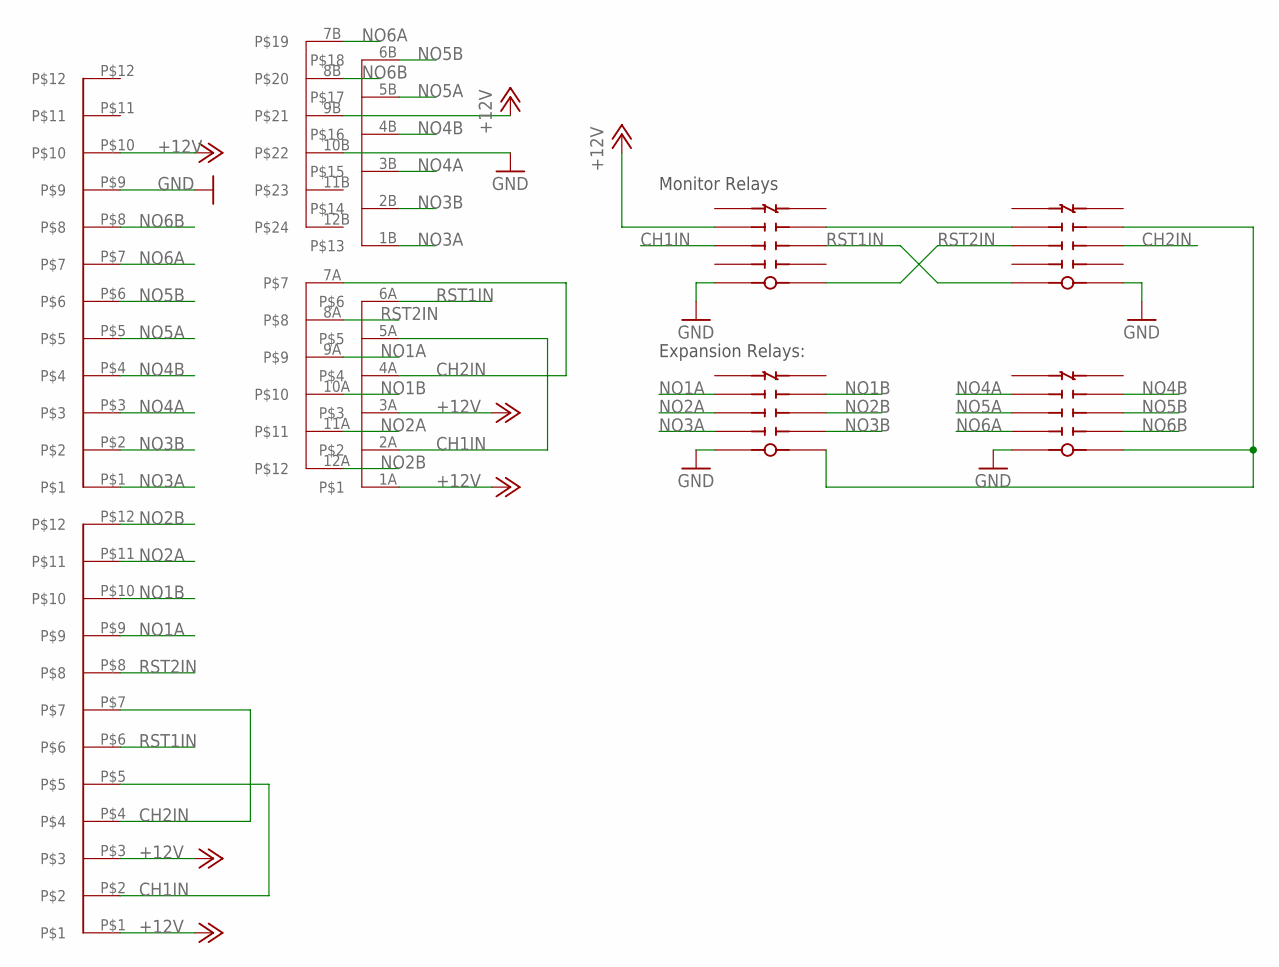
[picture p191: schematic ACC-MB-R0.sch, sheet 6]

Parts:
U$23, U$25: 1777642_PHOENIX; 1777642_FOOTPRINT
U$26: DTM1312PA12BR008; DE_12X2_PIN_HEADER
U$27, U$28, U$29, U$30: SR4M4012_TE; SR4M4012_FOOT

Connections:
+12V: U$23.P$10, U$25.P$1, U$25.P$3, U$26.1A, U$26.3A, U$26.9B, U$27.NOA3; also elsewhere on the board
CH1IN: U$25.P$2, U$25.P$5, U$26.2A, U$26.5A, U$27.NOA2
CH2IN: U$25.P$4, U$25.P$7, U$26.4A, U$26.7A, U$28.NOB2
GND: U$23.P$9, U$26.10B, U$27.COIL+, U$28.COIL-, U$29.COIL+, U$30.COIL+; also elsewhere on the board
unnamed: U$27.NOB3, U$28.NOA3
unnamed: U$28.NOB3, U$29.COIL-, U$30.COIL-
NO1A: U$25.P$9, U$26.9A, U$29.NOA3
NO1B: U$25.P$10, U$26.10A, U$29.NOB3
NO2A: U$25.P$11, U$26.11A, U$29.NOA2
NO2B: U$25.P$12, U$26.12A, U$29.NOB2
NO3A: U$23.P$1, U$26.1B, U$29.NOA1
NO3B: U$23.P$2, U$26.2B, U$29.NOB1
NO4A: U$23.P$3, U$26.3B, U$30.NOA3
NO4B: U$23.P$4, U$26.4B, U$30.NOB3
NO5A: U$23.P$5, U$26.5B, U$30.NOA2
NO5B: U$23.P$6, U$26.6B, U$30.NOB2
NO6A: U$23.P$7, U$26.7B, U$30.NOA1
NO6B: U$23.P$8, U$26.8B, U$30.NOB1
RST1IN: U$25.P$6, U$26.6A, U$27.NOB2, U$28.COIL+
RST2IN: U$25.P$8, U$26.8A, U$27.COIL-, U$28.NOA2

Notes on the sheet:
Expansion Relays:
Monitor Relays

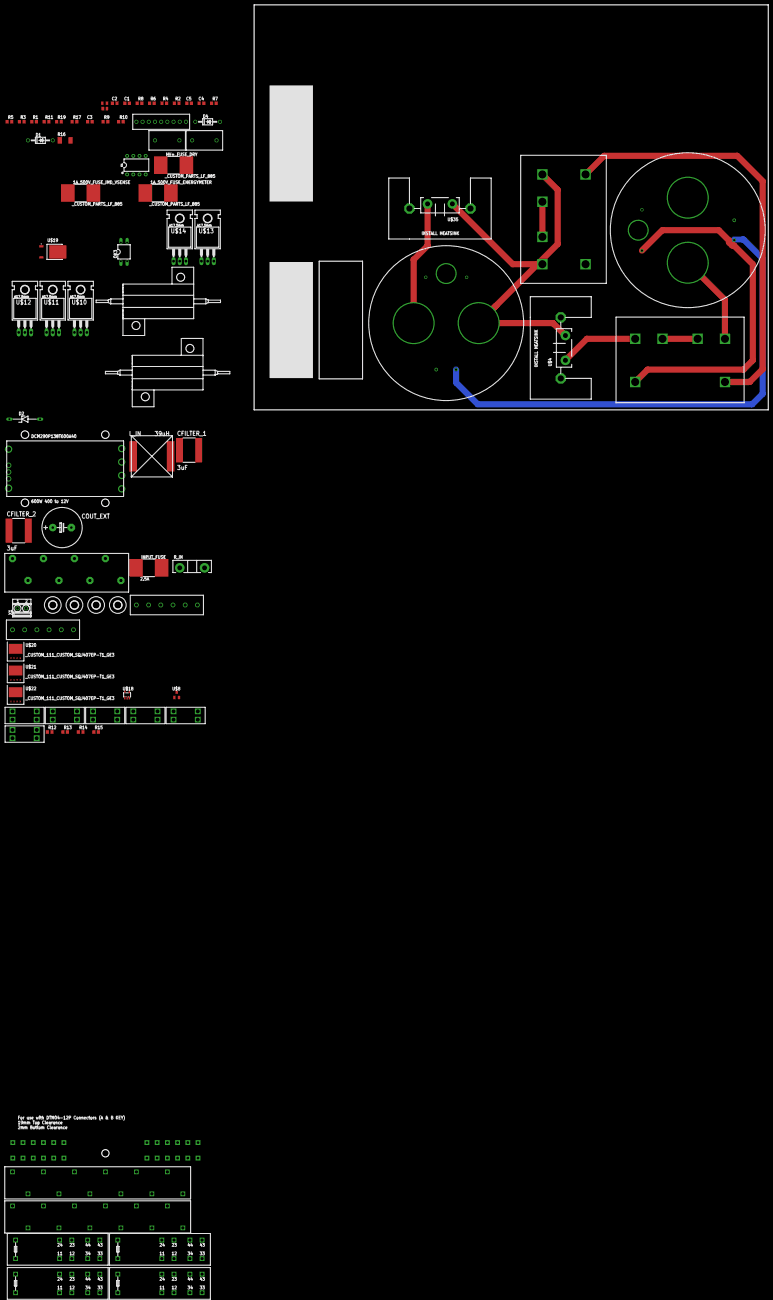
[picture p192: board ACC-MB-R0.brd from above]

Board: 2 copper layers, 210.8 x 166.0 mm, 84 parts (0 on the bottom side), 64 nets.
