andrewrichardr/WFR2020/2019/TempSensorCircuit_v2.brd

## EAGLE design 2019/TempSensorCircuit_v2.brd (2019-09-05)

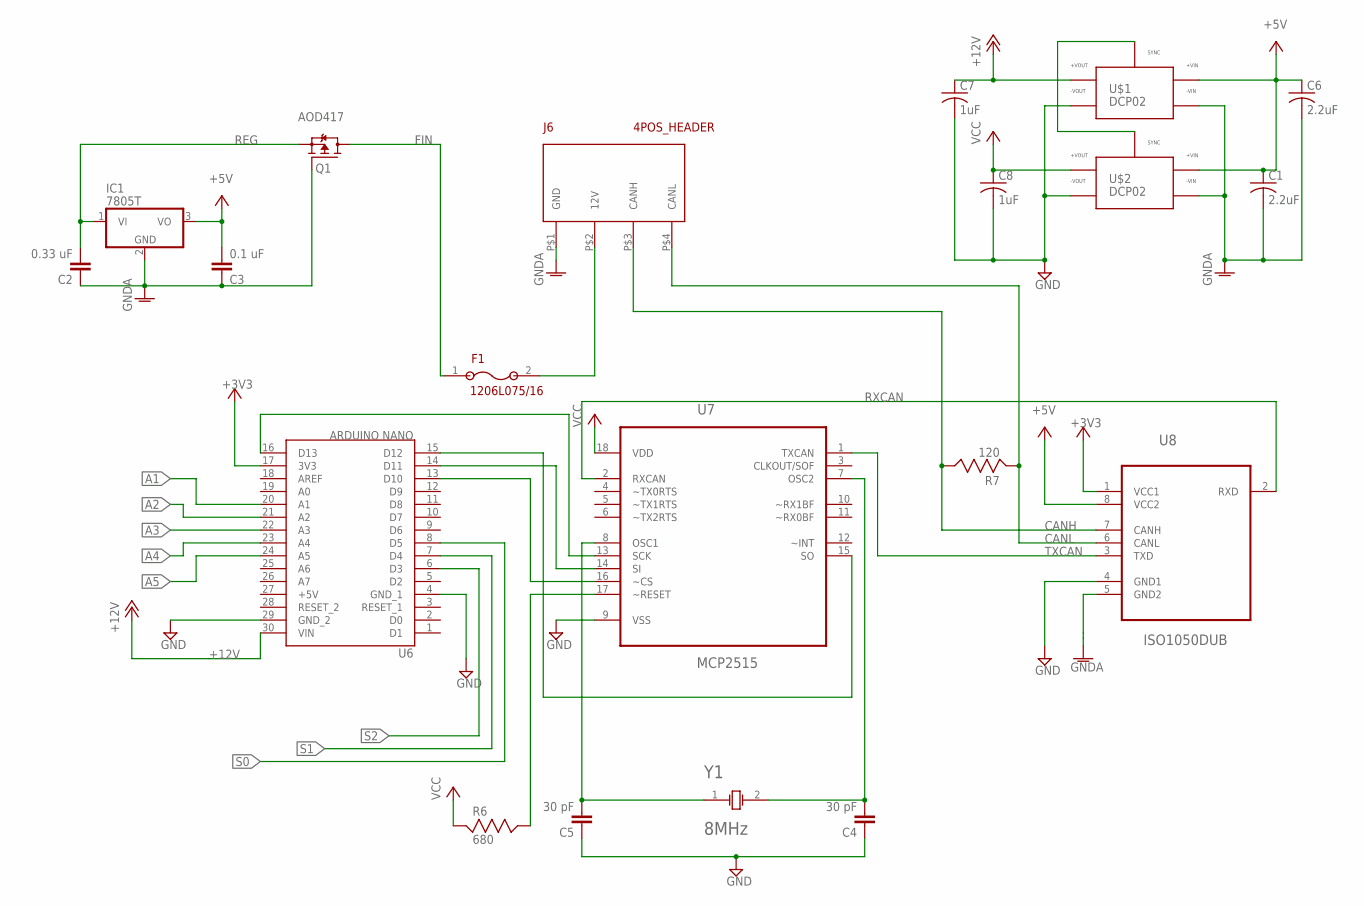
[picture p193: schematic TempSensorCircuit_v2.sch, sheet 1]

Parts:
C1, C6: 2.2uF; C0805
C2: 0.33 uF; C5B2.5
C3: 0.1 uF; C5B2.5
C4, C5: 30 pF; C5B2.5
C7, C8: 1uF; C0805
F1: 1206L075/16
IC1: 7805T; TO220H
J6: 4POS_HEADER
Q1: AOD417; TO252
R6: 680; RESC2012X60
R7: 120; RESC2012X60
U6: ARDUINO NANO; NANO
U7: MCP2515; DIP254P762X432-18
U8: ISO1050DUB; SOP254P1040X485-8N
U$1, U$2: DCP02; DIL14
Y1: 8MHz; XTAL_HC49P488W43L1135T465H360

Connections:
+3V3: U6.17 (3V3), U8.1 (VCC1)
+5V: C1.1, C3.2, C6.1, IC1.3 (VO), U6.27 (+5V), U8.8 (VCC2), U$1.1 (+VIN), U$2.1 (+VIN)
+12V: C7.1, U6.30 (VIN), U$1.6 (+VOUT)
A1: U6.20 (A1); also elsewhere on the board
A2: U6.21 (A2); also elsewhere on the board
A3: U6.22 (A3); also elsewhere on the board
A4: U6.23 (A4); also elsewhere on the board
A5: U6.24 (A5); also elsewhere on the board
CANH: J6.P$3 (CANH), R7.2, U8.7 (CANH)
CANL: J6.P$4 (CANL), R7.1, U8.6 (CANL)
FIN: F1.1, Q1.3 (D)
GND: C4.1, C5.1, C7.2, C8.2, U6.4 (GND_1), U6.29 (GND_2), U7.9 (VSS), U8.4 (GND1), U$1.5 (-VOUT), U$2.5 (-VOUT); also elsewhere on the board
GNDA: C1.2, C2.1, C3.1, C6.2, IC1.2 (GND), J6.P$1 (GND), Q1.1 (G), U8.5 (GND2), U$1.2 (-VIN), U$2.2 (-VIN)
unnamed: R6.2, U7.17 (~RESET)
unnamed: U6.16 (D13), U7.13 (SCK)
unnamed: U6.14 (D11), U7.14 (SI)
unnamed: U6.15 (D12), U7.15 (SO)
unnamed: U6.13 (D10), U7.16 (~CS)
unnamed: U$1.14 (SYNC), U$2.14 (SYNC)
unnamed: F1.2, J6.P$2 (12V)
OSC_N: C5.2, U7.8 (OSC1), Y1.1
OSC_P: C4.2, U7.7 (OSC2), Y1.2
REG: C2.2, IC1.1 (VI), Q1.2 (S)
RXCAN: U7.2 (RXCAN), U8.2 (RXD)
S0: U6.8 (D5); also elsewhere on the board
S1: U6.7 (D4); also elsewhere on the board
S2: U6.6 (D3); also elsewhere on the board
TXCAN: U7.1 (TXCAN), U8.3 (TXD)
VCC: C8.1, R6.1, U7.18 (VDD), U$2.6 (+VOUT); also elsewhere on the board
