andrewrichardr/WFR2020/2019/TempSensorCircuit_v2.brd

## EAGLE design 2019/TempSensorCircuit_v2.brd (continued)

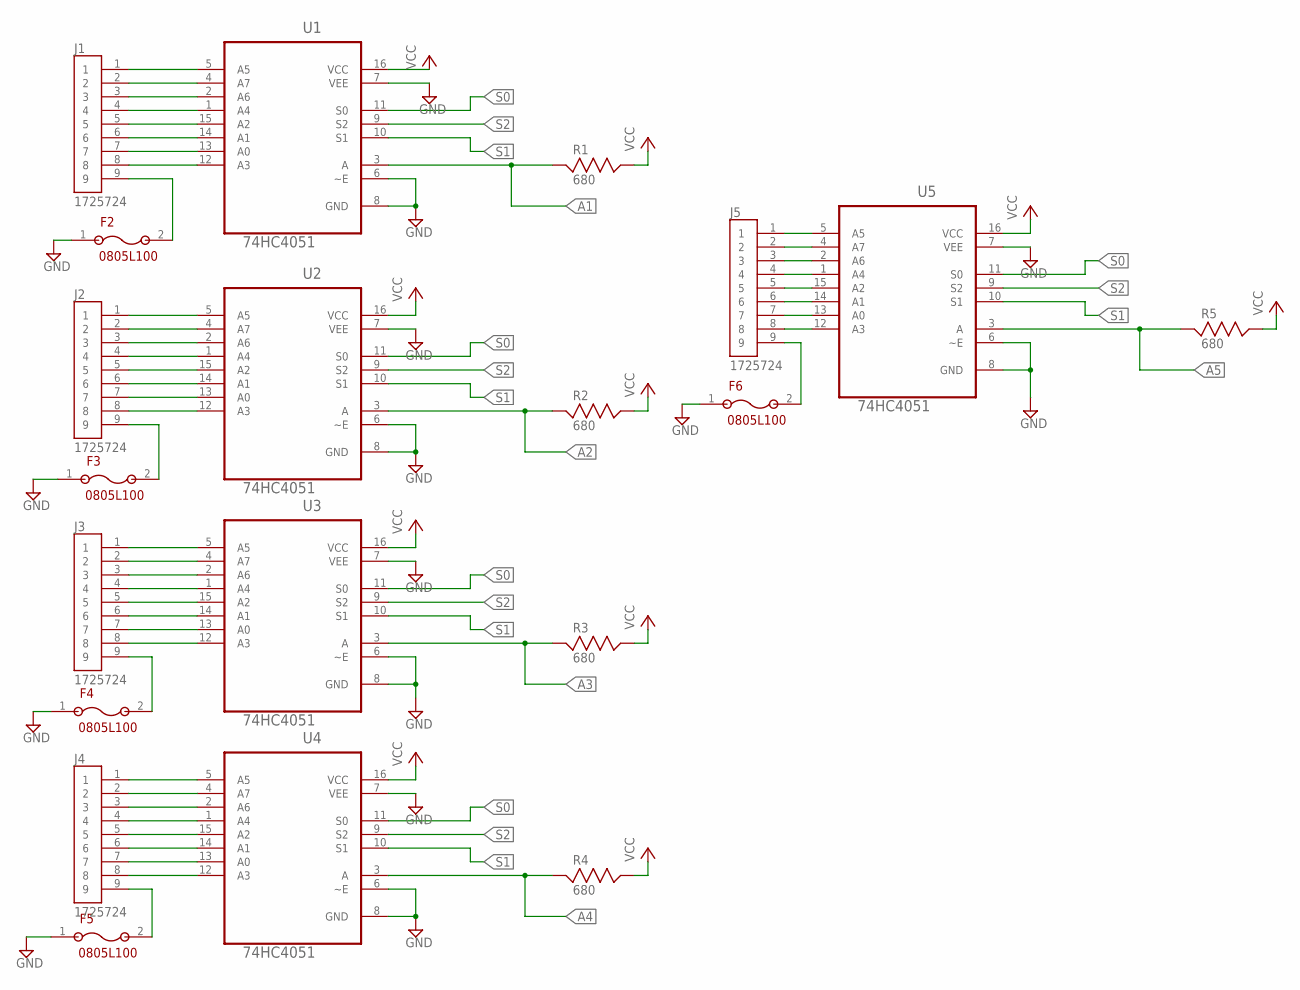
[picture p194: schematic TempSensorCircuit_v2.sch, sheet 2]

Parts:
F2, F3, F4, F5, F6: 0805L100; 2012
J1, J2, J3, J4, J5: 1725724; HDRV9W90P254_9X1_2332X620X850
R1, R2, R3, R4, R5: 680; RESC2012X60
U1, U2, U3, U4, U5: 74HC4051; DIP254P762X508-16

Connections:
A1: R1.1, U1.3 (A); also elsewhere on the board
A2: R2.1, U2.3 (A); also elsewhere on the board
A3: R3.1, U3.3 (A); also elsewhere on the board
A4: R4.1, U4.3 (A); also elsewhere on the board
A5: R5.1, U5.3 (A); also elsewhere on the board
GND: F2.1, F3.1, F4.1, F5.1, F6.1, U1.6 (~E), U1.7 (VEE), U1.8 (GND), U2.6 (~E), U2.7 (VEE), U2.8 (GND), U3.6 (~E), U3.7 (VEE), U3.8 (GND), U4.6 (~E), U4.7 (VEE), U4.8 (GND), U5.6 (~E), U5.7 (VEE), U5.8 (GND); also elsewhere on the board
unnamed: J3.1, U3.5 (A5)
unnamed: J3.2, U3.4 (A7)
unnamed: J1.8, U1.12 (A3)
unnamed: J3.3, U3.2 (A6)
unnamed: J3.4, U3.1 (A4)
unnamed: J3.5, U3.15 (A2)
unnamed: J3.6, U3.14 (A1)
unnamed: J3.7, U3.13 (A0)
unnamed: J1.7, U1.13 (A0)
unnamed: J1.6, U1.14 (A1)
unnamed: J1.5, U1.15 (A2)
unnamed: J1.4, U1.1 (A4)
unnamed: J1.3, U1.2 (A6)
unnamed: J1.2, U1.4 (A7)
unnamed: J1.1, U1.5 (A5)
unnamed: J3.8, U3.12 (A3)
unnamed: J2.1, U2.5 (A5)
unnamed: J2.2, U2.4 (A7)
unnamed: J2.3, U2.2 (A6)
unnamed: J2.4, U2.1 (A4)
unnamed: J2.5, U2.15 (A2)
unnamed: J2.6, U2.14 (A1)
unnamed: J2.7, U2.13 (A0)
unnamed: J2.8, U2.12 (A3)
unnamed: J4.1, U4.5 (A5)
unnamed: J4.2, U4.4 (A7)
unnamed: J4.3, U4.2 (A6)
unnamed: J4.4, U4.1 (A4)
unnamed: J4.5, U4.15 (A2)
unnamed: J4.6, U4.14 (A1)
unnamed: J4.7, U4.13 (A0)
unnamed: J4.8, U4.12 (A3)
unnamed: F2.2, J1.9
unnamed: F5.2, J4.9
unnamed: F4.2, J3.9
unnamed: F3.2, J2.9
unnamed: F6.2, J5.9
unnamed: J5.1, U5.5 (A5)
unnamed: J5.2, U5.4 (A7)
unnamed: J5.3, U5.2 (A6)
unnamed: J5.4, U5.1 (A4)
unnamed: J5.5, U5.15 (A2)
unnamed: J5.6, U5.14 (A1)
unnamed: J5.7, U5.13 (A0)
unnamed: J5.8, U5.12 (A3)
S0: U1.11 (S0), U2.11 (S0), U3.11 (S0), U4.11 (S0), U5.11 (S0); also elsewhere on the board
S1: U1.10 (S1), U2.10 (S1), U3.10 (S1), U4.10 (S1), U5.10 (S1); also elsewhere on the board
S2: U1.9 (S2), U2.9 (S2), U3.9 (S2), U4.9 (S2), U5.9 (S2); also elsewhere on the board
VCC: R1.2, R2.2, R3.2, R4.2, R5.2, U1.16 (VCC), U2.16 (VCC), U3.16 (VCC), U4.16 (VCC), U5.16 (VCC); also elsewhere on the board

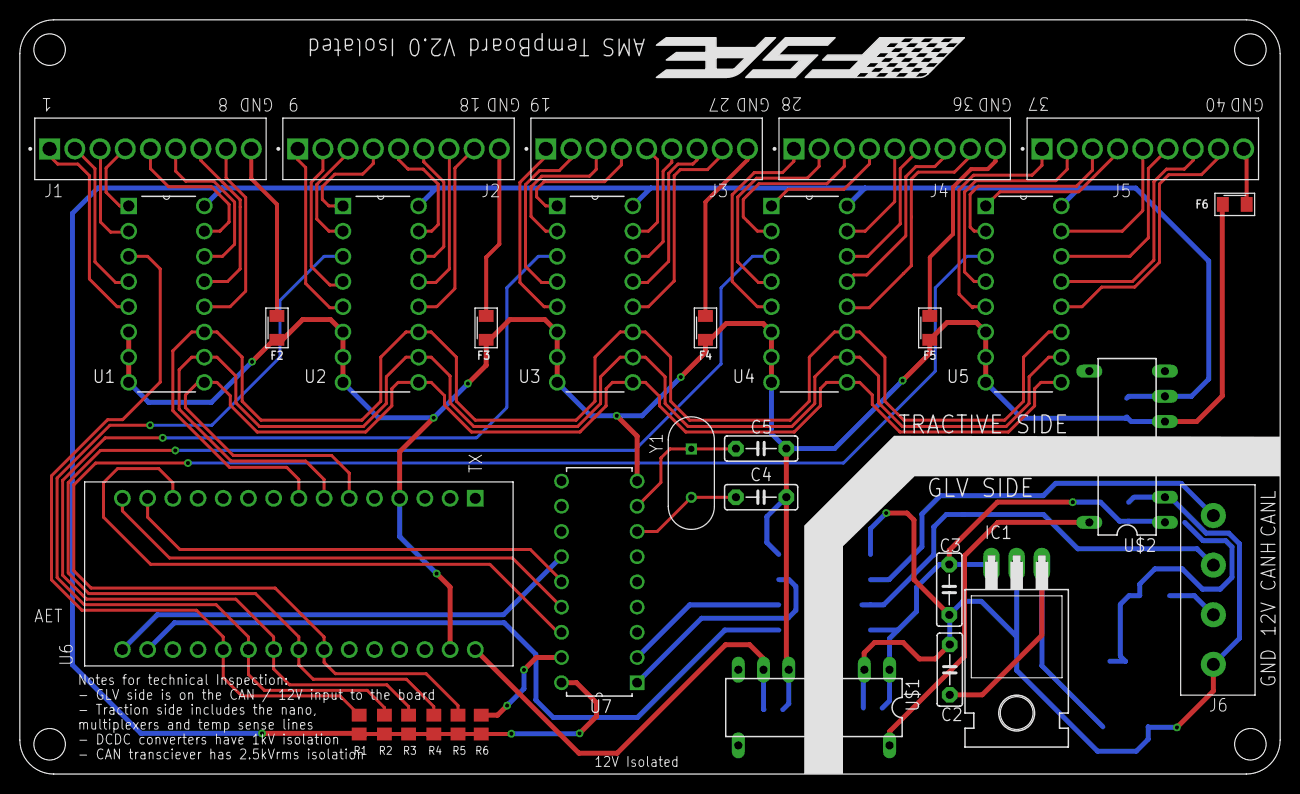
[picture p195: board TempSensorCircuit_v2.brd from above]

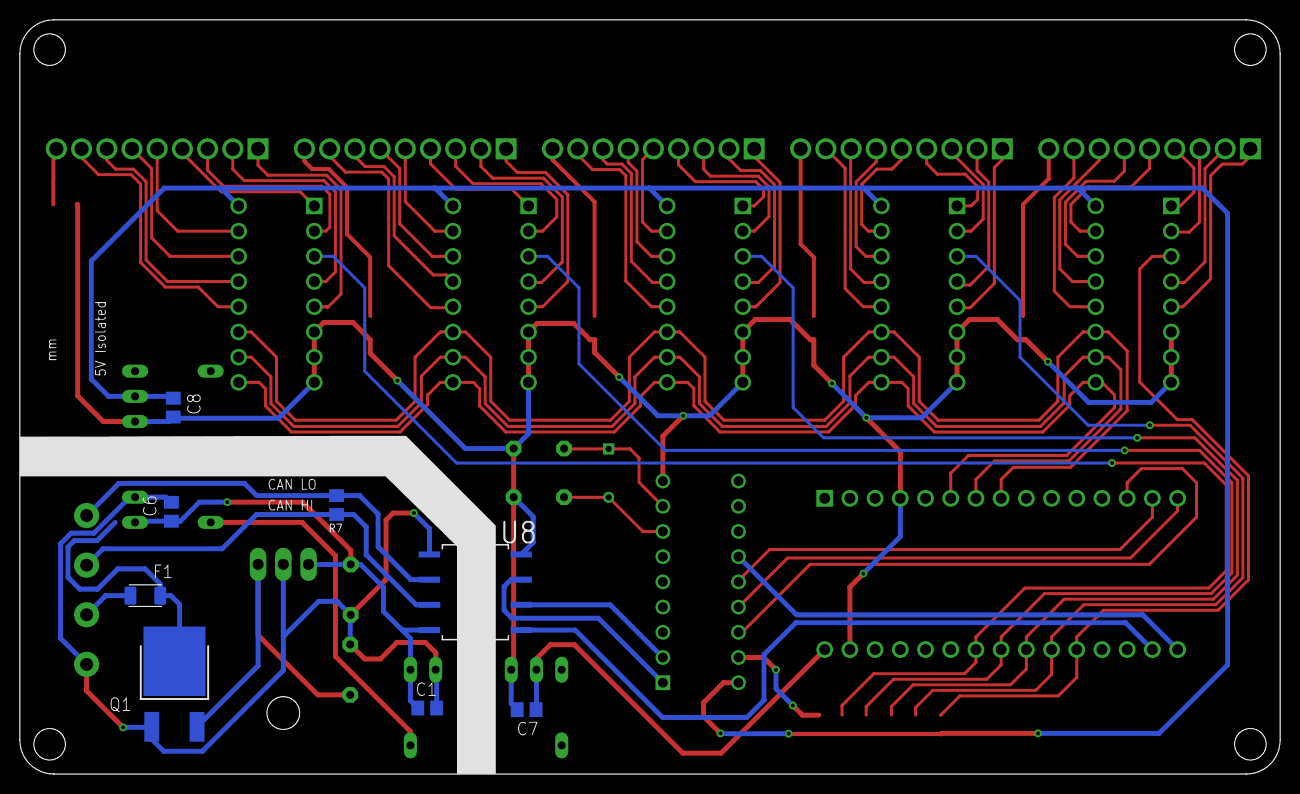
[picture p196: board TempSensorCircuit_v2.brd from below]

Board: 2 copper layers, 127.0 x 76.0 mm, 40 parts (8 on the bottom side), 74 nets.
