andrewrichardr/WFR2020/2019/RLY_INVERTER.brd

## EAGLE design 2019/RLY_INVERTER.brd (2019-09-05)

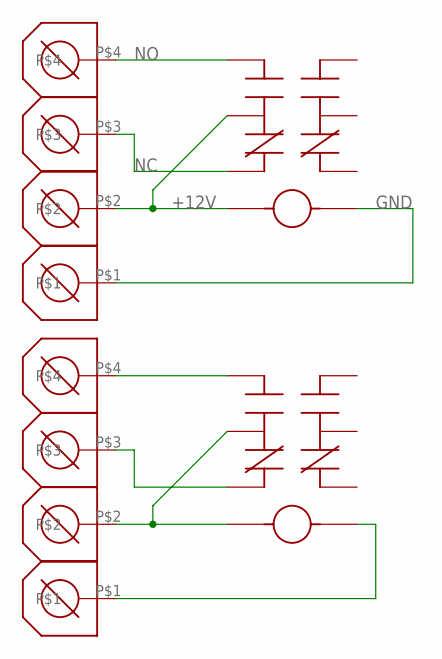
[picture p197: schematic RLY_INVERTER.sch]

Parts:
J1, J2: TE_282834-4; 282834-4_FOOT
U$1, U$2: BSPD_PARTS_RLY_V23079A1001B301; BSPD_PARTS_V23079F1101B301

Connections:
+12V: J2.P$2, U$2.1, U$2.4
GND: J2.P$1, U$2.12
unnamed: J1.P$1, U$1.12
unnamed: J1.P$2, U$1.1, U$1.4
unnamed: J1.P$4, U$1.5
unnamed: J1.P$3, U$1.3
NC: J2.P$3, U$2.3
NO: J2.P$4, U$2.5

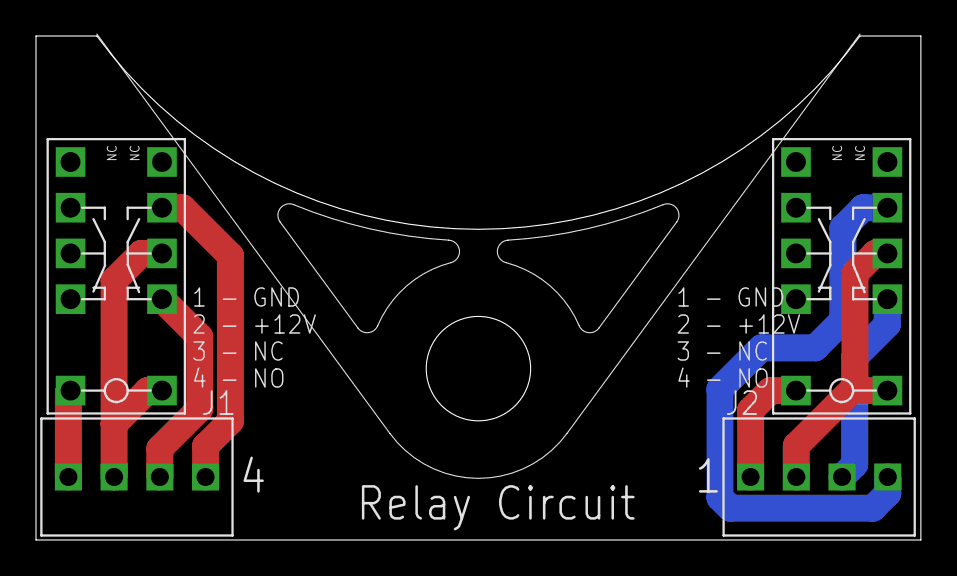
[picture p198: board RLY_INVERTER.brd from above]

Board: 2 copper layers, 49.2 x 28.0 mm, 4 parts (0 on the bottom side), 8 nets.
