andrewrichardr/WFR2020/2019/PrechargeV3.brd

## EAGLE design 2019/PrechargeV3.brd (2019-09-05)

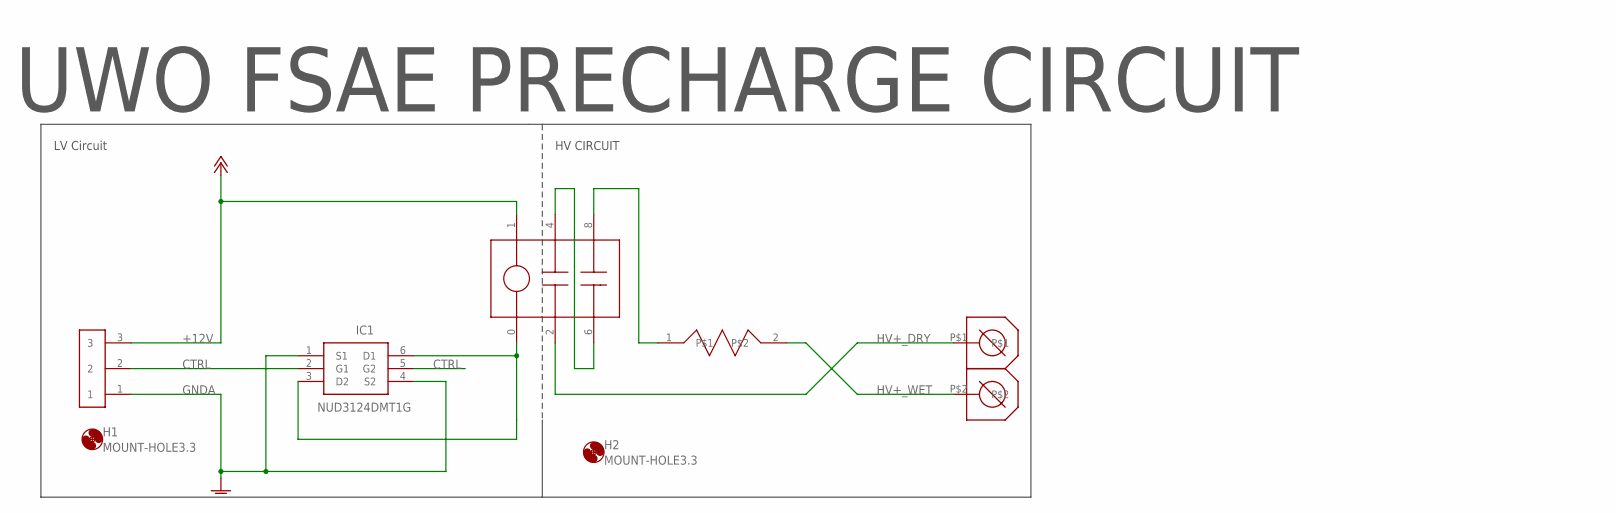
[picture p199: schematic PrechargeV3.sch]

Parts:
H1, H2: MOUNT-HOLE3.3; 3,3
IC1: NUD3124DMT1G; SAMACSYS_PARTS_SOT95P275X110-6N
U$1: TO247RESISTORHEATINK; _CUSTOM_TO-247-2V
U$2: PHOENIX_1935789
U$3: G7L
U$17: 282838-2_TE; 282838-2_FOOT

Connections:
+12V: U$2.3, U$3.1
CTRL: IC1.2 (G1), IC1.5 (G2), U$2.2
GNDA: IC1.1 (S1), IC1.4 (S2), U$2.1
HV+_DRY: U$3.2, U$17.P$1
HV+_WET: U$1.2, U$17.P$2
unnamed: U$1.1, U$3.8
unnamed: U$3.4, U$3.6
unnamed: IC1.3 (D2), IC1.6 (D1), U$3.0

Notes on the sheet:
UWO FSAE PRECHARGE CIRCUIT
LV Circuit
HV CIRCUIT

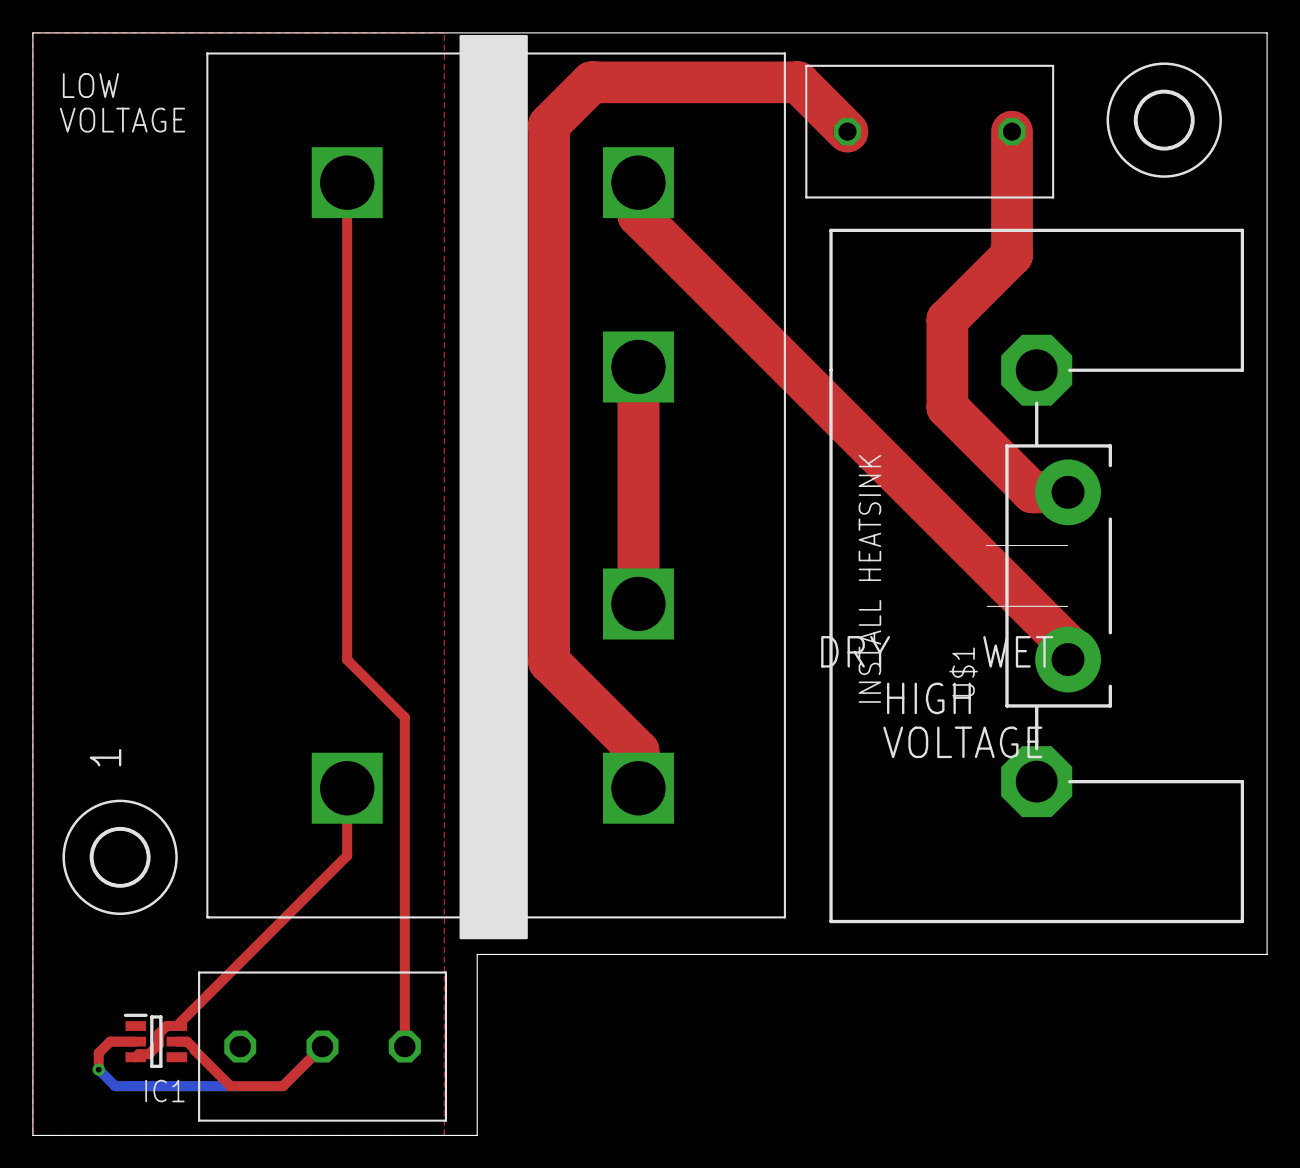
[picture p200: board PrechargeV3.brd from above]

Board: 2 copper layers, 75.0 x 67.0 mm, 7 parts (0 on the bottom side), 8 nets.
