andrewrichardr/WFR2020/ACC-MB/Rev0/CRDC/CRDC.brd

## EAGLE design ACC-MB/Rev0/CRDC/CRDC.brd (2019-10-01, an earlier design)

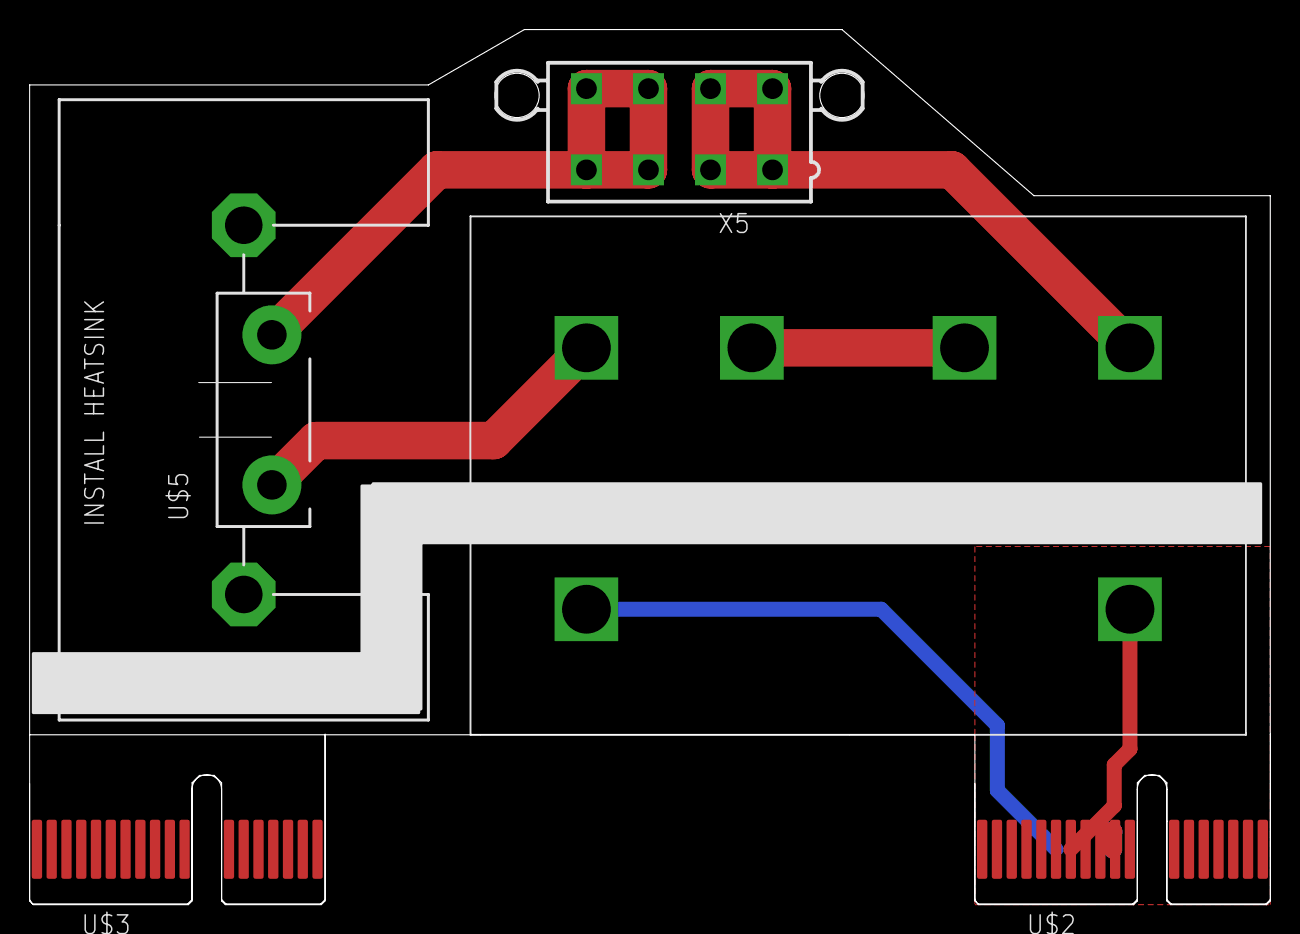
[picture p201: board ACC-MB/Rev0/CRDC/CRDC.brd from above]

Board: 2 copper layers, 84.0 x 59.2 mm, 5 parts (0 on the bottom side), 6 nets.

Parts:
U$1: G7L
U$2, U$3: PCIE-36-EDGE; PCI-E_SLOT_36
U$5: TO247RESISTORHEATINK; _CUSTOM_TO-247-2V
X5: 5566-8

Connections:
HV+_WET: U$5.2, X5.3, X5.4, X5.7, X5.8
unnamed: U$1.1, U$2.A1, U$2.A2, U$2.A3, U$2.A4, U$2.A5, U$2.A6, U$2.A7, U$2.A8, U$2.A9, U$2.A10, U$2.A11, U$2.A12, U$2.A13, U$2.A14, U$2.A15, U$2.A16, U$2.A17, U$2.A18
unnamed: U$1.0, U$2.B1, U$2.B2, U$2.B3, U$2.B4, U$2.B5, U$2.B6, U$2.B7, U$2.B8, U$2.B9, U$2.B10, U$2.B11, U$2.B12, U$2.B13, U$2.B14, U$2.B15, U$2.B16, U$2.B17, U$2.B18
unnamed: U$1.8, U$5.1
unnamed: U$1.4, U$1.6
V+: U$1.2, X5.1, X5.2, X5.5, X5.6
