andrewrichardr/WFR2020/(commit log)

2019-08-28 Mobo pathfinding
    [ACC-MB-R0.sch]
2019-09-05 mobo update
    [ACC-MB-R0.brd, ACC-MB-R0.sch, BSPD_v7b.brd, BSPD_v7b.sch, DCDC_Rev2.brd, DCDC_Rev2.sch, HVIB_v5.brd, HVIB_v5.sch]
2019-10-17 7792 added to all DC
    [AIRDC.brd, AIRDC.sch, CRDC.brd, CRDC.sch, DCDCDC-R2.brd, DCDCDC-R2.sch, DCDCDC.brd, DCDCDC.sch]
2019-10-17 AIRDC - adjusted overall board length and nut position
2019-12-12 not an update
    [BSPD_v8.brd, BSPD_v8.sch, TempSensorCircuit_v3.brd, TempSensorCircuit_v3.sch]
