andrewrichardr/WFR2020/(notices)

Notices in the files:
parts and their libraries:
SparkFun-IC-Special-Function: Licensing: Creative Commons ShareAlike 4.0 International - https://creativecommons.org/licenses/by-sa/4.0
deutsch_headers: COPYRIGHT: Copyright (C) 2018 Accelerated Designs. All rights reserved
COPYRIGHT: Copyright (C) 2016 Accelerated Designs. All rights reserved
